KartikMehta-1/AMR-development/CAD/4 Boughtouts/screw-shield-v2-for-arduino-uno/Arduino UNO R3 screw shield v2/Arduino UNO R3 screw shield v2  Left.jpg

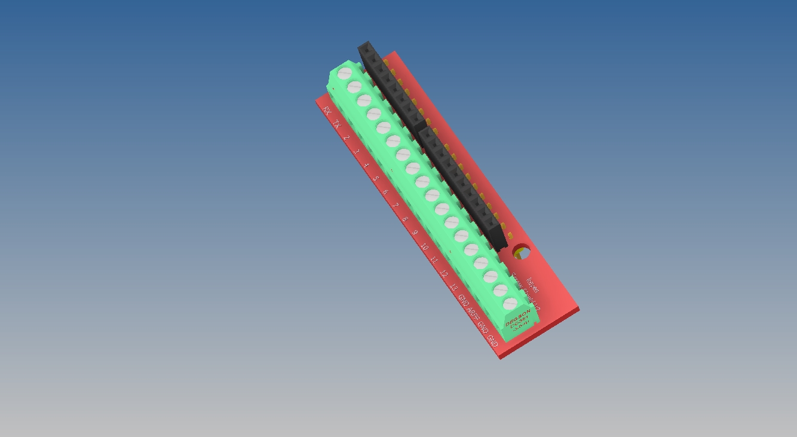
CAD/4 Boughtouts/screw-shield-v2-for-arduino-uno/Arduino UNO R3 screw shield v2/Arduino UNO R3 screw shield v2 Left.jpg
