KartikMehta-1/AMR-development/Folder_Structure.md

AMR-development/
- .vscode/                    # Local editor settings
- CAD/                        # Mechanical CAD assemblies, parts, exports
  - 1 Assembly/
  - 2 Sub-assembly/
  - 3 Parts/
  - 4 Boughtouts/
  - 5 3D_print/
  - 6 Exports/
  - OldVersions/
- PCB/                        # PCB design files
  - AMR_pcb/
- STM/                        # STM32CubeIDE firmware and bench projects
  - STM_Firmware_/            # Older STM firmware project
  - STM_Firmware_AMR_v2/      # Main AMR STM32 firmware project
  - STM_MotorCheck/           # Motor bench-test project
  - STM_SRM_CurrentBench/     # Current-sensor bench project
- Workspace/                  # Logged tuning, analysis artifacts, and ad-hoc experiments
  - motor_PID_tuning/
  - python_scripts/           # Local analysis and plotting scripts
  - sensor_test/              # Sensor experiments and wiring notes
- docker/                     # Docker setup for ROS/dev environments
  - foxy/
- docs/                       # Project documentation and trackers
  - README.md
  - architecture/             # Agent-owned architecture entry points and detailed diagrams
  - agentic/                  # Agent contracts, ownership, runbooks, permissions, roadmap
  - hardware/                 # Physical hardware block diagrams, wiring, component specs
  - perception/               # RGB-D, VLA, dataset, and proposal/execution boundaries
  - safety/                   # Safety baseline, supervisor steps, recovery procedures
  - project/                  # Project tracker and planning docs
- mcp_servers/                # MCP servers for agent/tool integration
  - amr_state_inspection/     # Read-only robot state/health inspection
  - amr_mission_control/      # Guarded named-place mission control
  - amr_robot_launch/         # Guarded standard runtime launch
  - amr_voice_interface/      # Transcript intent routing
  - amr_conversation/         # Conversation turn planner
  - amr_speaker/              # Spoken feedback publisher
  - amr_perception_inspection/ # Read-only RGB-D scene/object/grasp proposal MCP
- agent_harness/              # Source-only agent behavior and acceptance harness
- ros_ws/                     # ROS 2 workspace
  - src/
    - amr_clients/
    - amr_description/
    - amr_hardware/
    - amr_missions/
    - amr_missions_msgs/
    - amr_perception/
    - amr_safety/
    - amr_semantic_nav/
    - amr_voice/
    - my_pkg/
  - build/                    # Colcon build output
  - install/                  # Colcon install output
  - log/                      # Colcon logs
  - maps/                     # Saved SLAM maps
- .gitignore
- AMR_project.md.backup
- Folder_Structure.md
- docker-compose.slam.yml
- temp.txt
- useful commands.md
