KartikMehta-1/AMR-development/AMR_project.md

# Kartik's AMR Project Tracker (18 Weeks)
**File:** `AMR_project.md`  
**Owner:** Kartik Mehta  
**Last Updated:** 2025-11-04  
**Scope:** STM32 low-level control, Jetson Nano high-level compute, motor drivers, current sensing (ACS758 x2), FreeRTOS, ROS2 + Gazebo, SLAM & Navigation.

---

## Status Summary
- Overall: On track with tuning in progress
- Progress: 7/18 weeks complete (~39%)
- Recent: Single-motor bring-up on Cytron at ~10% duty verified (PA8 PWM, PB4 DIR)
- Current Focus (Week 9): Encoder integration; both encoders online, add external pull-ups
- Next Focus (Weeks 10-12): Current telemetry + calibration, single-loop PID, cascaded control + comparison
- Timeline: Flexible (plan extended beyond 18 weeks). Prioritize firmware + ROS; custom PCB is low priority/optional.
  - Firmware Branching: v1 (bench, L298N + small encoder) is now frozen; all new work proceeds in v2 (Cytron MDD20A + post-gearbox encoder).

Legend: Done, In Progress, Partial, Planned, Blocked

---

## Week-by-Week Plan (canonical view)
| Week | Focus | Status | Key Tasks / Notes |
|---:|---|:---:|---|
| 1 | Safety & Tools Setup | Done | E-stop path reviewed; fused power path; STM32 toolchain + Blink verified. |
| 2 | UART + Debug (ADC skipped) | Done | Serial comms working; pin mapping documented; ADC intentionally skipped at this stage. |
| 3 | PWM + Motor Driver (L298N) | Partial | PWM verified, motor spins; ramp duty + E-stop integration deferred to PID stage. |
| 4 | Encoder Hookup & Counting | Done | Encoder integrated; direction & count validated; stable RPM reading. |
| 5 | RPM Calculation & Telemetry | Done | RPM derived from ticks; serial telemetry logging functional. |
| 6 | PID-Based Motor Control (Implementation) | Done | PID loop on STM32; ramp limiter; anti-windup; clean control loop. |
| 7 | Firmware v2: Scaffold + Pin Map + Current | In Progress | New project `STM_Firmware_AMR_v2`; TIM1 @ 20 kHz (CH1=PA8 left, CH2=PA9 right); Encoders: TIM3 (PA6/PA7 left), TIM2 (PA0/PA1 right); ADC1 with DMA: PB0=IN8 (left current), PC1=IN11 (right current); UART banner. |
| 8 | Firmware v2: Dual-Motor Duty Bring-Up | Done | M2 PWM/DIR (PA9/PB5) wired; duty sweep validated both channels; E-stop cut and GND common confirmed. |
| 9 | Firmware v2: Encoder Integration | Done | Encoders online both wheels (TIM3 PA6/PA7 left, TIM2 PA0/PA1 right); UART RPM confirmed; direction corrected; pull-ups to be added. |
| 10 | Firmware v2: Current Telemetry + Calibration | Planned | ADC1 scan IN8 (PB0 left) and IN11 (PC1 right); zero-offset + scaling; UART current stream at 50-100 Hz. |
| 11 | Firmware v2: Control (Single-Loop PID) | Planned | Closed-loop speed PI/PID on one/both wheels; anti-windup + ramp; baseline plots and metrics. |
| 12 | Firmware v2: Cascaded Control + Comparison | Planned | Inner current PI + outer speed PID; add i_* and w_* telemetry; compare vs single-loop with plots/metrics. |
| 13 | Firmware v2: Differential Drive | Planned | Map (v, I%) + (left, right); saturation and ramp coordination; basic tests. |
| 14 | Firmware v2: Proximity Sensors (HW) | Planned | Select 8x proximity sensors (TBD interface: GPIO/ADC/I2C); wiring, pull-ups, protection; update pin map; bench power budget. |
| 15 | Firmware v2: Proximity Drivers | Planned | Implement drivers and sampling scheduler for 8 sensors; debouncing/filtering; fault detection; add to telemetry. |
| 16 | Firmware v2: micro-ROS Bring-up | Planned | Integrate micro-ROS on STM32; define msgs; publish wheel_state/obstacles; subscribe wheel_cmd/estop; stable transport to agent. |
| 17 | Jetson ROS2 + Agent + Docker | Planned | Set up micro-ROS agent and ROS2 workspace on Jetson; dockerize dev/runtime; compose services; basic end-to-end echo tests. |
| 18 | ROS2 Architecture & Topics | Planned | Define node graph, topics, QoS, message types; draft test plans (unit/integration/sim); document interfaces for motion, safety, sensors. |
| 19 | URDF Modeling | Planned | Base chassis + wheels URDF; inertia estimates; visual/collision meshes; joint limits; TF tree. |
| 20 | Gazebo Simulation | Planned | Diff-drive plugin tuning; sensor plugins for LiDAR/depth/proximity; sim-worlds; baseline nav in sim. |
| 21 | ROS2 Node Implementation | Planned | Implement nodes per architecture (odometry, safety_monitor, sensor_fusion, teleop); CI for lint/build/test. |
| 22 | System Tests & CI | Planned | Sim integration tests; logging/bagging; performance dashboards; dockerized CI pipeline. |
| 23 | Field Bring-up | Planned | On-robot tests: drive, stop, obstacle detection; telemetry review; safety validation. |
| 24 | Polish & Docs | Planned | User/developer docs; scripts; troubleshooting; backlog triage. |

> Canonical view rule: If the table and task board ever conflict, the table wins for schedule; task board wins for day-to-day details.

---

## Detailed Tasks
The granular task board has been moved to docs/AMR_firmware_tasks.md to keep this file focused on high-level goals and the weekly schedule.

Status: See the Status Summary above and task-by-task statuses in docs/AMR_firmware_tasks.md.

---

## Definitions of Done (per milestone)
- Dual-motor duty: Both channels drive 0-20% with correct direction and safe stop via E-stop
- Encoders: Stable RPM both wheels; correct direction; noise filtered
- Current telemetry: Calibrated A/LSB; filtered stream at 50-100 Hz
- Control (single-loop): <=10% overshoot, low SSE on step/ramp; plots archived
- Cascaded control: Inner current loop stable; outer speed loop SSE <= 5%, overshoot <= 10%; comparison plots and gains documented
- FreeRTOS (W13): Tasks meet deadlines under load; CPU < 70%; no missed watchdog
- Validation (W16): E-stop latency <= 50 ms; current-limit interaction stable under step loads
- SLAM demo (W18): Successful nav in mapped area for ~15 min without collision or watchdog resets

---

## Metrics
- Control quality: SSE, overshoot, rise/settling time (from logs)
- Reliability: E-stop latency, fault counts/day, watchdog resets
- Throughput: Control loop jitter, CPU utilization (RTOS)
- Power: Peak & average current draw, brownouts
- Delivery: Lead time per milestone, tasks closed/week

---

## Repo Structure (suggested)
```
/docs
  AMR_project.md               # this file
  pid.md                       # tuning notes & plots
  safety.md                    # E-stop, current limits, fault codes
  wiring/acs758_wiring.pdf     # diagrams & photos
/src
  motor.c, encoder.c, pid.c, telemetry.c, safety.c, ...
/scripts
  log_decode.py, plot_step.py

---

## ROS2 Architecture (Draft)
- Nodes
  - `mc_interface` (micro-ROS on STM32): subscribes `/amr/wheel_cmd`, `/amr/estop`; publishes `/amr/wheel_state`, `/amr/obstacles`
  - `odometry`: subscribes `/amr/wheel_state`; publishes `/odom`, `/tf`
  - `safety_monitor`: subscribes `/amr/obstacles`, `/amr/estop`; publishes `/amr/safety_state`
  - `sensor_fusion`: fuses proximity/LiDAR/depth; publishes `/amr/obstacles`
  - `teleop` or higher-level commander: publishes `/cmd_vel` or `/amr/wheel_cmd`
  - `sim_bridge`: interfaces Gazebo topics with AMR topics
- Topics (proposed)
  - `/amr/wheel_cmd` (geometry_msgs/Twist or custom wheel velocities)
  - `/amr/wheel_state` (sensor_msgs/JointState)
  - `/amr/obstacles` (sensor_msgs/Range[] or custom)
  - `/amr/estop` (std_msgs/Bool), `/amr/safety_state` (std_msgs/UInt32)
  - `/odom` (nav_msgs/Odometry), `/tf`, `/tf_static`

---

## Docker Development Environment (Draft)
- Images/containers
  - Firmware build: arm-none-eabi toolchain, micro-ROS build tools
  - Jetson runtime: ROS2 base, micro-ROS agent, AMR nodes
  - Desktop dev: ROS2, Gazebo, build/test tools
- Compose
  - `agent`, `ros-core`, `sim`, `tools` services; volumes for logs and bags
- CI integration
  - Build, lint, test stages; multi-arch where needed
```

---

## Issues & Backlog (triage labels)
- P0 block progress today
- P1 needed for this milestone
- P2 nice to have / future

```text
[P1] Plot script: generate step response graphs from CSV (rise time, overshoot, SSE)
[P1] Telemetry v2: add fault flags + setpoint
[P1] Mechanical CAD: full AMR layout (chassis, mounts, sensor brackets, harness routing); deliver STEP/DXF + assembly guide
[P2] CLI: live Bode-like sweep tool using chirp
```

---

## Risks & Mitigations
- Current spikes trip supply + Add soft-start/ramp; validate with current logs.
- Encoder noise at high RPM + Add digital filter/debounce; verify with scope.
- Thermal on motor driver + Heatsink & airflow in enclosure; current derating logic.
- RTOS timing regressions + Watchdog + scheduler tests; CI to replay step tests on logs.

---

## Decision Log (append entries)
```
YYYY-MM-DD - Switched to Cytron MD30C
Context: L298N thermal + dropout issues
Options: L298N, MD10C, MD30C
Decision: MD30C for current headroom
Consequences: Redesign mount; add airflow
```

---

## Change Log
- 2025-10-28: Marked Week 2 ADC as skipped; set Week 8 next focus to E-stop feature; added Final Drivetrain Migration step; noted flexible timeline and PCB as optional.
