KartikMehta-1/AMR-development/docs/ros_stack_diagrams.md

# ROS Stack Diagrams

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

## Source of truth

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

## Important note about the motion-command path

Older repo notes mention the STM32 subscribing directly to `/cmd_vel`.

The current real-hardware path in code is different:

- `teleop_twist_keyboard` and Nav2 publish to `/diff_drive_controller/cmd_vel_unstamped`
- `diff_drive_controller` converts base motion into left/right wheel velocity commands
- the `amr_hardware` `ros2_control` plugin publishes:
  - `/amr/wheel_cmd_left`
  - `/amr/wheel_cmd_right`
- the STM32 firmware subscribes to those two wheel-command topics

That is the path shown below.

## 1. Full Real-Hardware ROS Graph

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

```mermaid
flowchart LR
  subgraph Laptop_or_DevPC[Dev PC / Laptop]
    RVIZ[rviz2]
    TELEOP[teleop_twist_keyboard]
    SLAM[slam_toolbox]
    MAP_SERVER[map_server]
    AMCL[amcl]
    MISSIONS[mission_server]
    BT[bt_navigator]
    PLANNER[planner_server]
    CONTROLLER[controller_server]
    RECOVERIES[recoveries_server]
    GCM[global_costmap]
    LCM[local_costmap]
  end

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

  TELEOP -->|cmd_vel topic| DDC
  CONTROLLER -->|cmd_vel topic| DDC

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

  MCU -->|wheel state| AGENT
  MCU -->|safety and diagnostics| AGENT
  AGENT --> HW

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

  SLAM -->|map and map updates| RVIZ
  MAP_SERVER -->|map topic| RVIZ
  MAP_SERVER -->|map topic| AMCL
  MAP_SERVER -->|map topic| GCM
  AMCL -->|map tf| RVIZ
  RVIZ -->|initial pose| AMCL
  RVIZ -->|goal action| BT
  MISSIONS -->|navigate_to_pose action goals| BT
  BT --> PLANNER
  BT --> CONTROLLER
  BT --> RECOVERIES
  GCM -->|global map and obstacles| PLANNER
  LCM -->|local obstacles around robot| CONTROLLER
  RECOVERIES -->|recovery cmd_vel| DDC
```

## 2. Base Motion And Odometry Path

This is the control path you use first when teleoperating the AMR from the laptop.

```mermaid
flowchart TB
  subgraph Inputs[Command sources]
    TELEOP[teleop_twist_keyboard]
    NAV2[Nav2 controller and recoveries]
  end

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

  TELEOP -->|cmd_vel topic| DDC
  NAV2 -->|cmd_vel topic| DDC

  DDC -->|left and right wheel commands| HW
  HW -->|wheel command topics| AGENT
  AGENT --> MCU
  MCU --> MOTOR

  MOTOR -->|encoder-based wheel state| WSTATE
  WSTATE --> AGENT
  AGENT --> HW

  HW -->|wheel position and velocity| DDC
  HW -->|wheel position and velocity| JSB
  JSB -->|joint_states| RSP

  DDC -->|publishes| ODOM
  DDC -->|publishes| ODOMTF
  RSP -->|publishes| BODYTF
```

### What each piece does

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

## 3. TF Ownership

The most important thing to understand is who owns each transform.

```mermaid
flowchart TD
  MAP[map]
  ODOM[odom]
  BASE_FOOTPRINT[base_footprint]
  BASE_LINK[base_link]
  LIDAR_LINK[lidar_link]

  MAP -->|published by slam or amcl| ODOM
  ODOM -->|published by diff_drive_controller| BASE_FOOTPRINT
  BASE_FOOTPRINT -->|published by robot_state_publisher from URDF| BASE_LINK
  BASE_LINK -->|published by robot_state_publisher from URDF| LIDAR_LINK
```

### Consequence

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

This is why `slam_toolbox` and `AMCL` must not run together.

## 4. Mapping Mode With SLAM Toolbox

Use this mode when creating a map.

```mermaid
flowchart LR
  LIDAR[ydlidar_ros2_driver_node]
  DDC[diff_drive_controller]
  RSP[robot_state_publisher]
  SLAM[slam_toolbox]
  RVIZ[rviz2]
  SAVE[map_saver_cli]
  FILES[saved map files]

  LIDAR -->|scan topic| SLAM
  DDC -->|odom and tf| SLAM
  RSP -->|robot tf| SLAM

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

  SLAM -->|map topic| SAVE
  SAVE --> FILES
```

### SLAM Toolbox consumes

- `/scan`
- TF chain from `map` work backwards through:
  - `odom -> base_footprint`
  - `base_footprint -> ... -> lidar_link`

### SLAM Toolbox produces

- `/map`
- `/map_updates`
- `map -> odom` TF

### Mapping data flow

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

## 5. Localization And Navigation Mode

Use this mode after a map already exists on disk.

```mermaid
flowchart LR
  MAP_FILE[saved map on disk]
  MAP_SERVER[map_server]
  RVIZ[rviz2]
  AMCL[amcl]
    MISSIONS[mission_server]
  LIDAR[ydlidar_ros2_driver_node]
  DDC[diff_drive_controller]
  RSP[robot_state_publisher]
  BT[bt_navigator]
  PLANNER[planner_server]
  CONTROLLER[controller_server]
  GCM[global_costmap]
  LCM[local_costmap]
  DDCMD[cmd_vel topic to diff drive]

  MAP_FILE --> MAP_SERVER
  MAP_SERVER -->|map topic| RVIZ
  MAP_SERVER -->|map topic| AMCL
  MAP_SERVER -->|map topic| GCM

  RVIZ -->|initial pose| AMCL
  RVIZ -->|goal action| BT
  MISSIONS -->|navigate_to_pose action goals| BT

  LIDAR -->|scan topic| AMCL
  LIDAR -->|scan topic| GCM
  LIDAR -->|scan topic| LCM

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

  AMCL -->|map tf| RVIZ
  AMCL -->|map tf| BT
  AMCL -->|map tf| PLANNER
  AMCL -->|map tf| CONTROLLER

  BT -->|request path| PLANNER
  GCM -->|global map and obstacles| PLANNER
  BT -->|follow path request| CONTROLLER
  LCM -->|local obstacles| CONTROLLER
  CONTROLLER --> DDCMD
```

### What each Nav2 piece does

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

## 6. Mission Layer Over Nav2

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

```mermaid
flowchart LR
  YAML[places.yaml]
  CLI[mission_cli]
  SERVER[mission_server]
  STATUS[MissionStatus topic]
  STATE[GetMissionState service]
  CMD[command topic]
  NAV2[bt_navigator navigate_to_pose action]
  ROBOT[base navigation stack]

  YAML --> CLI
  YAML --> SERVER
  CLI -->|go_to or patrol services| SERVER
  CLI -->|state query| STATE
  STATE --> SERVER
  CMD --> SERVER
  SERVER -->|MissionStatus| STATUS
  SERVER -->|named goals and routes| NAV2
  NAV2 --> ROBOT
```

### Current mission-layer responsibilities

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

### Current named places

- `home`
- `door`
- `kitchen`
- `hall`

### Near-term direction

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

## 7. Nav2 Topic Remapping In This Repo

Nav2 normally expects:

- `/cmd_vel`
- `/odom`

This repo remaps them in launch so Nav2 works with the real base:

- `/cmd_vel` -> `/diff_drive_controller/cmd_vel_unstamped`
- `/odom` -> `/diff_drive_controller/odom`

That remap is done in:

- `ros_ws/src/amr_description/launch/bringup_nav2.launch.py`
- `ros_ws/src/amr_description/launch/nav2_navigation.launch.py`

## 8. Exhaustive Topic Ownership

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

### 8.1 Core base-control topics

| Topic | Produced by | Consumed by | Contents |
| --- | --- | --- | --- |
| `/diff_drive_controller/cmd_vel_unstamped` | `teleop_twist_keyboard`, Nav2 controller, Nav2 recoveries | `diff_drive_controller` | `geometry_msgs/Twist` with commanded base linear and angular velocity, mainly `linear.x` and `angular.z` for this differential-drive base |
| `/amr/wheel_cmd_left` | `amr_hardware` | STM32 firmware via `micro_ros_agent` | `std_msgs/Float32` containing commanded left wheel angular velocity in rad/s |
| `/amr/wheel_cmd_right` | `amr_hardware` | STM32 firmware via `micro_ros_agent` | `std_msgs/Float32` containing commanded right wheel angular velocity in rad/s |
| `/amr/wheel_state` | STM32 firmware via `micro_ros_agent` | `amr_hardware` | `sensor_msgs/JointState` with wheel joint names plus wheel position and velocity arrays for left and right wheels |
| `/joint_states` | `joint_state_broadcaster` | `robot_state_publisher`, RViz | `sensor_msgs/JointState` representing the joint-state view exposed by `ros2_control` for the robot model |
| `/diff_drive_controller/odom` | `diff_drive_controller` | `slam_toolbox`, `amcl`, Nav2, RViz | `nav_msgs/Odometry` with robot pose and twist in the odometry frame, derived from wheel feedback |

### 8.2 Safety, enable, and bench-diagnostics topics

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

| Topic | Produced by | Consumed by | Contents |
| --- | --- | --- | --- |
| `/amr/enable` | operator or helper topic publisher | STM32 firmware | `std_msgs/Bool` command indicating whether motion should be enabled |
| `/amr/estop` | operator or helper topic publisher | STM32 firmware | `std_msgs/Bool` command indicating software e-stop state |
| `/amr/clear_fault` | operator or helper topic publisher | STM32 firmware | `std_msgs/Empty` pulse used to request fault reset |
| `/amr/fault_mask` | STM32 firmware via `micro_ros_agent` | operator tools, diagnostics | `std_msgs/Int32` bitmask encoding active or latched faults such as overcurrent, stall, or encoder timeout |
| `/amr/safety_state` | STM32 firmware via `micro_ros_agent` | operator tools, diagnostics | `std_msgs/UInt32` state code summarizing enable, idle, fault, or e-stop related controller state |
| `/amr/duty_cmd_left` | STM32 firmware via `micro_ros_agent` | operator tools, diagnostics | `std_msgs/Float32` reporting applied left motor duty percentage |
| `/amr/duty_cmd_right` | STM32 firmware via `micro_ros_agent` | operator tools, diagnostics | `std_msgs/Float32` reporting applied right motor duty percentage |
| `/amr/current_left_ma` | STM32 firmware via `micro_ros_agent` | operator tools, diagnostics | `std_msgs/Int32` left motor current estimate in milliamps |
| `/amr/current_right_ma` | STM32 firmware via `micro_ros_agent` | operator tools, diagnostics | `std_msgs/Int32` right motor current estimate in milliamps |
| `/amr/current_left_adc` | STM32 firmware via `micro_ros_agent` | operator tools, diagnostics | `std_msgs/UInt32` raw ADC sample for the left current sensor |
| `/amr/current_right_adc` | STM32 firmware via `micro_ros_agent` | operator tools, diagnostics | `std_msgs/UInt32` raw ADC sample for the right current sensor |
| `/amr/current_left_zero` | STM32 firmware via `micro_ros_agent` | operator tools, diagnostics | `std_msgs/UInt32` stored or estimated zero-offset value for the left current sensor |
| `/amr/current_right_zero` | STM32 firmware via `micro_ros_agent` | operator tools, diagnostics | `std_msgs/UInt32` stored or estimated zero-offset value for the right current sensor |

### 8.3 Perception and mapping topics

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

### 8.4 RViz interaction topics

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

### 8.5 Navigation-support topics explicitly configured in this repo

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

### 8.6 Transform topics

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

### 8.7 Named transforms carried on `/tf` or `/tf_static`

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

### 8.8 Optional topics not expanded in detail here

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

## 9. What `/tf`, `/tf_static`, `map -> odom`, and `odom -> base_footprint` Mean

### `/tf`

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

In this repo, the most important transforms on `/tf` are:

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

### `/tf_static`

`/tf_static` carries transforms that do not change during operation.

In this repo, `robot_state_publisher` uses the URDF to publish fixed geometry such as:

- `base_footprint -> base_link`
- `base_link -> lidar_link`
- `base_link -> camera_link`
- other rigid chassis and sensor-link relationships

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

### `map -> odom`

`map -> odom` is the global correction transform.

Why it exists:

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

Ownership in this repo:

- during mapping, `slam_toolbox` publishes `map -> odom`
- during localization/navigation, `amcl` publishes `map -> odom`

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

### `odom -> base_footprint`

`odom -> base_footprint` is the local motion estimate of the robot from wheel odometry.

In this repo:

- `diff_drive_controller` computes it from wheel feedback coming from `/amr/wheel_state`
- it publishes both the transform and the odometry message on `/diff_drive_controller/odom`

Properties of this transform:

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

### Why there are two levels instead of one

The frame chain is:

- `map -> odom -> base_footprint -> base_link -> lidar_link`

Each part has a different job:

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

This split is very important because Nav2 and SLAM want both:

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

### Practical mental model

If the robot moves 1 meter forward:

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

## 9. Where Topics Are Generated In Practice

### Jetson-side bring-up

Started by `hardware.launch.py`:

- `micro_ros_agent`
- YDLidar driver
- `robot_state_publisher`
- `ros2_control_node`
- `joint_state_broadcaster`
- `diff_drive_controller`

### STM32-side micro-ROS topics

Current firmware publishes:

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

Current firmware subscribes to:

- `/amr/wheel_cmd_left`
- `/amr/wheel_cmd_right`
- `/amr/enable`
- `/amr/estop`
- `/amr/clear_fault`

## 10. Mental Model

The stack is easiest to understand in layers:

1. Sensors and MCU produce raw robot state:
   - `/scan`
   - `/amr/wheel_state`
   - safety and current topics
2. `ros2_control` turns wheel state into robot motion interfaces:
   - accepts base velocity commands
   - computes odometry
   - publishes `/diff_drive_controller/odom`
3. TF makes the robot spatially coherent:
   - `odom -> base_footprint` from diff-drive
   - body and sensor frames from `robot_state_publisher`
4. Mapping or localization adds global pose:
   - `slam_toolbox` during mapping
   - `amcl` during localization
5. Nav2 closes the loop:
   - plan on `/map`
   - avoid obstacles from `/scan`
   - output base motion back into `diff_drive_controller`

## 11. One-line summary

For this repo, the practical closed loop is:

`teleop or Nav2 -> /diff_drive_controller/cmd_vel_unstamped -> diff_drive_controller -> amr_hardware -> /amr/wheel_cmd_left/right -> STM32 -> /amr/wheel_state -> amr_hardware -> diff_drive_controller -> /diff_drive_controller/odom -> SLAM or AMCL -> map-aware RViz/Nav2`
