KartikMehta-1/AMR-development/docs/project/AMR_project.md

# Kartik's AMR Project Tracker (49 Weeks)
**File:** `AMR_project.md`  
**Owner:** Kartik Mehta  
**Last Updated:** 2026-07-07
**Scope:** STM32 low-level control, Jetson Nano/Orin NX high-level compute, motor drivers, current sensing (ACS758 x2), FreeRTOS, ROS2 + Gazebo, SLAM & Navigation; eventual goal is a fully autonomous AMR with one mounted SO-101 manipulator that can pick/place small objects using state-of-the-art VLA/VLM/LLM-based policies.

## Week-by-Week Plan (canonical view)
| Week | Focus | Status | Key Tasks / Notes | Target Date | Achieved Date |
|---:|---|:---:|---|---|---|
| 1 | Safety & Tools Setup | <span style="color: green">Done</span> | E-stop path reviewed; fused power path; STM32 toolchain + Blink verified. | 2025-10-23 | 2025-10-17 |
| 2 | UART + Debug (ADC skipped) | <span style="color: green">Done</span> | Serial comms working; pin mapping documented; ADC intentionally skipped at this stage. | 2025-10-30 | 2025-10-18 |
| 3 | PWM + Motor Driver (L298N) | <span style="color: green">Done</span> | PWM verified, motor spins; ramp duty + e-stop integration completed in v2. | 2025-11-13 | 2025-10-18 |
| 4 | Encoder Hookup & Counting | <span style="color: green">Done</span> | Encoder integrated; direction & count validated; stable RPM reading. | 2025-11-27 | 2025-10-22 |
| 5 | RPM Calculation & Telemetry | <span style="color: green">Done</span> | RPM derived from ticks; serial telemetry logging functional. | 2025-12-04 | 2025-10-22 |
| 6 | PID-Based Motor Control (Implementation) | <span style="color: green">Done</span> | PID loop on STM32; ramp limiter; anti-windup; clean control loop. | 2025-12-11 | 2025-10-23 |
| 7 | Firmware v2: Scaffold + Pin Map + Current | <span style="color: green">Done</span> | New project `STM_Firmware_AMR_v2`; TIM1 @ 20 kHz (CH1=PA8 left, CH2=PA9 right); Encoders: TIM3 (PA6/PA7 left), TIM2 (PA0/PA1 right); ADC1 with DMA: PB0=IN8 (left current), PC1=IN11 (right current); UART banner. | 2025-12-18 | 2025-10-30 |
| 8 | Firmware v2: Dual-Motor Duty Bring-Up | <span style="color: green">Done</span> | M2 PWM/DIR (PA9/PB5) wired; duty sweep validated both channels; E-stop cut and GND common confirmed. | 2025-12-25 | 2025-11-03 |
| 9 | Firmware v2: Encoder Integration | <span style="color: green">Done</span> | Encoders online both wheels (TIM3 PA6/PA7 left, TIM2 PA0/PA1 right); UART RPM confirmed; direction corrected; TODO: add external 3.3 V pull-ups or software invert flag. | 2026-01-01 | 2025-11-16 |
| 10 | Firmware v2: Current Telemetry + Calibration | <span style="color: green">Done</span> | ADC1 scan IN8/IN11; zero-offset + scaling; filtered current stream; current reserved for logging/faults (not in loop). | 2026-01-08 | 2025-11-25 |
| 11 | Firmware v2: Control (Single-Loop PID) | <span style="color: green">Done</span> | TIM4 @100 Hz control loop; cmd_vel staleness timeout; speed PI + duty ramp; fault monitor (overcurrent/stall/encoder timeout/ADC stuck); hardware e-stop GPIO input + debounce wired into ControlState (latched fault); step/ramp plots captured during bring-up; gains/feedforward tuned. | 2026-01-15 | 2025-12-07 |
| 12 | Firmware v2: Differential Drive | <span style="color: green">Done</span> | Map (v, I%) -> wheel RPM; ramp/coordination added; saturation with curvature-preserving scaling; basic 5 s test sequence running. | 2026-01-29 | 2025-12-09 |
| 13 | Firmware v2: micro-ROS Bring-up | <span style="color: green">Done</span> | USART2 custom transport; `/amr_stm/wheel_cmd_left` and `/amr_stm/wheel_cmd_right` subs; `/amr_stm/wheel_state`, duty, current, ADC/zero, fault, safety, and `/amr_stm/ros_diag` pubs; `/amr_stm/enable`, `/amr_stm/estop`, `/amr_stm/clear_fault` wired; fault clear verified; fault mask documented; legacy UART telemetry disabled. | 2026-02-19 | 2026-01-04 |
| 14 | Dev PC Env & Tooling | <span style="color: green">Done</span> | Dockerized Foxy drivers + devpc image built (micro-ROS agent + YDLidar + RViz2/Gazebo); RViz2 config for `/scan` (best_effort QoS) working; ROS2 workspace build verified; Docker buildx workflow and Jetson builds validated; passwordless SSH to Jetson set up. | 2026-03-05 | 2026-01-18 |
| 15 | Jetson Nano ROS2/JetPack | <span style="color: green">Done</span> | Jetson container build complete; micro-ROS agent + teleop + YDLidar running; `/amr_stm/*` and `/scan` verified; depth camera running with `/camera/*` and `/points` validated; RViz2 visualization from dev PC confirmed; DDS interface bound to Wi-Fi; depth stream stabilized with lower profiles. | 2026-03-12 | 2026-01-24 |
| 16 | Wireless PC<->Nano | <span style="color: green">Done</span> | Wi-Fi adapter online and Jetson reachable over home network; passwordless SSH working; DHCP reservation set; ping avg ~10 ms and iperf ~15 Mbps verified; NTP sync active. Optional VPN (WireGuard/Tailscale) remains a nice-to-have. | 2026-03-19 | 2026-01-20 |
| 17 | URDF Modeling (Base AMR) | <span style="color: green">Done</span> | Base URDF/Xacro created with chassis, wheels, and sensor frames (LiDAR + depth cam); LiDAR/camera split into `lidar.xacro` + `camera.xacro`; D455 camera plugin added; base_footprint restored; wheel offsets corrected; caster clearance tuned; Gazebo launch defaults to `obstacles.world`; ros2_control config added; URDF validated in sim. | 2026-03-26 | 2026-02-11 |
| 18 | Navigation & Mapping Bring-up | <span style="color: green">Done</span> | Mapping: slam_toolbox (2D LiDAR) running on real LiDAR; map save/load + posegraph serialization verified. Localization: AMCL on saved map working. Navigation: Nav2 bring-up working with RViz goals; costmaps wired to ros2_control topics. EKF fusion + odom improvements are tracked separately. | 2026-04-02 | 2026-02-11 |
| 19 | Mechanical Integration: SO-101 Arms | <span style="color: green">Done</span> | Assembled SO-101 hardware and verified reach/clearance. Current AMR direction is one mounted SO-101 arm with power budget/fusing, harness routing, and strain relief tracked for that single-arm configuration. | 2026-05-07 | 2026-02-08 |
| 20 | Mechanical Assembly + Enclosure | <span style="color: green">Done</span> | Main AMR mechanical assembly completed, including SO-101 integration provisions. Follow-on hardware refinements now move into manipulation/perception work: wrist camera mount on SO-101, AMR depth sensor repositioning for better gripping, and any final cable routing/strain relief cleanup. | 2026-02-26 | 2026-04-17 |
| 21 | Mission Runtime & Sequencing (v1) | <span style="color: green">Done</span> | Promoted `amr_missions` from CLI-only use into a persistent `mission_server` with typed `MissionStatus`, a `/amr_missions/state` service, topic-command support, request validation, retries/timeouts/return-home handling, and direct integration into the one-shot navigation tmux workflow. | 2026-04-16 | 2026-04-28 |
| 22 | Firmware v2: Cascaded Control + Comparison | <span style="color: green">Done</span> | Cascaded-current-control investigation is complete for this AMR phase. Higher-accuracy current-sensor integration was brought up for protection/diagnostics, ROS current + ADC/zero topics were added, current polarity/sign were corrected, and the OC threshold was returned to `1500 mA`. Decision: keep production motion on the validated single-loop speed controller for now; use current sensing for protection/logging and revisit true cascaded current control only if traction or torque-control requirements justify it. | 2026-01-22 | 2026-05-03 |
| 23 | Safety Supervision & Health Monitoring | <span style="color: green">Done</span> | Implemented and validated the first production safety-supervision layer: STM comm/fault monitoring, safety intervention state, mission/Nav2 cancel path, guarded zero-velocity + STM disable flow, supervisor reset service, and repeatable operator recovery helper. Real motor-driver power-cut tests confirmed safe stop, blocked reset while STM faults were active, fault clear after power restore, manual STM re-enable, and successful mission continuation. Follow-up safety expansions can be tracked separately. | 2026-04-23 | 2026-05-03 |
| 24 | AMR Rewire + Known-Good Bring-Up | <span style="color: green">Done</span> | Rewired and brought the AMR back up on the Nano/Foxy baseline. Validated STM micro-ROS, `/amr_stm/*`, LiDAR `/scan`, wheel state/odom path, map/AMCL readiness, Nav2 lifecycle, mission server, safety supervisor, MCP launch path, and supervised named-place navigation. Defer STM-carrier proximity sensors, STM I2C IMU, and INA226 wiring until a custom carrier/control board; continue reliability cleanup through acceptance testing. | 2026-05-14 | 2026-05-23 |
| 25 | Agentic AMR Control Revalidation On Nano | <span style="color: green">Done</span> | Revalidated the guarded agentic control path on the existing Nano/Foxy baseline: robot-launch MCP restarted Jetson/dev-PC runtime, mission-control MCP readiness passed, and supervised `go_to hall` completed successfully through `/amr_missions/go_to` with STM fault mask clear. Live motion remains supervised and must use mission/safety/Nav2 paths, never raw `/cmd_vel` or direct wheel commands. | 2026-05-21 | 2026-05-23 |
| 26 | NUC Dev-PC Migration Baseline | <span style="color: green">Done</span> | NUC is validated as the live dev-PC replacement while Jetson Nano remains the hardware runtime: Docker/image/build checks passed, split NUC+Jetson bring-up works, the one-command navigation launcher works on tmux 3.4, and supervised mission-control runs succeeded for `hall`, `kitchen`, and `home` with STM fault mask clear. Extended repeatability/acceptance loops are intentionally deferred to the later hardware acceptance/reliability track. | 2026-05-30 | 2026-06-01 |
| 27 | Voice + Operator Command MVP | <span style="color: goldenrod">In Progress</span> | MCP-oriented voice/operator path is active: `hey jarvis` wake gating, Vosk command ASR and Faster Whisper push-to-talk support, Piper TTS through speaker MCP, conversation MCP planning, Qwen-backed local intent routing, pending confirmation handling, and read-only state-inspection tool execution for status/diagnostics. Regular Week-27 voice/operator work resumes after the immediate Orin runtime bring-up tasks. Motion remains gated through mission-control MCP readiness and explicit supervised confirmation. | 2026-04-30 | TBD |
| 28 | Manipulation Perception + Calibration | <span style="color: goldenrod">In Progress</span> | Use AMR-mounted depth camera for broad scene/object discovery and wrist camera for close-range grasp refinement. Low-bandwidth Orin-to-NUC preview topics are active for D455 color/depth and SO-101 wrist camera; raw/high-resolution streams should stay local to Orin for autonomy/training unless explicitly needed. Complete hand-eye calibration, base-to-arm extrinsics, camera-to-tool frames, AprilTag checks, RGB-D logging, and stale-frame rejection before grasp execution. | 2026-07-09 | TBD |
| 29 | Orin NX AMR Runtime Migration | <span style="color: goldenrod">In Progress</span> | Pulled forward as the pre-Week-27 focus while keeping NUC+Nano/Foxy as the validated fallback. Orin Docker profile created under `docker/orin`; image `amr/ros2-humble-orin:arm64` builds on Orin with ROS 2 Humble, Nav2, ros2_control, micro-ROS Agent, YDLidar driver, RealSense ROS driver, librealsense `2.57.7` using RSUSB, MoveIt2, `usb_cam`, and the Feetech Python dependency. AMR `ros_ws` builds inside the Orin Humble image after porting `amr_hardware` to Humble `ros2_control` lifecycle callbacks and updating controller-manager spawners; added `ydlidar_orin.yaml` and `orin_hardware.launch.py` for stable by-id paths. Supervised Orin bring-up has run LiDAR `/scan`, STM micro-ROS with `stm_link_ok`, active base controllers, `/amr/joint_states`, NUC RViz/dashboard/teleop over CycloneDDS, D455 low-bandwidth preview topics, and SO-101 wrist webcam preview. A tiny suspended Nav2 CLI goal reached the STM wheel-command path and completed; do not use suspended testing for localization quality because wheel odom moves while the room scan does not. RealSense raw streams should stay local to Orin unless explicitly needed; Wi-Fi viewing should use preview topics. Current checkpoint: keep mounted Orin power/USB/cooling stable, resume supervised floor hardware acceptance, and keep NUC+Nano/Foxy as fallback until Orin passes acceptance. | 2026-06-06 | TBD |
| 30 | Agentic AMR Operation Baseline On Orin | Planned | Port the revalidated agentic baseline to the Orin path after core devices and ROS contracts work there: skills, harnesses, shared ROS clients, state-inspection MCP, guarded mission-control MCP, guarded robot-launch MCP, and voice/conversation/speaker MCPs. Add software-only fixture tests for MCP/clients and harden confirmation-required command tools for `go_to_named_place`, `cancel_mission`, and supervised launch without bypassing mission/safety/Nav2. | 2026-06-13 | TBD |
| 31 | Supervised AMR Hardware Acceptance On Orin | Planned | Use the hardware acceptance harness on the real AMR with Orin as the target runtime once device bring-up is ready: idle, post-motion, localization readiness, mission success, safety recovery, fault decode, and repeated named-place routes. Compare against the known NUC+Nano/Foxy baseline and produce reports before enabling command MCPs for regular operation. | 2026-06-20 | TBD |
| 32 | Local LLM + Monitoring On Orin | Planned | Run a small local orchestration LLM and monitoring stack on Orin for operator dialogue, tool selection, status explanation, system health, and MCP calls. Keep deterministic parser paths for known commands. Enforce skills, permissions, confirmation, and AMR MCP safety gates before any motion-causing tool call. | 2026-06-27 | TBD |
| 33 | IMU + EKF State Estimation & Nav Validation | Planned | STM-carrier IMU wiring is deferred until a custom carrier/control board makes the sensor bus cleaner. If odometry improvement is needed before then, evaluate a Jetson-connected IMU or RealSense IMU as the candidate `/imu` source. Validate topic rate, timestamps, frame ID, orientation/gyro stability, covariance, mounting, and Docker/device access before enabling `robot_localization`. Then fuse wheel odom + IMU, define filtered-odom TF ownership, retest SLAM, AMCL, and Nav2, and include follow-up for motion-only AMCL/localization jumps seen during 2026-05-03 mission validation. | 2026-04-09 | TBD |
| 34 | URDF/MoveIt For Base + SO-101 | <span style="color: goldenrod">In Progress</span> | Single mounted SO-101 scaffold is active: optional AMR Xacro integration, upstream SO101 URDF/STL import, AMR mount wrapper, wrist-camera TF frames, MoveIt2 config, and encoder-captured named poses (`home`, `carry`, `look_from_height`, `ready_to_pick_up`). Next: measure mount offsets, calibrate wrist-camera extrinsics, and calibrate physical joint limits because some recorded safe poses exceed the starter URDF/MoveIt limits. | 2026-06-25 | TBD |
| 35 | Arm Control Bring-Up With MoveIt | <span style="color: goldenrod">In Progress</span> | `amr_so101_driver` now runs on Orin: `/so101_trajectory_bridge` serves `/so101_arm_controller/follow_joint_trajectory`, publishes `/so101/joint_states`, exposes `/so101/free_servos`, and `/amr_joint_state_merger` combines `/amr/joint_states` plus `/so101/joint_states` into `/joint_states`. Supervised MoveIt/teleop has moved wrist roll and then all six available SO-101 joints. Default real execution remains conservative; all-six execution requires explicit supervised bring-up until joint limits, torque margins, and calibration are finished. | 2026-07-02 | TBD |
| 36 | Classical Grasp Pipeline With MoveIt | Planned | Build the first measurable manipulation pipeline: perception -> object/grasp proposal -> MoveIt reachability/collision planning -> guarded execution -> retreat/recovery -> wrist-camera verification. Use this as the baseline before VLA/VLM action policies. | 2026-07-16 | TBD |
| 37 | Base + Arm Integration Demo | Planned | Navigate to a named pickup pose, align to workspace, run classical grasp, place at drop zone, report status, and recover from failed grasp or navigation errors. Maintain consistent base/arm/camera transforms and safety watchdogs. | 2026-07-23 | TBD |
| 38 | External MCP Integrations For Home Autonomy | Planned | Integrate useful non-motion MCPs with the Orin LLM agent: Home Assistant for home state/devices, system monitoring for Orin health, calendar/tasks/reminders, and recipe/meal-planning or shopping-list MCPs. Keep robot motion behind AMR-owned MCP safety tools only. | 2026-07-30 | TBD |
| 39 | AMR Perception MCPs + Household Inspection | Planned | Add custom AMR perception MCP tools for camera inspection workflows such as workspace/fridge/counter scan, object list proposals, stale-frame checks, and operator confirmation. Connect outputs to recipe/task/home MCPs where useful, but do not let perception directly command actuators. | 2026-08-06 | TBD |
| 40 | VLM/VLA Trials For Manipulation | Planned | Profile VLM/VLA models on Orin and/or external GPU fallback. Use them for object discovery, grasp/action proposals, and scene inspection while MoveIt and guarded controllers remain responsible for planning/execution. Compare against the classical grasp baseline. | 2026-08-13 | TBD |
| 41 | Agentic Home Autonomy Demo | Planned | Demonstrate an agentic workflow that combines AMR operation, LLM orchestration, MCP integrations, and guarded manipulation: inspect a scene, suggest an action or meal/task, schedule/remind through calendar/task MCPs, optionally navigate or manipulate through AMR-owned safety-gated MCP tools, and log all decisions/confirmations. | 2026-08-20 | TBD |
| 42 | Productization Scope Freeze | Planned | Freeze one product-like showcase workflow: fixed-place indoor delivery/navigation with human load/unload. Define what is in scope, what is explicitly out of scope, known limitations, demo route, operator workflow, and acceptance criteria. Do not add broad autonomy features unless they improve this workflow. | 2026-08-27 | TBD |
| 43 | Repo Productization Baseline | Planned | Add top-level `README.md`, `Makefile`, `.env.example`, structured docs index, and cleanup plan for generated artifacts/placeholders. Convert `useful commands.md` into documented one-command workflows. Separate dev, ops, diagnostics, calibration, and hardware-acceptance scripts. Add the agentic robotics documentation baseline: agent roles, tool permissions, MCP wrapper plan, repo-local skills plan, and interaction examples. | 2026-09-03 | TBD |
| 44 | Automated Test Foundation | Planned | Add unit tests for `amr_voice` parser, mission config loading, mission request validation, and safety-supervisor health evaluation. Add `colcon test` workflow locally. Start with software-only tests that do not need hardware. Add the first agent harness scenarios for unsafe motion refusal, localization-not-ready denial, safety-fault denial, and manipulator plan-before-execute behavior. | 2026-09-10 | TBD |
| 45 | CI/CD Foundation | Planned | Add GitHub Actions or equivalent CI that runs formatting/lint checks, Python unit tests, ROS package build, and selected launch/config smoke checks on every PR/branch. CI should block regressions before hardware testing; CD remains limited to tagged Docker/image/release artifacts until deployment is safer. | 2026-09-17 | TBD |
| 46 | Hardware Acceptance & Reliability Report | Planned | Turn baseline probes into a repeatable hardware acceptance suite: idle, motion, post-motion, localization readiness, fault decode, safety recovery, and mission success criteria. Run 20+ repeated delivery/navigation missions and summarize success rate, faults, localization jumps, recovery time, and known limitations. | 2026-09-24 | TBD |
| 47 | Custom Carrier PCB Development | Planned | Design and validate the custom carrier/control-board path before adding extra STM-side sensors: connectorized STM/driver/sensor wiring, clean 5 V/3.3 V distribution, I2C routing, level shifting/protection, grounds, test points, fusing, and harness labels. Start with a carrier/backplane around the current Nucleo/Cytron/buck architecture before considering deeper motor-driver or MCU integration. | TBD | TBD |
| 48 | Post-PCB Proximity + Battery Level Integration | Planned | After the custom carrier/control board exists, integrate proximity sensors and INA226-style pack telemetry cleanly: proximity trigger/echo routing and filtering, shared I2C battery monitor wiring, external shunt placement after the main fuse and before branch distribution, STM firmware drivers, `/amr_stm/*` telemetry topics, docs, harness contracts, and acceptance checks. | TBD | TBD |
| 49 | Product-Grade Demo Package | Planned | Produce a polished productization case study: operator demo, deployment guide, safety case, acceptance-test report, architecture diagram, BOM/cost estimate, release tag, and demo video. Present the AMR as a product-grade indoor delivery platform showcase, not a general-purpose robot claim. | 2026-10-01 | TBD |

> Canonical view rule: If the table and task board ever conflict, the table wins for schedule; task board wins for day-to-day details.

---

## Status Summary
- Overall: SLAM + localization + navigation pipeline is working on real hardware (slam_toolbox map -> saved map -> AMCL -> Nav2 goals). The current validated live fallback remains NUC-as-dev-PC plus Jetson Nano-as-hardware-runtime on ROS 2 Foxy: the NUC runs `amr_devpc`, RViz/Nav2/mission/safety/agent tooling; the Jetson runs `amr_foxy`, micro-ROS, LiDAR, ros2_control, and STM link watchdog. The Orin NX/Humble migration path now has Docker, hardware launch, NUC RViz/dashboard/teleop helpers, LiDAR, STM, controllers, RViz goal delivery, camera previews, SO-101 MoveIt bridge execution, and a suspended Nav2 command-path smoke test. SO-101 integration and an initial ACT manipulation demo are validated; low-level control/odometry calibration is still in active tuning.
- Progress: 26/49 weeks complete (~53%). NUC migration is closed as a baseline milestone; extended repeatability tests are deferred to the later hardware acceptance/reliability track. The active near-term focus has moved from Orin software bring-up to supervised integration cleanup: keep the mounted Orin running with stable power/USB/cooling, validate floor operation, and calibrate SO-101 joint limits and camera extrinsics before grasp execution.
- Recent:
  - Validated the NUC as the live dev-PC replacement for the existing split runtime. Docker, amd64 AMR images, software-only `colcon build/test`, map artifacts, Jetson SSH aliases, UDP/DDS firewall rules, and NUC-to-Jetson reduced source sync are in place.
  - Completed supervised NUC+Jetson mission validation on `my_new_map`: `go_to hall`, then `go_to kitchen`, then `go_to home` all succeeded through guarded mission-control and `mission_server`. Safety stayed monitor-only/healthy, STM `fault_mask` stayed `0`, comm stayed `stm_link_ok`, and odom returned to zero after arrival.
  - Fixed and validated the NUC one-command launcher path: `open_amr_devpc_navigation.sh` now uses tmux 3.4-compatible pane sizing, creates `amr_devpc_nav`, starts Jetson `amr_foxy`, resets STM, brings up Nav2/RViz/mission/safety panes, and passes guarded dry-run mission readiness after initial pose.
  - Validated the AMR MCP surface for future OpenClaw integration: source compile, agent harness checks, host-safe MCP smoke tests, ROS-attached state/mission MCP smoke tests inside `amr_devpc`, launch preflight, live read-only inspection, and mission-control dry-run readiness all passed without sending motion.
  - Reflashed `STM_Firmware_AMR_v2`, restored STM32 micro-ROS connectivity, and revalidated live `/amr_stm/*` topics on the Jetson bring-up path.
  - Completed the AMR rewire/known-good bring-up loop on the Nano/Foxy runtime: MCP robot launch restarted the Jetson hardware stack and dev-PC Nav2 session with `my_new_map`, STM reset over ST-LINK completed, `/scan` and `/amr_stm/wheel_state` were live, AMCL/Nav2 lifecycle readiness passed after initial pose, and mission services were responsive.
  - Revalidated the supervised agentic mission path end-to-end: MCP mission-control readiness passed for `hall`, `go_to_named_place("hall")` started through `/amr_missions/go_to`, the robot reached `hall`, both wheel encoder paths responded during motion, and STM `fault_mask` stayed `0`.
  - Added a launcher hardening option to run the MCP/dev-PC navigation stack with RViz disabled (`AMR_START_RVIZ=false`, MCP `start_rviz=false`) after RViz load was observed to make lifecycle service readiness flaky.
  - Debugged the recent hardware bring-up faults: left-stall evidence pointed to wiring/encoder-response issues during earlier tests, a wiring issue was corrected, and a transient right current-sensor rail/OC fault was identified as a sensor wiring/calibration follow-up rather than a Nav2/MCP command-path issue.
  - Re-checked wheel encoders on live `/amr_stm/wheel_state`, corrected left/right motor-channel wiring, and fixed wheel direction polarity so individual left/right wheel commands now actuate the intended side.
  - Added ROS current topics (`/amr_stm/current_left_ma`, `/amr_stm/current_right_ma`) plus raw ADC/zero topics for bench bring-up and calibration of the replacement current sensors.
  - Completed current-sensor integration bring-up: current sign/polarity was corrected, idle offset reduced to a small near-zero bias, load current now rises in the expected direction on both sides, and current settles back near zero when the wheels stop.
  - Restored the overcurrent threshold to `1500 mA` after calibration and confirmed the firmware-side current path is now usable for protection testing.
  - Added a one-command Jetson bench monitor workflow for wheel state, duty, current, safety state, and fault tracking during bring-up.
  - slam_toolbox bring-up working with real LiDAR (`/scan` -> `/map`) and RViz config saved.
  - Saved a real map and validated map_server + AMCL localization; Nav2 navigation (planner/controller) working with RViz goal tool.
  - Added a Nav2 wrapper launch + params to remap `/cmd_vel` + `/odom` to ros2_control diff-drive topics and to launch RViz reliably inside Docker.
  - Added one-shot dev-PC workflows for SLAM and navigation that first bring up the Jetson hardware stack and then reset the STM over ST-LINK using `openocd` on the Jetson.
  - Validated noninteractive STM reset from the Jetson with `sudo -n openocd -s /usr/share/openocd/scripts -f interface/stlink-v2-1.cfg -f target/stm32f4x.cfg -c "init; reset run; shutdown"`.
  - Fixed RViz map display QoS (Transient Local + Reliable) and added Nav2 UI tools/panel to `amr.rviz`.
  - Marked Week 21 (URDF base) and Week 22 (mapping/localization/navigation bring-up) complete; EKF fusion is tracked as a separate improvement.
  - Resolved TF bring-up issues by ensuring ros2_control/controller_manager + `/joint_states` are alive before SLAM.
  - LiDAR alignment parameterized in URDF (yaw adjust) and rebuilt into runtime container workflow.
  - Encoder pipeline validated on bench (manual rotations), moved to higher-resolution timer mode (TI12), and began closing the loop on wheel kinematics (track width / wheel separation) using 360-degree tests.
  - Added firmware tuning profiles for controlled A/B testing (launch guard, feedforward/static FF, etc.) to avoid “many knobs at once”.
  - Promoted `amr_missions` into a persistent mission runtime with `mission_server`, typed `MissionStatus`, `/amr_missions/state`, and a command topic; the one-shot navigation launcher now includes mission-server, mission-status, and mission-command panes.
  - Revalidated named-place navigation and patrol flows on real hardware with the persistent mission runtime; current saved places are `home`, `door`, `kitchen`, and `hall`.
  - Hardened the mission/Nav2 command path so mission CLI calls use unique ROS node names, wait only for the required service, and time out cleanly instead of hanging; `go_to kitchen` was revalidated through the mission server on real hardware.
  - Completed the real motor-driver power-cut safety recovery validation without restarting the safety supervisor; reset is rejected while STM fault bits are active, succeeds after fault clear, and STM re-enable remains manual.
  - Added a guarded operator recovery helper (`scripts/amr_safety_recover.py`) so the validated safety recovery sequence can be run repeatably without manually typing every ROS command.
  - Integrated SO-101 into the active project stack and completed the main AMR mechanical assembly.
  - Ran an ACT policy that successfully picked up an object and placed it into a bag.
- micro-ROS: STM32 bring-up on USART2 with full AMR topic set live (wheel_state + duty topics visible); UART telemetry disabled to avoid contention.
- Safety: Hardware e-stop GPIO integrated with debounce and fault latch.
- Current Focus (next sprint):
  - Keep the Jetson Orin NX mounted/powered on the AMR with stable cable routing, cooling, USB devices, and repeatable restart behavior.
  - Continue Orin floor bring-up only under supervision, with the validated NUC+Nano/Foxy path kept intact as fallback.
  - Keep the validated NUC+Nano/Foxy path intact as the fallback; do not silently replace `docker/foxy`, Nano launch assumptions, or the known-good mission workflow.
  - Use the Orin-specific Docker/runtime profile (`docker/orin`, image `amr/ros2-humble-orin:arm64`) as the Humble/JetPack 6 base; keep the Orin workspace synchronized from the NUC before rebuilds.
  - Bring up Orin hardware incrementally after power loss: USB/device IDs, STM32 micro-ROS, `/amr_stm/*` topics, LiDAR `/scan`, RealSense preview streams, wrist webcam preview, SO-101 serial path, GPU/container runtime, thermals, network, and device permissions. Initial bench/suspended checks passed; the next meaningful validation is floor hardware acceptance and manipulation calibration.
  - Port or shim Foxy-to-Humble differences, especially `ros2_control`, `controller_manager`, launch files, Nav2 parameters, and micro-ROS agent compatibility.
  - Prefer the validated one-command NUC launch over manual container bringup for fallback operations; keep the manual flow only as a debugging fallback.
  - Keep the current hardware work limited to reliability cleanup: cable strain relief, current-sensor wiring/calibration checks, USB/power stability, and sensor mounting that supports the existing base. Defer STM-carrier proximity sensors, STM I2C IMU, and INA226 battery monitor wiring until a custom carrier/control board.
  - Harden the MCP launch/mission workflow around the validated NUC path: use mission-control readiness as the motion gate, preserve explicit supervised confirmation, and add fixture/software tests for the MCP clients.
  - Keep live agentic motion supervised and routed through mission/safety/Nav2 only. Do not use raw `/cmd_vel`, direct wheel commands, fault clear, STM re-enable, or launch changes without explicit supervised confirmation.
  - Defer broad repeatability loops until the hardware acceptance/reliability track; use only targeted checks needed to prove each Orin interface during bring-up.
  - Treat IMU/EKF as optional after bring-up. If needed before the custom board, evaluate a Jetson-connected IMU or RealSense IMU source, validate `/imu` quality first, and only then configure `robot_localization`.
- Productization Direction:
  - Use this AMR as a productization case study: show how a prototype robotics workbench becomes a repeatable, testable, operator-friendly indoor delivery/navigation platform.
  - Product-grade does not mean certified or mass-manufactured yet. For this project phase it means: one-command build/run paths, clean documentation, automated tests, CI, explicit safety behavior, repeatable hardware acceptance, operator-facing workflow, release tags, and known limitations.
  - Keep the productized showcase narrow: fixed-place indoor delivery/navigation with human load/unload. Manipulation, VLA/VLM autonomy, custom PCB, and general-purpose robot behavior stay as longer-term R&D unless a validated workflow demands them.
- Agentic Tooling Direction:
  - Treat MCP servers, skills, subagents, and harnesses as an operator/developer interface above the existing ROS and firmware stack, not as a replacement control system.
  - Current baseline now includes agent contracts, permission rules, codebase ownership, repo-local skills, source-only harness checks, harness CI, shared ROS clients, a read-only AMR state MCP server, and an agentic behavior diagram.
  - Use nine working agents for current routing: test runner, code review, STM firmware, ROS core/hardware interface, navigation/mission/safety, manipulator/MoveIt, perception/calibration, voice/operator interface, and runtime environment.
  - Continue with read-only and diagnostic capabilities first: robot health, safety state, mission state, named places, localization status, logs, and fault summaries.
  - Add motion-causing tools only after software-only fixtures, command preconditions, safety prechecks, explicit confirmation, audit logging, and supervised hardware acceptance procedures are in place.
  - On Orin, run a small local LLM for orchestration/tool selection and keep VLM/VLA workloads on demand for perception/manipulation proposals. External MCPs such as Home Assistant, system monitoring, calendar/tasks, reminders, and recipe/meal planning may provide context or non-motion actions, but robot motion must remain behind AMR-owned MCP safety tools.
  - Keep agent tools intent-level (`go_to_named_place`, `cancel_mission`, `plan_arm_named_pose`) and block raw motor/PWM/unguarded joint-control pathways.
- Control Architecture Direction:
  - Yes, moving toward cascaded control makes sense: inner current/torque limiting (or current loop if feasible) + outer speed loop is the standard industrial structure and will reduce slip/launch transients once current sensing is reliable.
- Next Focus:
  - Continue Orin NX AMR runtime migration on the mounted/powered robot while keeping NUC+Nano/Foxy as the known-good fallback until Orin passes hardware acceptance.
  - Agentic AMR operation hardening on the Orin-capable base through voice/text/LLM -> skill -> MCP -> shared ROS client -> mission/safety/Nav2.
  - MoveIt-first manipulator bring-up after the AMR base is stable. Current first slice now includes the upstream-backed single SO-101 URDF/TF scaffold, wrist-webcam frame, MoveIt2 config, conservative `amr_so101_driver` trajectory bridge, all-six supervised teleop, free-servo service, and encoder-captured named poses. Next manipulator action is physical joint-limit calibration before trusting home/carry/look/pick poses in MoveIt.
  - Orin LLM/MCP integrations after the Orin AMR runtime and safety boundaries are proven.
  - Supervised repeatability and hardware acceptance on Orin, with comparison against the known-good NUC+Nano/Foxy split.
- Timeline: Flexible (now a 49-week plan with extensions). Prioritize Orin runtime migration first while preserving the NUC+Nano/Foxy fallback, supervised hardware acceptance second, MoveIt manipulation third, and broader Orin-based autonomous integrations after the core robot is reliable. Custom PCB is now the preferred place to integrate proximity sensors, STM-side IMU, and INA226 battery monitoring cleanly.

## Calendar Baseline (Week Alignment)
- Week 1 start: 2025-10-17.
- Paused weeks (approx): 2025-11-03 to 2025-11-09 and 2025-11-17 to 2025-11-23.
- Plan weeks are working weeks; paused weeks extend the calendar timeline by ~2 weeks. Update these dates if the break windows were different.
  - Firmware Branching: v1 (bench, L298N + small encoder) is now frozen; all new work proceeds in v2 (Cytron MDD20A + post-gearbox encoder).

Legend: <span style="color: green">Done</span>, <span style="color: goldenrod">In Progress</span>, Partial, Planned, Blocked

---

## Productization Track

The AMR will be used as a productization showcase, not only an R&D platform. The objective is to demonstrate the engineering discipline needed to turn a working robot into something another engineer/operator can build, test, run, debug, and evaluate.

### Productization Goal

Productize one narrow scenario first:

```text
Indoor fixed-place delivery/navigation robot:
- map a known indoor environment
- define named places
- send the robot to a selected place
- human loads/unloads payload
- robot reports status and returns home
- logs mission result
- exposes clear safety/recovery behavior
```

This avoids claiming a general-purpose robot too early while still producing a strong product-grade demo.

### What Product-Grade Means For This Repo

- Clear top-level `README.md`: current capability, hardware assumptions, build/run/test instructions, known limitations.
- One-command workflows: `make build`, `make test`, `make nav`, `make safety-baseline`, `make hardware-check` or equivalent scripts.
- Automated software tests for deterministic logic: voice parser, mission config loading, mission validation, safety health-state logic.
- CI checks on every branch/PR: build, tests, lint/static checks, package metadata, and smoke checks that do not require hardware.
- Hardware acceptance suite: repeatable idle/motion/post-motion probes, mission success criteria, safety recovery checks, and saved reports.
- Agent-facing interface discipline: documented agent roles, project skills, MCP tool permission levels, structured outputs, and harness scenarios for unsafe requests.
- Deployment docs: Jetson/dev-PC setup, map creation, place calibration, startup, shutdown, log collection, recovery.
- Safety case: hazards, mitigations, current limitations, operator responsibilities, and what is not certified.
- Release discipline: tag stable demo states, record test results, keep generated logs/build artifacts out of source.

### Agentic Tooling Track

Detailed task breakdown: `docs/agentic/agentic_robotics_roadmap.md`.

This track introduces MCP servers, subagent roles, repo-local skills, shared ROS clients, and agent harnesses as structured tooling around the AMR. The first milestone is now a working documentation and read-only diagnostics baseline. Motion-causing tools must remain behind explicit confirmation, safety-state checks, localization checks, audit logging, fixture-backed tests, and supervised hardware acceptance.

Implemented baseline:

- Defined nine agent roles, including the runtime environment agent for Docker, Jetson Nano, and Orin NX work.
- Added repo-local skills for test running, code review, STM firmware, ROS core/hardware, navigation/mission/safety, runtime environment, voice, perception, manipulator bring-up, navigation debug, mission runtime, safety recovery, and hardware acceptance.
- Added `agent_harness` source-only checks and GitHub CI for harness validation.
- Added shared `amr_clients` ROS client helpers so CLI, voice, and MCP paths do not duplicate mission or safety logic.
- Added the read-only `mcp_servers/amr_state_inspection` server for robot health, safety state, mission state, named places, localization, STM diagnostics, and navigation state.
- Added `docs/agentic/agentic_behavior_diagram.md` to show how users, agents, skills, harnesses, MCPs, shared ROS clients, and the robot runtime fit together.

Next work:

- Add software-only functional validation for skills, shared ROS clients, and MCP behavior without requiring a physical AMR.
- Add fake-ROS or fixture-backed MCP integration tests so read-only MCP behavior can be checked in CI.
- Add confirmation-required command MCP tools only after guardrails are documented and tested: go to named place, cancel mission, recovery checks, and later approved arm plans.
- Add supervised hardware acceptance for the AMR base before treating command MCPs as a regular operating path.
- Bring up Orin as the near-term AMR runtime and later on-robot LLM/MCP runtime: separate Docker profile, system monitoring, local small LLM orchestrator, explicit Foxy/Nano vs Humble/Orin separation, and hardware acceptance before Orin becomes the primary driving computer.
- Integrate external MCPs only after the AMR-owned safety boundary is clear. First candidates: Home Assistant for home state, system monitoring for Orin health, calendar/task/reminder MCPs, and recipe/meal-planning MCPs. These should provide context or non-motion actions; AMR motion stays behind AMR-owned MCP tools.
- Keep subagent workflow PR-based: domain agent performs bounded change, Test Runner Agent validates, Code Review Agent reviews, then merge through PR.
- Expand supervised hardware acceptance reports only when the physical AMR is available and the operator explicitly requests a hardware run.

### Productization Guardrails

- Do not add new autonomy features unless they strengthen the fixed-place delivery/navigation showcase.
- Keep any second-arm or dual-arm manipulation as a future capability until navigation, safety, logging, and the single-arm workflow are repeatable.
- Treat every recurring manual command as a candidate for a script, Make target, or documented operator procedure.
- Treat every hardware validation as a future acceptance test with pass/fail criteria.
- Document limitations honestly. Known limitations increase credibility when they are measured and bounded.

## CI/CD Notes

CI/CD means Continuous Integration and Continuous Delivery/Deployment.

### Continuous Integration

CI is the habit of checking every code change automatically before it reaches the main working branch. In this AMR project, CI should answer:

```text
Did this change break the ROS workspace build?
Did parser/mission/safety logic still pass tests?
Are launch/config files still valid enough for smoke checks?
Did package metadata or dependencies regress?
```

CI is needed because robotics systems have many layers: firmware, ROS packages, launch files, YAML configs, Docker images, scripts, maps, and hardware assumptions. A small change to a topic name, QoS profile, service timeout, or YAML key can silently break a real robot. CI catches the software-side mistakes before risking hardware time.

Initial CI for this repo should be software-only:

1. Checkout the repo.
2. Install/build the ROS dependencies or use the existing Docker image.
3. Run `colcon build`.
4. Run `colcon test`.
5. Run Python unit tests for deterministic packages.
6. Run lightweight lint/static checks.
7. Optionally run launch/config smoke checks that do not require Jetson, STM32, LiDAR, or motors.

Hardware-in-the-loop tests come later because they require the physical robot and operator supervision.

### Continuous Delivery

CD means producing a repeatable release artifact after CI passes. For this AMR, early CD should mean:

- tagged Docker images for dev-PC/Jetson runtimes
- versioned release notes
- packaged config profiles
- saved acceptance-test reports
- release tags such as `v0.1.0-navigation-demo` or `v0.2.0-productized-delivery-demo`

This is safer than automatic deployment. The robot should not auto-update and run on hardware just because code was pushed.

### Continuous Deployment

Continuous Deployment is when passing changes are automatically deployed to production. For this AMR, that should be avoided until the platform has strong rollback, remote supervision, safety gates, and field maturity. Physical robots can damage hardware or create safety risks, so deployment should stay manual and deliberate for now.

### CI/CD Roadmap For AMR

- Phase 1: Add local tests and `make test`.
- Phase 2: Add CI for unit tests and `colcon build`.
- Phase 3: Add launch/config smoke checks.
- Phase 4: Add Docker image build checks.
- Phase 5: Add tagged release artifacts and release notes.
- Phase 6: Add hardware acceptance reports, still manually triggered.
- Phase 7: Consider supervised deployment/update flow only after rollback and safety procedures are mature.

---

## PCB Migration Milestones (dev boards -> integrated AMR control PCB)

PCB migration remains a later optional productization track. It should not block the immediate AMR base reliability, agentic operation, MoveIt manipulation, or Orin MCP/LLM integration work unless wiring reliability or repeatability becomes the limiting factor.

- Conceptual architecture (target end-state): Define final board contents (STM32/bare MCU or SOM, dual motor stage, buck rails 12->5->3.3 V, encoder conditioning, current sense, battery protection, all IO connectors, CAN/UART/RS485/I2C). This is the "Cytron + Nucleo + buck + encoder + UART + IO" rolled into one.
- Phase A - Measure on dev boards: With Nucleo + Cytron + XL4016, capture real currents (continuous/peak), encoder voltage tolerance/noise, UART/CAN bandwidth, EMI/ground noise patterns, ADC resolution needs, harness lengths and connector types. This produces the electrical requirements doc.
- Phase B - Consolidation carrier PCB: Keep Nucleo + Cytron + external buck, but design a carrier/backplane that handles connectors, power distribution, current sensing, ferrite/filter caps, and ground planes to organize wiring and validate signal/power integrity.
- Phase C - Integrate motor driver: Drop Cytron; design your own dual H-bridge with gate driver (e.g., DRV87xx) + MOSFETs + shunts/Hall sensors. Validate thermals, switching, protection (TVS/fuse/reverse), and EMC.
- Phase D - Integrate MCU: Replace Nucleo with bare STM32F401 (LQFP-64): crystal, boot config, SWD header, decoupling, ESD/TVS, brownout protection. Port firmware; bring-up clocks, debug, boot, and motor control.
- Phase E - Production/EMC-ready: Move to 4-layer, split/stitched grounds, Kelvin sensing, star grounds, TVS + common-mode chokes, reverse/fuse protection, panelization notes, silks/labels, test points. Run pre-scan EMC/ESD and pilot build (5-10 boards) with harnesses and acceptance tests.
---

## Architecture Docs
- ROS stack diagrams: `docs/architecture/ros_stack_diagrams.md`
- STM32 firmware architecture: `docs/architecture/STM_architecture.md`
- Jetson Nano runtime architecture: `docs/architecture/jetson_architecture.md`
- Agentic behavior diagram: `docs/agentic/agentic_behavior_diagram.md`
- Agentic robotics roadmap: `docs/agentic/agentic_robotics_roadmap.md`
- Agent tool permissions: `docs/agentic/agent_tool_permissions.md`
- Agent interaction examples: `docs/agentic/agent_interaction_examples.md`
- Initial agent role contracts: `docs/agentic/roles/`

---

## Project Log
- 2026-07-07: Updated the Orin/SO-101 checkpoint after live AMR operation. The Orin AMR hardware container is the current Humble bring-up path with LiDAR, STM micro-ROS, controllers, `/amr/joint_states`, D455 low-bandwidth preview topics, and the SO-101 wrist webcam preview available to the NUC over CycloneDDS. Raw/high-resolution camera topics stay local to Orin unless explicitly needed.
- 2026-07-07: Validated the SO-101 MoveIt bridge far beyond the original wrist-roll-only slice under explicit supervision. The bridge now supports `/so101_arm_controller/follow_joint_trajectory`, `/so101/joint_states`, `/so101/free_servos`, merged global `/joint_states`, all-six joint teleop helpers, named-pose helpers, and encoder-captured `home`/`carry`, `look_from_height`, and `ready_to_pick_up` poses. Remaining blocker is physical joint-limit calibration: recorded safe poses expose starter URDF/MoveIt limit mismatches, so limits must be measured and updated with margins before autonomous grasp execution.
- 2026-06-08: Updated the persistent `the-amr-guy` context, manipulator architecture, ROS topic ownership, and project tracker for the SO-101 MoveIt bridge. Current arm topic contract is `/amr/joint_states` for base wheels, `/so101/joint_states` for the arm, merged `/joint_states` for RViz/MoveIt, and `/so101_arm_controller/follow_joint_trajectory` for MoveIt execution. The driver defaults to fake hardware and real execution remains wrist-roll-only until Orin validation and shoulder/elbow characterization are complete.
- 2026-06-08: Added the first source-level SO-101 MoveIt execution bridge in `amr_so101_driver` with a conservative `FollowJointTrajectory` action server, Feetech STS3215 serial backend, fake hardware mode, wrist-roll-only execution gate, and joint-state merger for AMR base + arm compatibility. Local Python syntax checks passed; full `colcon build` and supervised hardware validation are pending until the Orin is powered again.
- 2026-06-04: Added the revised Jetson Orin NX enclosure print as an explicit mechanical-integration backlog item. The current enclosure design was insufficient, so the next Orin action is to print one more revised enclosure, install it, power the Orin from the AMR, and only then resume supervised floor bring-up/hardware acceptance.
- 2026-06-02: Started the single mounted SO-101 manipulator stack. Vendored the upstream TheRobotStudio/SO-ARM100 SO101 URDFs, Apache-2.0 attribution, and 13 STL assets; added a prefixed Xacro wrapper with AMR top-plate mount guess, `so101_tool0`, and wrist-webcam frames. Added a view launch file and planning-only starter named poses. The scaffold is for RViz/MoveIt bring-up only; no arm driver, gripper actuation, trajectory controller, or hardware execution path is enabled.
- 2026-06-01: Closed Week 26 as the NUC dev-PC migration baseline. The validated NUC+Nano/Foxy split remains the fallback, while extended route repeatability loops are deferred to the later hardware acceptance/reliability track. Pulled Jetson Orin NX runtime migration forward as the immediate pre-Week-27 focus: create a separate Orin/JetPack 6 runtime profile, likely ROS 2 Humble, build the ROS stack there, validate STM32 micro-ROS/LiDAR/RealSense/GPU/USB/network/device access incrementally, and only promote Orin after supervised hardware acceptance.
- 2026-06-01: Advanced the Orin NX/Humble migration to a paused bench-ready checkpoint. Added the Orin Docker runtime, NUC RViz image, CycloneDDS peer setup, UDP check, Orin hardware launch, YDLidar Orin config, NUC dashboard, NUC RViz launcher, and Orin teleop helper. Verified the Orin hardware container with LiDAR, STM micro-ROS, ros2_control, joint states, wheel state, RViz map/scan/model visualization, Nav2 lifecycle, and RViz goal action clients. A tiny supervised suspended Nav2 goal reached the STM wheel-command path and completed; suspended localization behavior is not meaningful because odom changes without room-relative scan motion. RealSense color is usable in RViz, while depth remains diagnostic-only due USB/control-transfer and Right MIPI warnings. Next action is mechanical/electrical, not software: print/install the Orin enclosure, power it from the AMR, then resume supervised floor acceptance.
- 2026-05-30: Validated the AMR MCP surface ahead of OpenClaw integration. Host-safe MCP smoke tests passed for conversation, perception inspection, robot launch, speaker, and voice interface. ROS-attached smoke tests passed inside `amr_devpc` for state inspection and mission control. Live read-only checks passed for robot health, safety, localization, navigation, mission state, named places, and STM diagnostics; guarded mission-control dry-run readiness for `hall` passed; robot-launch preflight/dry-run passed for `my_new_map`. Captured the checkpoint in `docs/agentic/mcp_validation_2026-05-30.md`.
- 2026-05-30: Extended the NUC live validation with a supervised two-leg route. Guarded readiness passed for `kitchen` and `home`; with operator supervision confirmed, `go_to kitchen` succeeded with `reached 'kitchen'`, then a fresh readiness check passed and `go_to home` succeeded with `reached 'home'`. Safety remained monitor-only/healthy, STM `fault_mask` stayed `0`, comm stayed `stm_link_ok`, and odom returned to zero after arrival.
- 2026-05-30: Fixed and validated the NUC one-command navigation launcher. The NUC host uses tmux 3.4, where `split-window -p <percent>` fails with `size missing`; updated `scripts/open_amr_devpc_navigation.sh` to use `split-window -l <percent>%`. Non-attaching one-command launch now creates `amr_devpc_nav`, starts Jetson `amr_foxy`, resets STM, starts NUC `amr_devpc`, brings up Nav2/RViz/mission/safety panes, accepts the known `home` initial pose, and passes guarded dry-run readiness for `hall` with STM `fault_mask=0`.
- 2026-05-30: Validated the NUC as a live dev-PC replacement against the Jetson Nano hardware runtime. After a clean split relaunch, `my_new_map` loaded, RViz initial pose was accepted, AMCL/Nav2 readiness passed, mission/safety services were healthy, and the guarded mission-control readiness check for `hall` had no blockers. With explicit supervised operator confirmation, `go_to hall` was sent through `mission_server` and succeeded with final detail `reached 'hall'`; STM `fault_mask` stayed `0`, comm stayed `stm_link_ok`, safety stayed monitor-only/healthy, and odom returned to zero. Manual container bringup was the initial validated fallback before the tmux launcher compatibility fix.
- 2026-05-30: Cloned `KartikMehta-1/AMR-development` onto a NUC-class Ubuntu 24.04 x86_64 host at `/home/ubuntu/agent/repos/AMR-development` and captured the migration context in `docs/agentic/nuc_migration_context.md`. Docker Engine 29.1.3, Compose 2.40.3, and Buildx 0.30.1 were installed and `docker run --rm hello-world` passed from the operator's interactive shell. The current validated robot workflow remains the Nano/Foxy split until the NUC path is validated. Treat the NUC first as a dev-PC replacement, then separately evaluate whether it should become the on-robot computer with a dedicated hardware-facing runtime profile.
- 2026-05-23: Completed the Nano/Foxy AMR rewire and agentic control revalidation milestone. The robot was relaunched through the MCP robot-launch server on `my_new_map`, mission-control MCP readiness passed, and supervised `go_to hall` succeeded through the mission server with both wheel encoder paths responding and STM `fault_mask=0`. Added the RViz-disabled launch option (`AMR_START_RVIZ=false`, MCP `start_rviz=false`) after RViz load was observed to make Nav2 lifecycle service readiness flaky. Next focus is repeatability/hardware acceptance, current-sensor wiring/calibration follow-up, and then Orin migration.
- 2026-05-23: Sorted the canonical week table by status so completed work appears first, active work follows, and planned work appears in intended execution order. Moved proximity sensing and INA226 battery-level integration behind custom carrier/control PCB development, combining the old immediate proximity hardware/driver slots into a post-PCB integration task.
- 2026-05-23: Reprioritized the near-term plan after deciding not to force proximity sensors, STM-side IMU, or INA226 onto the current STM carrier wiring. These sensors are deferred to a future custom carrier/control board unless a simple Jetson-connected IMU is needed for odometry experiments. Immediate focus is now to rewire the AMR back to the known-good base configuration, bring up the existing Nano/Foxy stack, revalidate the agentic control path on that baseline, and then proceed with Orin NX runtime migration.
- 2026-05-10: Reworked the weekly roadmap to include the new agentic-AI robot development sequence discussed over the last two days. The near-term order is now AMR base completion, proximity/IMU/sensor-fusion reliability, agentic AMR operation through skills/MCP/shared ROS clients, supervised hardware acceptance, Orin runtime and local LLM orchestration, MoveIt-first manipulator bring-up, and then external MCP integrations such as Home Assistant, system monitoring, calendar/tasks/reminders, and recipe/meal planning.
- 2026-05-10: Adjusted the roadmap to move Jetson Orin NX into the near-term AMR driving path. Orin runtime migration now happens before regular command MCP operation: build a separate Orin/Humble container profile, validate hardware devices and ROS contracts against the existing Nano/Foxy baseline, then run supervised AMR hardware acceptance on Orin before making it the primary robot computer.
- 2026-05-10: Added battery monitoring to the near-term AMR base hardware tasks. Planned hardware path is INA226 over STM I2C `PB8/PB9` with an external 50 A minimum, preferably 75/100 A, shunt placed after the main fuse and before branch power distribution. IMU and INA226 share the planned STM I2C bus; firmware/CubeMX changes are still required. Proximity pins are proposed-final but still require CubeMX/header verification. The voltage display remains display-only, and the battery 5-pin JST-XH connector remains unassigned until pinout is verified.
- 2026-05-10: Updated the agentic implementation sequence to reflect the current baseline: agent contracts, ownership, skills, harness, harness CI, shared ROS clients, read-only AMR state MCP, and agentic behavior diagram are now implemented baseline items. The next agentic focus is software-only functional validation, fixture-backed MCP tests, and only then confirmation-required command MCP tools.
- 2026-05-09: Marked `docs/project/AMR_firmware_tasks.tmp` obsolete and removed its stale legacy references to missing planning docs. The canonical firmware/project status now lives in `docs/project/AMR_project.md`, `docs/architecture/STM_architecture.md`, `docs/hardware/pin_map.yaml`, and the current firmware source.
- 2026-05-09: Created the first two repo-local agent skills: `.codex/skills/amr-code-review/SKILL.md` and `.codex/skills/amr-test-runner/SKILL.md`. These skills reference the detailed role contracts and provide practical workflows, safe command boundaries, subsystem selection guidance, and standardized output formats for review and validation work.
- 2026-05-09: Refined the agent role structure from a compressed starter set into eight target agents: test runner, code review, STM firmware, ROS core/hardware interface, navigation/mission/safety, manipulator/MoveIt, perception/calibration, and voice/operator interface. Added contracts for the new split while keeping manipulator, perception, and voice contracts intentionally lighter until those subsystems mature.
- 2026-05-09: Started Phase 1 of the agentic robotics plan by adding the first agent permission model, interaction examples, and role contracts for the test runner, code review, ROS/mission/safety, and STM firmware agents. These documents define allowed commands, blocked commands, required checks, done criteria, failure modes, and escalation rules before skills or MCP tools are implemented.
- 2026-05-09: Added an agentic robotics roadmap for using MCP servers, subagent roles, repo-local skills, and harness scenarios as a structured operator/developer interface above the existing ROS 2, Nav2, MoveIt2, micro-ROS, and STM32 control stack. Updated the productization roadmap to include agent tool permissions, read-only-first MCP diagnostics, confirmation-required motion tools, engineering agents for test/review/code generation across STM firmware, ROS 2, voice, and perception, and safety-focused harness scenarios.
- 2026-05-04: Added a productization track to the canonical AMR roadmap. The AMR will be treated as a productization case study for a narrow fixed-place indoor delivery/navigation workflow, with repo maturity milestones for README/Makefile cleanup, automated tests, CI/CD foundation, hardware acceptance, reliability reporting, safety case, deployment docs, and a product-grade demo package. Added CI/CD notes explaining why CI is needed for robotics, how it should start as software-only checks, and why automatic deployment to physical robots should remain manual/supervised until rollback and safety procedures are mature.
- 2026-05-03: Hardened the Voice Command MVP for no-speaker operation. Voice motion commands now refuse to proceed until `map -> odom` localization is available, `/amr_voice/feedback` publishes operator-facing text for future TTS, and `scripts/open_amr_voice_asr.sh` launches laptop-mic ASR with the correct workspace setup.
- 2026-05-03: Started Voice Command MVP Step 3. Added `voice_asr_node`, a laptop-microphone Vosk ASR node that publishes `/amr_voice/transcript` and `/amr_voice/partial_transcript`, supports device listing and dry-run mode, and feeds final transcripts through the existing wake-gated mission command handler.
- 2026-05-03: Started Voice Command MVP Step 4. Motion commands now require an explicit `yes` confirmation before calling mission services, while `stop` / `cancel` still bypass confirmation so safety stops are never blocked. Added rejection handling with `no` / `cancel that` and documented the ASR confirmation flow.
- 2026-05-03: Completed Voice Command MVP Step 2 in typed-text form. The voice command node now supports wake-gated operation: `lovely` opens a short listening window, commands with the wake word execute immediately, and stop/cancel remains accepted without the wake word. The one-shot navigation tmux workflow now starts the voice pane with wake gating enabled.
- 2026-05-03: Started Voice Command MVP Step 1. Added the `amr_voice` ROS package with a deterministic text-command parser and `voice_text_cli` / `voice_command_node` entry points. Supported typed intents now include go-to-place (`home`, `door`, `kitchen`, `hall`), stop/cancel, status, and list-places; the package builds in `amr_devpc` and dry-run parsing was validated.
- 2026-05-03: Marked Week 25 Safety Supervision & Health Monitoring complete after the merged safety-supervision branch and validated motor-driver power-cut recovery flow. Remaining safety improvements should be tracked as follow-up tasks rather than keeping the baseline safety layer open.
- 2026-05-03: Reprioritized the weekly plan after safety-supervision merge. Cascaded PID/current-loop work is marked complete for this phase with production motion staying on the validated single-loop speed controller; proximity sensors are returned to planned status; voice-command control is now the active branch and current sprint, split into text parsing, "lovely" wake-word flow, laptop ASR, confirmations, Jetson speaker feedback, full loop, and robustness guards.
- 2026-05-03: Completed Safety Step 10: repeated the real motor-driver power-cut fault while moving, confirmed STM latched `STALL_LEFT|STALL_RIGHT` (`fault_mask=24`) with comms healthy, verified `/amr/safety_supervisor/reset_intervention` rejects while unsafe, restored motor-driver power, cleared STM faults, reset the supervisor without restarting it, manually re-enabled STM, and finished with a passing 30 second baseline probe.
- 2026-05-03: Added guarded safety recovery tooling. `scripts/amr_safety_recover.py` cancels mission/Nav2 motion, publishes zero velocity, disables STM, decodes live STM/comm/supervisor state, prompts before clearing nonzero STM faults, calls `/amr/safety_supervisor/reset_intervention`, and keeps STM re-enable as an explicit operator step unless requested with `--reenable`. Dry-run validation passed on healthy hardware.
- 2026-05-03: Hardened the mission/Nav2 command path after CLI calls intermittently hung or failed service discovery. `mission_cli` now uses a unique ROS node name per invocation, waits only for the service required by the requested command, and bounds service-response waits. `mission_server` now clears stale action goal handles on idle cancel requests. Rebuilt/restarted the mission server and validated `status`, `cancel`, and `go_to kitchen` on real hardware. Follow-up: improve localization/AMCL behavior because mission validation still showed large AMCL pose steps during motion while low-level comms and safety remained healthy.
- 2026-04-27: Updated the canonical roadmap to split near-term work and post-Orin work more cleanly. Short-term milestones are now EKF state estimation, persistent mission runtime, safety supervision, and voice I/O scaffolding. Perception-heavy autonomy and manipulator runtime migration are explicitly deferred to the Jetson Orin NX phase.
- 2026-04-27: Added one-shot dev-PC workflows for SLAM and navigation that first bring up the Jetson hardware stack, then reset the STM over ST-LINK via `openocd`, then launch the desktop-side session. Validated noninteractive reset with `sudo -n openocd -s /usr/share/openocd/scripts -f interface/stlink-v2-1.cfg -f target/stm32f4x.cfg -c "init; reset run; shutdown"`.
- 2026-04-27: Added `amr_missions`, a first mission-layer ROS 2 package with YAML-defined named places and a `mission_cli` supporting `list`, `go_to <place>`, and `patrol ... --return-home ...`. Validated named-place navigation on real hardware for `kitchen` and `hall`; current saved places are `home`, `door`, `kitchen`, and `hall`.
- 2026-04-28: Promoted `amr_missions` into a persistent dev-PC-side mission runtime: added `mission_server`, typed `MissionStatus` publishing on `/amr_missions/status`, a `/amr_missions/state` service, topic-command control, stricter request validation, and mission-server/status/command panes in the one-shot navigation tmux workflow. Patrol was revalidated before merge.
- 2026-04-22: Closed the current-sensor integration bring-up loop for bench use: added raw ADC/zero ROS topics and a one-command Jetson monitor, corrected current polarity/sign, brought idle offsets down near zero on both sides, restored the overcurrent threshold to `1500 mA`, and shifted next-focus planning toward Jetson-side odometry fusion/slip detection.
- 2026-04-19: Reflashed `STM_Firmware_AMR_v2`; recovered micro-ROS bring-up; revalidated encoder feedback and individual left/right wheel control; added ROS current topics; corrected wheel direction polarity; flipped right current polarity and temporarily raised the OC threshold for current-sensor calibration bring-up; noted remaining idle-zero drift on the replacement current sensor.
- 2026-04-17: Marked Week 17 mechanical assembly complete; noted SO-101 integration, successful ACT pick-and-place-into-bag demo, and next focus on wrist camera mounting + AMR depth sensor repositioning.
- 2026-04-17: Shifted immediate manipulation focus to sensor placement for grasping. Decisions: mount a wrist/gripper camera on SO-101, refine the AMR-mounted camera/depth-sensor placement, and treat extrinsic recalibration as mandatory before further ACT policy iteration.
- 2026-04-17: Marked proximity sensor integration, higher-accuracy current sensor + safety algorithm work, and camera mounting on SO-101/AMR as active tracks in the canonical plan.
- 2026-02-11: Standardized Nav2 bring-up on saved maps. Decisions: use map_server + AMCL for localization, use Nav2 for navigation, add wrapper launch/params to wire `/cmd_vel` and `/odom` to ros2_control topics, and update RViz config to use transient-local `/map` QoS with Nav2 tools.
- 2026-02-08: slam_toolbox mapping bring-up verified on real LiDAR; RViz config saved; created controlled firmware tuning profiles; encoder resolution/CPR validated on bench; began track width/wheel separation calibration; focus shifted back to current sensing to enable cascaded control.
- 2026-02-08: Assembled dual SO-101 arms (Week 27 marked done); mechanical integration ahead of schedule.
- 2026-02-08: Shifted to controlled A/B tuning + current-sensor-first control work. Decisions: isolate firmware tuning changes via profiles and prioritize ACS758 validation to unlock current limiting and later cascaded control.
- 2026-01-30: URDF validated in sim; updated Week 21 to focus on sim-vs-real motion alignment; noted ros2_control Docker build reorder + realtime_tools header compatibility work.
- 2026-01-02: Added LiDAR/depth camera bring-up tasks; expanded navigation/mapping breakdown; marked Weeks 17-18 in progress and noted enclosure prep completion and structural changes underway.
- 2026-01-01: Added functional hardware e-stop input with debounce + fault latch; tracker updated to reflect the new clear-path safety baseline.
- 2025-12-22: Integrated mechanical CAD tasks into Week 17; renamed STM architecture doc to `docs/architecture/STM_architecture.md`; removed merged task/architecture files.
- 2025-12-22: Consolidated firmware tasks into the weekly tracker; merged STM32 architecture docs; added Jetson Nano architecture doc.
- 2025-12-22: Added Week 17 mechanical assembly + enclosure tasks; shifted schedule by one week.
- 2025-12-22: micro-ROS bring-up on STM32 (USART2 transport, `/cmd_vel` sub, RPM + fault mask pubs); updated ROS topic list.
- 2025-11-XX: Started AMR CAD assembly with dual SO-101 arm manipulators mounted; initial rough layout committed to repo.
- 2025-11-XX: Added main power switch at pack output ahead of fuse/E-stop; updated hardware block diagram accordingly.
- 2025-11-XX: Added DSN-DVM/DUM-368 battery voltage display (fed after main switch) to specs and wiring docs.
- 2025-11-XX: Selected 4x HC-SR04 ultrasonic proximity sensors (trig/echo to STM32); updated specs, wiring, and diagram.
- 2025-11-XX: Power split defined: XH-M401 (XL4016 class) for Jetson/hub 5 V rail; LM2596 for logic/proximity 5 V rail.
- 2025-11-XX: Cascaded current loop deferred; continue single-loop speed PI until higher-accuracy current sensing is ready.
- 2025-10-28: Marked Week 2 ADC as skipped; set Week 8 next focus to E-stop feature; added Final Drivetrain Migration step; noted flexible timeline and PCB as optional.
