KartikMehta-1/AMR-development/CAD/4 Boughtouts/amass-xt60e1-m-1/Amass XT60E1-M.png

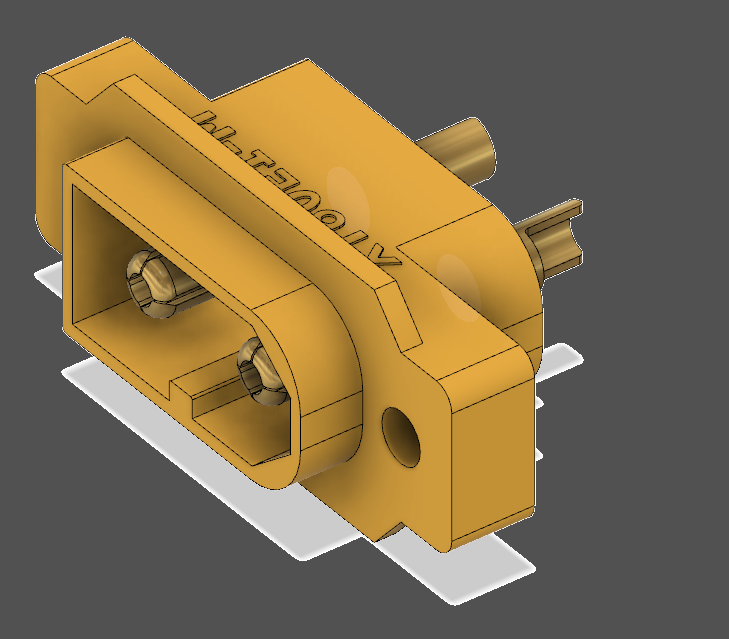
CAD/4 Boughtouts/amass-xt60e1-m-1/Amass XT60E1-M.png
