KartikMehta-1/AMR-development/CAD/4 Boughtouts/amass-xt60e1-m-1/AMASS-XT60E1-M-Male [New Versioin].jpg

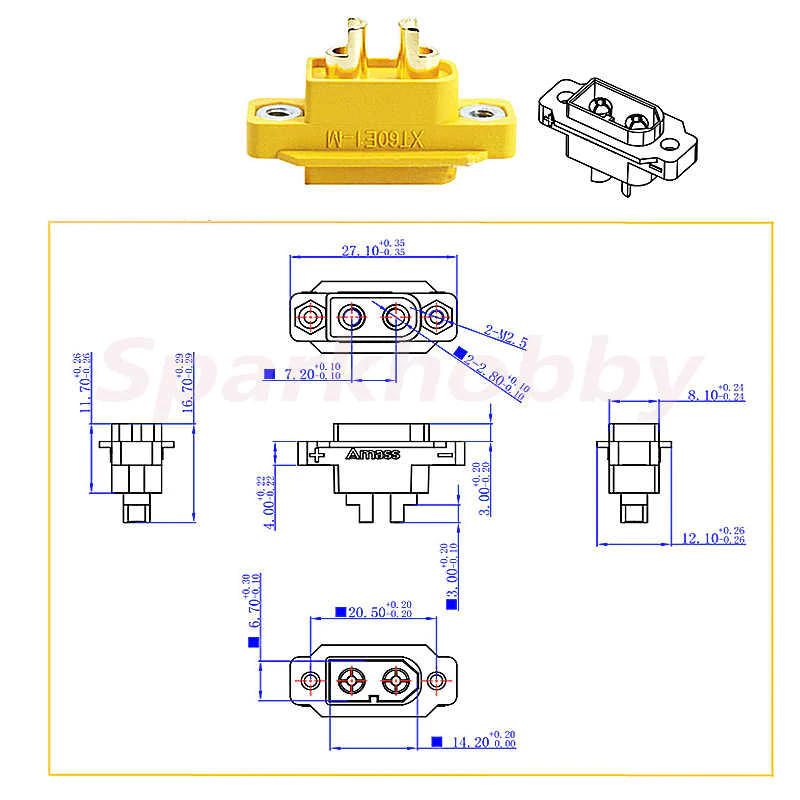
CAD/4 Boughtouts/amass-xt60e1-m-1/AMASS-XT60E1-M-Male [New Versioin].jpg
