KartikMehta-1/AMR-development/CAD/4 Boughtouts/electrical-part-fuse-holder/Fuse Holder - CONQUER CQ-201N_.jpg

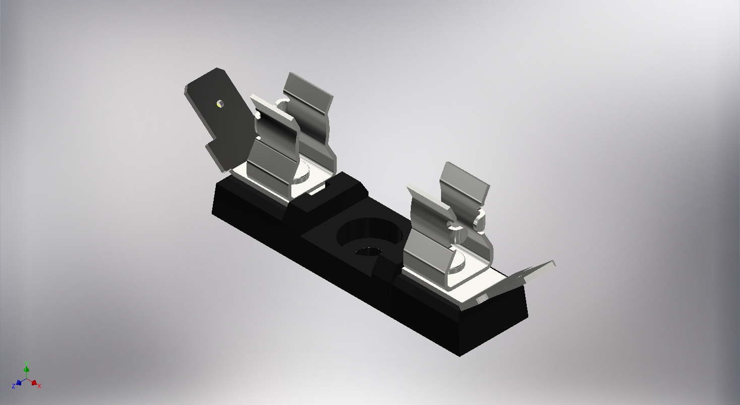
CAD/4 Boughtouts/electrical-part-fuse-holder/Fuse Holder - CONQUER CQ-201N_.jpg
