KartikMehta-1/AMR-development/CAD/4 Boughtouts/emergency-stop-push-button-switches-ab6-v-series-16mm-1/ab6v.jpg

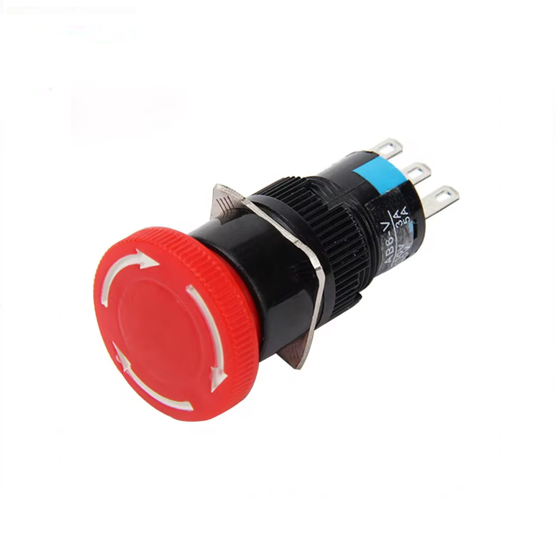
CAD/4 Boughtouts/emergency-stop-push-button-switches-ab6-v-series-16mm-1/ab6v.jpg
