KartikMehta-1/AMR-development/CAD/4 Boughtouts/hc-sr04-ultrasonic-sensor-12/Ultrasonic sensor.png

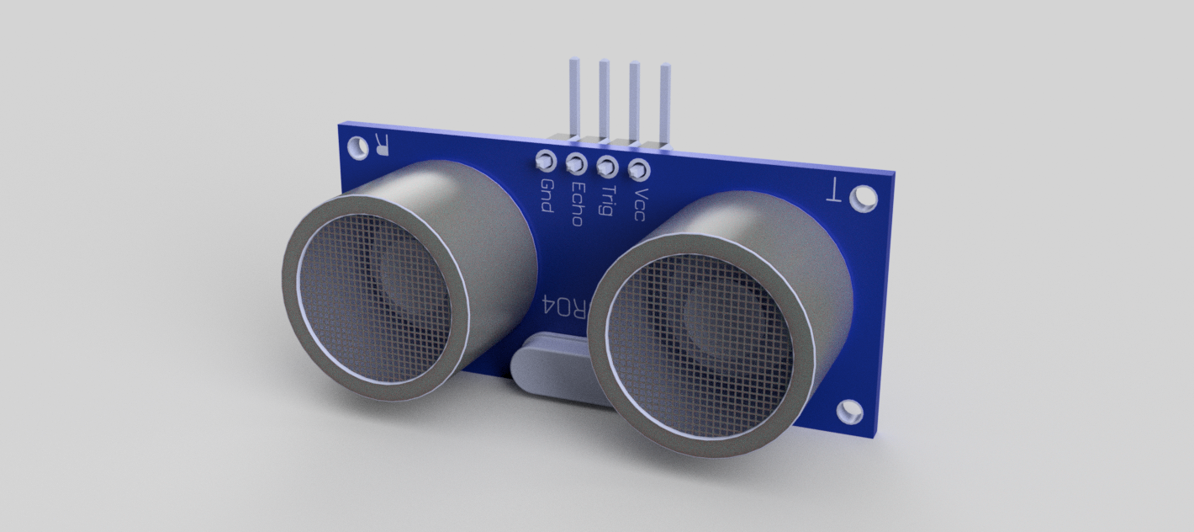
CAD/4 Boughtouts/hc-sr04-ultrasonic-sensor-12/Ultrasonic sensor.png
