KartikMehta-1/AMR-development/CAD/4 Boughtouts/intel-realsense-d455-mount-1/Untitled Project 4.jpg

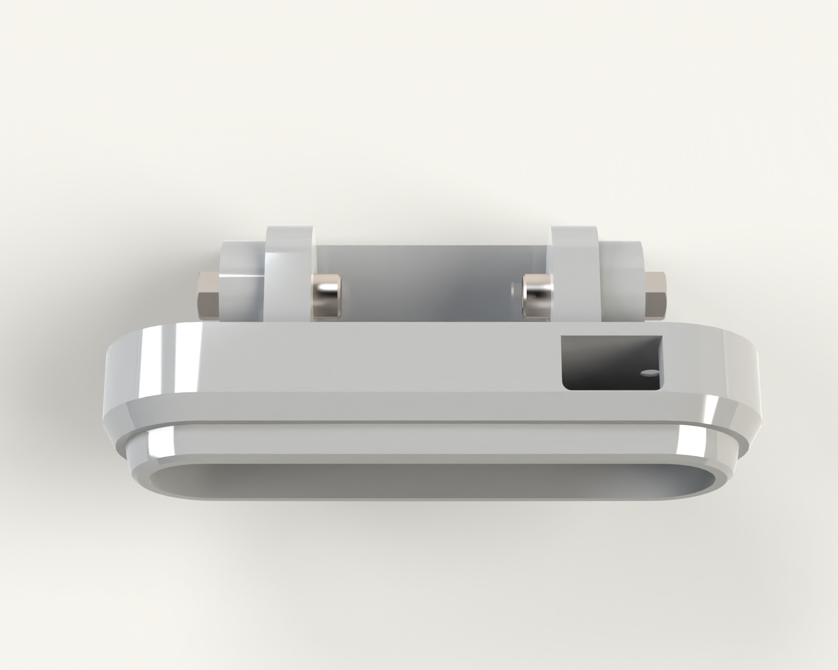
CAD/4 Boughtouts/intel-realsense-d455-mount-1/Untitled Project 4.jpg
