KartikMehta-1/AMR-development/CAD/4 Boughtouts/intel-realsense-d455-mount-1/Untitled Project.jpg

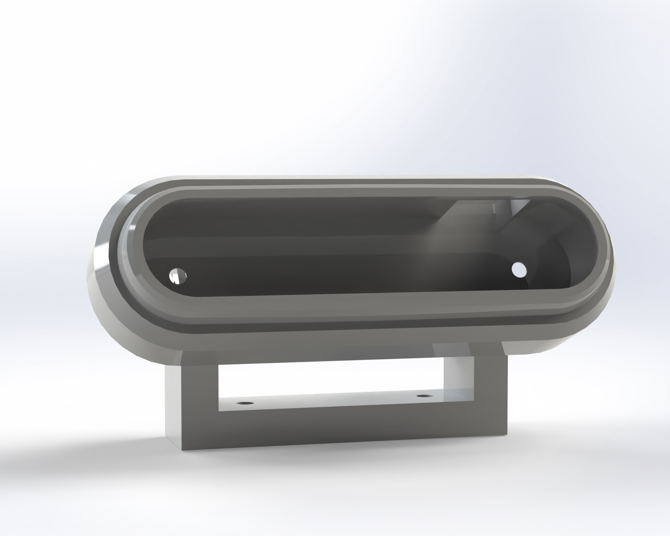
CAD/4 Boughtouts/intel-realsense-d455-mount-1/Untitled Project.jpg
