KartikMehta-1/AMR-development/CAD/4 Boughtouts/intel-realsense-depth-camera-d455/INTEL REALSENSE  DEPTH CAMERA D455/DEPTH_CAM_D455_-_INTEL_REALSENSE_2024-Apr-07_06-36-18AM-000_CustomizedView17896791250_png.png

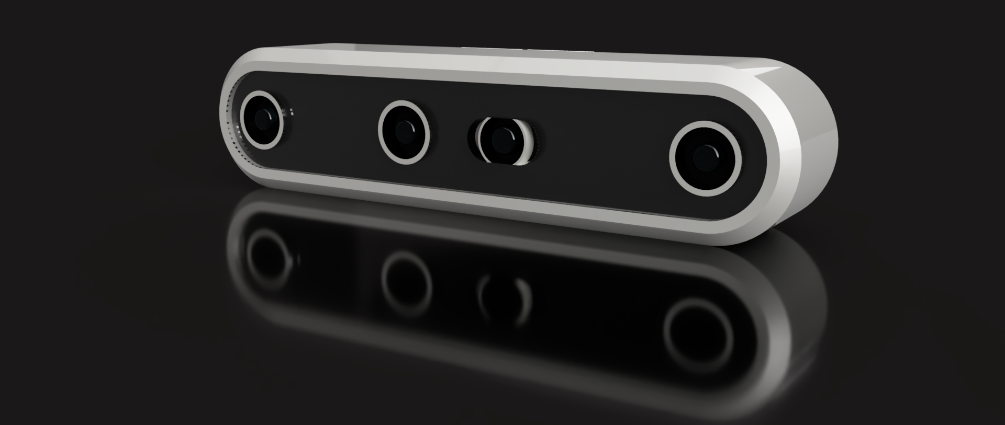
CAD/4 Boughtouts/intel-realsense-depth-camera-d455/INTEL REALSENSE DEPTH CAMERA D455/DEPTH_CAM_D455_-_INTEL_REALSENSE_2024-Apr-07_06-36-18AM-000_CustomizedView17896791250_png.png
