KartikMehta-1/AMR-development/CAD/4 Boughtouts/push-button-16-mm-led-1/LED_Button16mm/Button_16mm_2.png

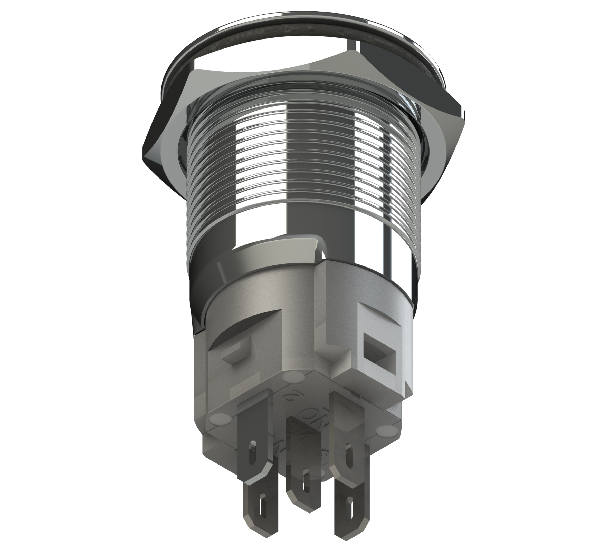
CAD/4 Boughtouts/push-button-16-mm-led-1/LED_Button16mm/Button_16mm_2.png
