KartikMehta-1/AMR-development/CAD/4 Boughtouts/screw-shield-v2-for-arduino-uno/Arduino UNO R3 screw shield v2/Arduino Screw Shield v2 Right.jpg

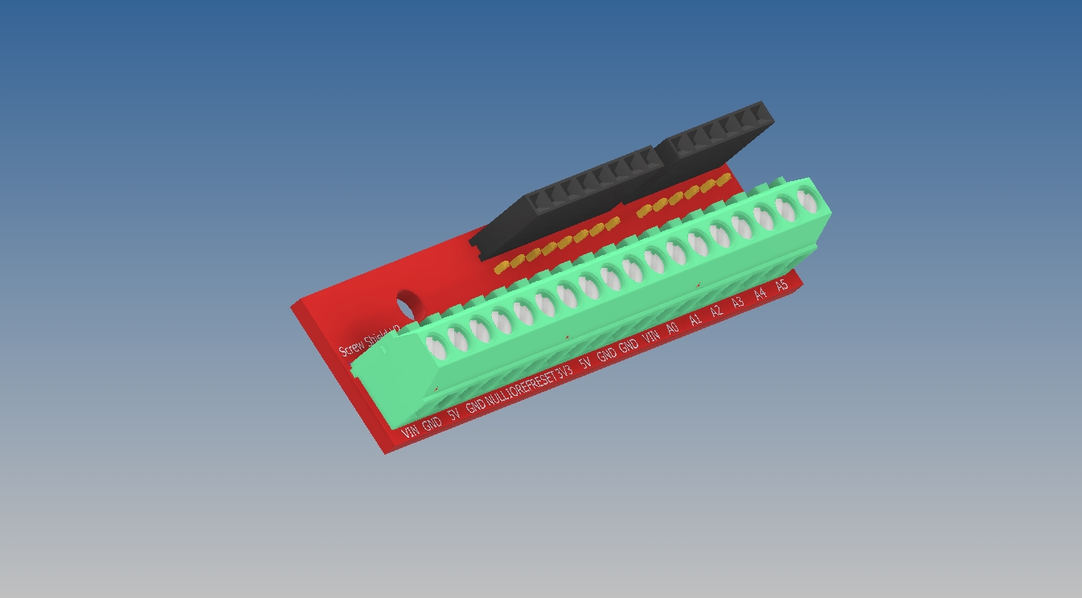
CAD/4 Boughtouts/screw-shield-v2-for-arduino-uno/Arduino UNO R3 screw shield v2/Arduino Screw Shield v2 Right.jpg
