KartikMehta-1/AMR-development/CAD/4 Boughtouts/volt-meter-led-display-1/Display 04.jpg

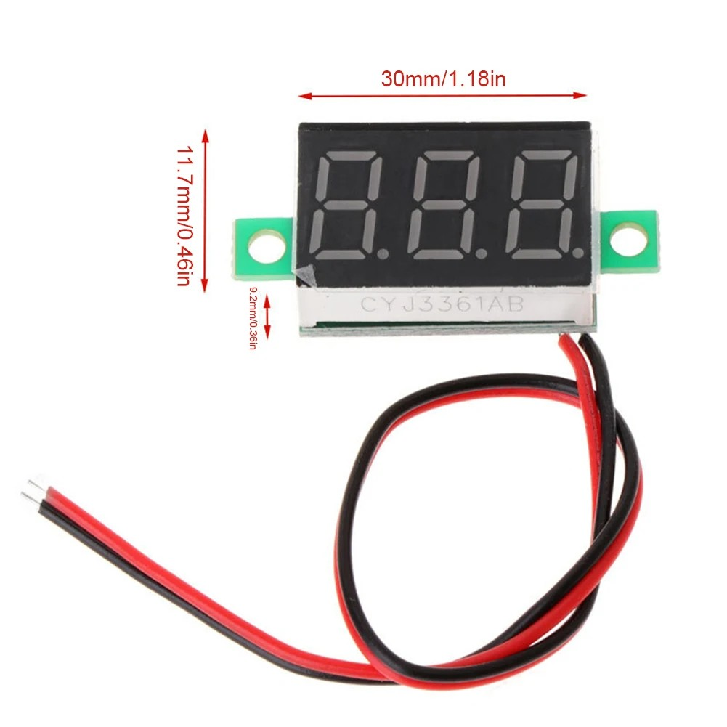
CAD/4 Boughtouts/volt-meter-led-display-1/Display 04.jpg
