KartikMehta-1/AMR-development/CAD/4 Boughtouts/xh-m401-buck-converter/Rendering.png

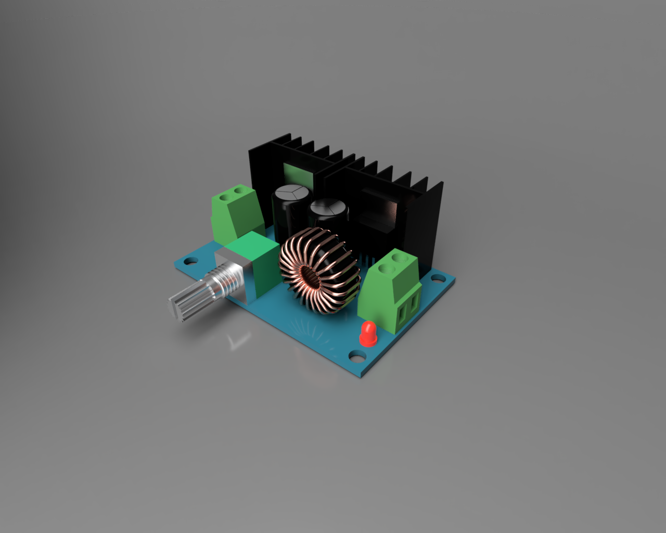
CAD/4 Boughtouts/xh-m401-buck-converter/Rendering.png
