KartikMehta-1/AMR-development/CAD/4 Boughtouts/xt60-female-connector-1/fiche-technique-xt60.jpg

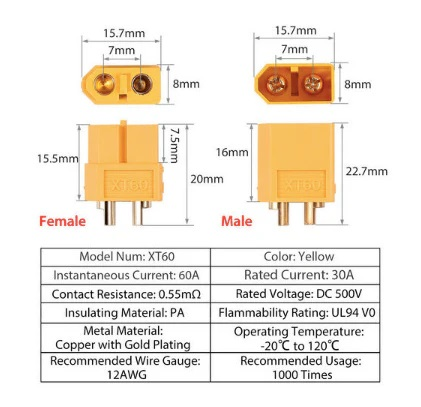
CAD/4 Boughtouts/xt60-female-connector-1/fiche-technique-xt60.jpg
