KartikMehta-1/AMR-development/docs/hardware/Component_specifications.md

# AMR Component Specifications

## 1. Drive Motor
**Model:** Z2D30-12GN  
**Gearbox:** 2GN 30K (30:1)

| Parameter | Value |
|---|---|
| Rated Power | 30 W |
| Rated Voltage | 12 V |
| Load Speed | 2800 rpm |
| No-load Speed | 3200 rpm |
| Motor Torque @ Load | ~0.102 N·m |
| Output Speed @ Load | ~93 rpm |
| Output Torque (Ideal) | ~3.07 N·m |
| Output Torque (70-80% Inom) | 2.15 - 2.46 N·m |
| Est. Current | ~2.5 A |

---

## 2. Motor Driver
**Model:** Cytron MDD20A (Dual Channel)

| Parameter | Value |
|---|---|
| Motor Supply | 6 - 30 V DC |
| Continuous Current / Channel | 20 A |
| Peak Current (Short-term) | 60 A |
| PWM Frequency | ~20 kHz |
| Logic Inputs | 0 - 5 V (DIR, PWM) |
| Channels | 2 |
| Notes | At high PWM frequencies, continuous current may reduce. |

---

## 3. Encoder
**Model:** HN3806-AB-600N (Incremental Optical)

| Parameter | Value |
|---|---|
| Pulses per Revolution | 600 PPR |
| Quadrature Output | A/B (up to 2400 counts/rev with x4 decode) |
| Supply Voltage | 5 - 24 V DC |
| Output Type | NPN Open-Collector |
| Shaft Diameter | 6 mm |
| Body Diameter | 38 mm |
| Max Speed | 5000 - 6300 rpm |
| Output Frequency | ~30 kHz |

Mounting and effective resolution
- Mount Location: Post-gearbox (wheel/output shaft) — confirmed
- Effective Counts/Rev with TIM encoder mode TI12 (target firmware setting): 2400 counts/rev
- Always verify effective counts/rev with a manual wheel-rotation bench test after timer/config changes.

---

## 4. Jetson Nano (Host Computer)
**Model:** NVIDIA Jetson Nano Developer Kit

| Parameter | Value |
|---|---|
| GPU | NVIDIA Maxwell, 128 CUDA cores |
| CPU | Quad-Core ARM Cortex-A57 |
| Memory | 4 GB LPDDR4 |
| Storage | microSD (OS and data) |
| Networking | 1G Gigabit Ethernet (RJ45) |
| USB | USB 3.0 + USB 2.0 (via dev kit carrier) |
| Camera | 2x MIPI CSI-2 (15-pin) connectors |
| Display | HDMI (per dev kit carrier) |
| GPIO Header | 40-pin (3.3 V logic: I2C, SPI, UART, GPIO) |
| Power Input | 5 V DC (barrel jack recommended) |
| Recommended Supply | ~5 V, 4-6 A (headroom for peripherals) |
| Typical Current Draw | 2-4 A depending on load/peripherals |
| Notes | Prefer powered USB hub for high-draw USB sensors (LiDAR/depth cam). |

---

## 5. LiDAR
**Model:** YDLidar G4 (2D 360°)

| Parameter | Value |
|---|---|
| Measurement Type | 2D planar, 360° scanning |
| Range | up to ~16 m (confirm per datasheet) |
| Scan Rate | ~5-12 Hz (adjustable) |
| Angular Resolution | ~0.5-1.0° (mode-dependent) |
| Interface | USB (USB-to-UART) or TTL UART |
| Power | 5 V DC, nominal ~0.5 A (peaks higher; confirm) |
| Mounting | Level, unobstructed 360° field of view |
| Notes | Use powered USB hub; route 5 V from sensor rail. Validate exact range and current from vendor docs. |

---

## 6. Depth Camera
**Model:** Intel RealSense D455 (Stereo Depth + RGB)

| Parameter | Value |
|---|---|
| Interface | USB 3.x (Type-C cable), UVC/UAC compliant |
| Power | 5 V via USB (use powered hub if unstable) |
| Baseline | ~95 mm (depth sensors; confirm) |
| FOV | Wide FOV; verify per D455 datasheet for exact degrees |
| Depth Resolution / FPS | e.g., 848x480 up to high fps; 1280x720 typical (confirm) |
| RGB | Integrated color sensor |
| Mounting | Rigid, vibration-damped; clear view ahead |
| Notes | Requires USB 3 bandwidth for full-rate depth. Confirm exact specs from Intel datasheet. |

---

## 7. Proximity Sensors
**Model:** HC-SR04 Ultrasonic (x4 units)

| Parameter | Value |
|---|---|
| Quantity | 4 |
| Power | 5 V DC |
| Interface | Digital trigger/echo (HC-SR04 compatible) |
| Range | ~2 cm to ~400 cm (typical); validate per batch |
| Update Rate | On-demand via trigger; duty-cycle to avoid crosstalk |
| Mounting | Corners/edges of chassis for obstruction detection |
| Notes | Use per-sensor staggered firing to prevent echo overlap; add small RC on echo if needed to tame ringing; level-shift echo to 3.3 V (HC-SR04 echo is 5 V). Decouple 0.1 uF + 10 uF at each module. |

---

## 8. IMU
**Model:** Adafruit BNO080 (9-DoF orientation fusion, STEMMA QT)

| Parameter | Value |
|---|---|
| Interface | I2C (STEMMA QT/Qwiic compatible) |
| Supply Voltage | 3.3 V (check board regulator if powering from 5 V) |
| Outputs | Orientation (quaternion), angular velocity, linear acceleration |
| Mounting | Rigidly mounted near base center; minimize vibration |
| Notes | Planned near-term wiring is STM I2C on `PB8/PB9` at 3.3 V logic, shared with the INA226 battery monitor. Keep leads short, share logic ground, and verify I2C address compatibility before firmware bring-up. |

---

## 9. Current Sensors
**Model:** a (+/-50 A bidirectional)

| Parameter | Value |
|---|---|
| Supply Voltage | 5.0 V recommended (ratiometric) |
| Output Type | Analog, ratiometric to Vcc (~Vcc/2 at 0 A) |
| Measurement Range | +/-50 A bidirectional |
| Sensitivity | ~40 mV/A at 5 V (module variant ACS758LCB-050B) |
| Bandwidth | Typ. up to hundreds of kHz (datasheet dependent) |
| Isolation | Hall-effect, galvanically isolated conductor |
| Interface to MCU | STM32 ADC via resistor divider (see pin map) |
| Quantity | 2 (Left and Right motor lines) |

Notes
- Choose the variant so nominal operating current is within 20-70% of full scale for good resolution; +/-50 A covers motor peaks with margin.
- Sensor output is centered at Vcc/2; firmware must subtract offset and apply sensitivity.
- With a 10k/20k divider, the ADC sees ~0-3.33 V for a 0-5 V sensor range; ensures 3.3 V ADC compliance. Sensitivity at ADC is ~26.7 mV/A after the divider.
- Add RC filtering post-divider to reduce PWM ripple; see wiring doc for recommended values.

---

## 10. Microcontroller
**Model:** STM32F401RE (Nucleo-F401RE board)

| Parameter | Value |
|---|---|
| Core | ARM Cortex-M4 @ 84 MHz with single-precision FPU |
| Flash / RAM | 512 KB Flash, 96 KB SRAM |
| Timers in use | TIM1 PWM (CH1/CH2), TIM2 encoder (right, 32-bit), TIM3 encoder (left, 16-bit) |
| ADC | ADC1 12-bit with DMA; channels PB0 (IN8) left current, PC1 (IN11) right current |
| UART | USART2 at 460800 bps for the STM-side micro-ROS custom transport |
| GPIO map | PA8/PA9 PWM, PB4/PB5 DIR, PA6/PA7 TIM3 enc, PA0/PA1 TIM2 enc, PA2/PA3 UART2, PA5 LED, PC13 button |
| Debug | ST-LINK/V2-1 onboard |
| Notes | Hosts the live AMR motor-control firmware and micro-ROS client; currently subscribes to per-wheel command topics and publishes wheel-state plus fault, safety, duty, and current-diagnostic topics |

---

## 11. Battery Pack
**Model/Chemistry:** 12.8 V LiFePO4, 4S, 18 Ah (18,000 mAh)

| Parameter | Value |
|---|---|
| Nominal Voltage | 12.8 V (LiFePO4 4S) |
| Charge Voltage (full) | ~14.6 V |
| Discharge Cutoff | ~10.0-10.5 V (depends on BMS) |
| Capacity | 18 Ah |
| Max Continuous Discharge | Depends on cell pack; size for ~30-40 A to match drivetrain and headroom |
| Peak Discharge (short) | Depends on cells/BMS; referenced to pack's internal BMS capability |
| Connector | Nylon T plug (male on charger; ensure matching female or adapter on pack) |
| Notes | LiFePO4 provides flatter discharge curve and better cycle life; pack includes internal BMS with limited telemetry |

---

## 12. Battery Management System (BMS)
**Model:** Built-in pack BMS (basic protection, limited telemetry)

| Parameter | Value |
|---|---|
| Series Cells Supported | 4S LiFePO4 (internal) |
| Continuous/Peak Current | Per pack design; not externally specified |
| Protections | OVP, UVP, OCP, SCP (basic) |
| Balance Method | Passive (typical for pack-integrated BMS) |
| Notes | Main pack output is P+/P-. An unused 5/6-pin connector is present but unverified; identify it before use because it may be balance leads, thermistor wiring, or BMS telemetry. Add protected pack-voltage sensing if host needs charge status. |

## 13. Charger
**Model:** Pro Range 4S LiFePO4 14.6 V 7 A with nylon T male

| Parameter | Value |
|---|---|
| Chemistry | LiFePO4, 4S |
| Charge Voltage | 14.6 V CC/CV |
| Charge Current | 7 A |
| Connector | Nylon T male output (match to pack/BMS pigtail) |
| Notes | 7 A provides ~3 h charge time for 18 Ah pack; ensure BMS and wiring support ~7 A charge current |

---

## 14. Pack Voltage Display
**Model:** DSN-DVM/DUM-368 (2-wire or 3-wire LED voltmeter)

| Parameter | Value |
|---|---|
| Supply/Input Range | ~4.5 - 30 V DC (self-powered from measured line) |
| Display | 0.36 in LED, typically red |
| Accuracy | ~±1% FS (verify per batch; calibrate if needed) |
| Wiring | 2-wire: Red = V+, Black = GND (senses its own supply). 3-wire variant: Red = V+, Black = GND, Yellow = sense (tie to Red if single-line). |
| Mounting | Panel mount with bezel; cutout sized for module |
| Notes | Connect after main power switch so the display is off when the robot is off; fuse the feed if run separately. Treat this as display-only unless the exact module datasheet proves it has a separate telemetry output. The 3-wire sense lead, if present, is normally an input to the display, not an output to STM/Jetson. |

---

## 15. Planned Battery Telemetry Monitor
**Model:** INA226 I2C current/voltage/power monitor module with external shunt

| Parameter | Value |
|---|---|
| Status | Planned |
| Bus Voltage Range | Suitable for 12.8 V LiFePO4 pack; INA226 class supports up to 36 V bus voltage |
| Current Measurement | External shunt, 50 A minimum; 75 A or 100 A preferred for transient headroom |
| Typical Shunt | 50 A / 75 mV = 1.5 mOhm, or equivalent external shunt with known resistance |
| Interface | Planned I2C to STM32 on `PB8/PB9`; CubeMX/firmware changes required |
| Placement | After main switch and main fuse, before branch power distribution |
| Intended Telemetry | Pack voltage, total battery current, battery power, later Ah/Wh estimate in software |
| Planned ROS Topics | `/amr_stm/battery_voltage_mv`, `/amr_stm/battery_current_ma`, `/amr_stm/battery_power_mw` |
| Shield Components | 3.3 V I2C pull-ups around 4.7 kOhm unless breakout pull-ups already exist; 22-100 Ohm optional SCL/SDA series damping; 100 nF local decoupling; fused/current-limited VBUS sense tap; optional 10-100 Ohm shunt-sense series resistors plus 10-100 nF differential filter near INA226 |
| STM-side Wiring | `VCC` to 3.3 V, `GND` to logic ground, `SCL` to `PB8/D15`, `SDA` to `PB9/D14`, `IN+`/`IN-` to external shunt Kelvin sense screws, `VBUS` to protected load-side bus voltage tap |
| Notes | Do not pass main battery current through a small INA226 breakout PCB, STM carrier, or Arduino headers. Use bolted/crimped high-current wiring through the external shunt and Kelvin sense wires to INA226 `IN+`/`IN-`. If the INA226 module includes an onboard shunt, bypass/remove it or use a module designed for external shunt input. |

---

## 13. DC-DC Converters
Three supplies recommended; exact models TBD.

### 13.1 Jetson / Powered USB 5 V Supply
**Model (planned):** XH-M401 / XL4016-class buck module (adjustable, higher current)
| Parameter | Value |
|---|---|
| Input | Battery pack (pre- or post-E-Stop per design) |
| Output | 5.0 V |
| Max Current | ~5-8 A with heatsink/airflow (spec 8 A/200 W is optimistic) |
| Ripple/Noise | Higher than branded supplies; consider extra output caps if needed |
| Notes | Powers Jetson Nano and powered USB extension/hub; set to 5.00 V with a meter before use; fuse input and allow airflow/derating |

### 13.1a Powered USB Extension / Hub
**Model:** TBD powered USB extension/hub
| Parameter | Value |
|---|---|
| Data Interface | USB data link to Jetson Nano / future Orin carrier |
| Power Input | Regulated 5.0 V from Jetson/USB buck/boost branch |
| Purpose | Power LiDAR, RealSense, and other USB peripherals without drawing their 5 V load from Jetson USB ports |
| Notes | Use separate branch fuse where practical; verify polarity, backfeed behavior, cable quality, and USB 3 bandwidth before connecting RealSense |

### 13.2 Logic 5 V Supply
**Model:** LM2596 buck module (adjustable)
| Parameter | Value |
|---|---|
| Input | Battery pack |
| Output | 5.0 V |
| Max Current | ~2-3 A practical (derate from headline) |
| Notes | Powers STM32 board and proximity sensors; separate from Jetson rail for noise isolation |

### 13.3 Sensors 12 V Supply (Optional)
| Parameter | Value |
|---|---|
| Input | Battery pack |
| Output | 12.0 V |
| Max Current | TBD |
| Notes | Only needed if any sensor requires 12 V |

---

## 15. Jetson Soft Power Button
**Model (suggested):** Bulgin MP0045/1E2-C (12 mm anti-vandal, momentary N.O., IP67, no LED)

| Parameter | Value |
|---|---|
| Type | Momentary, normally-open pushbutton |
| Mounting | 12 mm panel cutout (threaded body with nut) |
| Contacts | SPST N.O., rated for low-voltage signal use (PWR_BTN to GND) |
| Interface | Wire across Jetson Nano PWR_BTN and GND pins (header); no power switching |
| Ingress | IP67 (front face) |
| Notes | Use for graceful Jetson start/stop; does not cut 5 V rail. Any similar 12 mm N.O. momentary switch works; omit LED to keep wiring simple. |
