KartikMehta-1/AMR-development/CAD/6 Exports/STEP/SO100/Leader_Specific/SO_5DOF_ARM100_Assembly.step

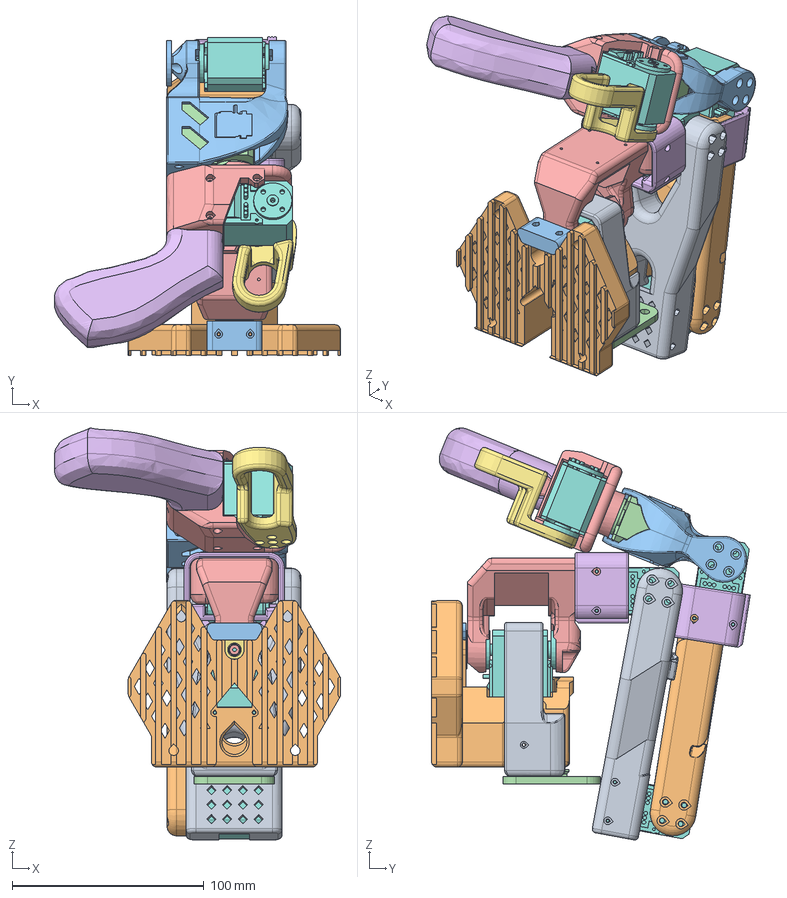
[picture p29: CAD file, 2025-11-23]
CAD/6 Exports/STEP/SO100/Leader_Specific/SO_5DOF_ARM100_Assembly.step
149.5 x 166.4 x 215.1 mm
Base_08q
WaveShare_Mounting_Plate_01d
Rotation_Pitch_08i
SO_ARM100_08k
Passive_Horn_01
STS3215_03a x 5
SO_ARM100_08k (1)
SO_ARM100_08k (2)
Wrist_Roll_Pitch_08i
STS3215_03a (1)
Wrist_Roll_05m_Leader_02ba
Trigger_04e
