KartikMehta-1/AMR-development/CAD/6 Exports/STEP/SO100/Follower_Specific/SO_5DOF_ARM100_Assembly.step

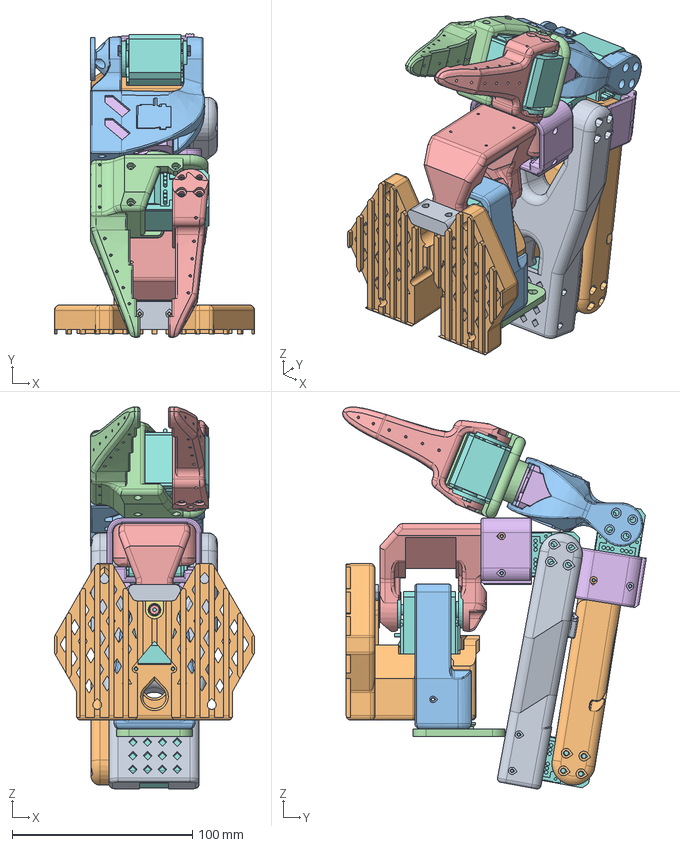
[picture p30: CAD file, 2025-11-23]
CAD/6 Exports/STEP/SO100/Follower_Specific/SO_5DOF_ARM100_Assembly.step
110.9 x 168.3 x 211.8 mm
Base_08q
WaveShare_Mounting_Plate_01d
Rotation_Pitch_08i
SO_ARM100_08k_Asym_Mirror_Clip
Passive_Horn_01
STS3215_03a x 5
SO_ARM100_08k_116_Square
SO_ARM100_08k_Mirror
Wrist_Roll_Pitch_08i
Wrist_Roll_08c
Moving_Jaw_08d
STS3215_03a_Wrist_Roll
