KartikMehta-1/AMR-development/CAD/4 Boughtouts/intel-realsense-d455-mount-1/Assem1.SLDASM

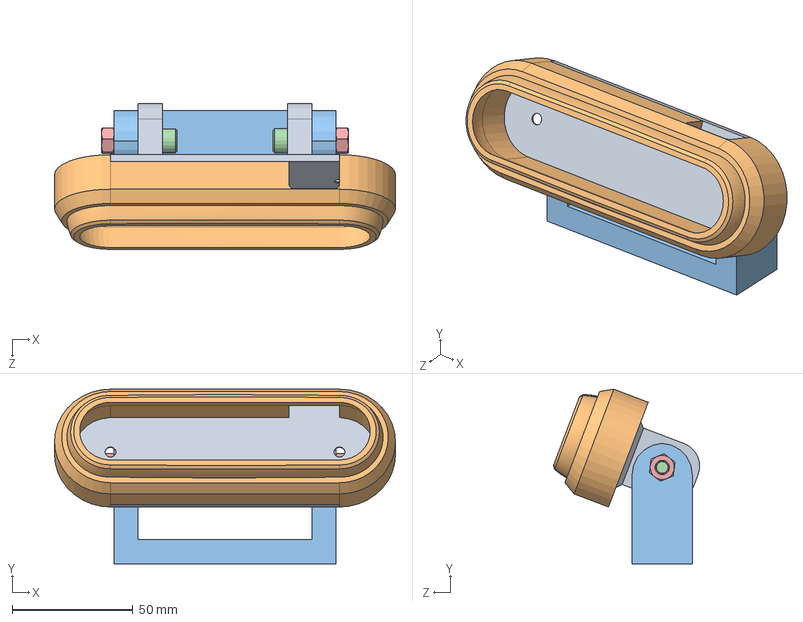
[picture p31: CAD file, 2025-11-30]
CAD/4 Boughtouts/intel-realsense-d455-mount-1/Assem1.SLDASM
141.5 x 72.5 x 60.7 mm
Blocco D455
Cover Telecamera
stand
socket head cap screw_am x 2
hex nut style 1_am x 2
