KartikMehta-1/AMR-development/CAD/6 Exports/STEP/SO101/SO101 Assembly.step

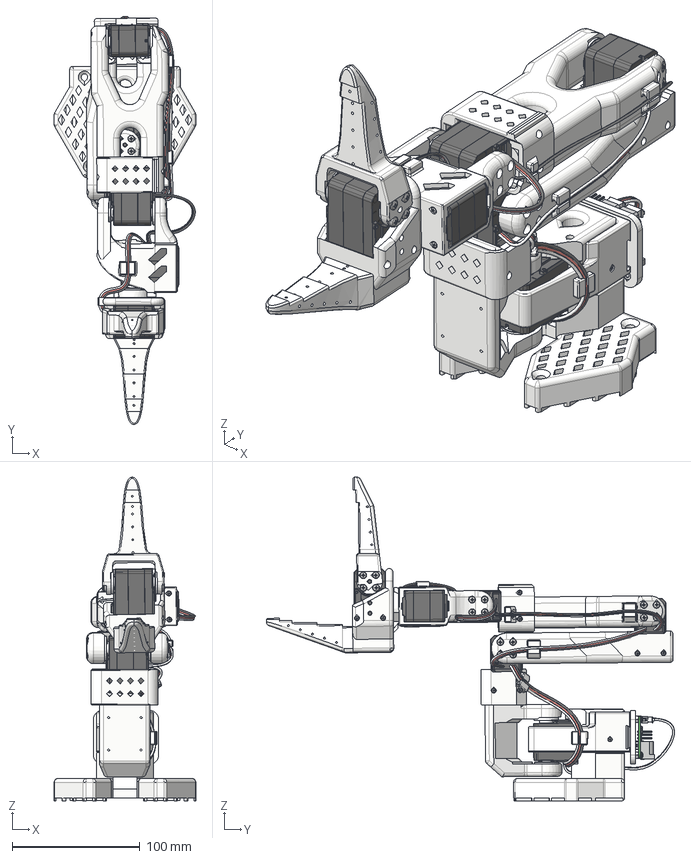
[picture p32: CAD file, 2025-11-23]
CAD/6 Exports/STEP/SO101/SO101 Assembly.step
110.9 x 319.3 x 253.4 mm
Base_SO101
Rotation_Pitch_SO101
Wiring_holder v1
Wiring_holder v1 (1)
Wiring_holder v1_1
Base_08p
Wiring_holder v1_2
Wiring_holder v1 (1)_1
Wiring_holder v1 (2)
Wiring_holder v1_3
Wiring_holder v1 (1)_2
Wiring_holder v1_4
Wiring_holder v1_5
Wiring_holder v1 (1)_3
Moving_Jaw_SO101
CRFHTSTATI ANSI B18.6.4 - 1-42 x 3/16 Steel Grade 2 Plain x 22
CRFHTSTATI ANSI B18.6.4 - 0-48 x 3/16 Steel Grade 2 Plain x 2
DIN EN ISO 7045 - M3 x 6 - H Steel 4.6 Plain x 45
Board
User_Library-0603_SMD_Capacitor x 7
3_1_2_A x 3
SOD323 x 4
dc-005-5a-20
User_Library-DG350-3,5-02P
X2564WV-03-N0SN x 2
_2_1_2_3_4_AF0 x 9
_7_1_2_AF0 x 9
User_Library-QFN-16
User_Library-TO-223_1_1
User_Library-TO-223_2_1
User_Library-TO-223_3_1
User_Library-TO-223_4_1
User_Library-TO-223_5_1
User_Library-sop-8
SOT-23
Extruded x 10
Extruded_1 x 2
Extruded_3 x 9
Extruded_4 x 5
Extruded_2
User_Library-LED_0603_R_Pocket002
User_Library-LED_0603_R_Pad004
User_Library-LED_0603_R_Fillet
User_Library-LED_0603_R_Pocket001
User_Library-LED_0603_R_Pad
M2.5_FF_TORRETTA_PASSANTE x 4
DIN EN ISO 7045 - M2.5 x 4 - H Steel 4.6 Plain x 4
DIN 555 - M3 Steel 6 Plain
DIN 934 - M3 x 0.5 Steel 6 Plain
50375033wbm000_01 x 2
ZK_122 x 6
SG-ZIJI_15 x 6
XG-ZIJI_16 x 6
MOTOR-1723_3 x 6
PCB-CHAZUO_92 x 6
GE_27 x 6
金属舵盘（驱动） x 6
金属舵盘（从动） x 5
WaveShare_Mounting_Plate_SO101
