KartikMehta-1/AMR-development/CAD/4 Boughtouts/amass-xt60e1-m-1/Amass XT60E1-M v4.stl

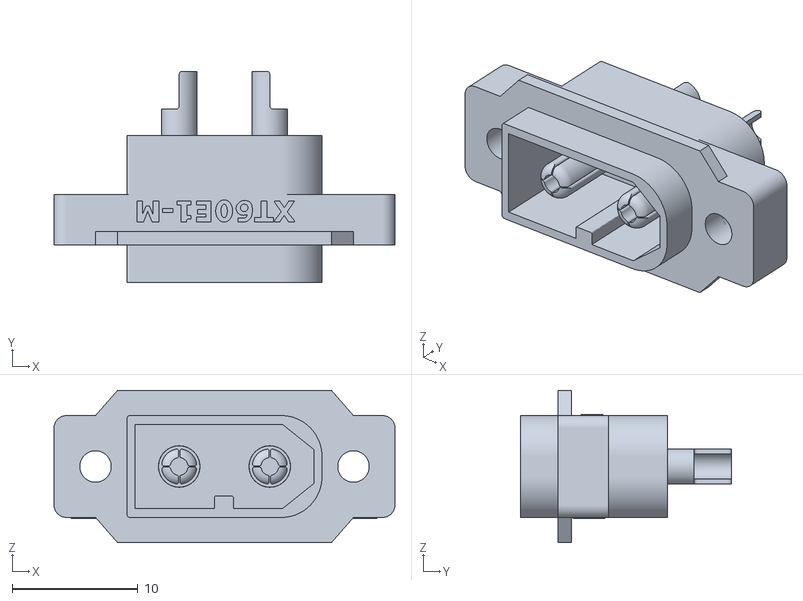
[picture p33: CAD file, 2025-12-11]
CAD/4 Boughtouts/amass-xt60e1-m-1/Amass XT60E1-M v4.stl
27.1 x 16.8 x 12.1
