KartikMehta-1/AMR-development/CAD/4 Boughtouts/electrical-part-fuse-holder/Fuse Holder - CONQUER CQ-201N_.stp

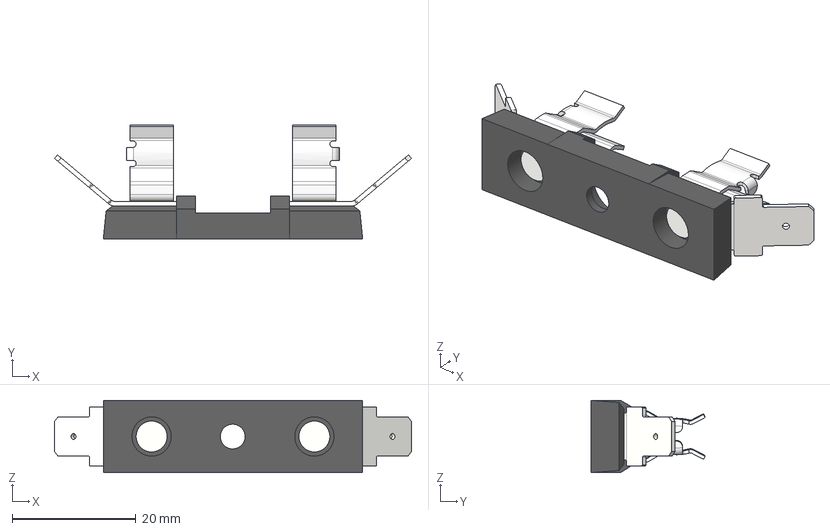
[picture p34: CAD file, 2025-12-11]
CAD/4 Boughtouts/electrical-part-fuse-holder/Fuse Holder - CONQUER CQ-201N_.stp
57.7 x 18.5 x 11.7 mm
Fuse Holder Base
Fuse Holder Terminal End Plate x 2
Fuse Holder Clamp x 2
Fuse Holder Pin x 2
