KartikMehta-1/AMR-development/CAD/4 Boughtouts/emergency-stop-push-button-switches-ab6-v-series-16mm-1/AB6-V.STEP

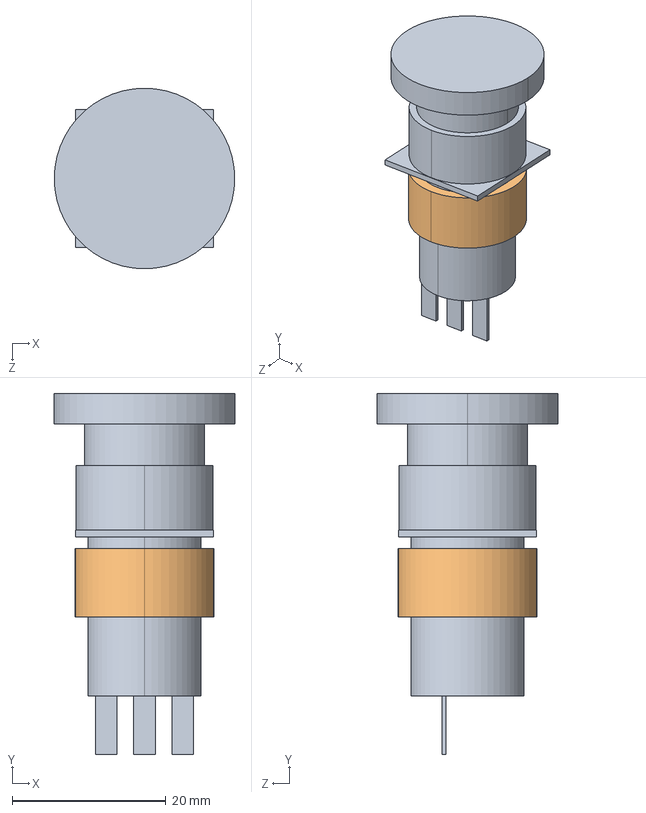
[picture p35: CAD file, 2025-12-11]
CAD/4 Boughtouts/emergency-stop-push-button-switches-ab6-v-series-16mm-1/AB6-V.STEP
23.5 x 47.0 x 23.5 mm
