KartikMehta-1/AMR-development/CAD/4 Boughtouts/hc-sr04-ultrasonic-sensor-12/Ultrasonic sensor.step

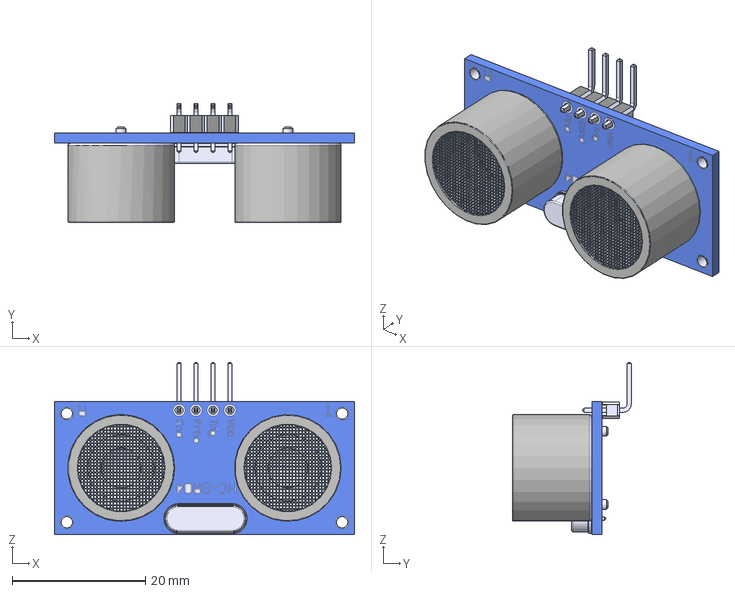
[picture p36: CAD file, 2025-12-11]
CAD/4 Boughtouts/hc-sr04-ultrasonic-sensor-12/Ultrasonic sensor.step
45.0 x 17.8 x 25.8 mm
