KartikMehta-1/AMR-development/CAD/4 Boughtouts/intel-realsense-d455-mount-1/Blocco D455.stp

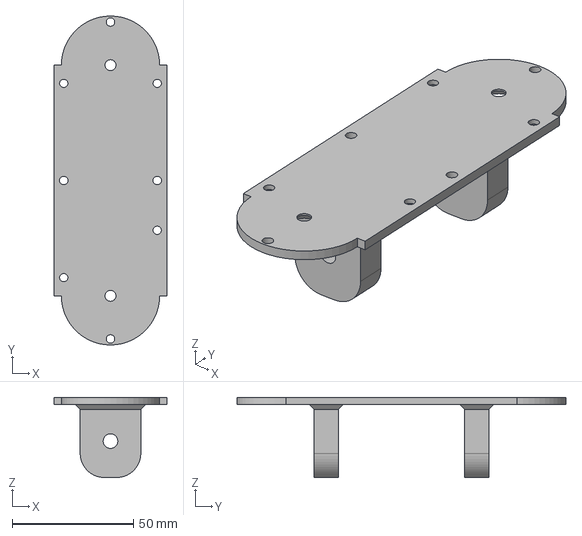
[picture p37: CAD file, 2025-12-02]
CAD/4 Boughtouts/intel-realsense-d455-mount-1/Blocco D455.stp
46.5 x 135.5 x 33.0 mm
