KartikMehta-1/AMR-development/CAD/4 Boughtouts/intel-realsense-depth-camera-d455/INTEL REALSENSE  DEPTH CAMERA D455/INTEL REALSENSE  DEPTH CAMERA D455.step

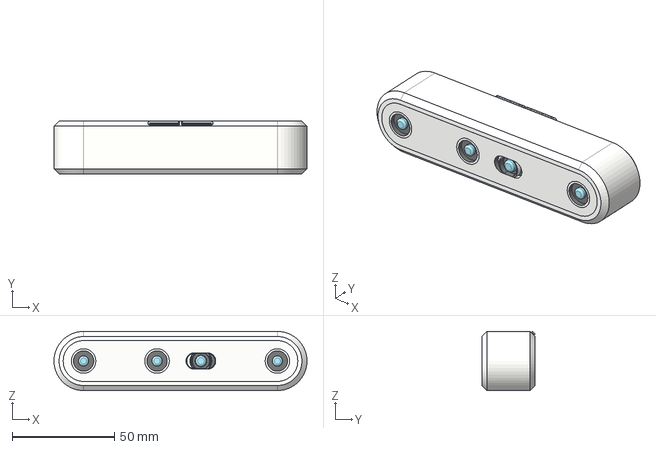
[picture p38: CAD file, 2025-11-30]
CAD/4 Boughtouts/intel-realsense-depth-camera-d455/INTEL REALSENSE DEPTH CAMERA D455/INTEL REALSENSE DEPTH CAMERA D455.step
124.0 x 26.0 x 29.0 mm
