KartikMehta-1/AMR-development/CAD/4 Boughtouts/MDD20A CAD/MDD20A.STEP

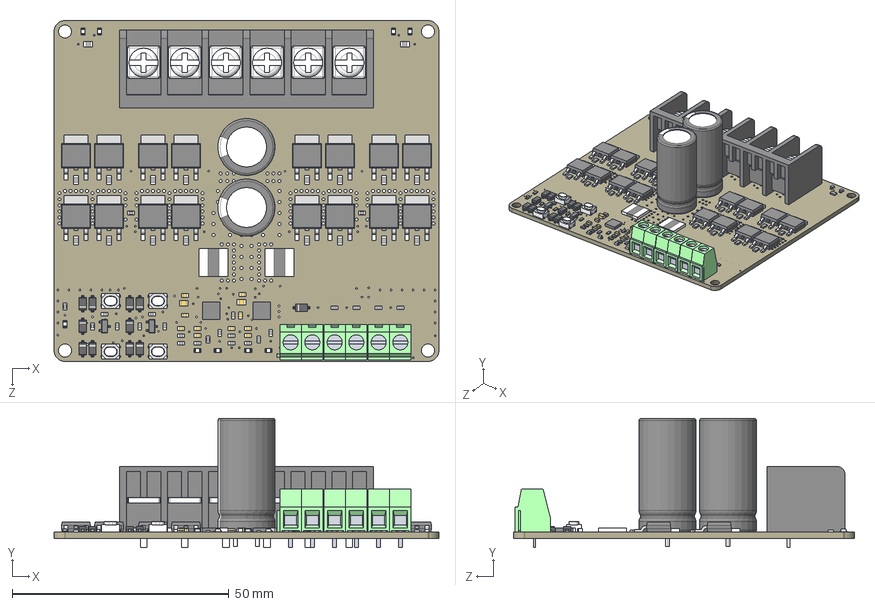
[picture p40: CAD file, 2025-11-23]
CAD/4 Boughtouts/MDD20A CAD/MDD20A.STEP
88.9 x 29.9 x 78.7 mm
Board
TERMINAL-HB9500-06
TERMINAL-KF127-3P-b_Green x 3
TERMINAL-KF127-3P-a_Green x 3
DPAK x 16
QFN-24 x 2
SOT-23 x 2
C1608 x 10
R1608 x 24
C2012 x 2
R2012 x 18
R6865 x 2
D-SOD-123 x 11
ECAP-13MM-TH x 2
LED-1608 x 9
SW-PB-KAN3246 x 4
