KartikMehta-1/AMR-development/CAD/4 Boughtouts/mini-toggle-switches-1/6mm SPDT Mini Toggle Switch.step

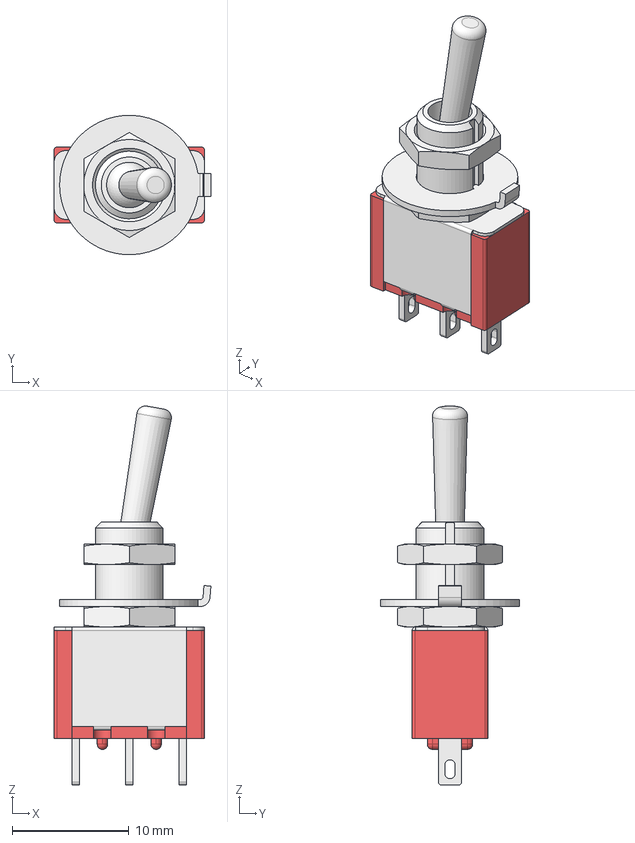
[picture p41: CAD file, 2025-12-11]
CAD/4 Boughtouts/mini-toggle-switches-1/6mm SPDT Mini Toggle Switch.step
13.4 x 11.9 x 32.5 mm
