KartikMehta-1/AMR-development/CAD/4 Boughtouts/mini-toggle-switches-1/FreeCAD Files/Set.FCStd

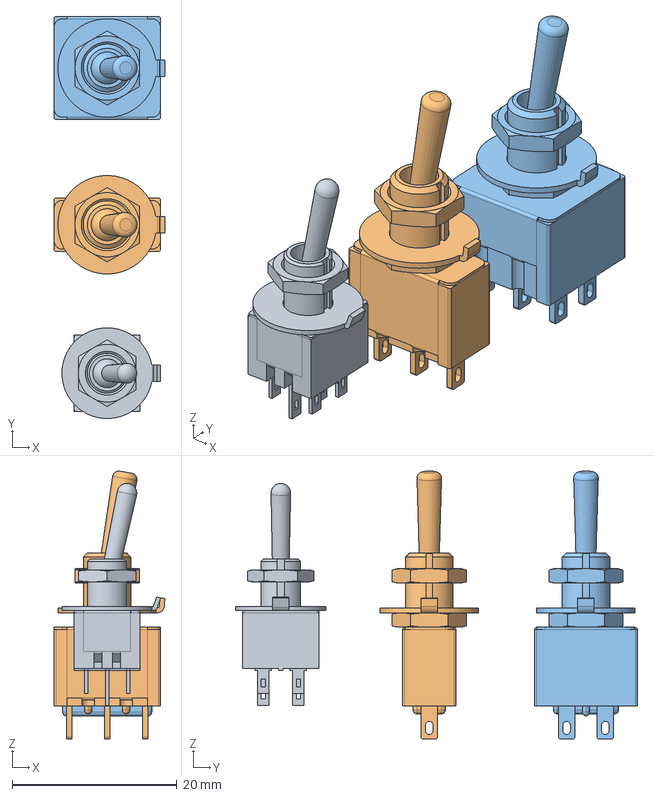
[picture p42: CAD file, 2025-12-11]
CAD/4 Boughtouts/mini-toggle-switches-1/FreeCAD Files/Set.FCStd
13.4 x 48.7 x 32.5 mm
5mm DPDT Mini Toggle Switch_001
6mm SPDT Mini Toggle Switch_001
6mm DPDT Mini Toggle Switch_001
