KartikMehta-1/AMR-development/CAD/4 Boughtouts/push-button-16-mm-led-1/LED_Button16mm/LED_Button_16mm.STEP

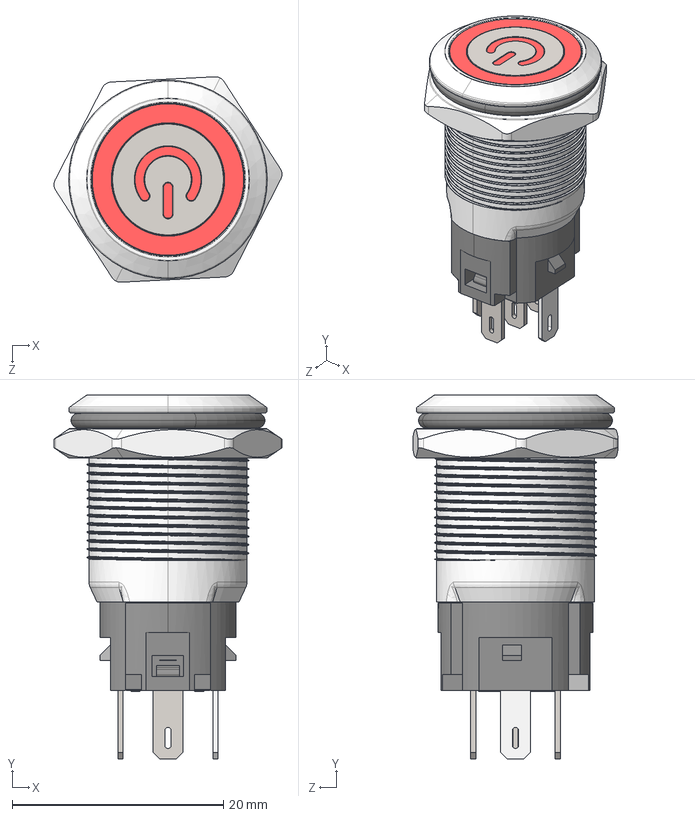
[picture p43: CAD file, 2025-12-11]
CAD/4 Boughtouts/push-button-16-mm-led-1/LED_Button16mm/LED_Button_16mm.STEP
21.6 x 34.5 x 19.5 mm
Thread
O-Ring
