KartikMehta-1/AMR-development/CAD/4 Boughtouts/terminal-block-for-button-d19-1/Button d19 terminal block.STEP

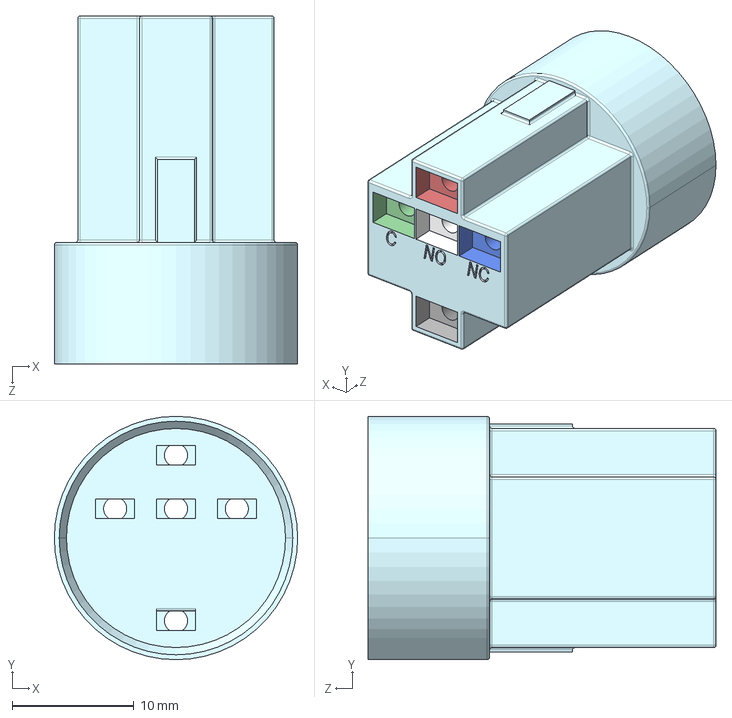
[picture p44: CAD file, 2025-12-11]
CAD/4 Boughtouts/terminal-block-for-button-d19-1/Button d19 terminal block.STEP
20.0 x 20.0 x 28.6 mm
