KartikMehta-1/AMR-development/CAD/4 Boughtouts/volt-meter-led-display-1/LED Display v3.step

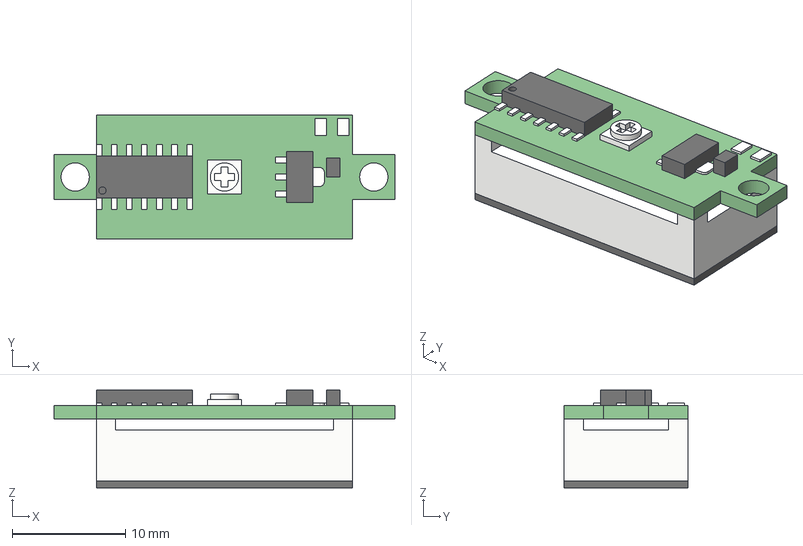
[picture p45: CAD file, 2025-12-11]
CAD/4 Boughtouts/volt-meter-led-display-1/LED Display v3.step
30.2 x 11.0 x 8.63 mm
