KartikMehta-1/AMR-development/CAD/4 Boughtouts/xh-m401-buck-converter/XH-M401 Buck converter (XL4016E1).step

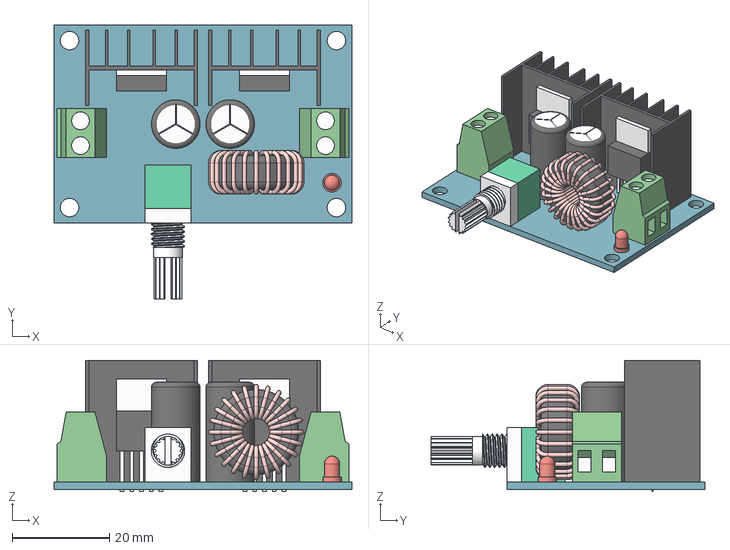
[picture p46: CAD file, 2025-11-30]
CAD/4 Boughtouts/xh-m401-buck-converter/XH-M401 Buck converter (XL4016E1).step
61.3 x 56.4 x 27.0 mm
