KartikMehta-1/AMR-development/CAD/4 Boughtouts/xt60-female-connector-1/XT60_Hembra.STEP

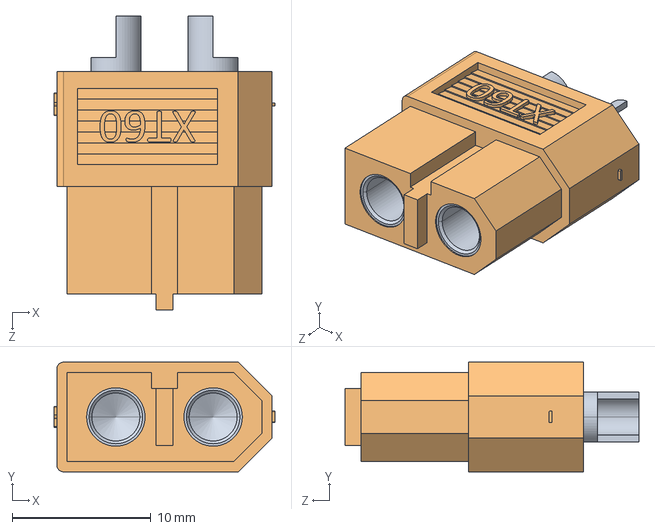
[picture p47: CAD file, 2025-12-11]
CAD/4 Boughtouts/xt60-female-connector-1/XT60_Hembra.STEP
15.9 x 7.90 x 21.1 mm
