KartikMehta-1/AMR-development/CAD/5 3D_print/Frame_member.stp

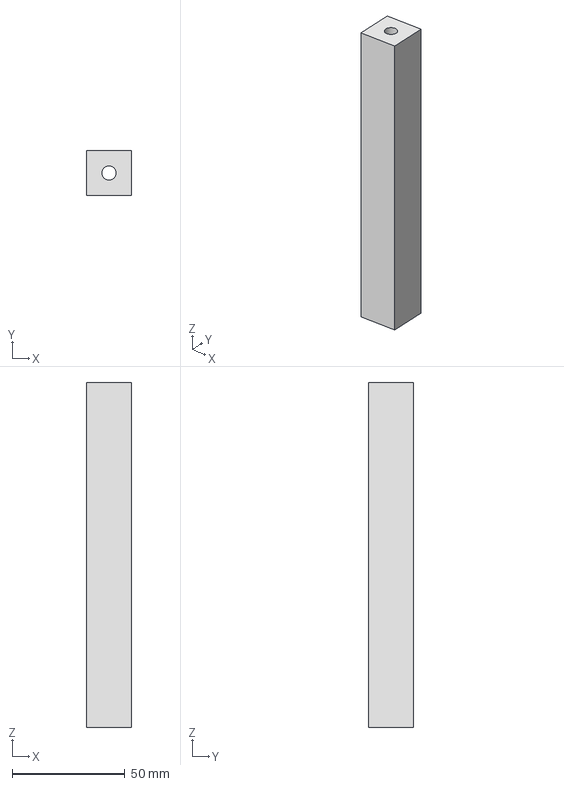
[picture p48: CAD file, 2026-04-11]
CAD/5 3D_print/Frame_member.stp
20.0 x 20.0 x 153.0 mm
