KartikMehta-1/AMR-development/CAD/6 Exports/STEP/SO100/Follower_Specific/Moving_Jaw_08d v1.step

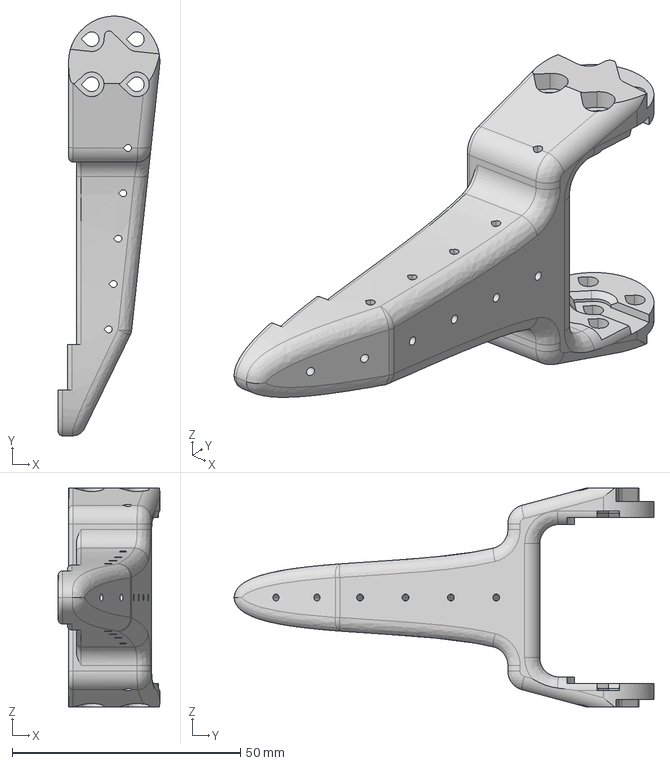
[picture p49: CAD file, 2025-11-23]
CAD/6 Exports/STEP/SO100/Follower_Specific/Moving_Jaw_08d v1.step
22.3 x 92.0 x 48.0 mm
