KartikMehta-1/AMR-development/CAD/6 Exports/STEP/SO100/Wrist_Roll_Pitch_08i.step

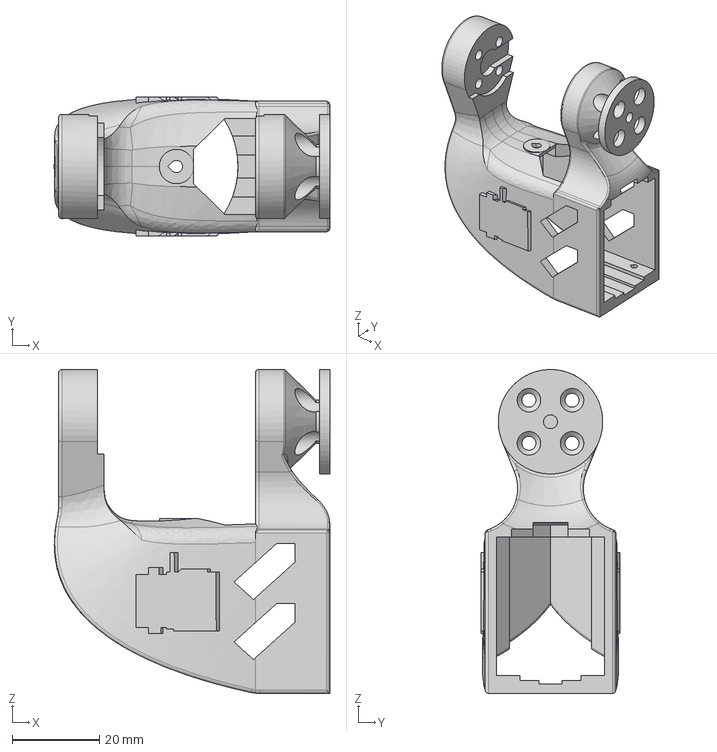
[picture p50: CAD file, 2025-11-23]
CAD/6 Exports/STEP/SO100/Wrist_Roll_Pitch_08i.step
63.3 x 32.0 x 74.4 mm
