KartikMehta-1/AMR-development/CAD/6 Exports/STEP/SO101/Follower_Specific/Moving_Jaw_SO101.step

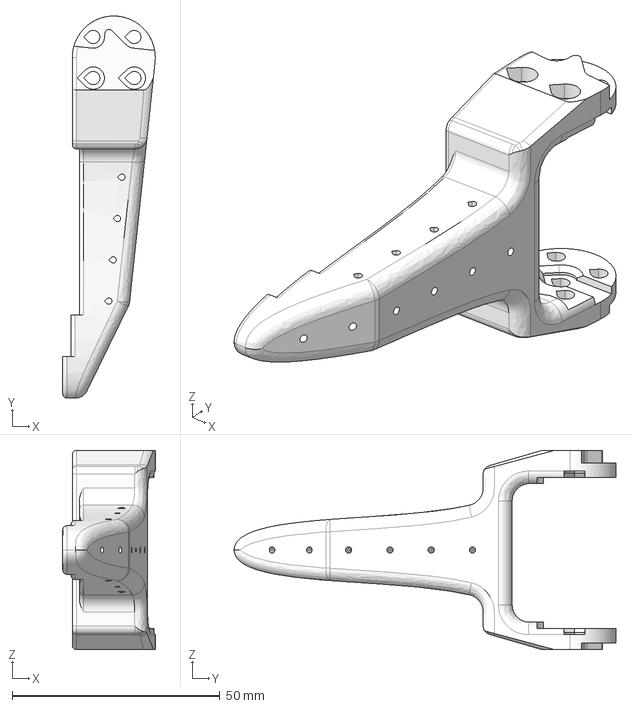
[picture p51: CAD file, 2025-11-23]
CAD/6 Exports/STEP/SO101/Follower_Specific/Moving_Jaw_SO101.step
22.3 x 92.0 x 48.0 mm
