KartikMehta-1/AMR-development/CAD/6 Exports/STEP/SO101/Leader_Specific/Handle_SO101.step

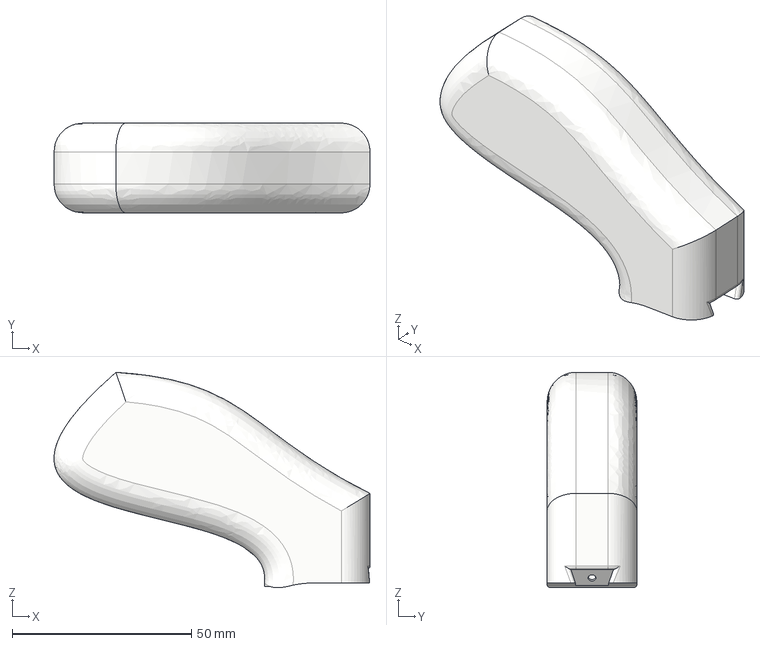
[picture p52: CAD file, 2025-11-23]
CAD/6 Exports/STEP/SO101/Leader_Specific/Handle_SO101.step
88.1 x 25.0 x 60.1 mm
