KartikMehta-1/AMR-development/CAD/6 Exports/STEP/SO101/Motor_holder_SO101_Wrist.step

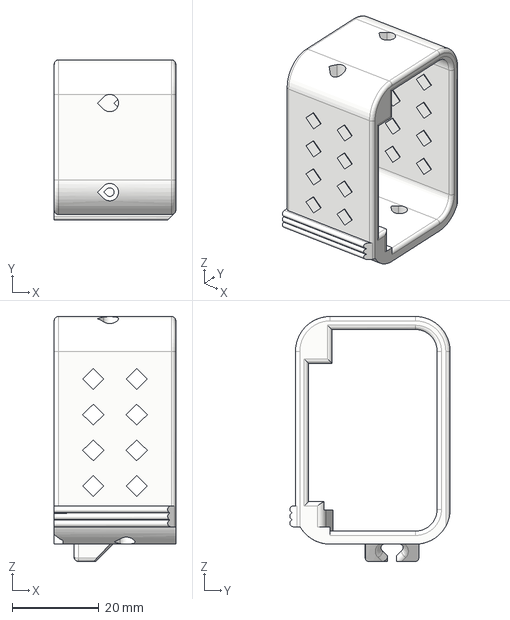
[picture p53: CAD file, 2025-11-23]
CAD/6 Exports/STEP/SO101/Motor_holder_SO101_Wrist.step
28.0 x 36.9 x 56.4 mm
Wiring_holder v1
Wiring_holder v1 (1)
