KartikMehta-1/AMR-development/CAD/6 Exports/STL/Gauges/Lego_Size_Test_02_zero.STL

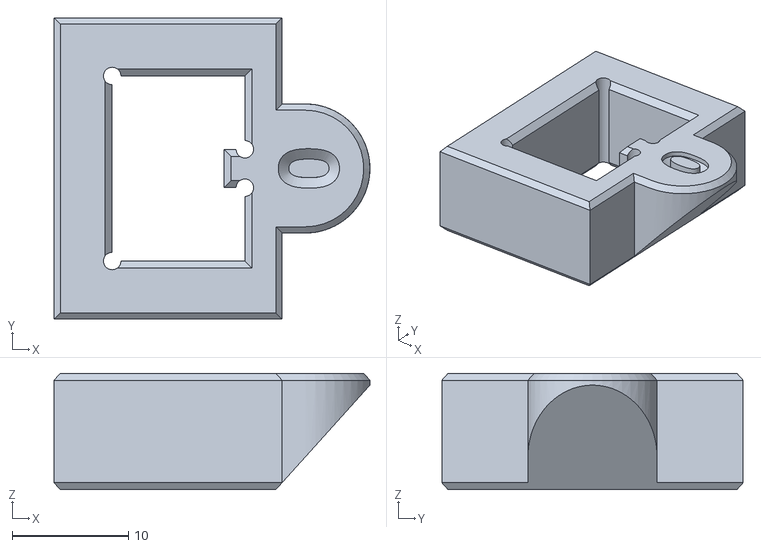
[picture p54: CAD file, 2025-11-23]
CAD/6 Exports/STL/Gauges/Lego_Size_Test_02_zero.STL
27.1 x 25.9 x 10.0
