KartikMehta-1/AMR-development/CAD/6 Exports/STL/SO100/Follower/Print_Follower_SO_ARM100_08k_UP_BambuLabA1Mini_part1.STL

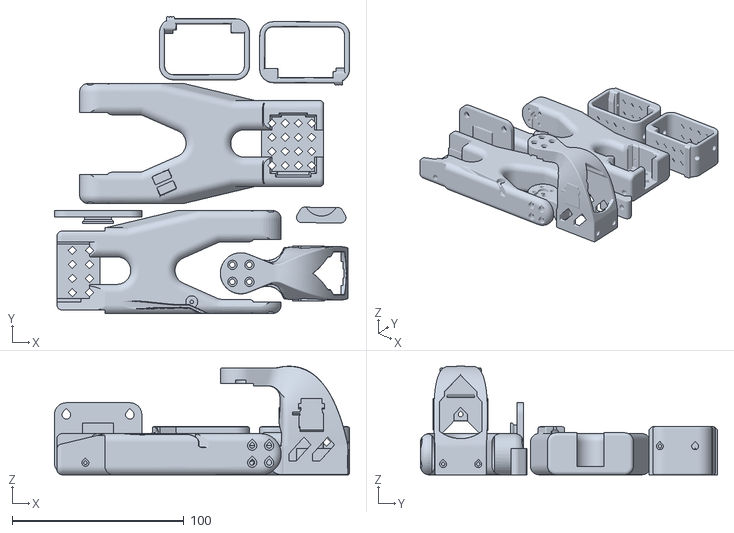
[picture p55: CAD file, 2025-11-23]
CAD/6 Exports/STL/SO100/Follower/Print_Follower_SO_ARM100_08k_UP_BambuLabA1Mini_part1.STL
172.1 x 173.0 x 63.3
