KartikMehta-1/AMR-development/CAD/6 Exports/STL/SO100/Individual/Follower/Print_Follower_SO_ARM100_08k_UP_Prusa - WaveShare_Mounting_Plate_01d-3.STL

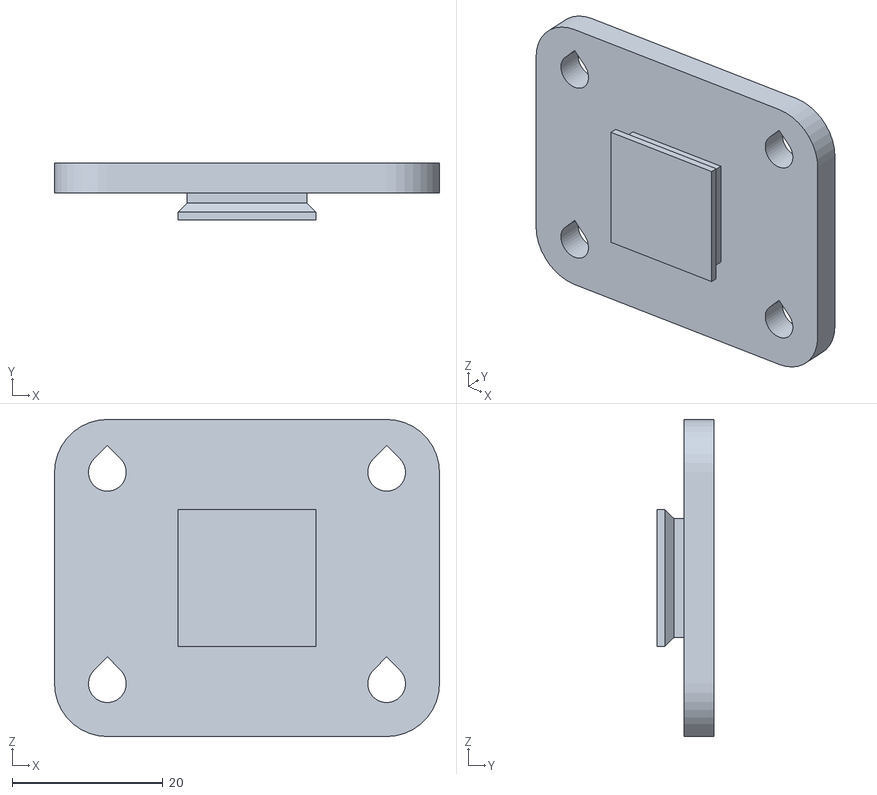
[picture p56: CAD file, 2025-11-23]
CAD/6 Exports/STL/SO100/Individual/Follower/Print_Follower_SO_ARM100_08k_UP_Prusa - WaveShare_Mounting_Plate_01d-3.STL
51.0 x 7.60 x 42.0
