KartikMehta-1/AMR-development/CAD/6 Exports/STL/SO100/Individual/Leader/Print_Leader_SO_ARM100_08k_UP_Prusa - Trigger_04e-1.STL

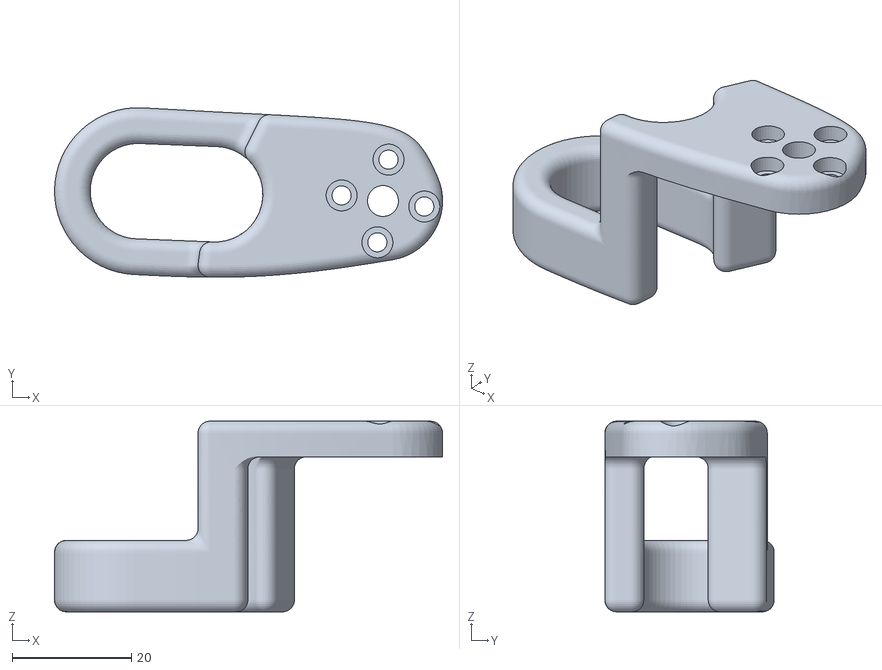
[picture p57: CAD file, 2025-11-23]
CAD/6 Exports/STL/SO100/Individual/Leader/Print_Leader_SO_ARM100_08k_UP_Prusa - Trigger_04e-1.STL
65.1 x 28.4 x 32.0
