KartikMehta-1/AMR-development/CAD/6 Exports/STL/SO100/Leader/Print_Leader_SO_ARM100_08k_Ender.STL

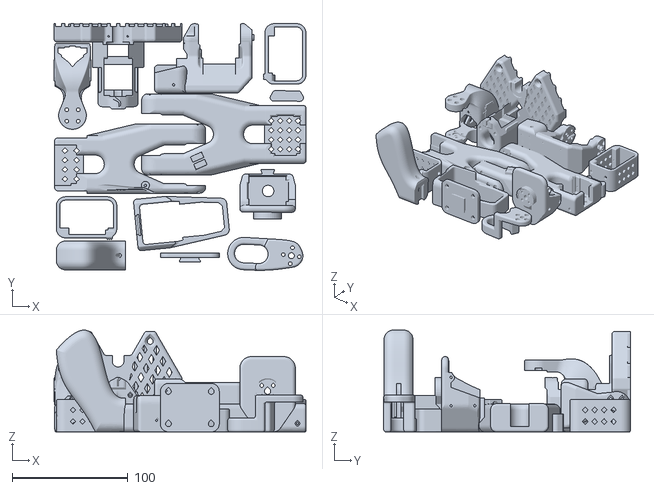
[picture p58: CAD file, 2025-11-23]
CAD/6 Exports/STL/SO100/Leader/Print_Leader_SO_ARM100_08k_Ender.STL
218.0 x 213.4 x 88.1
