KartikMehta-1/AMR-development/CAD/6 Exports/STL/SO101/Follower/Prusa_Follower_SO101.stl

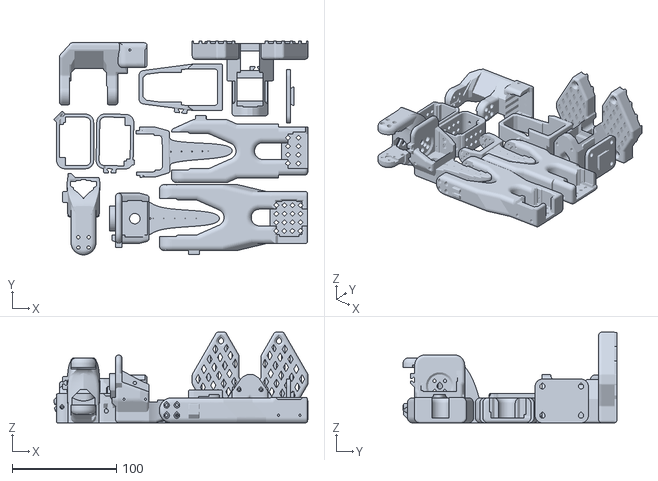
[picture p59: CAD file, 2025-11-23]
CAD/6 Exports/STL/SO101/Follower/Prusa_Follower_SO101.stl
243.4 x 204.9 x 87.0
