KartikMehta-1/AMR-development/CAD/6 Exports/STL/SO101/Individual/Trigger_SO101.stl

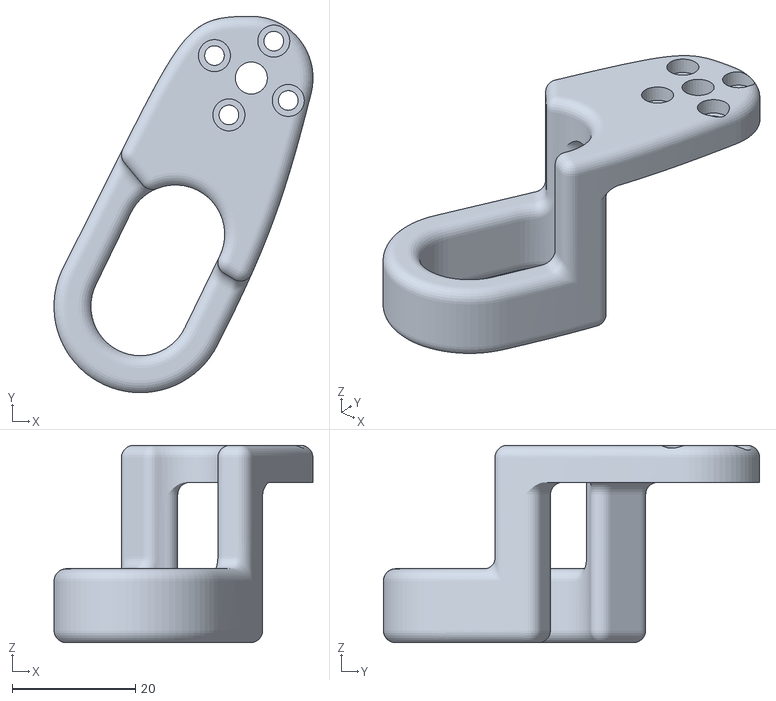
[picture p60: CAD file, 2025-11-23]
CAD/6 Exports/STL/SO101/Individual/Trigger_SO101.stl
42.0 x 61.0 x 32.0
