KartikMehta-1/AMR-development/CAD/6 Exports/STL/SO101/Leader/Prusa_Leader_SO101.stl

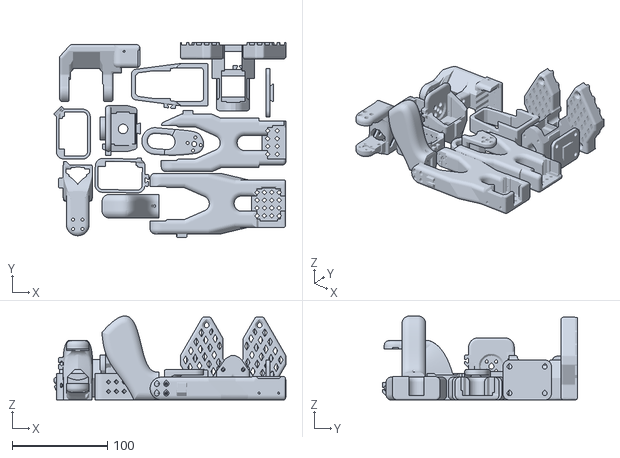
[picture p61: CAD file, 2025-11-23]
CAD/6 Exports/STL/SO101/Leader/Prusa_Leader_SO101.stl
243.4 x 204.7 x 88.1
