KartikMehta-1/AMR-development/ros_ws/src/amr_description/meshes/so101/assets/base_so101_v2.stl

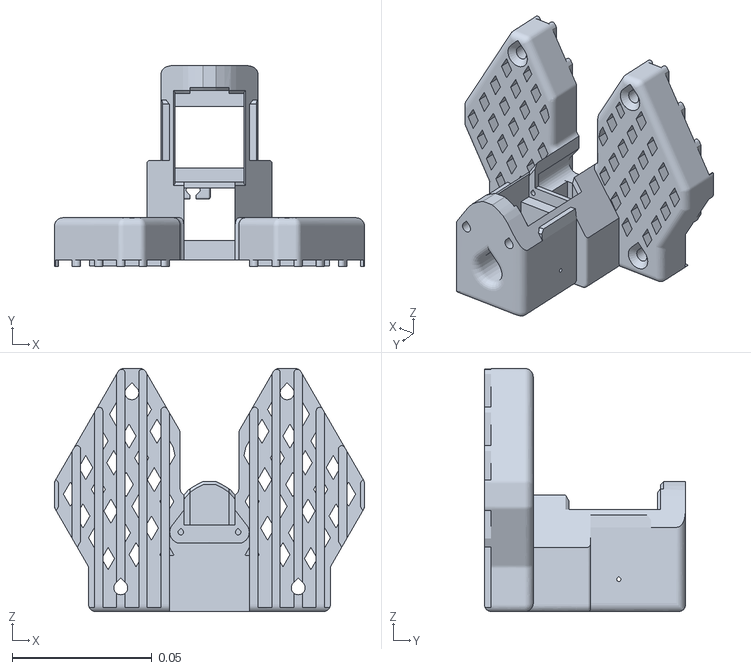
[picture p62: CAD file, 2026-06-02]
ros_ws/src/amr_description/meshes/so101/assets/base_so101_v2.stl
0.111 x 0.072 x 0.087
