KartikMehta-1/AMR-development/CAD/4 Boughtouts/intel-realsense-d455-mount-1/stand.stp

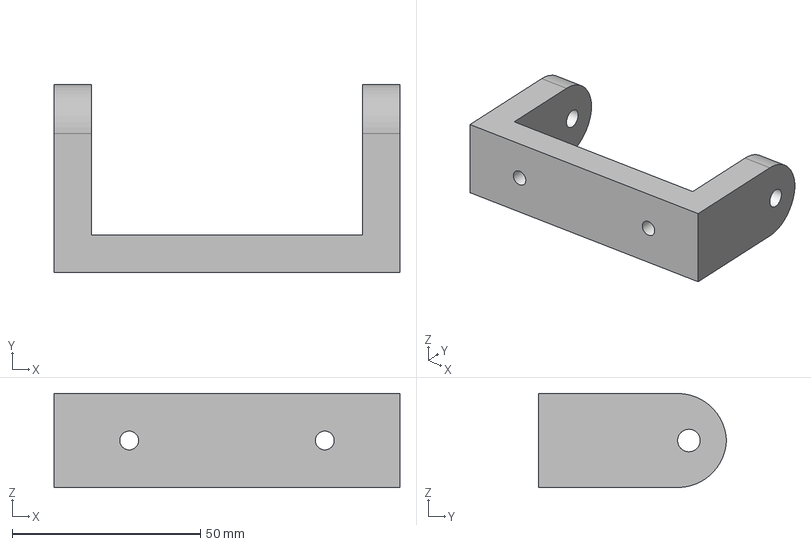
[picture p63: CAD file, 2025-12-02]
CAD/4 Boughtouts/intel-realsense-d455-mount-1/stand.stp
92.0 x 50.0 x 25.0 mm
