KartikMehta-1/AMR-development/CAD/4 Boughtouts/push-button-16-mm-led-1/LED_Button16mm/Thread.SLDPRT

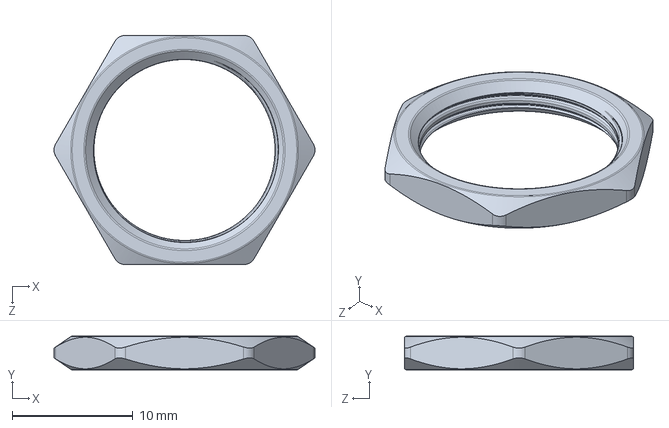
[picture p64: CAD file, 2025-12-11]
CAD/4 Boughtouts/push-button-16-mm-led-1/LED_Button16mm/Thread.SLDPRT
21.6 x 2.80 x 19.0 mm
