KartikMehta-1/AMR-development/CAD/5 3D_print/Enclosure cover.stp

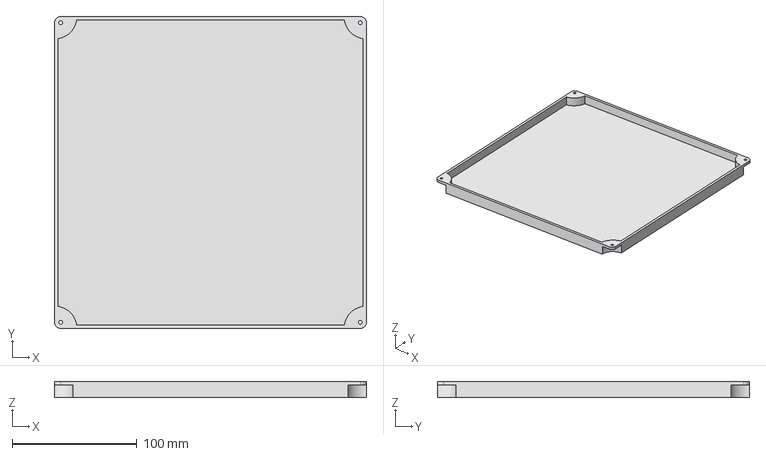
[picture p65: CAD file, 2026-04-11]
CAD/5 3D_print/Enclosure cover.stp
250.0 x 250.0 x 13.0 mm
