KartikMehta-1/AMR-development/CAD/6 Exports/STEP/SO100/Leader_Specific/Wrist_Roll_05m_Leader_02ba v1.step

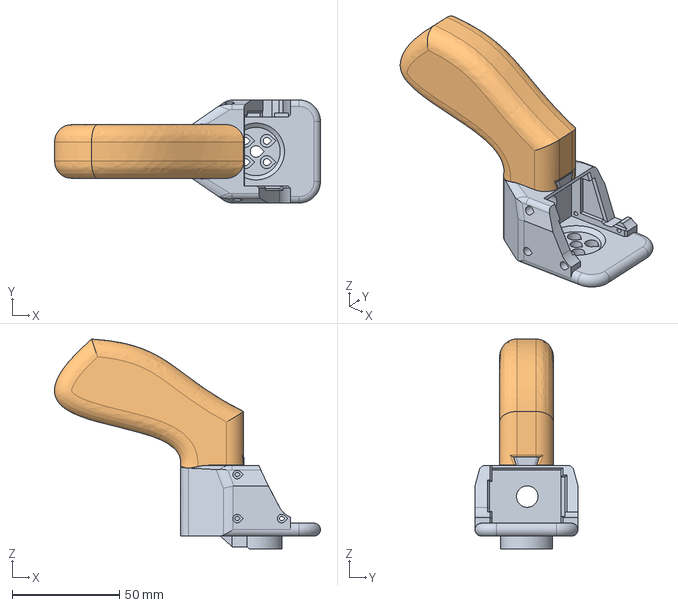
[picture p66: CAD file, 2025-11-23]
CAD/6 Exports/STEP/SO100/Leader_Specific/Wrist_Roll_05m_Leader_02ba v1.step
123.9 x 48.0 x 97.8 mm
