KartikMehta-1/AMR-development/CAD/6 Exports/STEP/SO101/Follower_Specific/Wrist_Roll_Follower_SO101.step

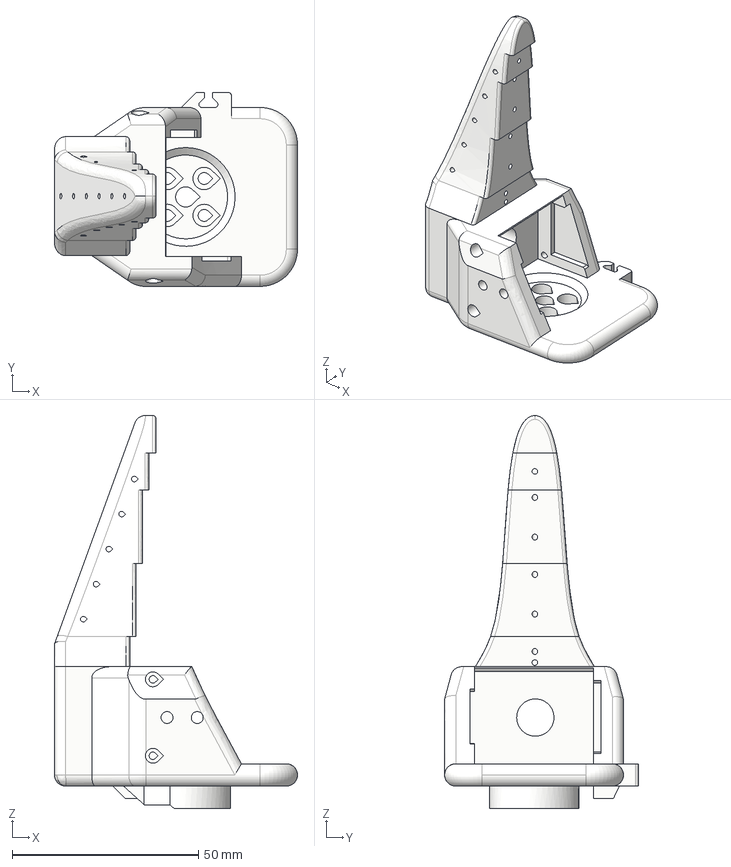
[picture p67: CAD file, 2025-11-23]
CAD/6 Exports/STEP/SO101/Follower_Specific/Wrist_Roll_Follower_SO101.step
65.2 x 52.0 x 105.4 mm
Wiring_holder v1
Wiring_holder v1 (1)
