KartikMehta-1/AMR-development/CAD/6 Exports/STEP/SO101/Leader_Specific/Wrist_Roll_SO101.step

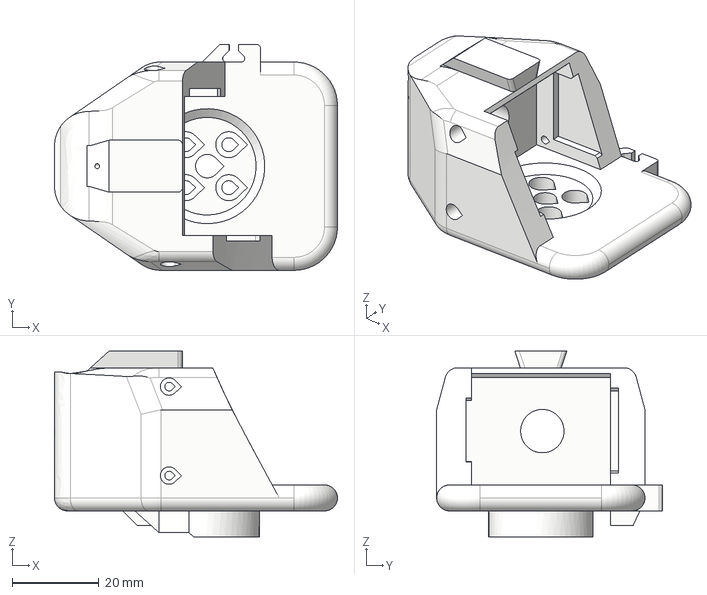
[picture p68: CAD file, 2025-11-23]
CAD/6 Exports/STEP/SO101/Leader_Specific/Wrist_Roll_SO101.step
65.2 x 52.0 x 42.9 mm
Wiring_holder v1
Wiring_holder v1 (1)
