KartikMehta-1/AMR-development/CAD/6 Exports/STEP/SO101/Motor_holder_SO101_Base.step

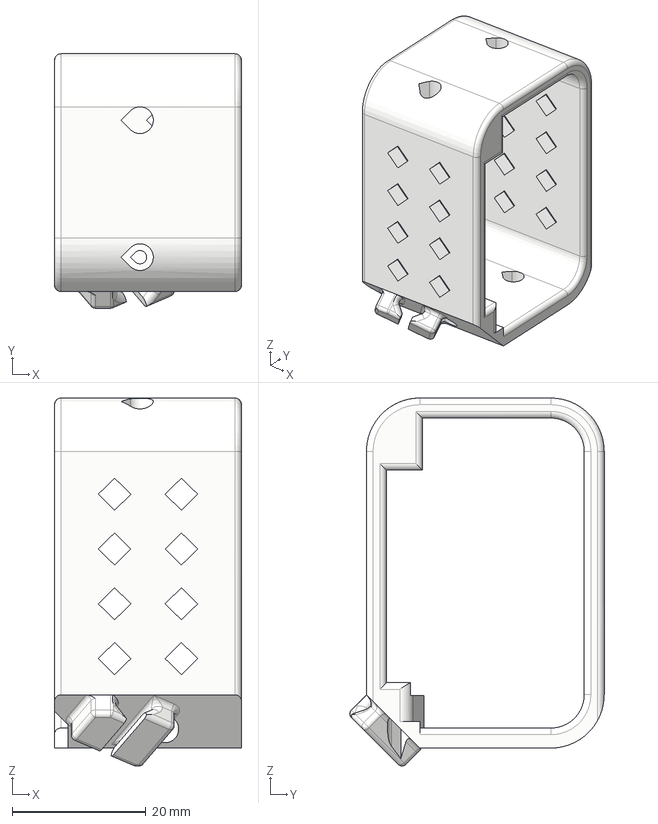
[picture p69: CAD file, 2025-11-23]
CAD/6 Exports/STEP/SO101/Motor_holder_SO101_Base.step
28.0 x 38.1 x 55.1 mm
Wiring_holder v1
Wiring_holder v1 (1)
Wiring_holder v1 (2)
