KartikMehta-1/AMR-development/CAD/6 Exports/STL/SO100/Follower/Print_Follower_SO_ARM100_08k_UP_BambuLabA1Mini_part2.STL

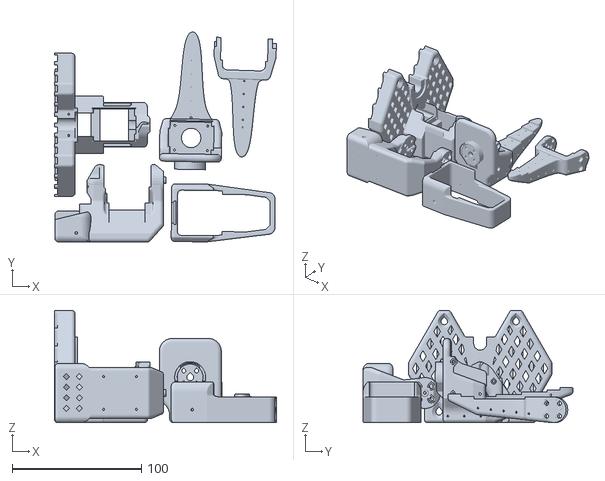
[picture p70: CAD file, 2025-11-23]
CAD/6 Exports/STL/SO100/Follower/Print_Follower_SO_ARM100_08k_UP_BambuLabA1Mini_part2.STL
171.8 x 162.4 x 87.0
