KartikMehta-1/AMR-development/CAD/6 Exports/STL/SO100/Individual/Follower/Print_Follower_SO_ARM100_08k_UP_Prusa - Base_08q-5.STL

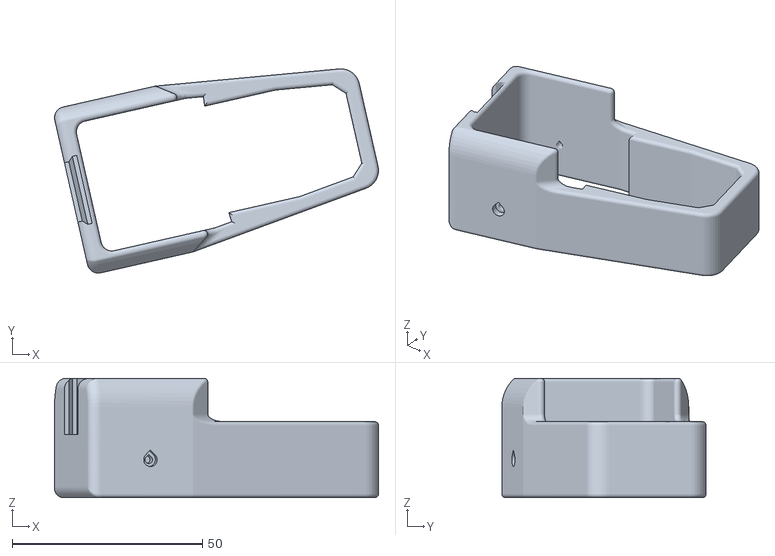
[picture p71: CAD file, 2025-11-23]
CAD/6 Exports/STL/SO100/Individual/Follower/Print_Follower_SO_ARM100_08k_UP_Prusa - Base_08q-5.STL
85.2 x 53.7 x 31.4
