KartikMehta-1/AMR-development/CAD/6 Exports/STL/SO100/Leader/Print_Leader_SO_ARM100_08k_UP_BambuLabA1Mini_part1.STL

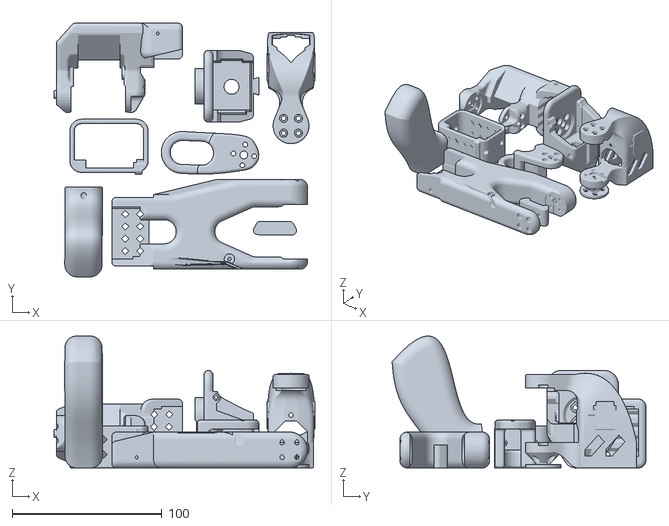
[picture p72: CAD file, 2025-11-23]
CAD/6 Exports/STL/SO100/Leader/Print_Leader_SO_ARM100_08k_UP_BambuLabA1Mini_part1.STL
174.4 x 169.5 x 88.1
