KartikMehta-1/AMR-development/CAD/6 Exports/STL/SO101/Individual/Upper_arm_SO101.stl

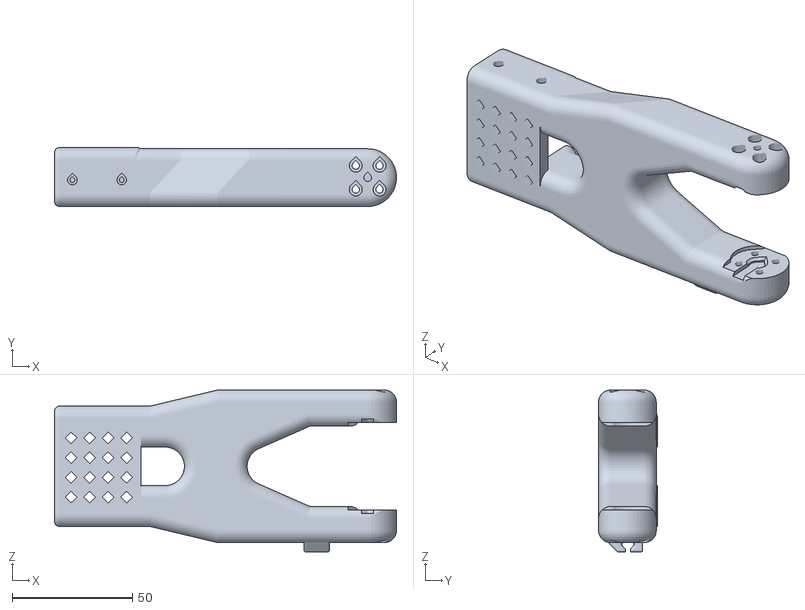
[picture p73: CAD file, 2025-11-23]
CAD/6 Exports/STL/SO101/Individual/Upper_arm_SO101.stl
142.1 x 24.5 x 67.3
