KartikMehta-1/AMR-development/CAD/4 Boughtouts/intel-realsense-d455-mount-1/Cover Telecamera.stp

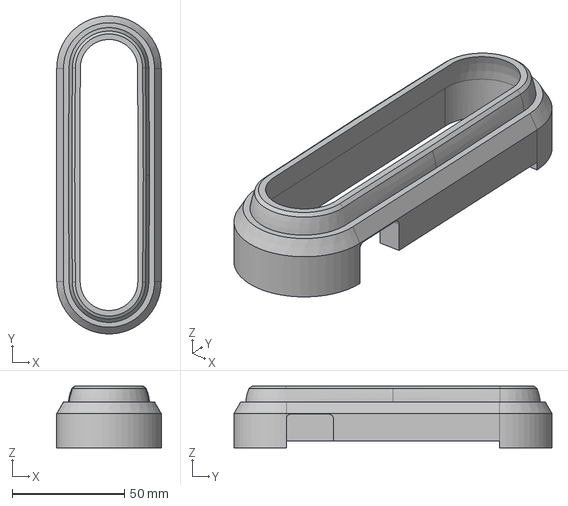
[picture p75: CAD file, 2025-12-02]
CAD/4 Boughtouts/intel-realsense-d455-mount-1/Cover Telecamera.stp
46.5 x 141.5 x 27.5 mm
