KartikMehta-1/AMR-development/CAD/4 Boughtouts/mini-toggle-switches-1/5mm DPDT Mini Toggle Switch.step

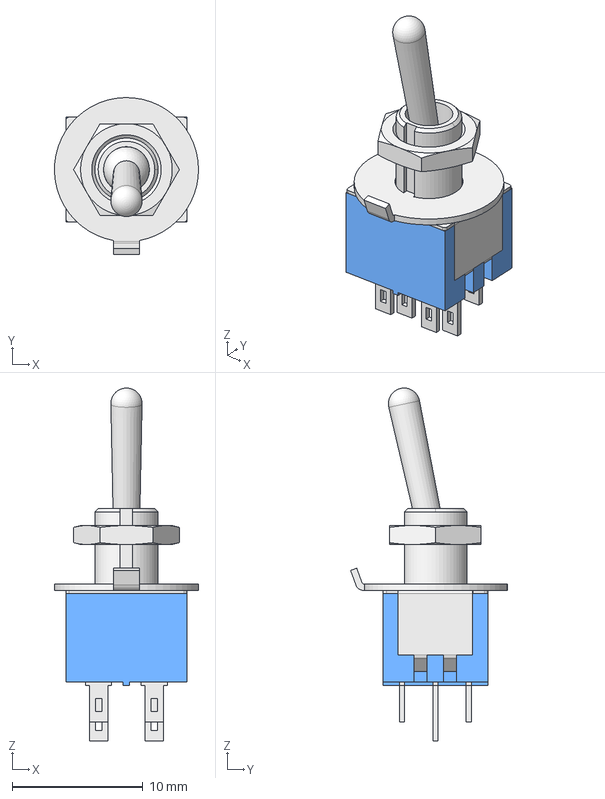
[picture p76: CAD file, 2025-12-11]
CAD/4 Boughtouts/mini-toggle-switches-1/5mm DPDT Mini Toggle Switch.step
11.0 x 12.0 x 26.9 mm
