KartikMehta-1/AMR-development/CAD/4 Boughtouts/push-button-16-mm-led-1/LED_Button16mm/Body.SLDPRT

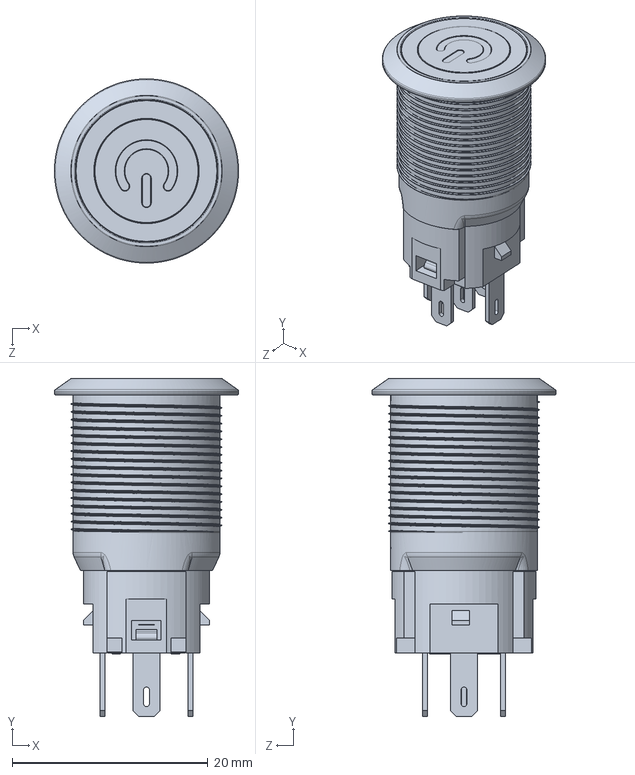
[picture p77: CAD file, 2025-12-11]
CAD/4 Boughtouts/push-button-16-mm-led-1/LED_Button16mm/Body.SLDPRT
18.8 x 34.5 x 18.8 mm
