KartikMehta-1/AMR-development/CAD/5 3D_print/sensor_cover_ultrasonic_2.stp

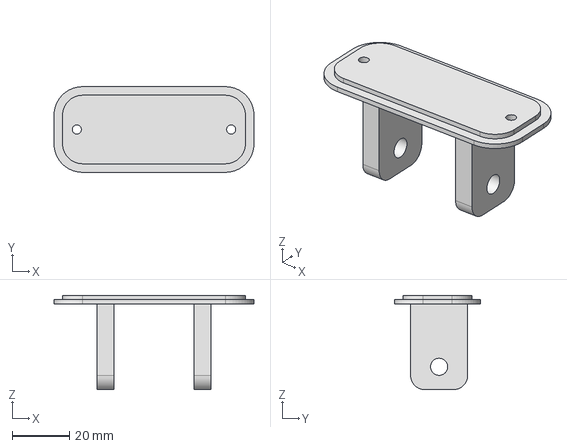
[picture p78: CAD file, 2026-04-11]
CAD/5 3D_print/sensor_cover_ultrasonic_2.stp
70.0 x 30.0 x 33.0 mm
