KartikMehta-1/AMR-development/CAD/6 Exports/STEP/SO100/Follower_Specific/Wrist_Roll_08c v1.step

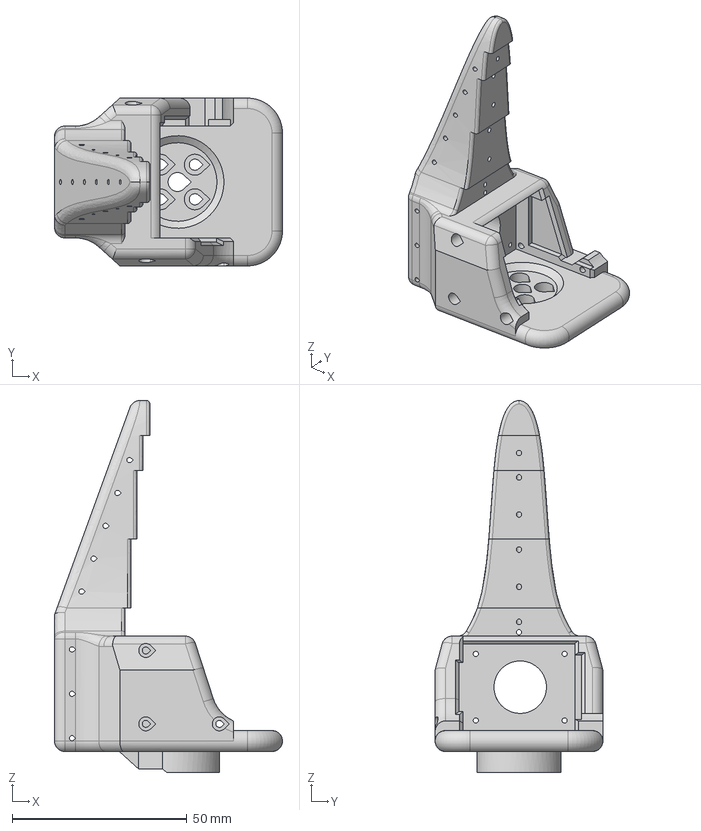
[picture p79: CAD file, 2025-11-23]
CAD/6 Exports/STEP/SO100/Follower_Specific/Wrist_Roll_08c v1.step
65.2 x 48.0 x 106.4 mm
