KartikMehta-1/AMR-development/CAD/6 Exports/STEP/SO100/SO_ARM100_08k.step

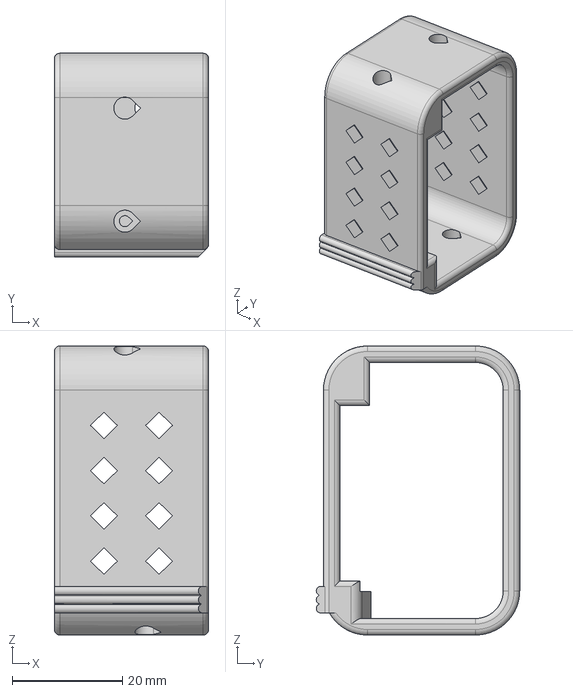
[picture p80: CAD file, 2025-11-23]
CAD/6 Exports/STEP/SO100/SO_ARM100_08k.step
28.0 x 36.9 x 52.4 mm
