KartikMehta-1/AMR-development/CAD/6 Exports/STL/Gauges/Gauge_tight_1.STL

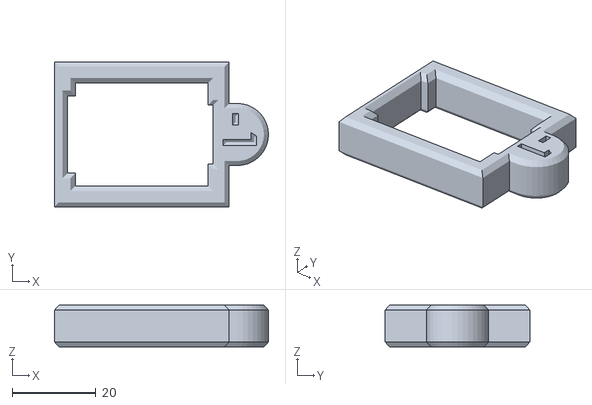
[picture p81: CAD file, 2025-11-23]
CAD/6 Exports/STL/Gauges/Gauge_tight_1.STL
51.1 x 34.6 x 10.0
