KartikMehta-1/AMR-development/CAD/6 Exports/STL/SO100/Follower/Print_Follower_SO_ARM100_08k_Ender.STL

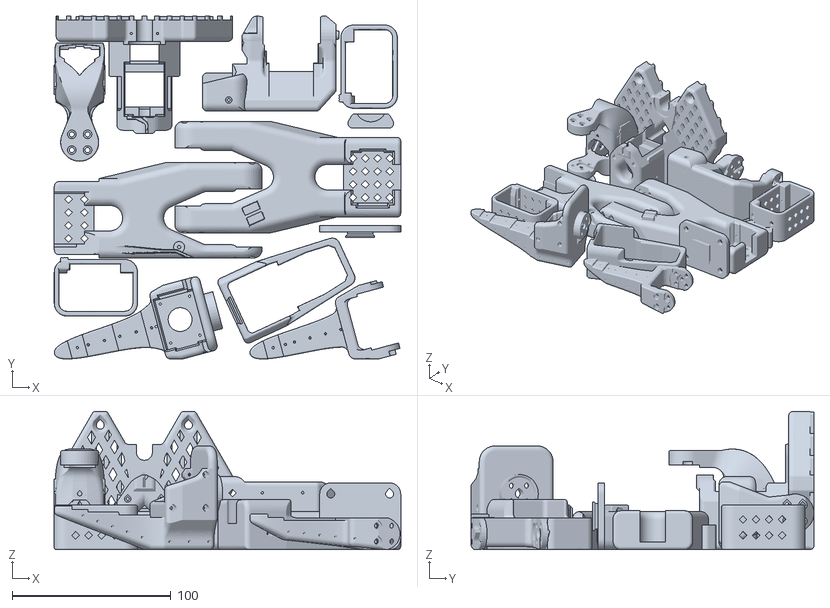
[picture p82: CAD file, 2025-11-23]
CAD/6 Exports/STL/SO100/Follower/Print_Follower_SO_ARM100_08k_Ender.STL
218.0 x 215.8 x 87.0
