KartikMehta-1/AMR-development/CAD/6 Exports/STL/SO100/Individual/Follower/Print_Follower_SO_ARM100_08k_UP_Prusa - Base_08q-3.STL

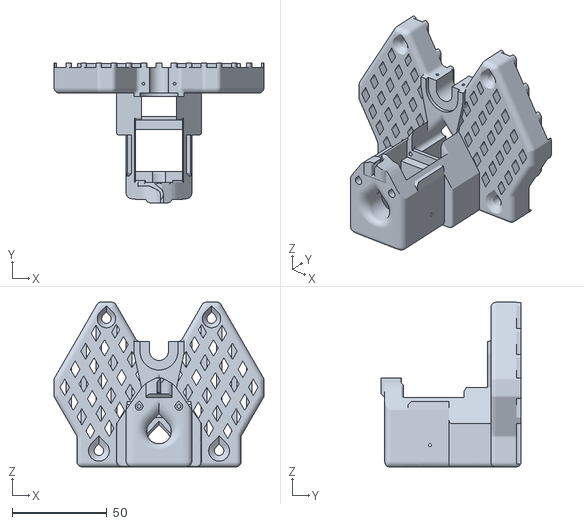
[picture p83: CAD file, 2025-11-23]
CAD/6 Exports/STL/SO100/Individual/Follower/Print_Follower_SO_ARM100_08k_UP_Prusa - Base_08q-3.STL
110.9 x 74.0 x 87.0
