KartikMehta-1/AMR-development/CAD/6 Exports/STL/SO100/Individual/Leader/Print_Leader_SO_ARM100_08k_UP_Prusa - Rotation_Pitch_08i-1.STL

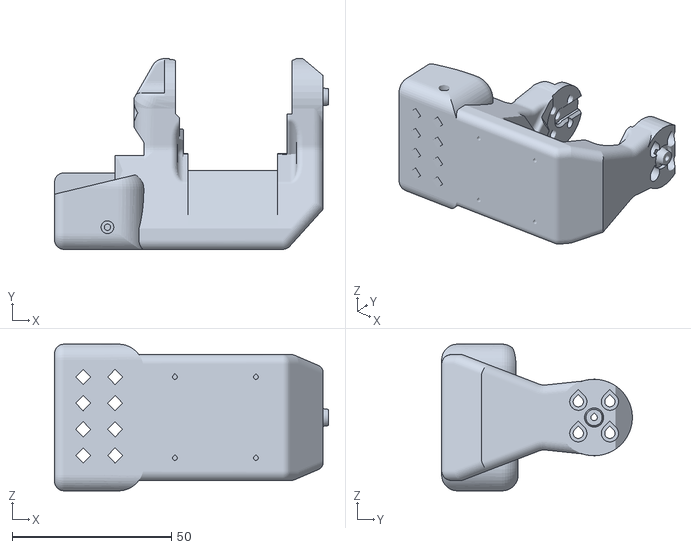
[picture p84: CAD file, 2025-11-23]
CAD/6 Exports/STL/SO100/Individual/Leader/Print_Leader_SO_ARM100_08k_UP_Prusa - Rotation_Pitch_08i-1.STL
85.9 x 59.8 x 46.0
