KartikMehta-1/AMR-development/CAD/6 Exports/STL/SO100/Leader/Print_Leader_SO_ARM100_08k_UP_BambuLabA1Mini_part2.STL

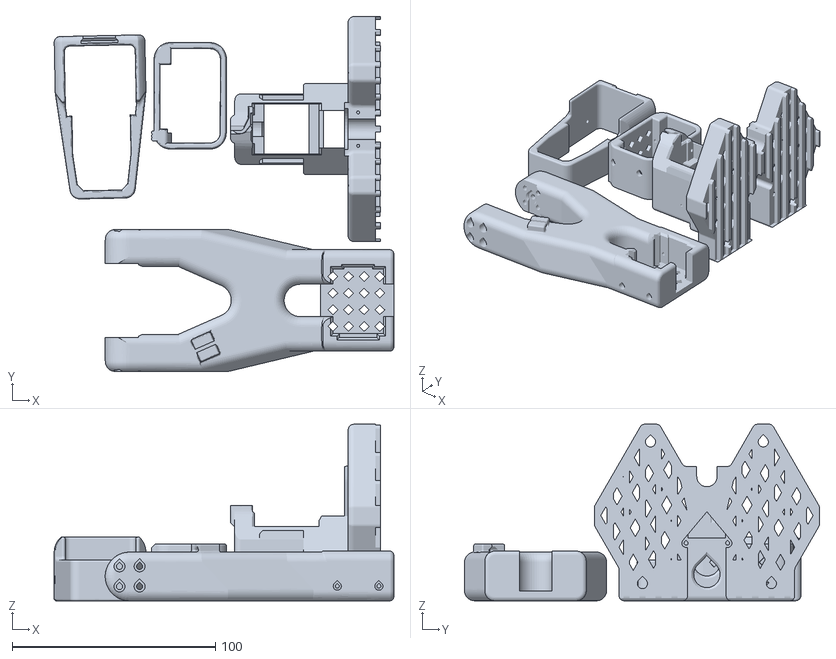
[picture p85: CAD file, 2025-11-23]
CAD/6 Exports/STL/SO100/Leader/Print_Leader_SO_ARM100_08k_UP_BambuLabA1Mini_part2.STL
167.3 x 174.9 x 87.0
