KartikMehta-1/AMR-development/CAD/6 Exports/STL/SO101/Individual/Wrist_Roll_Pitch_SO101.stl

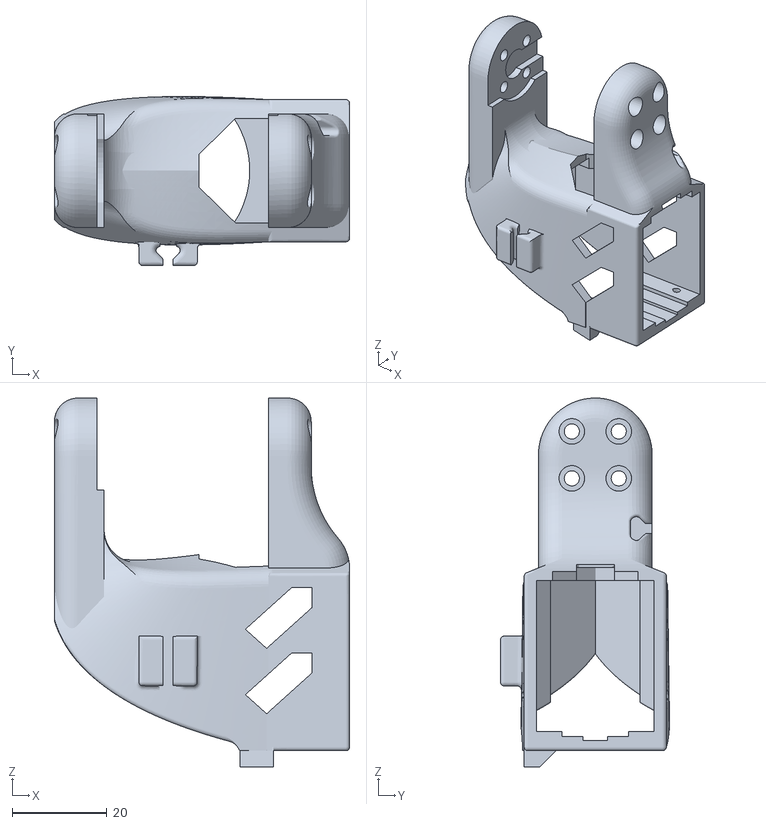
[picture p86: CAD file, 2025-11-23]
CAD/6 Exports/STL/SO101/Individual/Wrist_Roll_Pitch_SO101.stl
62.3 x 35.7 x 77.8
