KartikMehta-1/AMR-development/ros_ws/src/amr_description/meshes/so101/assets/waveshare_mounting_plate_so101_v2.stl

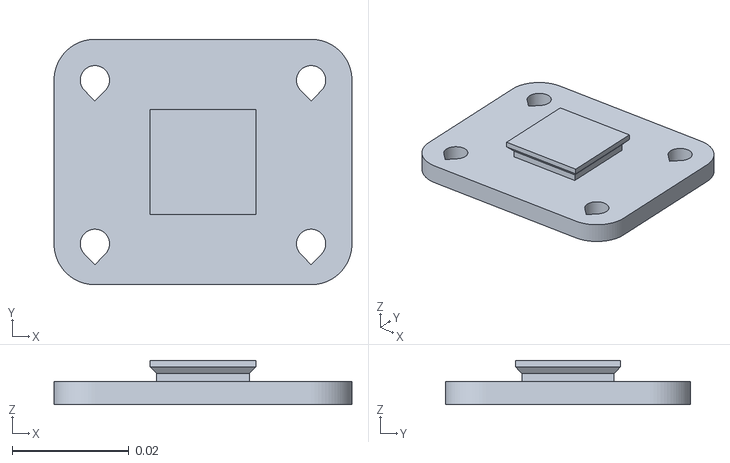
[picture p87: CAD file, 2026-06-02]
ros_ws/src/amr_description/meshes/so101/assets/waveshare_mounting_plate_so101_v2.stl
0.051 x 0.042 x 0.0076
