KartikMehta-1/AMR-development/CAD/4 Boughtouts/push-button-16-mm-led-1/LED_Button16mm/O-Ring.SLDPRT

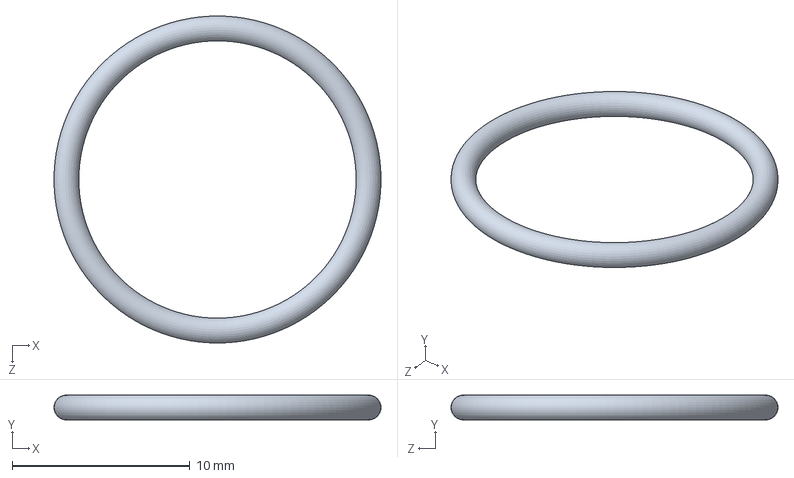
[picture p89: CAD file, 2025-12-11]
CAD/4 Boughtouts/push-button-16-mm-led-1/LED_Button16mm/O-Ring.SLDPRT
18.4 x 1.39 x 18.4 mm
