KartikMehta-1/AMR-development/CAD/5 3D_print/sensor_cover_ultrasonic_3.stp

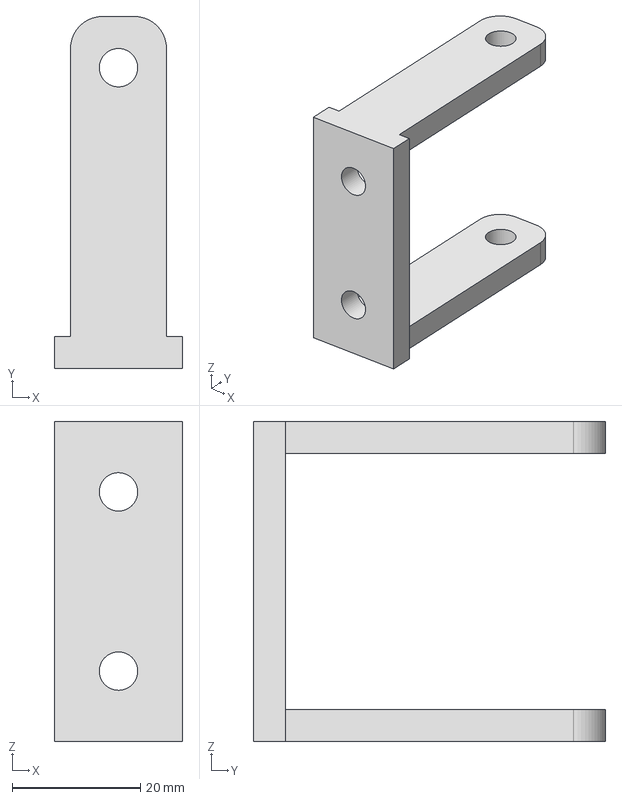
[picture p90: CAD file, 2026-04-11]
CAD/5 3D_print/sensor_cover_ultrasonic_3.stp
20.0 x 55.0 x 50.0 mm
