KartikMehta-1/AMR-development/CAD/6 Exports/STEP/SO100/Base_attachment.step

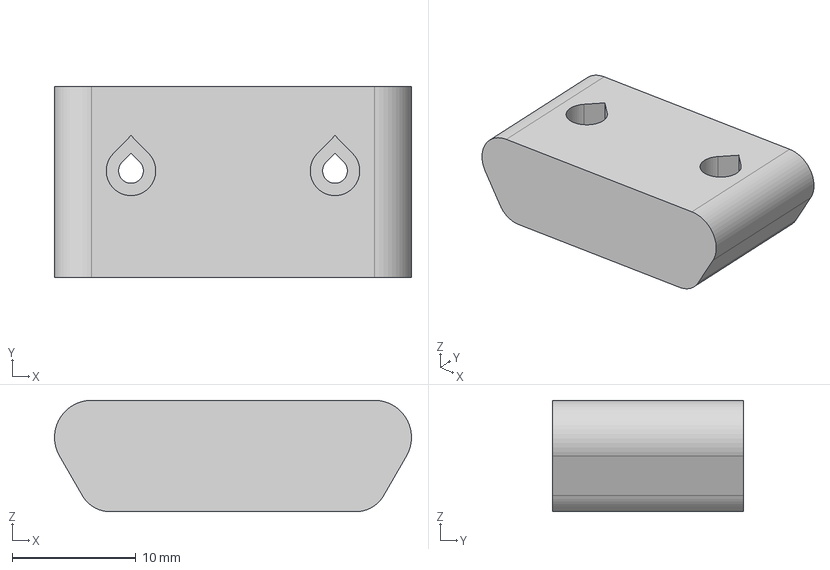
[picture p91: CAD file, 2025-11-23]
CAD/6 Exports/STEP/SO100/Base_attachment.step
28.8 x 15.4 x 9.00 mm
