KartikMehta-1/AMR-development/CAD/6 Exports/STEP/SO101/Seeedstudio_Mounting_Plate_SO101.step

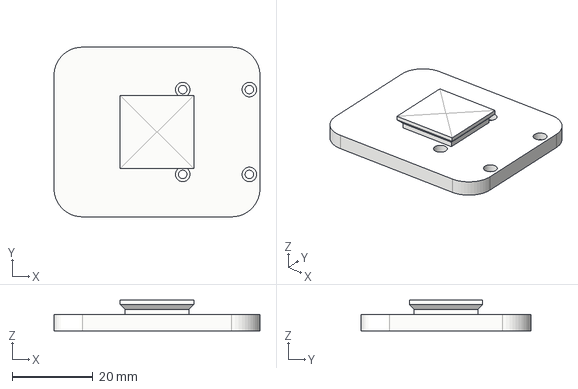
[picture p92: CAD file, 2025-11-23]
CAD/6 Exports/STEP/SO101/Seeedstudio_Mounting_Plate_SO101.step
51.0 x 42.0 x 7.60 mm
