KartikMehta-1/AMR-development/CAD/6 Exports/STL/SO100/Follower/Print_Follower_Bambu_P1P.3mf

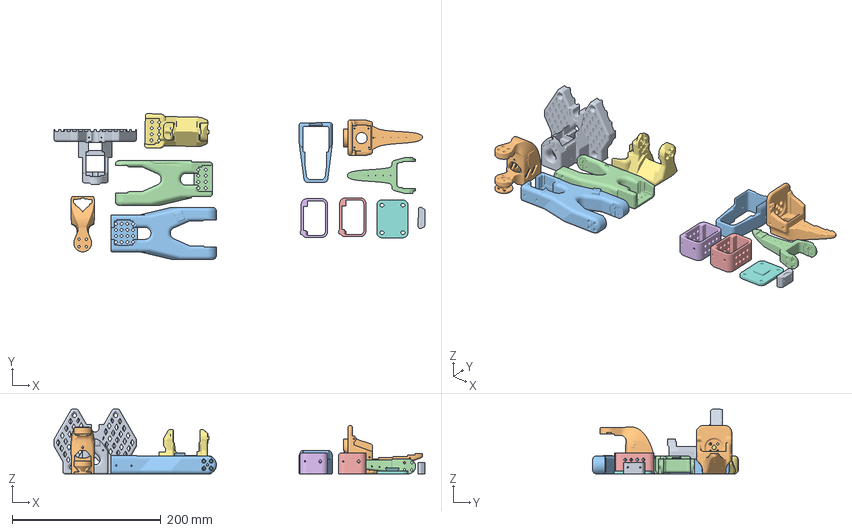
[picture p93: CAD file, 2025-11-23]
CAD/6 Exports/STL/SO100/Follower/Print_Follower_Bambu_P1P.3mf
499.2 x 196.1 x 87.0 mm
Print_Follower_SO_ARM100_08k_UP_Prusa - Base_08q-3.STL
Print_Follower_SO_ARM100_08k_UP_Prusa - Wrist_Roll_08c-1.STL
Print_Follower_SO_ARM100_08k_UP_Prusa - Base_08q-5.STL
Print_Follower_SO_ARM100_08k_UP_Prusa - Moving_Jaw_08d-1.STL
Print_Follower_SO_ARM100_08k_UP_Prusa - SO_ARM100_08k-4.STL
Print_Follower_SO_ARM100_08k_UP_Prusa - SO_ARM100_08k-3.STL
Print_Follower_SO_ARM100_08k_UP_Prusa - Rotation_Pitch_08i-1.STL
Print_Follower_SO_ARM100_08k_UP_Prusa - WaveShare_Mounting_Plate_01d-3.STL
Print_Follower_SO_ARM100_08k_UP_Prusa - Base_08q-4.STL
Print_Follower_SO_ARM100_08k_UP_Prusa - Wrist_Roll_Pitch_08i-1.STL
Print_Follower_SO_ARM100_08k_UP_Prusa - SO_ARM100_08k-1.STL
Print_Follower_SO_ARM100_08k_UP_Prusa - SO_ARM100_08k-2.STL
