KartikMehta-1/AMR-development/CAD/6 Exports/STL/SO100/Individual/Follower/Print_Follower_SO_ARM100_08k_UP_Prusa - Wrist_Roll_08c-1.STL

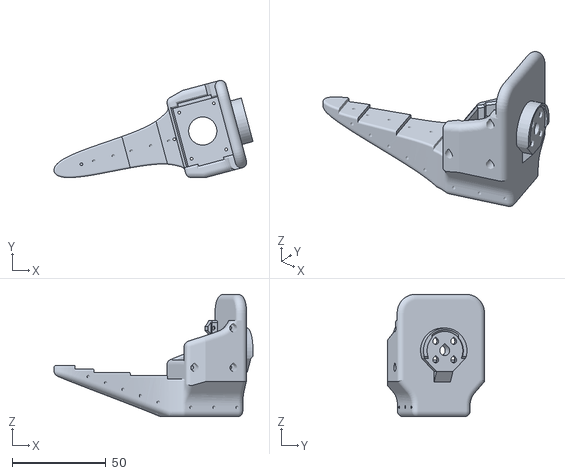
[picture p94: CAD file, 2025-11-23]
CAD/6 Exports/STL/SO100/Individual/Follower/Print_Follower_SO_ARM100_08k_UP_Prusa - Wrist_Roll_08c-1.STL
105.9 x 51.7 x 65.2
