KartikMehta-1/AMR-development/CAD/6 Exports/STL/SO100/Leader/Print_Leader_SO_ARM100_08k_UP_Prusa.STL

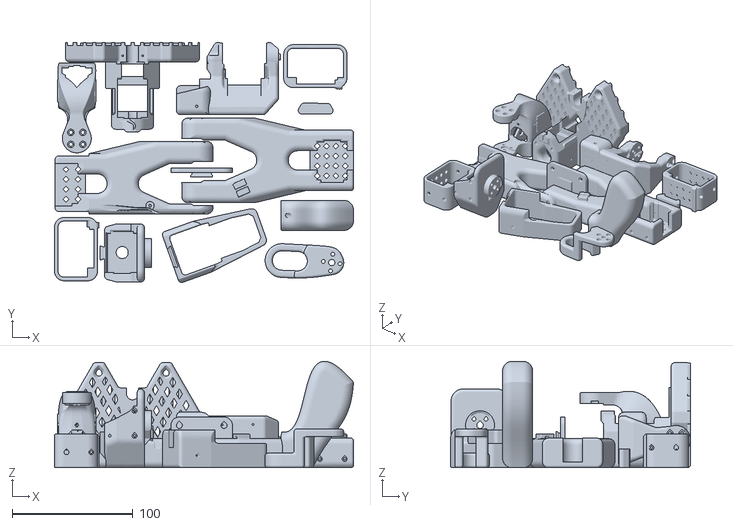
[picture p95: CAD file, 2025-11-23]
CAD/6 Exports/STL/SO100/Leader/Print_Leader_SO_ARM100_08k_UP_Prusa.STL
247.5 x 198.7 x 88.1
