KartikMehta-1/AMR-development/CAD/6 Exports/STL/SO101/Individual/Rotation_Pitch_SO101.stl

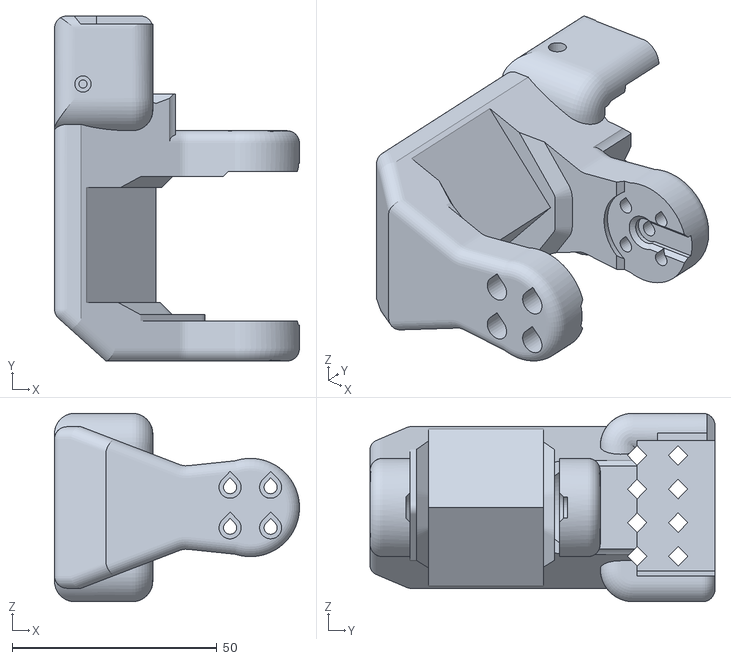
[picture p96: CAD file, 2025-11-23]
CAD/6 Exports/STL/SO101/Individual/Rotation_Pitch_SO101.stl
59.8 x 84.2 x 46.0
