KartikMehta-1/AMR-development/ros_ws/src/amr_description/meshes/so101/assets/sts3215_03a_no_horn_v1.stl

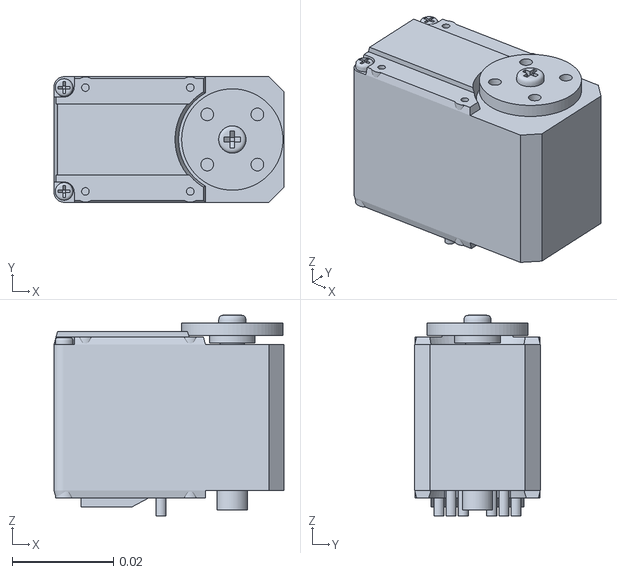
[picture p97: CAD file, 2026-06-02]
ros_ws/src/amr_description/meshes/so101/assets/sts3215_03a_no_horn_v1.stl
0.0454 x 0.0248 x 0.0396
