KartikMehta-1/AMR-development/CAD/5 3D_print/sensor_cover_ultrasonic.stp

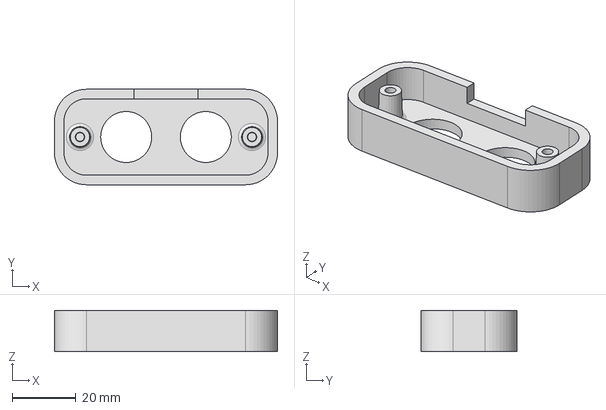
[picture p98: CAD file, 2026-04-11]
CAD/5 3D_print/sensor_cover_ultrasonic.stp
70.0 x 30.0 x 13.0 mm
