KartikMehta-1/AMR-development/CAD/6 Exports/STL/SO100/Follower/Print_Follower_SO_ARM100_08k_UP_Prusa.STL

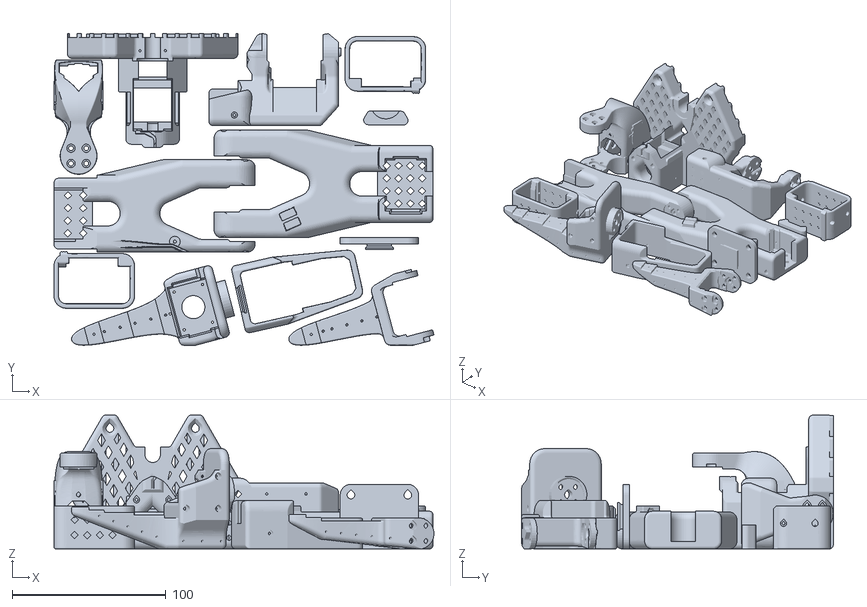
[picture p99: CAD file, 2025-11-23]
CAD/6 Exports/STL/SO100/Follower/Print_Follower_SO_ARM100_08k_UP_Prusa.STL
247.0 x 202.5 x 87.0
