KartikMehta-1/AMR-development/CAD/6 Exports/STL/SO100/Individual/Follower/Print_Follower_SO_ARM100_08k_UP_Prusa - SO_ARM100_08k-1.STL

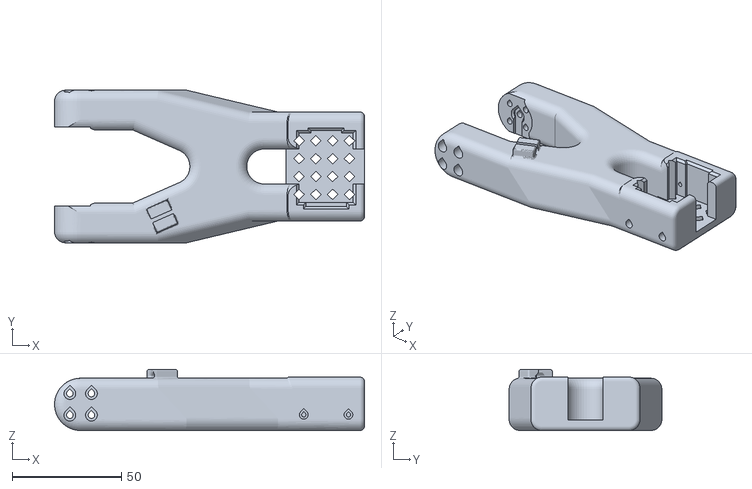
[picture p100: CAD file, 2025-11-23]
CAD/6 Exports/STL/SO100/Individual/Follower/Print_Follower_SO_ARM100_08k_UP_Prusa - SO_ARM100_08k-1.STL
142.2 x 70.0 x 28.0
