KartikMehta-1/AMR-development/CAD/6 Exports/STL/SO100/Individual/Leader/Print_Leader_SO_ARM100_08k_UP_Prusa - Base_08q-4.STL

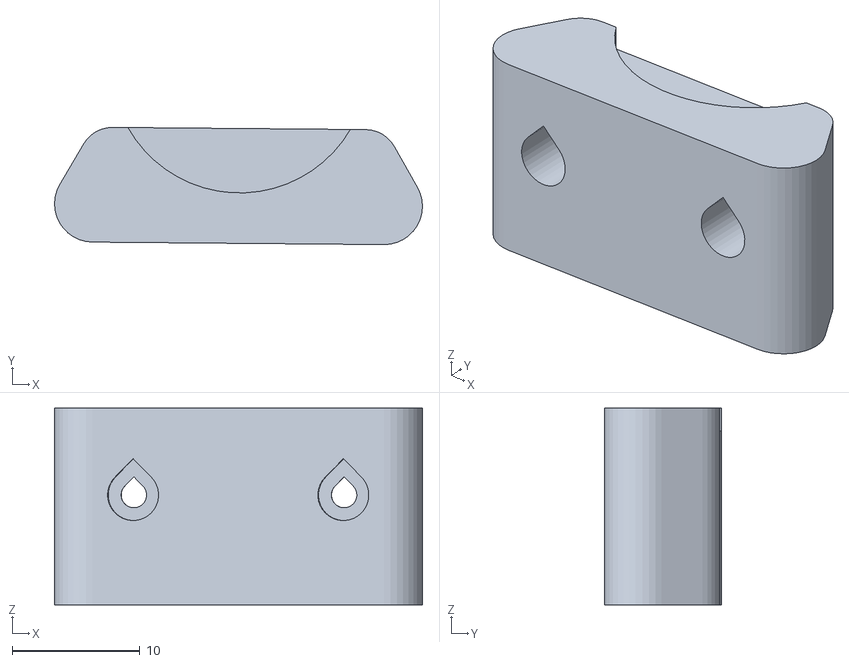
[picture p101: CAD file, 2025-11-23]
CAD/6 Exports/STL/SO100/Individual/Leader/Print_Leader_SO_ARM100_08k_UP_Prusa - Base_08q-4.STL
28.8 x 9.18 x 15.4
