KartikMehta-1/AMR-development/ros_ws/src/amr_description/meshes/so101/assets/rotation_pitch_so101_v1.stl

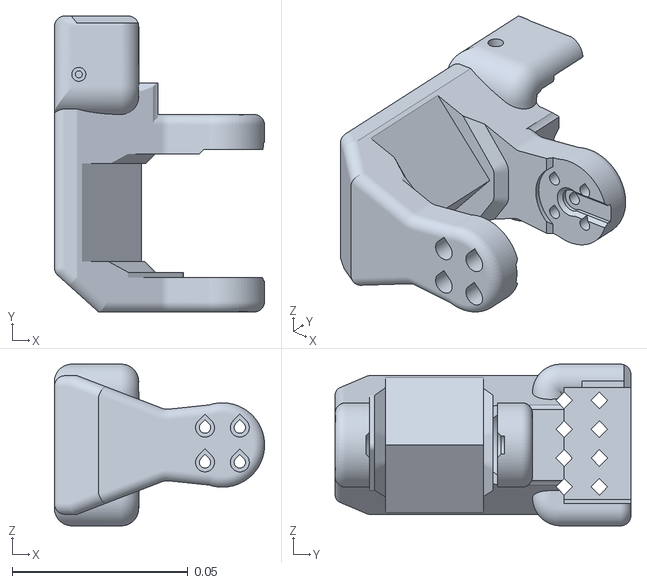
[picture p103: CAD file, 2026-06-02]
ros_ws/src/amr_description/meshes/so101/assets/rotation_pitch_so101_v1.stl
0.0598 x 0.0842 x 0.046
