KartikMehta-1/AMR-development/CAD/5 3D_print/Enclosure_Plate.stp

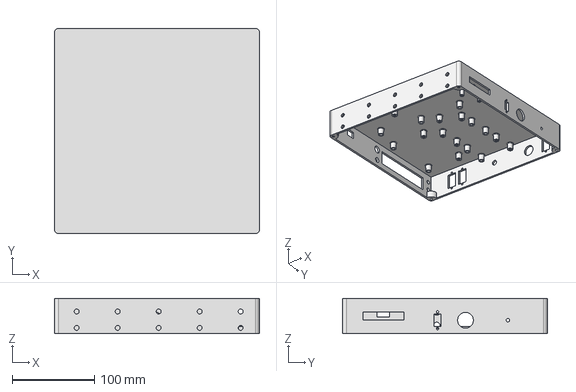
[picture p104: CAD file, 2026-04-11]
CAD/5 3D_print/Enclosure_Plate.stp
250.0 x 250.0 x 43.0 mm
