KartikMehta-1/AMR-development/CAD/6 Exports/STEP/SO101/Base_motor_holder_SO101.step

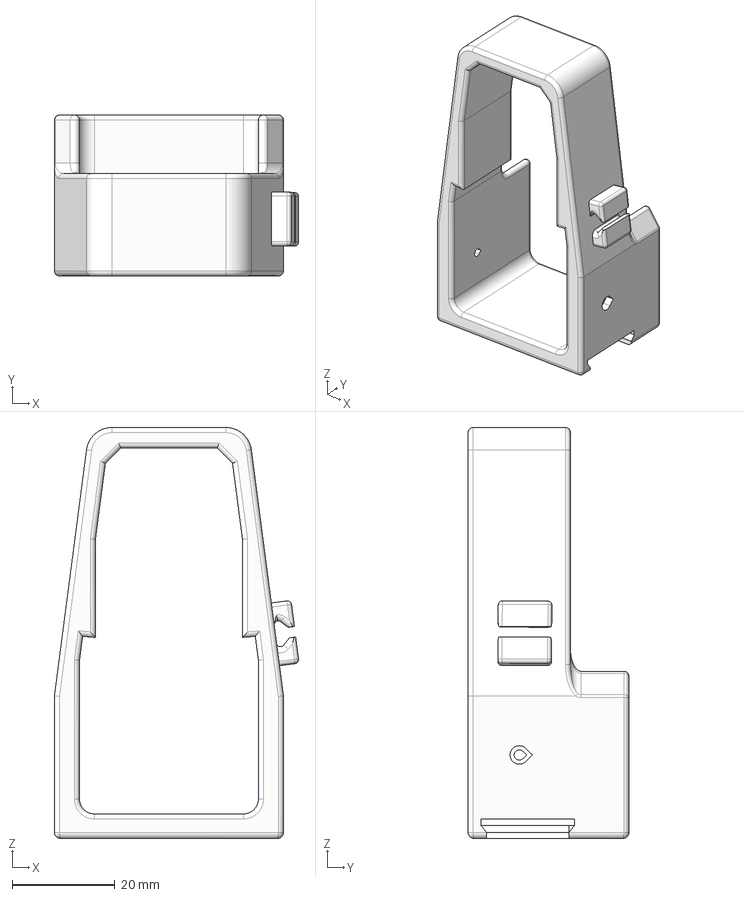
[picture p105: CAD file, 2025-11-23]
CAD/6 Exports/STEP/SO101/Base_motor_holder_SO101.step
47.6 x 31.4 x 80.2 mm
