KartikMehta-1/AMR-development/CAD/6 Exports/STL/SO101/Individual/Base_SO101.stl

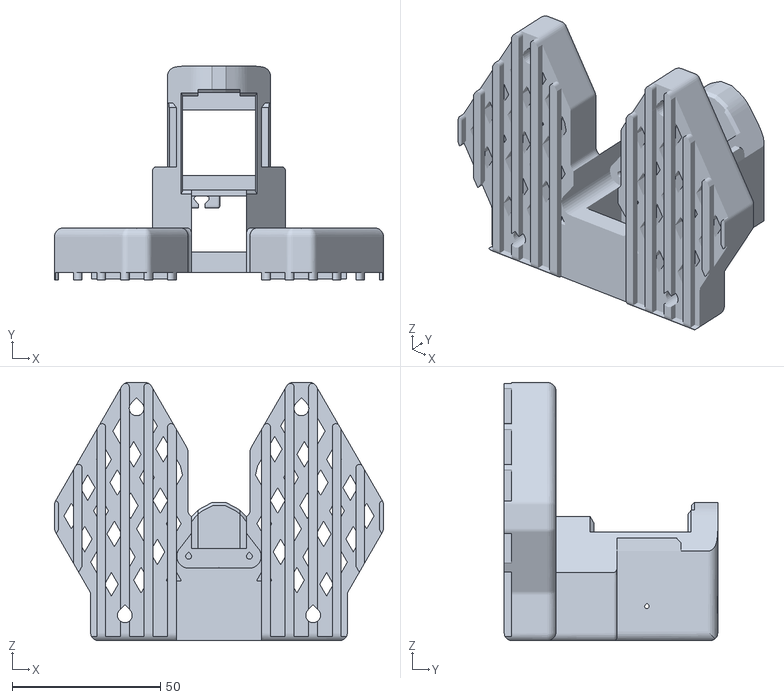
[picture p107: CAD file, 2025-11-23]
CAD/6 Exports/STL/SO101/Individual/Base_SO101.stl
110.9 x 72.0 x 87.0
