KartikMehta-1/AMR-development/ros_ws/src/amr_description/meshes/so101/assets/under_arm_so101_v1.stl

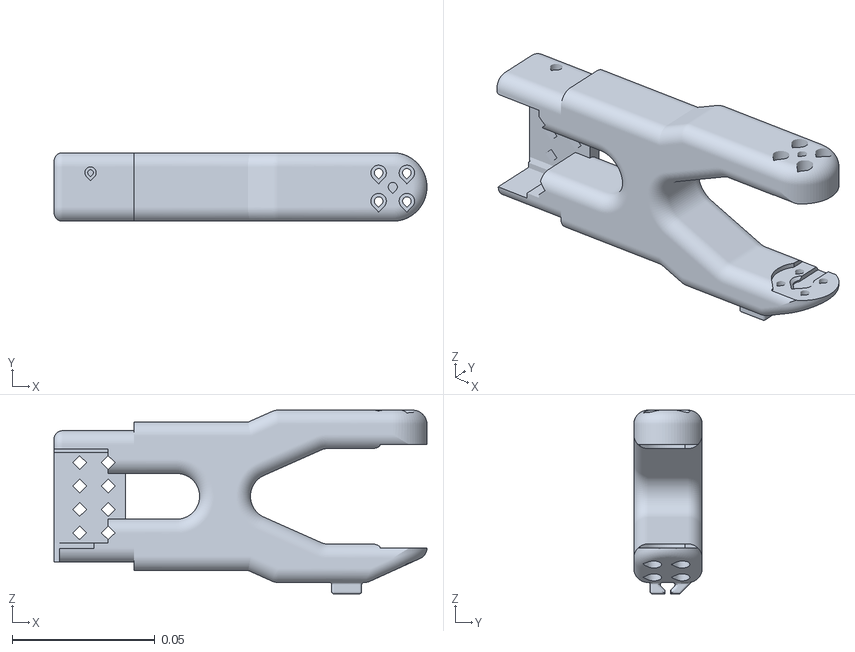
[picture p108: CAD file, 2026-06-02]
ros_ws/src/amr_description/meshes/so101/assets/under_arm_so101_v1.stl
0.131 x 0.024 x 0.0644
