KartikMehta-1/AMR-development/CAD/5 3D_print/frame_1.stp

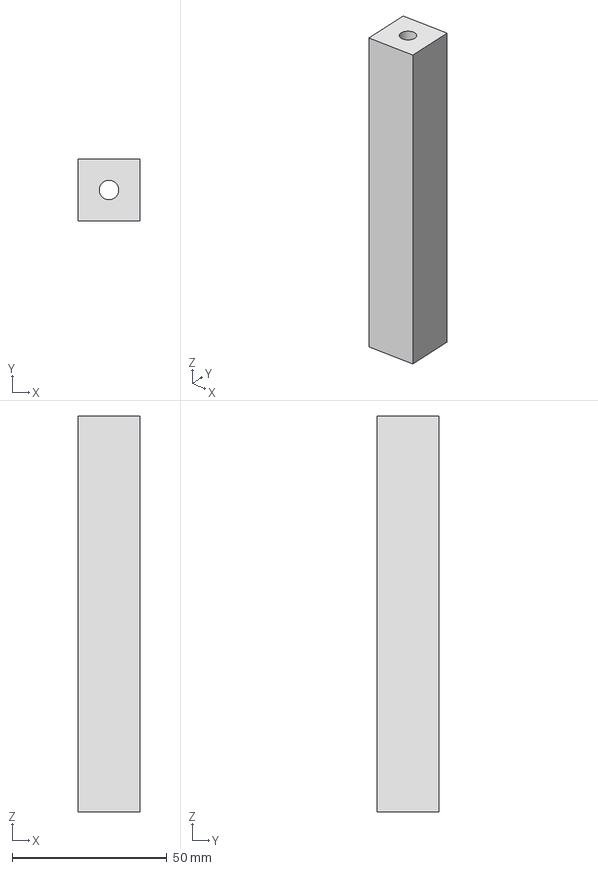
[picture p109: CAD file, 2026-01-13]
CAD/5 3D_print/frame_1.stp
20.0 x 20.0 x 128.0 mm
