KartikMehta-1/AMR-development/CAD/6 Exports/STEP/SO100/STS3215_03a.step

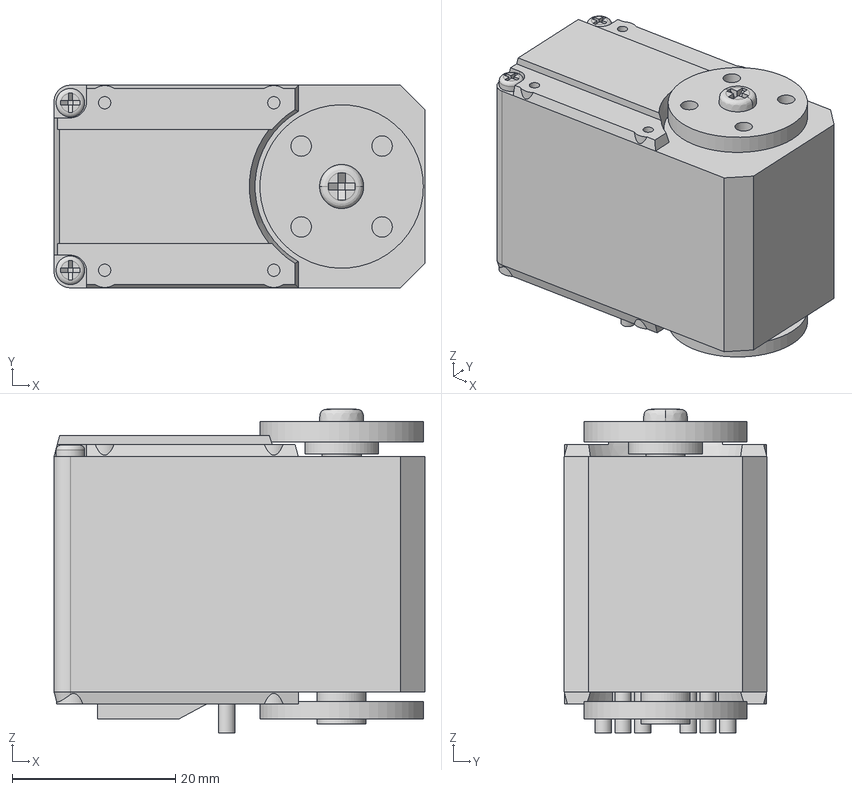
[picture p110: CAD file, 2025-11-23]
CAD/6 Exports/STEP/SO100/STS3215_03a.step
45.4 x 24.8 x 39.6 mm
