KartikMehta-1/AMR-development/CAD/6 Exports/STL/SO101/Individual/Under_arm_SO101.stl

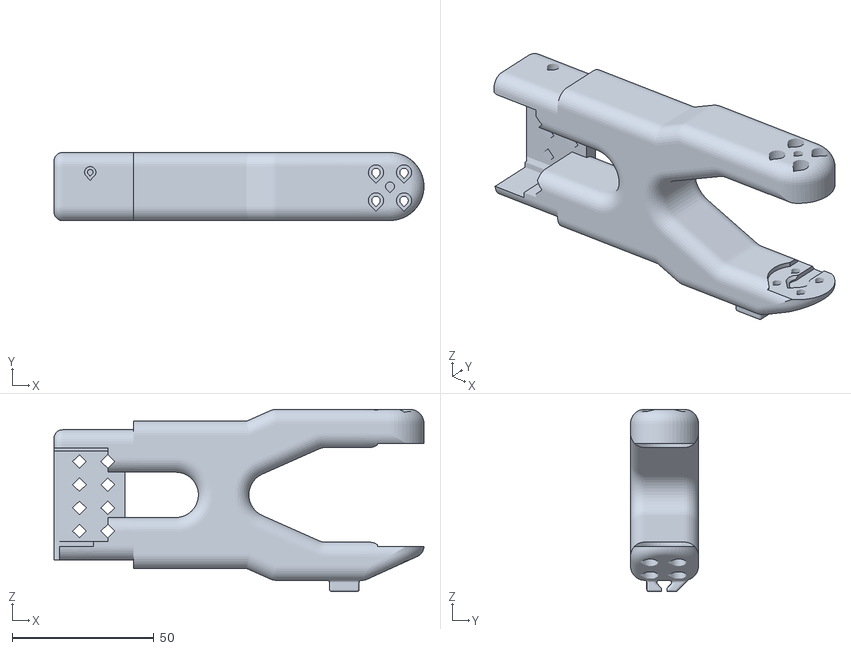
[picture p111: CAD file, 2025-11-23]
CAD/6 Exports/STL/SO101/Individual/Under_arm_SO101.stl
130.7 x 24.0 x 64.4
