KartikMehta-1/AMR-development/ros_ws/src/amr_description/meshes/so101/assets/moving_jaw_so101_v1.stl

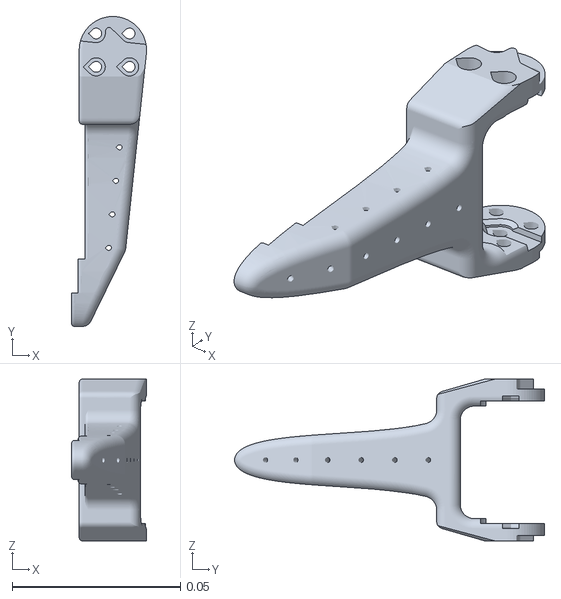
[picture p112: CAD file, 2026-06-02]
ros_ws/src/amr_description/meshes/so101/assets/moving_jaw_so101_v1.stl
0.0223 x 0.092 x 0.048
