KartikMehta-1/AMR-development/CAD/5 3D_print/Bottom_Enclosure_1_v2.stp

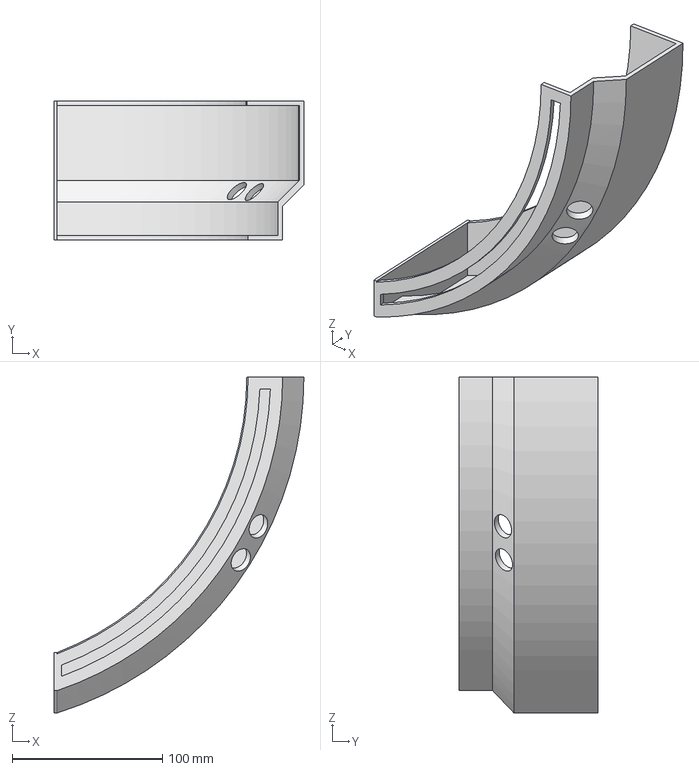
[picture p113: CAD file, 2026-01-13]
CAD/5 3D_print/Bottom_Enclosure_1_v2.stp
166.1 x 92.6 x 223.4 mm
