KartikMehta-1/AMR-development/CAD/6 Exports/STEP/SO100/Motor1_holder.step

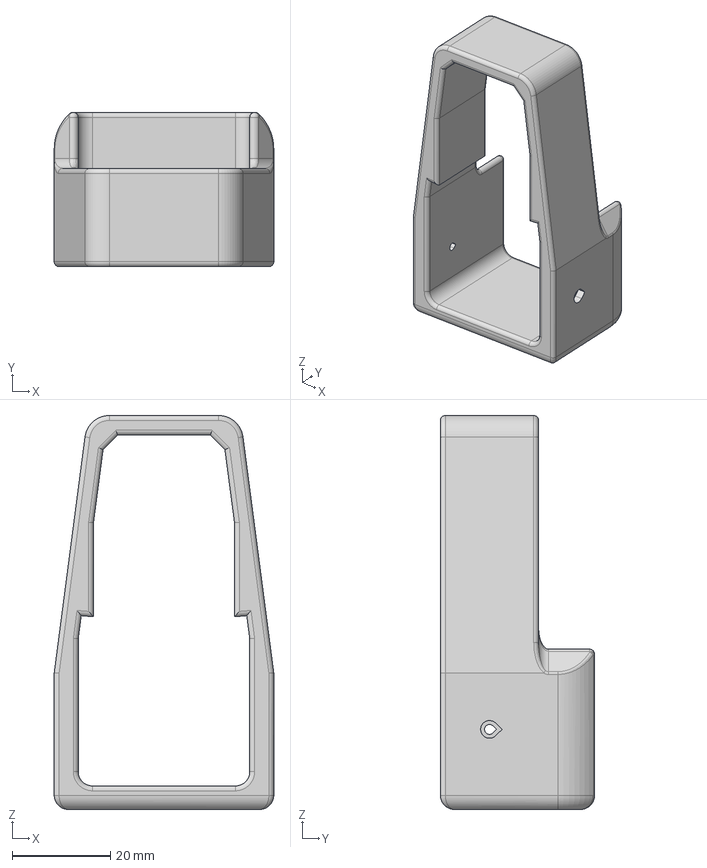
[picture p114: CAD file, 2025-11-23]
CAD/6 Exports/STEP/SO100/Motor1_holder.step
44.7 x 31.4 x 80.2 mm
