KartikMehta-1/AMR-development/CAD/6 Exports/STL/SO100/Individual/Leader/Print_Leader_SO_ARM100_08k_UP_Prusa - Base_08q-5.STL

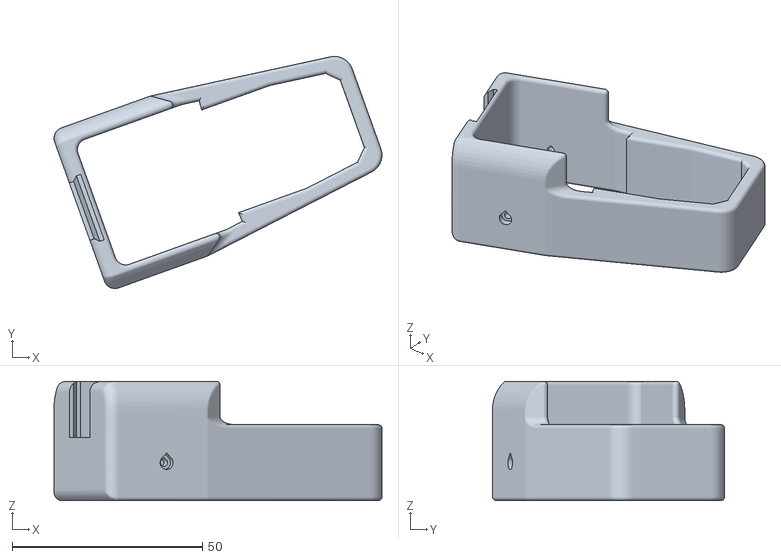
[picture p115: CAD file, 2025-11-23]
CAD/6 Exports/STL/SO100/Individual/Leader/Print_Leader_SO_ARM100_08k_UP_Prusa - Base_08q-5.STL
86.3 x 61.1 x 31.4
