KartikMehta-1/AMR-development/ros_ws/src/amr_description/meshes/so101/assets/base_motor_holder_so101_v1.stl

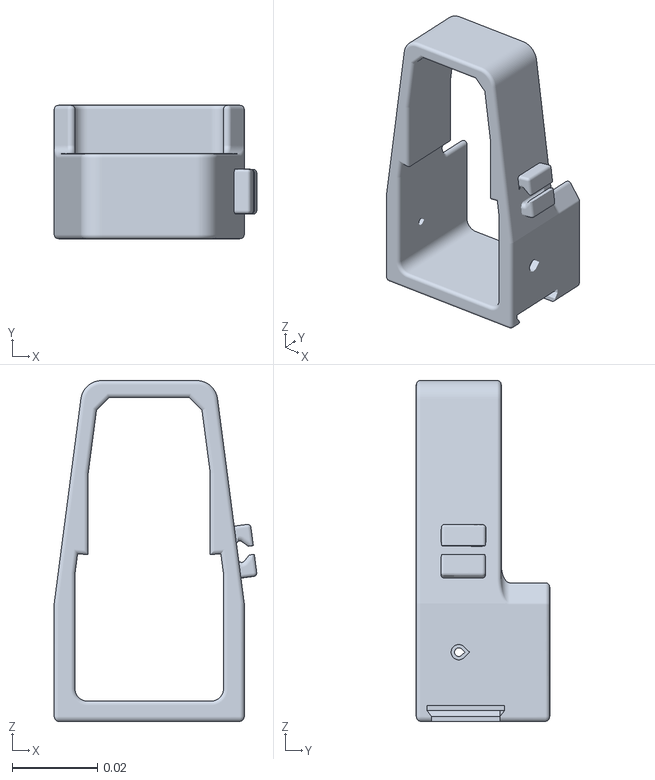
[picture p116: CAD file, 2026-06-02]
ros_ws/src/amr_description/meshes/so101/assets/base_motor_holder_so101_v1.stl
0.0476 x 0.0314 x 0.0802
