KartikMehta-1/AMR-development/CAD/6 Exports/STL/SO100/Individual/Leader/Print_Leader_SO_ARM100_08k_UP_Prusa - Wrist_Roll_05m_Leader_02ba-1.STL

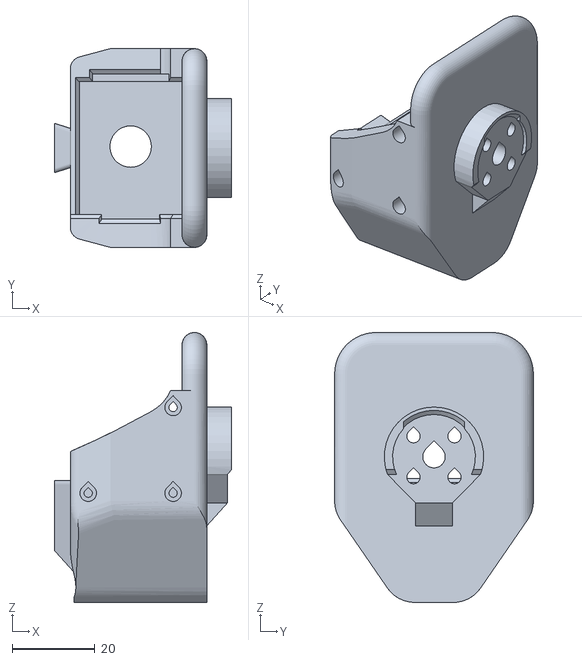
[picture p117: CAD file, 2025-11-23]
CAD/6 Exports/STL/SO100/Individual/Leader/Print_Leader_SO_ARM100_08k_UP_Prusa - Wrist_Roll_05m_Leader_02ba-1.STL
42.9 x 48.0 x 65.2
