KartikMehta-1/AMR-development/ros_ws/src/amr_description/meshes/so101/assets/wrist_roll_pitch_so101_v2.stl

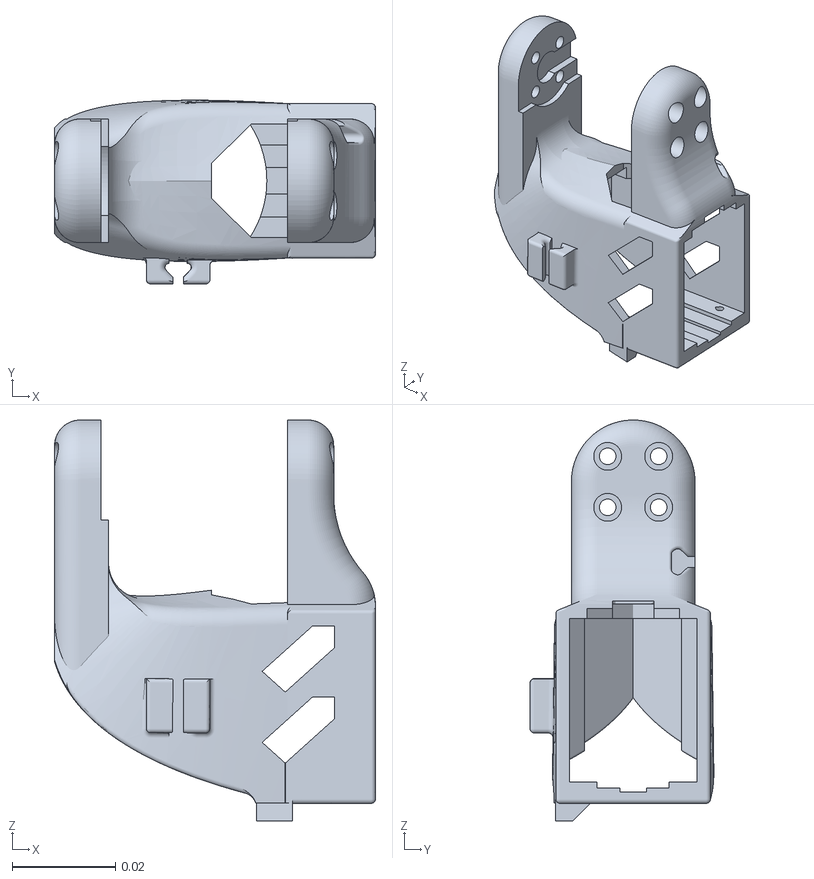
[picture p118: CAD file, 2026-06-02]
ros_ws/src/amr_description/meshes/so101/assets/wrist_roll_pitch_so101_v2.stl
0.0623 x 0.0357 x 0.0778
