KartikMehta-1/AMR-development/CAD/5 3D_print/Enclosure_6.stp

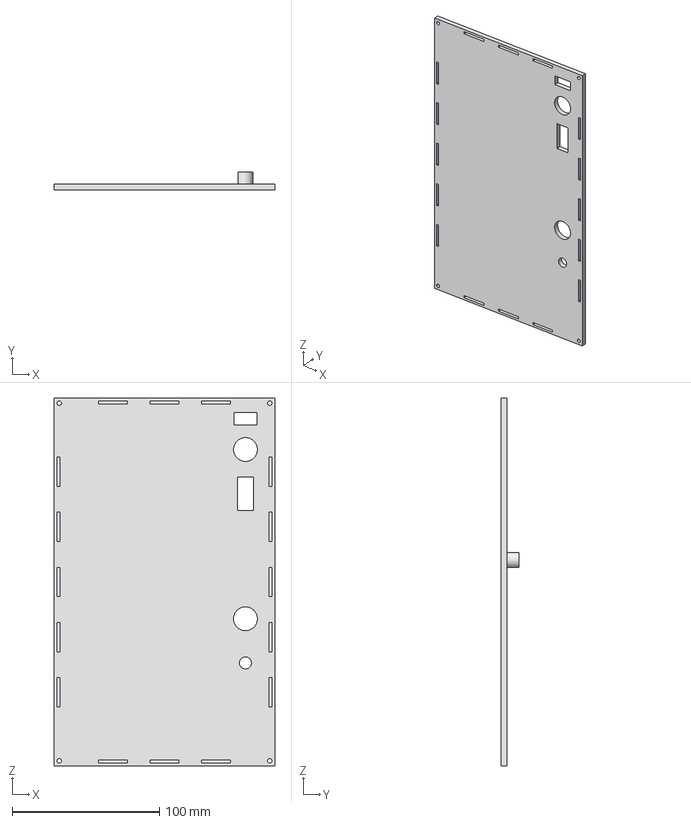
[picture p119: CAD file, 2025-12-19]
CAD/5 3D_print/Enclosure_6.stp
150.0 x 12.0 x 250.0 mm
