KartikMehta-1/AMR-development/CAD/6 Exports/STEP/SO100/Passive_Horn_01.step

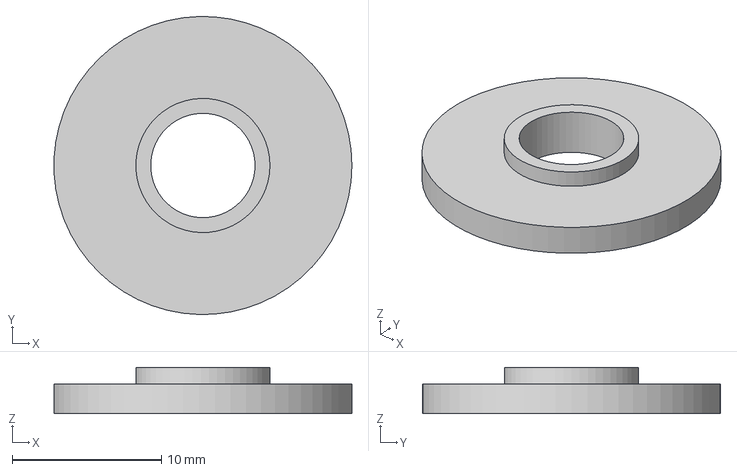
[picture p120: CAD file, 2025-11-23]
CAD/6 Exports/STEP/SO100/Passive_Horn_01.step
20.0 x 20.0 x 3.10 mm
