KartikMehta-1/AMR-development/ros_ws/src/amr_description/meshes/so101/assets/wrist_roll_follower_so101_v1.stl

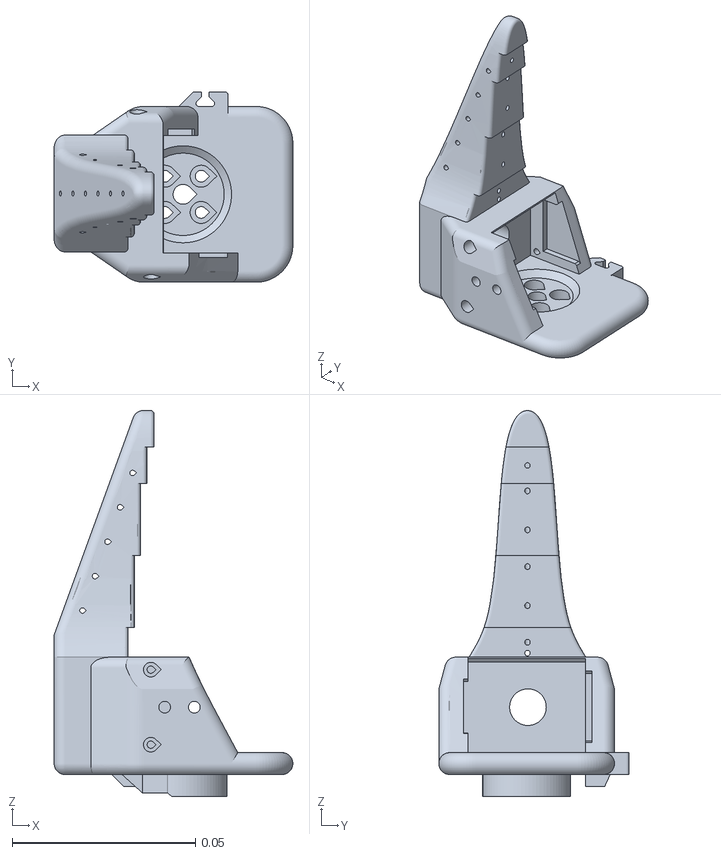
[picture p121: CAD file, 2026-06-02]
ros_ws/src/amr_description/meshes/so101/assets/wrist_roll_follower_so101_v1.stl
0.0652 x 0.052 x 0.105
