KartikMehta-1/AMR-development/CAD/5 3D_print/Enclosure_4.stp

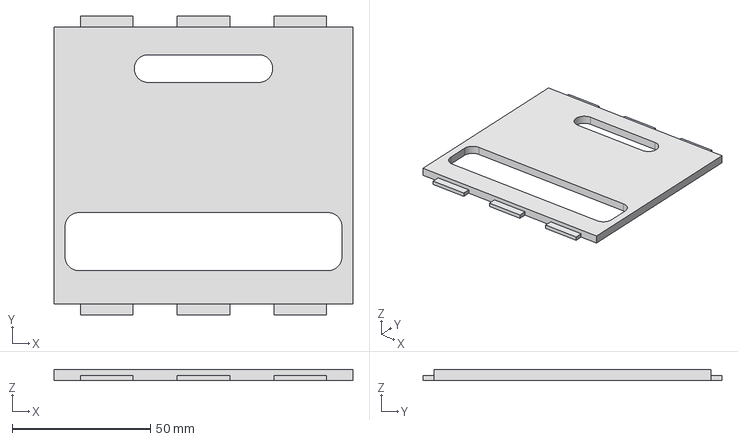
[picture p122: CAD file, 2025-12-19]
CAD/5 3D_print/Enclosure_4.stp
108.0 x 108.0 x 4.00 mm
