KartikMehta-1/AMR-development/CAD/5 3D_print/Enclosure_2.stp

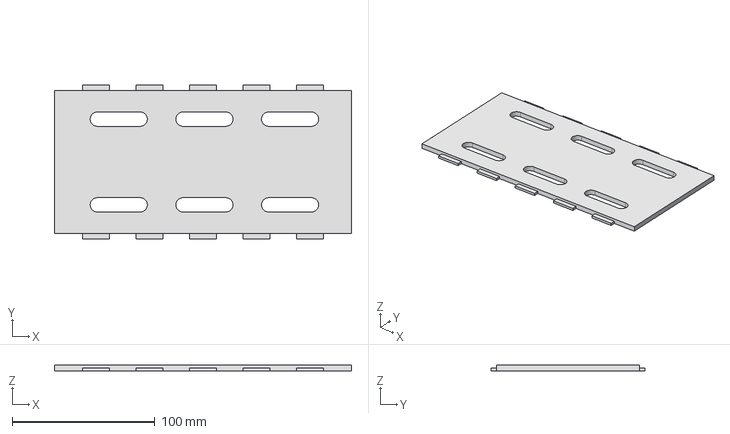
[picture p125: CAD file, 2025-12-19]
CAD/5 3D_print/Enclosure_2.stp
208.0 x 108.0 x 4.00 mm
