KartikMehta-1/AMR-development/ros_ws/src/amr_description/meshes/so101/assets/motor_holder_so101_wrist_v1.stl

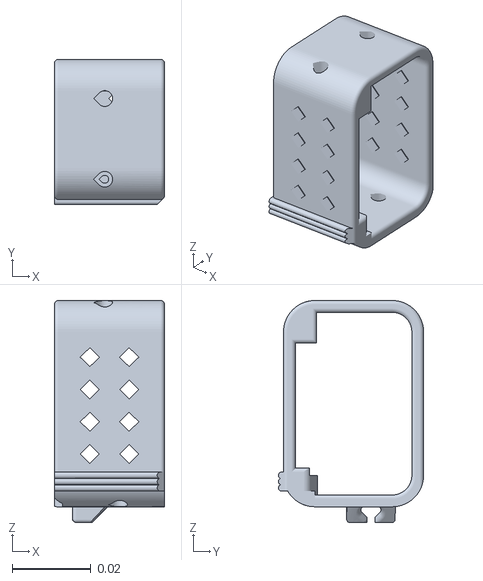
[picture p126: CAD file, 2026-06-02]
ros_ws/src/amr_description/meshes/so101/assets/motor_holder_so101_wrist_v1.stl
0.028 x 0.0369 x 0.0564
