KartikMehta-1/AMR-development/CAD/5 3D_print/Enclosure_7.stp

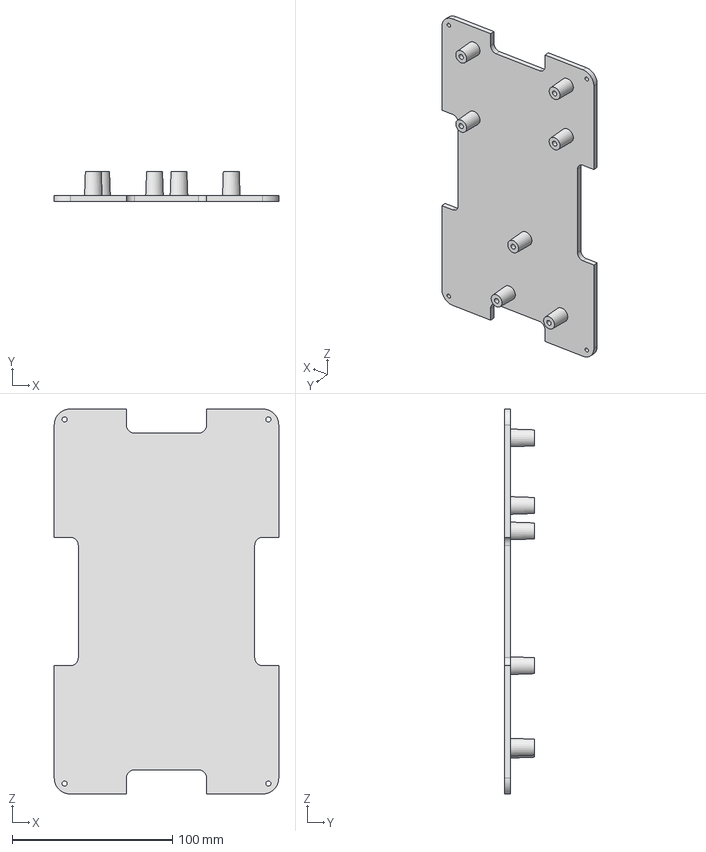
[picture p127: CAD file, 2025-12-19]
CAD/5 3D_print/Enclosure_7.stp
140.0 x 19.0 x 240.0 mm
