KartikMehta-1/AMR-development/ros_ws/src/amr_description/meshes/so101/assets/upper_arm_so101_v1.stl

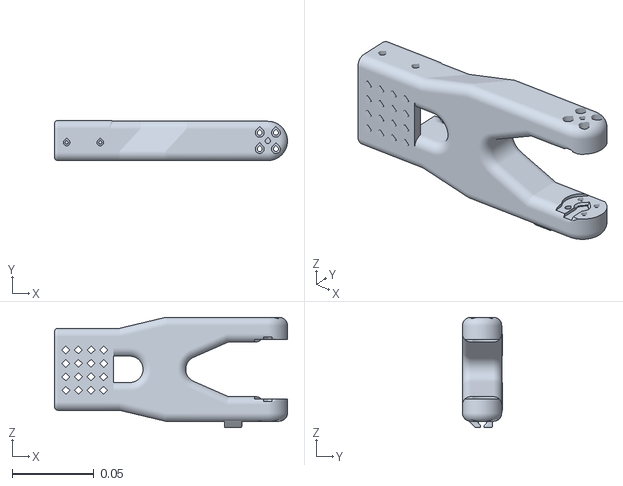
[picture p128: CAD file, 2026-06-02]
ros_ws/src/amr_description/meshes/so101/assets/upper_arm_so101_v1.stl
0.142 x 0.0245 x 0.0673
