KartikMehta-1/AMR-development/CAD/5 3D_print/Enclosure_1.stp

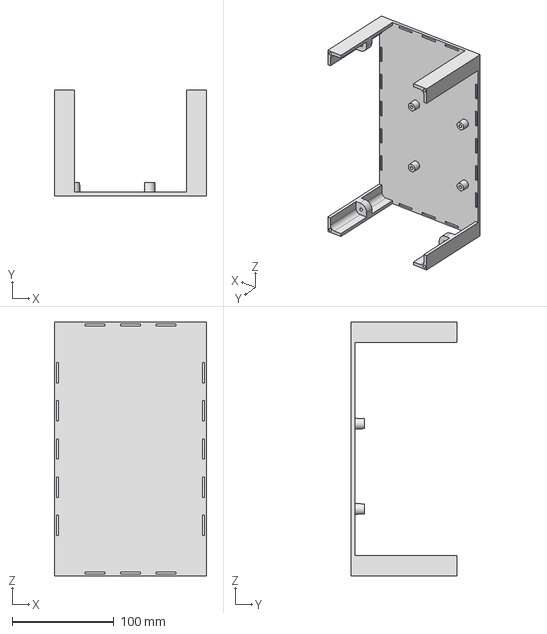
[picture p129: CAD file, 2025-12-19]
CAD/5 3D_print/Enclosure_1.stp
150.0 x 104.0 x 250.0 mm
