KartikMehta-1/AMR-development/CAD/5 3D_print/Base_MDD20A.stl

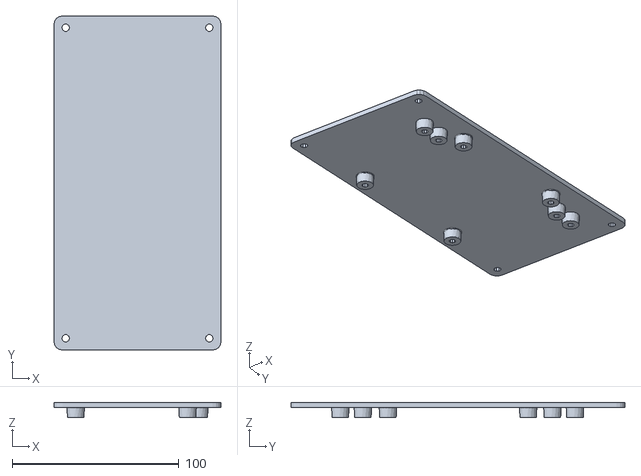
[picture p130: CAD file, 2025-11-23]
CAD/5 3D_print/Base_MDD20A.stl
100.0 x 200.0 x 9.00
