KartikMehta-1/AMR-development/CAD/5 3D_print/Base_ST_nano.stl

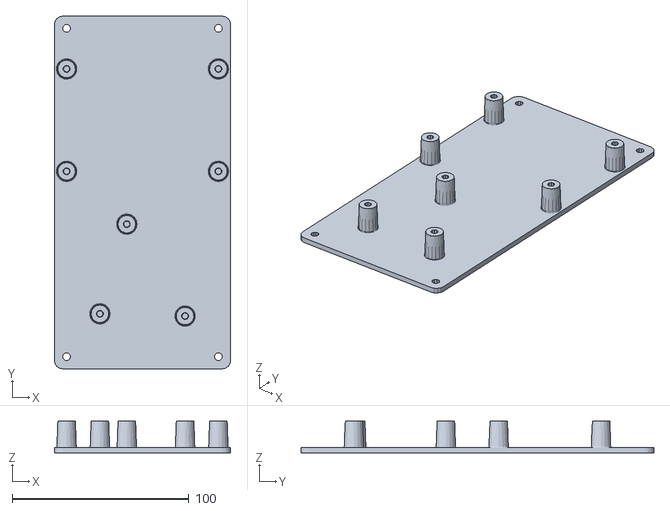
[picture p131: CAD file, 2025-11-23]
CAD/5 3D_print/Base_ST_nano.stl
100.0 x 200.0 x 18.0
