KartikMehta-1/AMR-development/CAD/5 3D_print/Spacer.stl

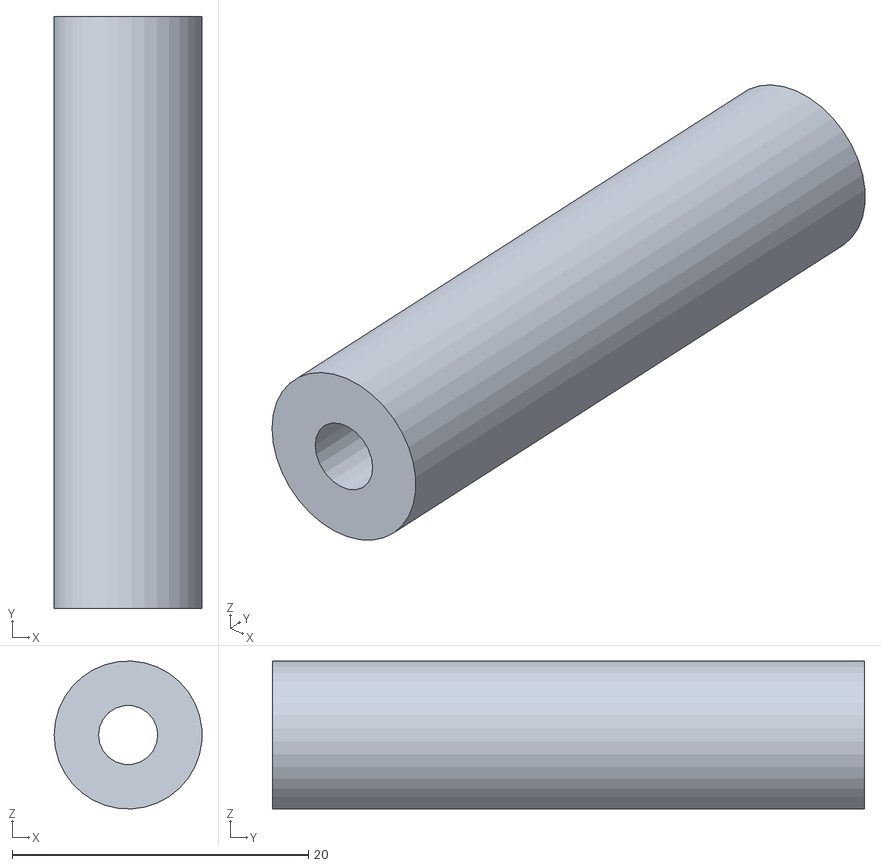
[picture p132: CAD file, 2025-11-23]
CAD/5 3D_print/Spacer.stl
9.98 x 40.0 x 9.99
