KartikMehta-1/AMR-development/(list of files, cad)

Other CAD files:
CAD/4 Boughtouts/amass-xt60e1-m-1/Amass XT60E1-M/Amass XT60E1-M .step
CAD/4 Boughtouts/mini-toggle-switches-1/Mini Toggle Switches.step
CAD/6 Exports/STL/Gauges/Lego_Size_Test_02_minuspoint1.STL
CAD/6 Exports/STL/SO100/Individual/Leader/Print_Leader_SO_ARM100_08k_UP_Prusa - Wrist_Roll_05m_Leader_02ba-2.STL
CAD/6 Exports/STEP/SO100/Leader_Specific/Trigger_04e v1.step
CAD/6 Exports/STEP/SO101/Leader_Specific/Trigger_SO101.step
CAD/6 Exports/STEP/SO101/Upper_arm_SO101.step
CAD/6 Exports/STL/Gauges/Gauge_0.STL
CAD/6 Exports/STL/SO100/Individual/Leader/Print_Leader_SO_ARM100_08k_UP_Prusa - SO_ARM100_08k-4.STL
CAD/6 Exports/STEP/SO101/Rotation_Pitch_SO101.step
CAD/6 Exports/STL/SO101/Individual/Wrist_Roll_Follower_SO101.stl
CAD/6 Exports/STEP/SO100/Base_08q.step
CAD/6 Exports/STL/SO100/Individual/Leader/Print_Leader_SO_ARM100_08k_UP_Prusa - WaveShare_Mounting_Plate_01d-2.STL
CAD/6 Exports/STEP/SO101/Base_SO101.step
CAD/6 Exports/STL/SO100/Individual/Follower/Print_Follower_SO_ARM100_08k_UP_Prusa - Base_08q-4.STL
CAD/6 Exports/STL/SO100/Individual/Leader/Print_Leader_SO_ARM100_08k_UP_Prusa - Wrist_Roll_Pitch_08i-1.STL
CAD/6 Exports/STL/SO100/Individual/Follower/Print_Follower_SO_ARM100_08k_UP_Prusa - Rotation_Pitch_08i-1.STL
CAD/6 Exports/STL/SO101/Individual/Wrist_Roll_SO101.stl
CAD/5 3D_print/Bottom_Enclosure_1_v2_MIRROR.stp
CAD/6 Exports/STEP/SO100/Rotation_Pitch_08i.step
CAD/6 Exports/STEP/SO101/WaveShare_Mounting_Plate_SO101.step
CAD/6 Exports/STL/SO100/Individual/Follower/Print_Follower_SO_ARM100_08k_UP_Prusa - SO_ARM100_08k-3.STL
CAD/6 Exports/STL/SO101/Individual/Seeedstudio_Mounting_Plate_SO101.stl
CAD/6 Exports/STEP/SO101/Under_arm_SO101.step
CAD/6 Exports/STL/SO100/Individual/Follower/Print_Follower_SO_ARM100_08k_UP_Prusa - Wrist_Roll_Pitch_08i-1.STL
CAD/6 Exports/STL/SO100/Individual/Leader/Print_Leader_SO_ARM100_08k_UP_Prusa - Base_08q-3.STL
CAD/6 Exports/STL/SO101/Individual/Motor_holder_SO101_Base.stl
CAD/6 Exports/STEP/SO101/Wrist_Roll_Pitch_SO101.step
CAD/6 Exports/STL/SO100/Individual/Leader/Print_Leader_SO_ARM100_08k_UP_Prusa - SO_ARM100_08k-1.STL
CAD/6 Exports/STL/SO101/Individual/Base_motor_holder_SO101.stl
CAD/6 Exports/STL/SO100/Individual/Follower/Print_Follower_SO_ARM100_08k_UP_Prusa - SO_ARM100_08k-4.STL
CAD/6 Exports/STL/SO100/Individual/Leader/Print_Leader_SO_ARM100_08k_UP_Prusa - SO_ARM100_08k-3.STL
CAD/6 Exports/STL/SO101/Individual/Moving_Jaw_SO101.stl
CAD/6 Exports/STL/SO100/Individual/Leader/Print_Leader_SO_ARM100_08k_UP_Prusa - SO_ARM100_08k-2.STL
CAD/6 Exports/STL/SO101/Individual/Motor_holder_SO101_Wrist.stl
CAD/6 Exports/STL/SO101/Individual/Handle_SO101.stl
CAD/6 Exports/STL/SO101/Individual/WaveShare_Mounting_Plate_SO101.stl
CAD/1 Assembly/AMR_assembly.iam
CAD/1 Assembly/OldVersions/AMR_assembly.0031.iam
CAD/2 Sub-assembly/OldVersions/PCB enclosure.0008.iam
CAD/2 Sub-assembly/OldVersions/PCB enclosure_v2.0021.iam
CAD/2 Sub-assembly/OldVersions/PCB enclosure_v3.0010.iam
CAD/2 Sub-assembly/PCB enclosure.iam
CAD/2 Sub-assembly/PCB enclosure_v2.iam
CAD/2 Sub-assembly/PCB enclosure_v3.iam
CAD/2 Sub-assembly/sensor_subassy.iam
CAD/3 Parts/AMR_base.ipt
CAD/3 Parts/Base_MDD20A.ipt
CAD/3 Parts/Base_ST_nano.ipt
CAD/3 Parts/Battery.ipt
CAD/3 Parts/Bottom_Enclosure_1.ipt
CAD/3 Parts/Bottom_Enclosure_1_v2.ipt
CAD/3 Parts/Bottom_Enclosure_1_v2_MIRROR.ipt
CAD/3 Parts/Bottom_Enclosure_2.ipt
CAD/3 Parts/Enclosure cover.ipt
CAD/3 Parts/Enclosure.ipt
CAD/3 Parts/Enclosure_1.ipt
CAD/3 Parts/Enclosure_2.ipt
CAD/3 Parts/Enclosure_3.ipt
CAD/3 Parts/Enclosure_4.ipt
CAD/3 Parts/Enclosure_5.ipt
CAD/3 Parts/Enclosure_6.ipt
CAD/3 Parts/Enclosure_7.ipt
CAD/3 Parts/Enclosure_Plate.ipt
CAD/3 Parts/Encoder.ipt
CAD/3 Parts/Frame_member.ipt
CAD/3 Parts/LIdar_p1.ipt
CAD/3 Parts/LIdar_p2.ipt
CAD/3 Parts/Motor.ipt
CAD/3 Parts/Motor_mount.ipt
CAD/3 Parts/OldVersions/AMR_base.0004.ipt
CAD/3 Parts/OldVersions/Base_MDD20A.0007.ipt
CAD/3 Parts/OldVersions/Base_ST_nano.0008.ipt
CAD/3 Parts/OldVersions/Battery.0001.ipt
CAD/3 Parts/OldVersions/Bottom_Enclosure_1.0007.ipt
CAD/3 Parts/OldVersions/Bottom_Enclosure_1_v2.0005.ipt
CAD/3 Parts/OldVersions/Bottom_Enclosure_1_v2_MIRROR.0001.ipt
CAD/3 Parts/OldVersions/Bottom_Enclosure_2.0003.ipt
CAD/3 Parts/OldVersions/Enclosure cover.0004.ipt
CAD/3 Parts/OldVersions/Enclosure.0001.ipt
CAD/3 Parts/OldVersions/Enclosure_1.0008.ipt
CAD/3 Parts/OldVersions/Enclosure_2.0010.ipt
CAD/3 Parts/OldVersions/Enclosure_3.0003.ipt
CAD/3 Parts/OldVersions/Enclosure_3.0004.ipt
CAD/3 Parts/OldVersions/Enclosure_4.0007.ipt
CAD/3 Parts/OldVersions/Enclosure_5.0001.ipt
CAD/3 Parts/OldVersions/Enclosure_6.0012.ipt
CAD/3 Parts/OldVersions/Enclosure_7.0007.ipt
CAD/3 Parts/OldVersions/Enclosure_Plate.0024.ipt
CAD/3 Parts/OldVersions/Frame_member.0004.ipt
CAD/3 Parts/OldVersions/Motor.0002.ipt
CAD/3 Parts/OldVersions/Motor_mount.0003.ipt
CAD/3 Parts/OldVersions/Wheel_rubber.0001.ipt
CAD/3 Parts/OldVersions/current sensor.0001.ipt
CAD/3 Parts/OldVersions/sensor_cover_ultrasonic.0002.ipt
CAD/3 Parts/OldVersions/sensor_cover_ultrasonic_2.0002.ipt
CAD/3 Parts/OldVersions/sensor_cover_ultrasonic_3.0003.ipt
CAD/3 Parts/Pulley.ipt
CAD/3 Parts/Spacer.ipt
CAD/3 Parts/Wheel_Cover.ipt
CAD/3 Parts/Wheel_rubber.ipt
CAD/3 Parts/current sensor.ipt
CAD/3 Parts/layer1.ipt
CAD/3 Parts/layer2.ipt
CAD/3 Parts/sensor_cover_ultrasonic.ipt
CAD/3 Parts/sensor_cover_ultrasonic_2.ipt
CAD/3 Parts/sensor_cover_ultrasonic_3.ipt
CAD/4 Boughtouts/LM2596 DC-DC StepDown Converter v1/LM2596 DC-DC StepDown Converter v1/LM2596 DC-DC StepDown Converter v1.ipt
CAD/4 Boughtouts/MDD20A CAD/MDD20A.IGS
CAD/4 Boughtouts/MDD20A CAD/MDD20A/MDD20A/MDD20A.ipt
CAD/4 Boughtouts/NUCLEO-F401RE--3DModel-STEP-56544/Arduino UNO R3 screw Shield v2 Left/Arduino UNO R3 screw Shield v2 Left.ipt
CAD/4 Boughtouts/NUCLEO-F401RE--3DModel-STEP-56544/Arduino UNO R3 screw Shield v2 Right/Arduino UNO R3 screw Shield v2 Right.ipt
CAD/4 Boughtouts/NUCLEO-F401RE--3DModel-STEP-56544/NUCLEO-F401RE--3DModel-STEP-56544/NUCLEO-F401RE--3DModel-STEP-56544.ipt
CAD/4 Boughtouts/amass-xt60e1-m-1/Amass XT60E1-M/Amass XT60E1-M .f3d
CAD/4 Boughtouts/arduino-uno-screw-shield-1/Arduino Uno Screw Shield.f3d
CAD/4 Boughtouts/arduino-uno-screw-shield-1/Arduino Uno Screw Shield.step
CAD/4 Boughtouts/arduino-uno-screw-shield-1/Arduino Uno Screw Shield/Arduino Uno Screw Shield/Arduino Uno Screw Shield.ipt
CAD/4 Boughtouts/electrical-part-fuse-holder/Fuse Holder - CONQUER CQ-201N_.iam
CAD/4 Boughtouts/electrical-part-fuse-holder/Fuse Holder Base.ipt
CAD/4 Boughtouts/electrical-part-fuse-holder/Fuse Holder Clamp.ipt
CAD/4 Boughtouts/electrical-part-fuse-holder/Fuse Holder Pin.ipt
CAD/4 Boughtouts/electrical-part-fuse-holder/Fuse Holder Terminal End Plate.ipt
CAD/4 Boughtouts/emergency-stop-push-button-switches-ab6-v-series-16mm-1/AB6-V.SLDPRT
CAD/4 Boughtouts/emergency-stop-push-button-switches-ab6-v-series-16mm-1/AB6-V/AB6-V/AB6-V.ipt
CAD/4 Boughtouts/hc-sr04-ultrasonic-sensor-12/Ultrasonic sensor/Ultrasonic sensor/Ultrasonic sensor.ipt
CAD/4 Boughtouts/intel-realsense-d455-mount-1/Assem1/Assem1/Assem1.ipt
CAD/4 Boughtouts/intel-realsense-d455-mount-1/Blocco D455.3mf
CAD/4 Boughtouts/intel-realsense-d455-mount-1/Blocco D455.SLDPRT
CAD/4 Boughtouts/intel-realsense-d455-mount-1/Blocco D455/Blocco D455/Blocco D455.ipt
CAD/4 Boughtouts/intel-realsense-d455-mount-1/Cover Telecamera.SLDPRT
CAD/4 Boughtouts/intel-realsense-d455-mount-1/Cover Telecamera/Cover Telecamera/Cover Telecamera.ipt
CAD/4 Boughtouts/intel-realsense-d455-mount-1/stand.SLDPRT
CAD/4 Boughtouts/intel-realsense-d455-mount-1/stand/stand/stand.ipt
CAD/4 Boughtouts/intel-realsense-depth-camera-d455/INTEL REALSENSE DEPTH CAMERA D455/INTEL REALSENSE DEPTH CAMERA D455.f3d
CAD/4 Boughtouts/intel-realsense-depth-camera-d455/INTEL REALSENSE DEPTH CAMERA D455/INTEL REALSENSE DEPTH CAMERA D455/INTEL REALSENSE DEPTH CAMERA D455/INTEL REALSENSE DEPTH CAMERA D.ipt
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
