KartikMehta-1/AMR-development/docs/architecture/70_perception_calibration.md

# Perception And Calibration Architecture

Owner: Perception / Calibration Agent  
Secondary: Manipulator / MoveIt Agent  
Status: Active scaffold

This block owns the first scaffold for camera/depth perception, calibration, and
structured perception outputs. The current implementation is proposal-only: it
defines contracts and an MCP surface, but it does not run live camera capture or
command robot motion.

## Planned Responsibility

- AMR RealSense and SO-101 wrist-webcam pipelines.
- Camera and depth calibration.
- Frame, timestamp, and confidence handling.
- Object or grasp proposals that do not directly command actuators.
- VLA-style manipulation proposals and task plans, kept separate from execution.
- Wrist-camera-to-tool and arm-base-to-AMR calibration for close-range grasp
  verification.
- Dataset/log capture for offline perception and VLA evaluation.

## Planned Diagram

```mermaid
flowchart LR
  CAMERA[RGB-D camera]
  CALIB[Calibration + frame validation]
  PROCESS[Image/depth processing]
  VLA[VLA / policy proposal layer]
  PROPOSALS[Object / grasp proposals]
  MCP[amr_perception_inspection MCP\nread-only]
  AGENT[LLM / agent reasoning]
  CONSUMERS[Mission / manipulator consumers]

  CAMERA --> CALIB
  CALIB --> PROCESS
  PROCESS --> PROPOSALS
  PROCESS --> VLA
  VLA --> PROPOSALS
  PROPOSALS --> MCP
  MCP --> AGENT
  AGENT --> CONSUMERS
  PROPOSALS --> CONSUMERS
```

## Detailed Sources

- `ros_ws/src/amr_perception`
- `mcp_servers/amr_perception_inspection`
- `docs/agentic/roles/perception_calibration_agent.md`
- `docs/perception/vla_manipulation_layers.md`
- Datasets, logs, and calibration artifacts once promoted into governed paths.

## Validation

- Offline image/depth tests.
- Calibration file parsing and frame checks.
- MCP smoke test for read-only perception tools.
- No live camera capture loops or manipulation execution without explicit request.
