KartikMehta-1/AMR-development/Workspace/motor_PID_tuning/Figure_1.png

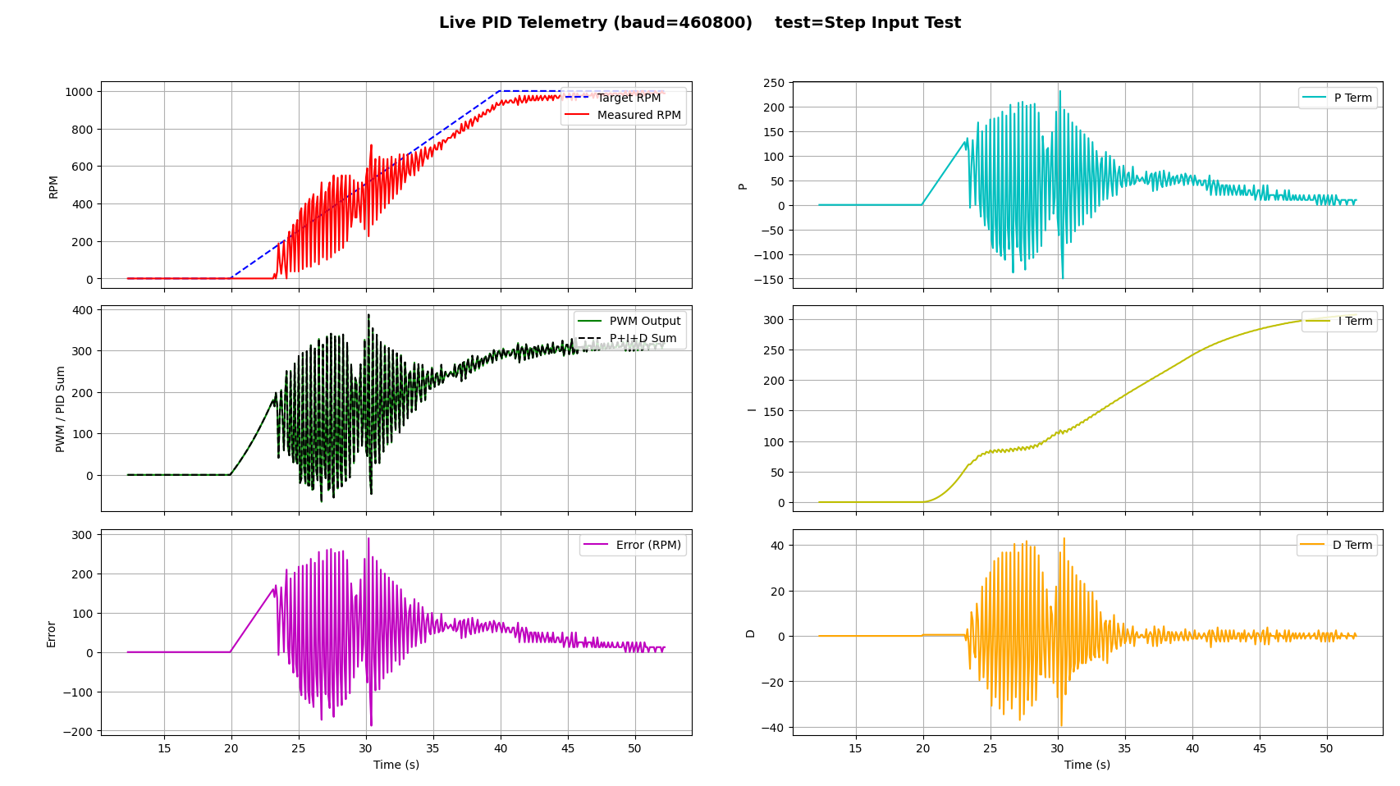
Workspace/motor_PID_tuning/Figure_1.png
