KartikMehta-1/AMR-development/Workspace/motor_PID_tuning/Figure_2.png

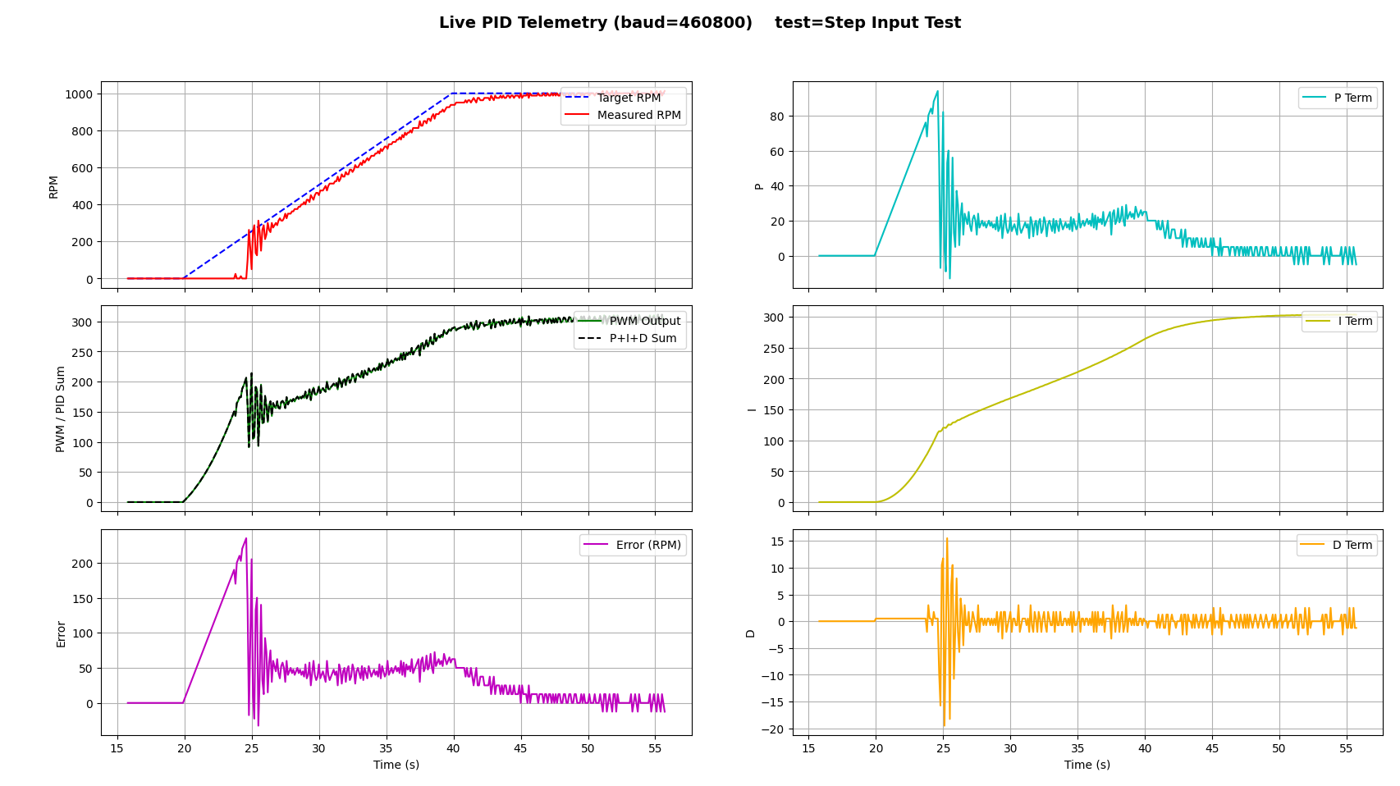
Workspace/motor_PID_tuning/Figure_2.png
