KartikMehta-1/AMR-development/Workspace/motor_PID_tuning/Figure_3.png

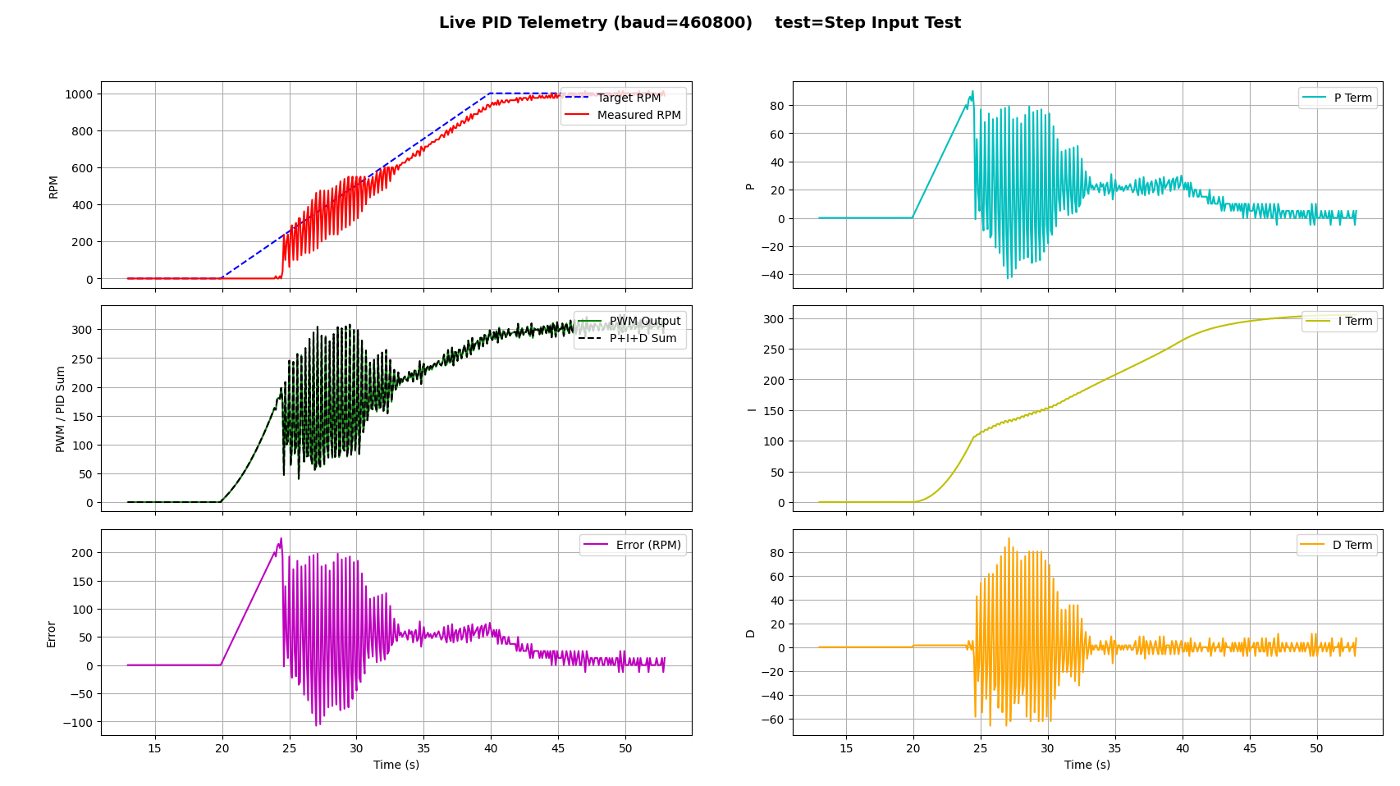
Workspace/motor_PID_tuning/Figure_3.png
