KartikMehta-1/AMR-development/ros_ws/src/amr_description/urdf/so101_upstream.xacro

<?xml version="1.0"?>
<robot xmlns:xacro="http://www.ros.org/wiki/xacro">
  <!--
    SO-101 model vendored from TheRobotStudio/SO-ARM100 Simulation/SO101.
    Source: https://github.com/TheRobotStudio/SO-ARM100/tree/main/Simulation/SO101
    License: Apache-2.0, copied in urdf/so101/LICENSE.Apache-2.0.

    This wrapper prefixes upstream names with so101_ and adds AMR mount,
    tool0, and wrist webcam frames. The mount and wrist-camera poses are
    placeholders until measured on the physical AMR.
  -->

  <xacro:macro name="so101_arm" params="parent xyz:='0 0 0' rpy:='0 0 0'">
    <link name="so101_arm_mount_link">
      <visual>
        <origin xyz="0 0 0.005" rpy="0 0 0"/>
        <geometry>
          <box size="0.080 0.080 0.010"/>
        </geometry>
        <material name="so101_mount_gray">
          <color rgba="0.18 0.20 0.22 1.0"/>
        </material>
      </visual>
      <collision>
        <origin xyz="0 0 0.005" rpy="0 0 0"/>
        <geometry>
          <box size="0.080 0.080 0.010"/>
        </geometry>
      </collision>
    </link>

    <joint name="so101_arm_mount_joint" type="fixed">
      <parent link="${parent}"/>
      <child link="so101_arm_mount_link"/>
      <origin xyz="${xyz}" rpy="${rpy}"/>
    </joint>

    <joint name="so101_base_mount_joint" type="fixed">
      <parent link="so101_arm_mount_link"/>
      <child link="so101_base_link"/>
      <origin xyz="0 0 0.010" rpy="0 0 0"/>
    </joint>
    <material name="3d_printed">
        <color rgba="1.0 0.82 0.12 1.0"/>
    </material>
    <material name="sts3215">
        <color rgba="0.1 0.1 0.1 1.0"/>
    </material>
    <link name="so101_base_link">
        <inertial>
            <origin xyz="0.0137179 -5.19711e-05 0.0334843" rpy="0 0 0"/>
            <mass value="0.147"/>
            <inertia ixx="0.000114686" ixy="-4.59787e-07" ixz="4.97151e-06" iyy="0.000136117" iyz="9.75275e-08" izz="0.000130364"/>
        </inertial>
        <visual>
            <origin xyz="-0.00636471 -9.94414e-05 -0.0024" rpy="1.5708 -1.67685e-15 1.5708"/>
            <geometry>
                <mesh filename="package://amr_description/meshes/so101/assets/base_motor_holder_so101_v1.stl"/>
            </geometry>
            <material name="3d_printed"/>
        </visual>
        <collision>
            <origin xyz="-0.00636471 -9.94414e-05 -0.0024" rpy="1.5708 -1.67685e-15 1.5708"/>
            <geometry>
                <mesh filename="package://amr_description/meshes/so101/assets/base_motor_holder_so101_v1.stl"/>
            </geometry>
        </collision>
        <visual>
            <origin xyz="-0.00636471 -8.97657e-09 -0.0024" rpy="1.5708 -2.78073e-29 1.5708"/>
            <geometry>
                <mesh filename="package://amr_description/meshes/so101/assets/base_so101_v2.stl"/>
            </geometry>
            <material name="3d_printed"/>
        </visual>
        <collision>
            <origin xyz="-0.00636471 -8.97657e-09 -0.0024" rpy="1.5708 -2.78073e-29 1.5708"/>
            <geometry>
                <mesh filename="package://amr_description/meshes/so101/assets/base_so101_v2.stl"/>
            </geometry>
        </collision>
        <visual>
            <origin xyz="0.0263353 -8.97657e-09 0.0437" rpy="-8.21148e-16 7.84513e-18 1.249e-15"/>
            <geometry>
                <mesh filename="package://amr_description/meshes/so101/assets/sts3215_03a_v1.stl"/>
            </geometry>
            <material name="sts3215"/>
        </visual>
        <collision>
            <origin xyz="0.0263353 -8.97657e-09 0.0437" rpy="-8.21148e-16 7.84513e-18 1.249e-15"/>
            <geometry>
                <mesh filename="package://amr_description/meshes/so101/assets/sts3215_03a_v1.stl"/>
            </geometry>
        </collision>
        <visual>
            <origin xyz="-0.0309827 -0.000199441 0.0474" rpy="1.5708 -1.35493e-14 1.5708"/>
            <geometry>
                <mesh filename="package://amr_description/meshes/so101/assets/waveshare_mounting_plate_so101_v2.stl"/>
            </geometry>
            <material name="3d_printed"/>
        </visual>
        <collision>
            <origin xyz="-0.0309827 -0.000199441 0.0474" rpy="1.5708 -1.35493e-14 1.5708"/>
            <geometry>
                <mesh filename="package://amr_description/meshes/so101/assets/waveshare_mounting_plate_so101_v2.stl"/>
            </geometry>
        </collision>
    </link>
    <link name="so101_shoulder_link">
        <inertial>
            <origin xyz="-0.0307604 -1.66727e-05 -0.0252713" rpy="0 0 0"/>
            <mass value="0.100006"/>
            <inertia ixx="8.3759e-05" ixy="7.55525e-08" ixz="-1.16342e-06" iyy="8.10403e-05" iyz="1.54663e-07" izz="2.39783e-05"/>
        </inertial>
        <visual>
            <origin xyz="-0.0303992 0.000422241 -0.0417" rpy="1.5708 1.5708 0"/>
            <geometry>
                <mesh filename="package://amr_description/meshes/so101/assets/sts3215_03a_v1.stl"/>
            </geometry>
            <material name="sts3215"/>
        </visual>
        <collision>
            <origin xyz="-0.0303992 0.000422241 -0.0417" rpy="1.5708 1.5708 0"/>
            <geometry>
                <mesh filename="package://amr_description/meshes/so101/assets/sts3215_03a_v1.stl"/>
            </geometry>
        </collision>
        <visual>
            <origin xyz="-0.0675992 -0.000177759 0.0158499" rpy="1.5708 -1.5708 0"/>
            <geometry>
                <mesh filename="package://amr_description/meshes/so101/assets/motor_holder_so101_base_v1.stl"/>
            </geometry>
            <material name="3d_printed"/>
        </visual>
        <collision>
            <origin xyz="-0.0675992 -0.000177759 0.0158499" rpy="1.5708 -1.5708 0"/>
            <geometry>
                <mesh filename="package://amr_description/meshes/so101/assets/motor_holder_so101_base_v1.stl"/>
            </geometry>
        </collision>
        <visual>
            <origin xyz="0.0122008 2.22413e-05 0.0464" rpy="-1.5708 2.35221e-33 0"/>
            <geometry>
                <mesh filename="package://amr_description/meshes/so101/assets/rotation_pitch_so101_v1.stl"/>
            </geometry>
            <material name="3d_printed"/>
        </visual>
        <collision>
            <origin xyz="0.0122008 2.22413e-05 0.0464" rpy="-1.5708 2.35221e-33 0"/>
            <geometry>
                <mesh filename="package://amr_description/meshes/so101/assets/rotation_pitch_so101_v1.stl"/>
            </geometry>
        </collision>
    </link>
    <link name="so101_upper_arm_link">
        <inertial>
            <origin xyz="-0.0898471 -0.00838224 0.0184089" rpy="0 0 0"/>
            <mass value="0.103"/>
            <inertia ixx="4.08002e-05" ixy="-1.97819e-05" ixz="-4.03016e-08" iyy="0.000147318" iyz="8.97326e-09" izz="0.000142487"/>
        </inertial>
        <visual>
            <origin xyz="-0.11257 -0.0155 0.0187" rpy="-3.14159 -5.27356e-16 -1.5708"/>
            <geometry>
                <mesh filename="package://amr_description/meshes/so101/assets/sts3215_03a_v1.stl"/>
            </geometry>
            <material name="sts3215"/>
        </visual>
        <collision>
            <origin xyz="-0.11257 -0.0155 0.0187" rpy="-3.14159 -5.27356e-16 -1.5708"/>
            <geometry>
                <mesh filename="package://amr_description/meshes/so101/assets/sts3215_03a_v1.stl"/>
            </geometry>
        </collision>
        <visual>
            <origin xyz="-0.065085 0.012 0.0182" rpy="3.14159 -0 -1.30911e-30"/>
            <geometry>
                <mesh filename="package://amr_description/meshes/so101/assets/upper_arm_so101_v1.stl"/>
            </geometry>
            <material name="3d_printed"/>
        </visual>
        <collision>
            <origin xyz="-0.065085 0.012 0.0182" rpy="3.14159 -0 -1.30911e-30"/>
            <geometry>
                <mesh filename="package://amr_description/meshes/so101/assets/upper_arm_so101_v1.stl"/>
            </geometry>
        </collision>
    </link>
    <link name="so101_lower_arm_link">
        <inertial>
            <origin xyz="-0.0980701 0.00324376 0.0182831" rpy="0 0 0"/>
            <mass value="0.104"/>
            <inertia ixx="2.87438e-05" ixy="7.41152e-06" ixz="1.26409e-06" iyy="0.000159844" iyz="-4.90188e-08" izz="0.00014529"/>
        </inertial>
        <visual>
            <origin xyz="-0.0648499 -0.032 0.0182" rpy="3.14159 -0 6.67202e-31"/>
            <geometry>
                <mesh filename="package://amr_description/meshes/so101/assets/under_arm_so101_v1.stl"/>
            </geometry>
            <material name="3d_printed"/>
        </visual>
        <collision>
            <origin xyz="-0.0648499 -0.032 0.0182" rpy="3.14159 -0 6.67202e-31"/>
            <geometry>
                <mesh filename="package://amr_description/meshes/so101/assets/under_arm_so101_v1.stl"/>
            </geometry>
        </collision>
        <visual>
            <origin xyz="-0.0648499 -0.032 0.018" rpy="-3.14159 -2.55351e-15 -1.83387e-30"/>
            <geometry>
                <mesh filename="package://amr_description/meshes/so101/assets/motor_holder_so101_wrist_v1.stl"/>
            </geometry>
            <material name="3d_printed"/>
        </visual>
        <collision>
            <origin xyz="-0.0648499 -0.032 0.018" rpy="-3.14159 -2.55351e-15 -1.83387e-30"/>
            <geometry>
                <mesh filename="package://amr_description/meshes/so101/assets/motor_holder_so101_wrist_v1.stl"/>
            </geometry>
        </collision>
        <visual>
            <origin xyz="-0.1224 0.0052 0.0187" rpy="-3.14159 -7.88861e-31 -3.14159"/>
            <geometry>
                <mesh filename="package://amr_description/meshes/so101/assets/sts3215_03a_v1.stl"/>
            </geometry>
            <material name="sts3215"/>
        </visual>
        <collision>
            <origin xyz="-0.1224 0.0052 0.0187" rpy="-3.14159 -7.88861e-31 -3.14159"/>
            <geometry>
                <mesh filename="package://amr_description/meshes/so101/assets/sts3215_03a_v1.stl"/>
            </geometry>
        </collision>
    </link>
    <link name="so101_wrist_link">
        <inertial>
            <origin xyz="-0.000103312 -0.0386143 0.0281156" rpy="0 0 0"/>
            <mass value="0.079"/>
            <inertia ixx="3.68263e-05" ixy="1.7893e-08" ixz="-5.28128e-08" iyy="2.5391e-05" iyz="3.6412e-06" izz="2.1e-05"/>
        </inertial>
        <visual>
            <origin xyz="8.32667e-17 -0.0424 0.0306" rpy="1.5708 1.5708 0"/>
            <geometry>
                <mesh filename="package://amr_description/meshes/so101/assets/sts3215_03a_no_horn_v1.stl"/>
            </geometry>
            <material name="sts3215"/>
        </visual>
        <collision>
            <origin xyz="8.32667e-17 -0.0424 0.0306" rpy="1.5708 1.5708 0"/>
            <geometry>
                <mesh filename="package://amr_description/meshes/so101/assets/sts3215_03a_no_horn_v1.stl"/>
            </geometry>
        </collision>
        <visual>
            <origin xyz="0 -0.028 0.0181" rpy="-1.5708 -1.5708 0"/>
            <geometry>
                <mesh filename="package://amr_description/meshes/so101/assets/wrist_roll_pitch_so101_v2.stl"/>
            </geometry>
            <material name="3d_printed"/>
        </visual>
        <collision>
            <origin xyz="0 -0.028 0.0181" rpy="-1.5708 -1.5708 0"/>
            <geometry>
                <mesh filename="package://amr_description/meshes/so101/assets/wrist_roll_pitch_so101_v2.stl"/>
            </geometry>
        </collision>
    </link>
    <link name="so101_gripper_link">
        <inertial>
            <origin xyz="0.000213627 0.000245138 -0.025187" rpy="0 0 0"/>
            <mass value="0.087"/>
            <inertia ixx="2.75087e-05" ixy="-3.35241e-07" ixz="-5.7352e-06" iyy="4.33657e-05" iyz="-5.17847e-08" izz="3.45059e-05"/>
        </inertial>
        <visual>
            <origin xyz="0.0077 0.0001 -0.0234" rpy="-1.5708 -5.19179e-17 -1.66533e-16"/>
            <geometry>
                <mesh filename="package://amr_description/meshes/so101/assets/sts3215_03a_v1.stl"/>
            </geometry>
            <material name="sts3215"/>
        </visual>
        <collision>
            <origin xyz="0.0077 0.0001 -0.0234" rpy="-1.5708 -5.19179e-17 -1.66533e-16"/>
            <geometry>
                <mesh filename="package://amr_description/meshes/so101/assets/sts3215_03a_v1.stl"/>
            </geometry>
        </collision>
        <visual>
            <origin xyz="8.32667e-17 -0.000218214 0.000949706" rpy="-3.14159 -5.55112e-17 0"/>
            <geometry>
                <mesh filename="package://amr_description/meshes/so101/assets/wrist_roll_follower_so101_v1.stl"/>
            </geometry>
            <material name="3d_printed"/>
        </visual>
        <collision>
            <origin xyz="8.32667e-17 -0.000218214 0.000949706" rpy="-3.14159 -5.55112e-17 0"/>
            <geometry>
                <mesh filename="package://amr_description/meshes/so101/assets/wrist_roll_follower_so101_v1.stl"/>
            </geometry>
        </collision>
    </link>
    <link name="so101_gripper_frame_link">
        <origin xyz="0 0 0" rpy="0 -0 0"/>
        <inertial>
            <origin xyz="0 0 0" rpy="0 0 0"/>
            <mass value="1e-9"/>
            <inertia ixx="0" ixy="0" ixz="0" iyy="0" iyz="0" izz="0"/>
        </inertial>
    </link>
    <joint name="so101_gripper_frame_joint" type="fixed">
        <origin xyz="-0.0079 -0.000218121 -0.0981274" rpy="0 3.14159 0"/>
        <parent link="so101_gripper_link"/>
        <child link="so101_gripper_frame_link"/>
        <axis xyz="0 0 0"/>
    </joint>
    <link name="so101_moving_jaw_so101_v1_link">
        <inertial>
            <origin xyz="-0.00157495 -0.0300244 0.0192755" rpy="0 0 0"/>
            <mass value="0.012"/>
            <inertia ixx="6.61427e-06" ixy="-3.19807e-07" ixz="-5.90717e-09" iyy="1.89032e-06" iyz="-1.09945e-07" izz="5.28738e-06"/>
        </inertial>
        <visual>
            <origin xyz="-5.55112e-17 -5.55112e-17 0.0189" rpy="9.53145e-17 6.93889e-18 1.24077e-24"/>
            <geometry>
                <mesh filename="package://amr_description/meshes/so101/assets/moving_jaw_so101_v1.stl"/>
            </geometry>
            <material name="3d_printed"/>
        </visual>
        <collision>
            <origin xyz="-5.55112e-17 -5.55112e-17 0.0189" rpy="9.53145e-17 6.93889e-18 1.24077e-24"/>
            <geometry>
                <mesh filename="package://amr_description/meshes/so101/assets/moving_jaw_so101_v1.stl"/>
            </geometry>
        </collision>
    </link>
    <joint name="so101_gripper" type="revolute">
        <origin xyz="0.0202 0.0188 -0.0234" rpy="1.5708 -5.24284e-08 -1.41553e-15"/>
        <parent link="so101_gripper_link"/>
        <child link="so101_moving_jaw_so101_v1_link"/>
        <axis xyz="0 0 1"/>
        <limit effort="10" velocity="10" lower="-0.174533" upper="1.74533"/>
    </joint>
    <transmission name="so101_gripper_trans">
        <type>transmission_interface/SimpleTransmission</type>
        <joint name="so101_gripper">
            <hardwareInterface>hardware_interface/PositionJointInterface</hardwareInterface>
        </joint>
        <actuator name="so101_motor6">
            <hardwareInterface>hardware_interface/PositionJointInterface</hardwareInterface>
            <mechanicalReduction>1</mechanicalReduction>
        </actuator>
    </transmission>
    <joint name="so101_wrist_roll" type="revolute">
        <origin xyz="5.55112e-17 -0.0611 0.0181" rpy="1.5708 0.0486795 3.14159"/>
        <parent link="so101_wrist_link"/>
        <child link="so101_gripper_link"/>
        <axis xyz="0 0 1"/>
        <limit effort="10" velocity="10" lower="-2.74385" upper="2.84121"/>
    </joint>
    <transmission name="so101_wrist_roll_trans">
        <type>transmission_interface/SimpleTransmission</type>
        <joint name="so101_wrist_roll">
            <hardwareInterface>hardware_interface/PositionJointInterface</hardwareInterface>
        </joint>
        <actuator name="so101_motor5">
            <hardwareInterface>hardware_interface/PositionJointInterface</hardwareInterface>
            <mechanicalReduction>1</mechanicalReduction>
        </actuator>
    </transmission>
    <joint name="so101_wrist_flex" type="revolute">
        <origin xyz="-0.1349 0.0052 3.62355e-17" rpy="4.02456e-15 8.67362e-16 -1.5708"/>
        <parent link="so101_lower_arm_link"/>
        <child link="so101_wrist_link"/>
        <axis xyz="0 0 1"/>
        <limit effort="10" velocity="10" lower="-1.65806" upper="1.65806"/>
    </joint>
    <transmission name="so101_wrist_flex_trans">
        <type>transmission_interface/SimpleTransmission</type>
        <joint name="so101_wrist_flex">
            <hardwareInterface>hardware_interface/PositionJointInterface</hardwareInterface>
        </joint>
        <actuator name="so101_motor4">
            <hardwareInterface>hardware_interface/PositionJointInterface</hardwareInterface>
            <mechanicalReduction>1</mechanicalReduction>
        </actuator>
    </transmission>
    <joint name="so101_elbow_flex" type="revolute">
        <origin xyz="-0.11257 -0.028 1.73763e-16" rpy="-3.63608e-16 8.74301e-16 1.5708"/>
        <parent link="so101_upper_arm_link"/>
        <child link="so101_lower_arm_link"/>
        <axis xyz="0 0 1"/>
        <limit effort="10" velocity="10" lower="-1.69" upper="1.69"/>
    </joint>
    <transmission name="so101_elbow_flex_trans">
        <type>transmission_interface/SimpleTransmission</type>
        <joint name="so101_elbow_flex">
            <hardwareInterface>hardware_interface/PositionJointInterface</hardwareInterface>
        </joint>
        <actuator name="so101_motor3">
            <hardwareInterface>hardware_interface/PositionJointInterface</hardwareInterface>
            <mechanicalReduction>1</mechanicalReduction>
        </actuator>
    </transmission>
    <joint name="so101_shoulder_lift" type="revolute">
        <origin xyz="-0.0303992 -0.0182778 -0.0542" rpy="-1.5708 -1.5708 0"/>
        <parent link="so101_shoulder_link"/>
        <child link="so101_upper_arm_link"/>
        <axis xyz="0 0 1"/>
        <limit effort="10" velocity="10" lower="-1.74533" upper="1.74533"/>
    </joint>
    <transmission name="so101_shoulder_lift_trans">
        <type>transmission_interface/SimpleTransmission</type>
        <joint name="so101_shoulder_lift">
            <hardwareInterface>hardware_interface/PositionJointInterface</hardwareInterface>
        </joint>
        <actuator name="so101_motor2">
            <hardwareInterface>hardware_interface/PositionJointInterface</hardwareInterface>
            <mechanicalReduction>1</mechanicalReduction>
        </actuator>
    </transmission>
    <joint name="so101_shoulder_pan" type="revolute">
        <origin xyz="0.0388353 -8.97657e-09 0.0624" rpy="3.14159 4.18253e-17 -3.14159"/>
        <parent link="so101_base_link"/>
        <child link="so101_shoulder_link"/>
        <axis xyz="0 0 1"/>
        <limit effort="10" velocity="10" lower="-1.91986" upper="1.91986"/>
    </joint>
    <transmission name="so101_shoulder_pan_trans">
        <type>transmission_interface/SimpleTransmission</type>
        <joint name="so101_shoulder_pan">
            <hardwareInterface>hardware_interface/PositionJointInterface</hardwareInterface>
        </joint>
        <actuator name="so101_motor1">
            <hardwareInterface>hardware_interface/PositionJointInterface</hardwareInterface>
            <mechanicalReduction>1</mechanicalReduction>
        </actuator>
    </transmission>

    <link name="so101_tool0"/>

    <joint name="so101_tool0_joint" type="fixed">
      <parent link="so101_gripper_frame_link"/>
      <child link="so101_tool0"/>
      <origin xyz="0 0 0" rpy="0 0 0"/>
    </joint>

    <link name="so101_wrist_camera_link">
      <visual>
        <origin xyz="0 0 0" rpy="0 0 0"/>
        <geometry>
          <box size="0.030 0.030 0.020"/>
        </geometry>
        <material name="so101_camera_black">
          <color rgba="0.02 0.02 0.025 1.0"/>
        </material>
      </visual>
      <collision>
        <origin xyz="0 0 0" rpy="0 0 0"/>
        <geometry>
          <box size="0.030 0.030 0.020"/>
        </geometry>
      </collision>
    </link>

    <joint name="so101_wrist_camera_joint" type="fixed">
      <parent link="so101_gripper_link"/>
      <child link="so101_wrist_camera_link"/>
      <origin xyz="-0.050 0.0 -0.025" rpy="0 0 0"/>
    </joint>

    <link name="so101_wrist_camera_optical_frame"/>

    <joint name="so101_wrist_camera_optical_joint" type="fixed">
      <parent link="so101_wrist_camera_link"/>
      <child link="so101_wrist_camera_optical_frame"/>
      <origin xyz="0 0 0" rpy="-1.5708 0 -1.5708"/>
    </joint>
  </xacro:macro>
</robot>
