KartikMehta-1/AMR-development/ros_ws/src/amr_description/urdf/wheels.xacro

<?xml version="1.0"?>
<robot xmlns:xacro="http://www.ros.org/wiki/xacro">
  <xacro:macro name="wheels">
    <link name="left_wheel_link">
      <visual>
        <origin xyz="0 0 0" rpy="1.5708 0 0"/>
        <geometry>
          <cylinder length="${wheel_width}" radius="${wheel_radius}"/>
        </geometry>
        <material name="black">
          <color rgba="0.1 0.1 0.1 1.0"/>
        </material>
      </visual>
      <collision>
        <origin xyz="0 0 0" rpy="1.5708 0 0"/>
        <geometry>
          <cylinder length="${wheel_width}" radius="${wheel_radius}"/>
        </geometry>
      </collision>
      <inertial>
        <origin xyz="0 0 0" rpy="0 0 0"/>
        <mass value="${wheel_mass}"/>
        <inertia ixx="${(1.0/12.0) * wheel_mass * (3 * wheel_radius * wheel_radius + wheel_width * wheel_width)}" iyy="${0.5 * wheel_mass * wheel_radius * wheel_radius}" izz="${(1.0/12.0) * wheel_mass * (3 * wheel_radius * wheel_radius + wheel_width * wheel_width)}" ixy="0.0" ixz="0.0" iyz="0.0"/>
      </inertial>
    </link>

    <link name="right_wheel_link">
      <visual>
        <origin xyz="0 0 0" rpy="1.5708 0 0"/>
        <geometry>
          <cylinder length="${wheel_width}" radius="${wheel_radius}"/>
        </geometry>
        <material name="black"/>
      </visual>
      <collision>
        <origin xyz="0 0 0" rpy="1.5708 0 0"/>
        <geometry>
          <cylinder length="${wheel_width}" radius="${wheel_radius}"/>
        </geometry>
      </collision>
      <inertial>
        <origin xyz="0 0 0" rpy="0 0 0"/>
        <mass value="${wheel_mass}"/>
        <inertia ixx="${(1.0/12.0) * wheel_mass * (3 * wheel_radius * wheel_radius + wheel_width * wheel_width)}" iyy="${0.5 * wheel_mass * wheel_radius * wheel_radius}" izz="${(1.0/12.0) * wheel_mass * (3 * wheel_radius * wheel_radius + wheel_width * wheel_width)}" ixy="0.0" ixz="0.0" iyz="0.0"/>
      </inertial>
    </link>

    <joint name="left_wheel_joint" type="continuous">
      <parent link="base_link"/>
      <child link="left_wheel_link"/>
      <origin xyz="0 ${wheel_y_offset} ${wheel_z}" rpy="0 0 0"/>
      <axis xyz="0 1 0"/>
    </joint>

    <joint name="right_wheel_joint" type="continuous">
      <parent link="base_link"/>
      <child link="right_wheel_link"/>
      <origin xyz="0 ${-wheel_y_offset} ${wheel_z}" rpy="0 0 0"/>
      <axis xyz="0 1 0"/>
    </joint>

    <!-- Gazebo surface parameters for wheel traction -->
    <gazebo reference="left_wheel_link">
      <mu1>${wheel_mu1}</mu1>
      <mu2>${wheel_mu2}</mu2>
    </gazebo>

    <gazebo reference="right_wheel_link">
      <mu1>${wheel_mu1}</mu1>
      <mu2>${wheel_mu2}</mu2>
    </gazebo>
  </xacro:macro>
</robot>
