KartikMehta-1/AMR-development/PCB/AMR_pcb/AMR_pcb.kicad_pcb

## KiCad design Kicad/Data Logger/Data Logger.kicad_sch

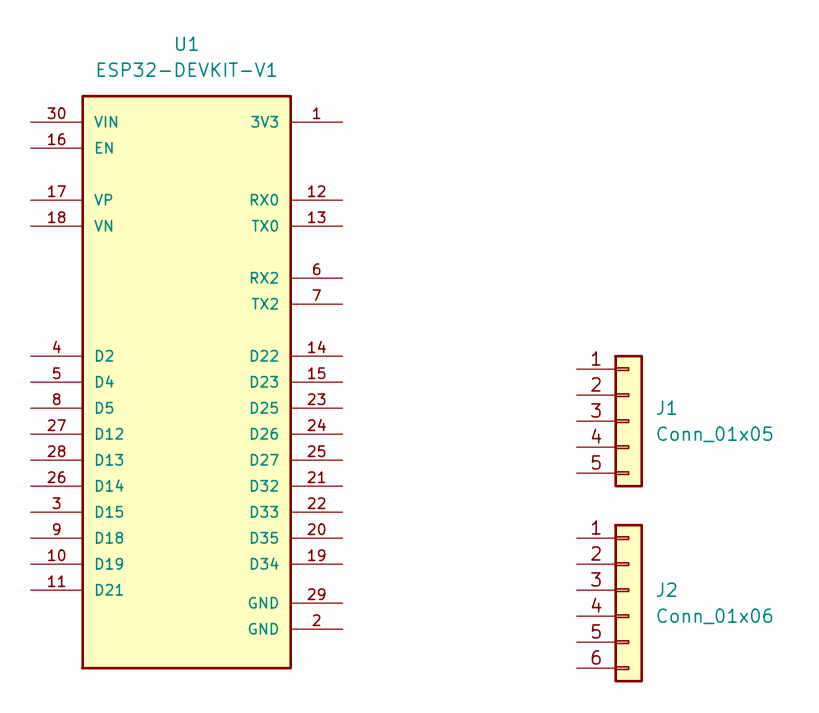
[picture p136: schematic Data Logger.kicad_sch]

Parts:
J1: Conn_01x05
J2: Conn_01x06
U1: ESP32-DEVKIT-V1; MODULE_ESP32_DEVKIT_V1; PARTREV N/A
