KartikMehta-1/AMR-development/ros_ws/src/amr_description/config/ros2_control.yaml

controller_manager:
  ros__parameters:
    update_rate: 50
    use_sim_time: false

    joint_state_broadcaster:
      type: joint_state_broadcaster/JointStateBroadcaster

    diff_drive_controller:
      type: diff_drive_controller/DiffDriveController

diff_drive_controller:
  ros__parameters:
    left_wheel_names: ["left_wheel_joint"]
    right_wheel_names: ["right_wheel_joint"]
    wheel_separation: 0.381
    wheel_radius: 0.0615
    publish_rate: 50.0
    base_frame_id: base_footprint
    odom_frame_id: odom
    enable_odom_tf: true
    cmd_vel_timeout: 0.5
    use_stamped_vel: false
    # Avoid uninitialized covariance values in /odom.
    pose_covariance_diagonal: [0.01, 0.01, 1000000.0, 1000000.0, 1000000.0, 0.02]
    twist_covariance_diagonal: [0.02, 0.02, 1000000.0, 1000000.0, 1000000.0, 0.04]
    # Match STM command ramping (V_CMD_RAMP_RATE_MPS / W_CMD_RAMP_RATE_RAD)
    linear.x.has_acceleration_limits: true
    linear.x.max_acceleration: 2.0
    linear.x.min_acceleration: -2.0
    angular.z.has_acceleration_limits: true
    angular.z.max_acceleration: 2.0
    angular.z.min_acceleration: -2.0
