KartikMehta-1/AMR-development/STM/STM_Firmware_AMR_v2/Core/Src/main.c

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
/* Includes ------------------------------------------------------------------*/
#include "main.h"
#include "cmsis_os.h"

/* USER CODE BEGIN Includes */
#include <stdbool.h>
#include <stdint.h>
#include <string.h>
#include <math.h>
#include <rcl/rcl.h>
#include <rclc/rclc.h>
#include <rclc/executor.h>
#include <std_msgs/msg/int32.h>
#include <std_msgs/msg/float32.h>
#include <std_msgs/msg/bool.h>
#include <std_msgs/msg/empty.h>
#include <std_msgs/msg/u_int32.h>
#include <std_msgs/msg/u_int32_multi_array.h>
#include <geometry_msgs/msg/twist.h>
#include <sensor_msgs/msg/joint_state.h>
#include <uxr/client/transport.h>
#include <rcutils/allocator.h>
#include <rcutils/error_handling.h>
#include <rosidl_runtime_c/string_functions.h>
#include <rosidl_runtime_c/primitives_sequence_functions.h>
#include <rmw_microros/rmw_microros.h>
#include "motor.h"
#include "encoder.h"
#include "app_config.h"
#include "current_sense.h"
#include "telemetry.h"
#include "ramp.h"
#include "pid.h"
#include "control_state.h"
#include "sensing.h"
#include "fault_monitor.h"
#include "control_loop.h"
/* USER CODE END Includes */

typedef StaticTask_t osStaticThreadDef_t;
/* USER CODE BEGIN PD */
#define ROS_INIT_RETRY_DELAY_MS 2000U
#define ROS_DIAG_BOOT_BLINK_COUNT 3U
#define ROS_DIAG_BOOT_BLINK_ON_MS 120U
#define ROS_DIAG_BOOT_BLINK_OFF_MS 120U
#define ROS_DIAG_BOOT_SETTLE_MS 500U
#define ROS_INIT_FAIL_BLINK_ON_MS 300U
#define ROS_INIT_FAIL_BLINK_OFF_MS 300U
#define ROS_INIT_FAIL_GAP_MS 1500U
#define ROS_INIT_AUTO_RESET 0
#define ROS_AGENT_PING_TIMEOUT_MS 100U
#define ROS_AGENT_PING_ATTEMPTS 1U
#define ROS_AGENT_PING_RETRY_MS 250U
#define ROS_AGENT_RUNTIME_PING_PERIOD_MS 1000U
#define ROS_AGENT_RUNTIME_PING_FAIL_LIMIT 3U
#define ROS_AGENT_RUNTIME_PING_ENABLE 0
#define ROS_TRANSPORT_COUNTER_RECONNECT_ENABLE 0
#define ROS_RECONNECT_DELAY_MS 500U
#define ROS_PUBLISH_FAIL_RESET_COUNT 5U
#define ROS_PUBLISH_FAIL_RESET_DELAY_MS 100U
#define RESET_CAUSE_BOR   (1U << 0)
#define RESET_CAUSE_PIN   (1U << 1)
#define RESET_CAUSE_POR   (1U << 2)
#define RESET_CAUSE_SOFT  (1U << 3)
#define RESET_CAUSE_IWDG  (1U << 4)
#define RESET_CAUSE_WWDG  (1U << 5)
#define RESET_CAUSE_LPWR  (1U << 6)
/* USER CODE END PD */

ADC_HandleTypeDef hadc1;
DMA_HandleTypeDef hdma_adc1;

TIM_HandleTypeDef htim1;
TIM_HandleTypeDef htim2;
TIM_HandleTypeDef htim3;
TIM_HandleTypeDef htim4;

UART_HandleTypeDef huart2;
DMA_HandleTypeDef hdma_usart2_rx;
DMA_HandleTypeDef hdma_usart2_tx;

/* Definitions for control_task */
osThreadId_t control_taskHandle;
uint32_t control_taskBuffer[ 1500 ];
osStaticThreadDef_t control_taskControlBlock;
const osThreadAttr_t control_task_attributes = {
  .name = "control_task",
  .cb_mem = &control_taskControlBlock,
  .cb_size = sizeof(control_taskControlBlock),
  .stack_mem = &control_taskBuffer[0],
  .stack_size = sizeof(control_taskBuffer),
  .priority = (osPriority_t) osPriorityHigh,
};
/* Definitions for ros_exec_task */
/* Definitions for ros_pub_task */
osThreadId_t ros_pub_taskHandle;
uint32_t ros_pub_taskBuffer[ 2816 ];
osStaticThreadDef_t ros_pub_taskControlBlock;
const osThreadAttr_t ros_pub_task_attributes = {
  .name = "ros_pub_task",
  .cb_mem = &ros_pub_taskControlBlock,
  .cb_size = sizeof(ros_pub_taskControlBlock),
  .stack_mem = &ros_pub_taskBuffer[0],
  .stack_size = sizeof(ros_pub_taskBuffer),
  .priority = (osPriority_t) osPriorityHigh,
};
#if SERIAL_TELEMETRY_ENABLE
/* Definitions for telemetry_task */
osThreadId_t telemetry_taskHandle;
uint32_t telemetry_taskBuffer[ 1200 ];
osStaticThreadDef_t telemetry_taskControlBlock;
const osThreadAttr_t telemetry_task_attributes = {
  .name = "telemetry_task",
  .cb_mem = &telemetry_taskControlBlock,
  .cb_size = sizeof(telemetry_taskControlBlock),
  .stack_mem = &telemetry_taskBuffer[0],
  .stack_size = sizeof(telemetry_taskBuffer),
  .priority = (osPriority_t) osPriorityLow,
};
#endif
/* USER CODE BEGIN PV */
static uint32_t last_header_tick = 0;
static volatile uint8_t control_tick_flag = 0;
static volatile uint32_t control_tick_count = 0;
static volatile float control_tick_hz = 0.0f;
static volatile uint32_t control_tick_missed = 0;
static volatile uint32_t control_loop_count = 0;
static volatile uint32_t control_tick_lag = 0;
static volatile uint32_t control_tick_lag_max = 0;
static volatile uint32_t control_loop_last_ms = 0;
static volatile uint32_t control_loop_max_ms = 0;
static volatile float dbg_v_cmd_mps = 0.0f;
static volatile float dbg_w_cmd_rps = 0.0f;
static volatile float dbg_v_l_mps = 0.0f;
static volatile float dbg_v_r_mps = 0.0f;
static volatile float dbg_rpm_target_l = 0.0f;
static volatile float dbg_rpm_target_r = 0.0f;
static volatile float dbg_rpm_meas_l = 0.0f;
static volatile float dbg_rpm_meas_r = 0.0f;
static volatile float dbg_pid_p_l = 0.0f;
static volatile float dbg_pid_i_l = 0.0f;
static volatile float dbg_pid_d_l = 0.0f;
static volatile float dbg_pid_err_l = 0.0f;
static volatile float dbg_pid_out_l = 0.0f;
static volatile float dbg_pid_p_r = 0.0f;
static volatile float dbg_pid_i_r = 0.0f;
static volatile float dbg_pid_d_r = 0.0f;
static volatile float dbg_pid_err_r = 0.0f;
static volatile float dbg_pid_out_r = 0.0f;
static volatile float dbg_duty_cmd_l = 0.0f;
static volatile float dbg_duty_cmd_r = 0.0f;
static volatile uint8_t dbg_dir_l = 0U;
static volatile uint8_t dbg_dir_r = 0U;
//static uint32_t telemetry_decim_counter = 0;
static EncoderChannel enc_left;
static EncoderChannel enc_right;
static CurrentSense current_sense;
static ControlStateMgr ctrl_state;
static Sensing sensing;
static SensingData sense;
static FaultMonitor fault_mon;
static ControlLoop control_loop;
static MotorChannel m_left;
static MotorChannel m_right;
static rcl_allocator_t ros_allocator;
static rclc_support_t ros_support;
static rcl_node_t ros_node;
static rclc_executor_t ros_executor;
static rcl_publisher_t pub_fault_mask;
static rcl_publisher_t pub_current_left;
static rcl_publisher_t pub_current_right;
static rcl_publisher_t pub_current_left_adc;
static rcl_publisher_t pub_current_right_adc;
static rcl_publisher_t pub_current_left_zero;
static rcl_publisher_t pub_current_right_zero;
static rcl_publisher_t pub_duty_left;
static rcl_publisher_t pub_duty_right;
static rcl_publisher_t pub_wheel_state;
static rcl_publisher_t pub_safety_state;
static rcl_publisher_t pub_ros_diag;
static rcl_subscription_t sub_wheel_cmd_left;
static rcl_subscription_t sub_wheel_cmd_right;
static rcl_subscription_t sub_enable;
static rcl_subscription_t sub_estop;
static rcl_subscription_t sub_clear_fault;
static std_msgs__msg__Int32 msg_fault_mask;
static std_msgs__msg__Int32 msg_current_left;
static std_msgs__msg__Int32 msg_current_right;
static std_msgs__msg__UInt32 msg_current_left_adc;
static std_msgs__msg__UInt32 msg_current_right_adc;
static std_msgs__msg__UInt32 msg_current_left_zero;
static std_msgs__msg__UInt32 msg_current_right_zero;
static std_msgs__msg__Float32 msg_duty_left;
static std_msgs__msg__Float32 msg_duty_right;
static std_msgs__msg__Float32 msg_wheel_cmd_left;
static std_msgs__msg__Float32 msg_wheel_cmd_right;
static sensor_msgs__msg__JointState msg_wheel_state;
static std_msgs__msg__UInt32 msg_safety_state;
static std_msgs__msg__UInt32MultiArray msg_ros_diag;
static std_msgs__msg__Bool msg_enable;
static std_msgs__msg__Bool msg_estop;
static std_msgs__msg__Empty msg_clear_fault;
static volatile bool ros_ready = false;
static volatile bool ros_entities_created = false;
static bool ros_wheel_state_msg_initialized = false;
static bool ros_diag_msg_initialized = false;
static uint32_t ros_diag_data[20];
static volatile uint32_t boot_reset_csr = 0U;
static volatile uint32_t boot_reset_cause = 0U;
static volatile int ros_init_fail_stage = 0;
static volatile uint32_t ros_agent_ping_failures = 0U;
static volatile float wheel_cmd_l_rad_s = 0.0f;
static volatile float wheel_cmd_r_rad_s = 0.0f;
static volatile uint32_t last_wheel_cmd_ms = 0U;
static volatile float duty_cmd_l_pub = 0.0f;
static volatile float duty_cmd_r_pub = 0.0f;
static volatile bool enable_cmd = true;
static volatile bool soft_estop_cmd = false;
static volatile bool clear_fault_cmd = false;
/* USER CODE END PV */

void SystemClock_Config(void);
static void MX_GPIO_Init(void);
static void MX_DMA_Init(void);
static void MX_USART2_UART_Init(void);
static void MX_ADC1_Init(void);
static void MX_TIM1_Init(void);
static void MX_TIM2_Init(void);
static void MX_TIM3_Init(void);
static void MX_TIM4_Init(void);
void StartControlTask(void *argument);
void StartRosPubTask(void *argument);
#if SERIAL_TELEMETRY_ENABLE
void StartTelemetryTask(void *argument);
#endif
void WheelCmdLeftCallback(const void * msgin);
void WheelCmdRightCallback(const void * msgin);
void EnableCallback(const void * msgin);
void EstopCallback(const void * msgin);
void ClearFaultCallback(const void * msgin);

/* USER CODE BEGIN PFP */

bool cubemx_transport_open(struct uxrCustomTransport * transport);
bool cubemx_transport_close(struct uxrCustomTransport * transport);
size_t cubemx_transport_write(struct uxrCustomTransport* transport, const uint8_t * buf, size_t len, uint8_t * err);
size_t cubemx_transport_read(struct uxrCustomTransport* transport, uint8_t* buf, size_t len, int timeout, uint8_t* err);
void microros_transport_reset(UART_HandleTypeDef * uart);
void * microros_allocate(size_t size, void * state);
void microros_deallocate(void * pointer, void * state);
void * microros_reallocate(void * pointer, size_t size, void * state);
void * microros_zero_allocate(size_t number_of_elements, size_t size_of_element, void * state);
extern volatile uint32_t microros_transport_open_calls;
extern volatile uint32_t microros_transport_open_failures;
extern volatile uint32_t microros_transport_last_open_status;
extern volatile uint32_t microros_transport_write_calls;
extern volatile uint32_t microros_transport_write_failures;
extern volatile uint32_t microros_transport_write_success_bytes;
extern volatile uint32_t microros_transport_write_timeouts;
extern volatile uint32_t microros_transport_last_write_status;
extern volatile uint32_t microros_transport_read_calls;
extern volatile uint32_t microros_transport_read_nonzero_calls;
extern volatile uint32_t microros_transport_read_success_bytes;

static void CaptureAndClearResetCause(void);

static void CaptureAndClearResetCause(void)
{
  uint32_t csr = RCC->CSR;
  uint32_t cause = 0U;

  if ((csr & RCC_CSR_BORRSTF) != 0U) {
    cause |= RESET_CAUSE_BOR;
  }
  if ((csr & RCC_CSR_PINRSTF) != 0U) {
    cause |= RESET_CAUSE_PIN;
  }
  if ((csr & RCC_CSR_PORRSTF) != 0U) {
    cause |= RESET_CAUSE_POR;
  }
  if ((csr & RCC_CSR_SFTRSTF) != 0U) {
    cause |= RESET_CAUSE_SOFT;
  }
  if ((csr & RCC_CSR_IWDGRSTF) != 0U) {
    cause |= RESET_CAUSE_IWDG;
  }
  if ((csr & RCC_CSR_WWDGRSTF) != 0U) {
    cause |= RESET_CAUSE_WWDG;
  }
  if ((csr & RCC_CSR_LPWRRSTF) != 0U) {
    cause |= RESET_CAUSE_LPWR;
  }

  boot_reset_csr = csr;
  boot_reset_cause = cause;
  __HAL_RCC_CLEAR_RESET_FLAGS();
}

static void Ros_ResetEntityHandles(void)
{
  memset(&ros_support, 0, sizeof(ros_support));
  ros_node = rcl_get_zero_initialized_node();
  ros_executor = rclc_executor_get_zero_initialized_executor();

  pub_fault_mask = rcl_get_zero_initialized_publisher();
  pub_current_left = rcl_get_zero_initialized_publisher();
  pub_current_right = rcl_get_zero_initialized_publisher();
  pub_current_left_adc = rcl_get_zero_initialized_publisher();
  pub_current_right_adc = rcl_get_zero_initialized_publisher();
  pub_current_left_zero = rcl_get_zero_initialized_publisher();
  pub_current_right_zero = rcl_get_zero_initialized_publisher();
  pub_duty_left = rcl_get_zero_initialized_publisher();
  pub_duty_right = rcl_get_zero_initialized_publisher();
  pub_wheel_state = rcl_get_zero_initialized_publisher();
  pub_safety_state = rcl_get_zero_initialized_publisher();
  pub_ros_diag = rcl_get_zero_initialized_publisher();

  sub_wheel_cmd_left = rcl_get_zero_initialized_subscription();
  sub_wheel_cmd_right = rcl_get_zero_initialized_subscription();
  sub_enable = rcl_get_zero_initialized_subscription();
  sub_estop = rcl_get_zero_initialized_subscription();
  sub_clear_fault = rcl_get_zero_initialized_subscription();
}

static void Ros_StopForReconnect(void)
{
  wheel_cmd_l_rad_s = 0.0f;
  wheel_cmd_r_rad_s = 0.0f;
  last_wheel_cmd_ms = 0U;
}

static void Ros_DestroyEntities(void)
{
  ros_ready = false;

  if (ros_entities_created) {
    (void)rclc_executor_fini(&ros_executor);

    (void)rcl_subscription_fini(&sub_clear_fault, &ros_node);
    (void)rcl_subscription_fini(&sub_estop, &ros_node);
    (void)rcl_subscription_fini(&sub_enable, &ros_node);
    (void)rcl_subscription_fini(&sub_wheel_cmd_right, &ros_node);
    (void)rcl_subscription_fini(&sub_wheel_cmd_left, &ros_node);

    (void)rcl_publisher_fini(&pub_ros_diag, &ros_node);
    (void)rcl_publisher_fini(&pub_safety_state, &ros_node);
    (void)rcl_publisher_fini(&pub_wheel_state, &ros_node);
    (void)rcl_publisher_fini(&pub_duty_right, &ros_node);
    (void)rcl_publisher_fini(&pub_duty_left, &ros_node);
    (void)rcl_publisher_fini(&pub_current_right_zero, &ros_node);
    (void)rcl_publisher_fini(&pub_current_left_zero, &ros_node);
    (void)rcl_publisher_fini(&pub_current_right_adc, &ros_node);
    (void)rcl_publisher_fini(&pub_current_left_adc, &ros_node);
    (void)rcl_publisher_fini(&pub_current_right, &ros_node);
    (void)rcl_publisher_fini(&pub_current_left, &ros_node);
    (void)rcl_publisher_fini(&pub_fault_mask, &ros_node);

    (void)rcl_node_fini(&ros_node);
    (void)rclc_support_fini(&ros_support);
  }

  ros_entities_created = false;
  Ros_ResetEntityHandles();
  microros_transport_reset(&huart2);
}
/* USER CODE END PFP */

/* USER CODE BEGIN 0 */
/* Current sensing moved to current_sense.c */

static void StatusLed_Set(GPIO_PinState state)
{
  HAL_GPIO_WritePin(LED_STATUS_GPIO_Port, LED_STATUS_Pin, state);
}

static void StatusLed_Blink(uint32_t on_ms, uint32_t off_ms)
{
  StatusLed_Set(GPIO_PIN_SET);
  osDelay(on_ms);
  StatusLed_Set(GPIO_PIN_RESET);
  osDelay(off_ms);
}

static void StatusLed_BlinkCount(uint32_t count, uint32_t on_ms, uint32_t off_ms, uint32_t gap_ms)
{
  for (uint32_t i = 0; i < count; ++i) {
    StatusLed_Blink(on_ms, off_ms);
  }
  osDelay(gap_ms);
}

static void StatusLed_BootSignature(void)
{
  for (uint32_t i = 0; i < ROS_DIAG_BOOT_BLINK_COUNT; ++i) {
    StatusLed_Blink(ROS_DIAG_BOOT_BLINK_ON_MS, ROS_DIAG_BOOT_BLINK_OFF_MS);
  }
  osDelay(ROS_DIAG_BOOT_SETTLE_MS);
}

void WheelCmdLeftCallback(const void * msgin)
{
  const std_msgs__msg__Float32 * msg = (const std_msgs__msg__Float32 *)msgin;
  wheel_cmd_l_rad_s = WHEEL_CMD_L_POLARITY * msg->data;
  last_wheel_cmd_ms = HAL_GetTick();
}

void WheelCmdRightCallback(const void * msgin)
{
  const std_msgs__msg__Float32 * msg = (const std_msgs__msg__Float32 *)msgin;
  wheel_cmd_r_rad_s = WHEEL_CMD_R_POLARITY * msg->data;
  last_wheel_cmd_ms = HAL_GetTick();
}

void EnableCallback(const void * msgin)
{
  const std_msgs__msg__Bool * msg = (const std_msgs__msg__Bool *)msgin;
  enable_cmd = msg->data;
}

void EstopCallback(const void * msgin)
{
  const std_msgs__msg__Bool * msg = (const std_msgs__msg__Bool *)msgin;
  soft_estop_cmd = msg->data;
}

void ClearFaultCallback(const void * msgin)
{
  (void)msgin;
  clear_fault_cmd = true;
}
/* USER CODE END 0 */

/**
  * @brief  The application entry point.
  * @retval int
  */
int main(void)
{

  /* USER CODE BEGIN 1 */
  CaptureAndClearResetCause();

  /* USER CODE END 1 */

  /* MCU Configuration--------------------------------------------------------*/

  /* Reset of all peripherals, Initializes the Flash interface and the Systick. */
  HAL_Init();

  /* Configure the system clock */
  SystemClock_Config();

  /* Initialize all configured peripherals */
  MX_GPIO_Init();
  MX_DMA_Init();
  MX_USART2_UART_Init();
  MX_ADC1_Init();
  MX_TIM1_Init();
  MX_TIM2_Init();
  MX_TIM3_Init();
  MX_TIM4_Init();
  /* USER CODE BEGIN 2 */
  // Initialize and run both motors at 10% duty (Cytron MDD20A)
  // Left motor (M1): PA8 PWM (TIM1_CH1), PB4 DIR
  Motor_Init(&m_left, &htim1, TIM_CHANNEL_1, DIR_LEFT_GPIO_Port, DIR_LEFT_Pin, __HAL_TIM_GET_AUTORELOAD(&htim1));
  Motor_SetDirection(&m_left, LEFT_DIR_POLARITY);   // forward (adjust if wiring requires inversion)
  Motor_SetDuty(&m_left, 0.0f);     // keep off initially

  // Right motor (M2): PA9 PWM (TIM1_CH2), PB5 DIR
  Motor_Init(&m_right, &htim1, TIM_CHANNEL_2, DIR_RIGHT_GPIO_Port, DIR_RIGHT_Pin, __HAL_TIM_GET_AUTORELOAD(&htim1));
  Motor_SetDirection(&m_right, RIGHT_DIR_POLARITY);  // forward (adjust if wiring requires inversion)
  Motor_SetDuty(&m_right, 0.0f);    // keep off initially

  // Start PWM at 0% to bias driver, then calibrate zero
  Motor_Start(&m_left);
  Motor_Start(&m_right);
  HAL_Delay(50);  // allow rails/driver to settle at 0% duty
  CurrentSense_Init(&current_sense, &hadc1);
  CurrentSense_Calibrate(&current_sense);
  ControlState_Init(&ctrl_state);
  Sensing_Init(&sensing, &enc_left, &enc_right, &current_sense, RPM_LPF_ALPHA);
  FaultMonitor_Init(&fault_mon);
  ControlLoop_Init(&control_loop);

  // Initialize and start encoders (Left: TIM3 16-bit, Right: TIM2 32-bit)
  Encoder_Init(&enc_left,  &htim3, ENCODER_COUNTS_PER_REV,
               __HAL_TIM_GET_AUTORELOAD(&htim3), LEFT_ENCODER_POLARITY);
  Encoder_Init(&enc_right, &htim2, ENCODER_COUNTS_PER_REV,
               __HAL_TIM_GET_AUTORELOAD(&htim2), RIGHT_ENCODER_POLARITY);
  Encoder_Start(&enc_left);
  Encoder_Start(&enc_right);
  HAL_TIM_Base_Start_IT(&htim4);
  last_header_tick = HAL_GetTick();
  /* USER CODE END 2 */

  /* Init scheduler */
  osKernelInitialize();

  /* USER CODE BEGIN RTOS_MUTEX */
  /* add mutexes, ... */
  /* USER CODE END RTOS_MUTEX */

  /* USER CODE BEGIN RTOS_SEMAPHORES */
  /* add semaphores, ... */
  /* USER CODE END RTOS_SEMAPHORES */

  /* USER CODE BEGIN RTOS_TIMERS */
  /* start timers, add new ones, ... */
  /* USER CODE END RTOS_TIMERS */

  /* USER CODE BEGIN RTOS_QUEUES */
  /* add queues, ... */
  /* USER CODE END RTOS_QUEUES */

  /* Create the thread(s) */
  /* creation of control_task */
  control_taskHandle = osThreadNew(StartControlTask, NULL, &control_task_attributes);

#if SERIAL_TELEMETRY_ENABLE
  /* creation of telemetry_task */
  telemetry_taskHandle = osThreadNew(StartTelemetryTask, NULL, &telemetry_task_attributes);
#else
  /* creation of ros_pub_task */
  ros_pub_taskHandle = osThreadNew(StartRosPubTask, NULL, &ros_pub_task_attributes);
#endif

  /* USER CODE BEGIN RTOS_THREADS */
  /* add threads, ... */
  /* USER CODE END RTOS_THREADS */

  /* USER CODE BEGIN RTOS_EVENTS */
  /* add events, ... */
  /* USER CODE END RTOS_EVENTS */

  /* Start scheduler */
  osKernelStart();

  /* We should never get here as control is now taken by the scheduler */

  /* Infinite loop */
  /* USER CODE BEGIN WHILE */
  while (1)
  {
    /* USER CODE END WHILE */

    /* USER CODE BEGIN 3 */
    osDelay(1);
  }
  /* USER CODE END 3 */
}

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
/* USER CODE BEGIN 4 */

void HAL_TIM_PeriodElapsedCallback(TIM_HandleTypeDef *htim)
{
  if (htim->Instance == TIM4) {
    if (control_tick_flag) {
      control_tick_missed++;
    }
    control_tick_flag = 1;
    control_tick_count++;
  } else if (htim->Instance == TIM5) {
    HAL_IncTick();
  }
}

/* USER CODE END 4 */

/* USER CODE BEGIN Header_StartControlTask */
/**
  * @brief  Function implementing the control_task thread.
  * @param  argument: Not used
  * @retval None
  */
/* USER CODE END Header_StartControlTask */
void StartControlTask(void *argument)
{
  /* USER CODE BEGIN StartControlTask */
  /* Infinite loop */
  for(;;)
  {
    // Wait for 100 Hz control tick (TIM4 interrupt sets flag)
    if (!control_tick_flag) {
      osDelay(1);
      continue;
    }
    control_tick_flag = 0;
    uint32_t loop_start_ms = HAL_GetTick();
    control_loop_count++;
    uint32_t lag = control_tick_count - control_loop_count;
    control_tick_lag = lag;
    if (lag > control_tick_lag_max) {
      control_tick_lag_max = lag;
    }
    uint32_t now = HAL_GetTick();
    static uint32_t last_tick_ms = 0U;
    static uint32_t last_tick_cnt = 0U;
    if ((now - last_tick_ms) >= 1000U) {
      uint32_t dc = control_tick_count - last_tick_cnt;
      uint32_t dt = now - last_tick_ms;
      if (dt > 0U) {
        control_tick_hz = (1000.0f * (float)dc) / (float)dt;
      }
      last_tick_ms = now;
      last_tick_cnt = control_tick_count;
    }
    float dt_s = CONTROL_LOOP_DT_S;

    // Debounce hardware e-stop input.
    bool estop_active = false;
    {
      static bool estop_init = false;
      static bool estop_raw_prev = false;
      static uint32_t estop_change_ms = 0U;
      static bool estop_debounced = false;

      GPIO_PinState estop_pin = HAL_GPIO_ReadPin(ESTOP_GPIO_Port, ESTOP_Pin);
      bool estop_raw = ESTOP_ACTIVE_LOW ? (estop_pin == GPIO_PIN_RESET) : (estop_pin == GPIO_PIN_SET);

      if (!estop_init) {
        estop_init = true;
        estop_raw_prev = estop_raw;
        estop_change_ms = now;
        estop_debounced = estop_raw;
      } else if (estop_raw != estop_raw_prev) {
        estop_raw_prev = estop_raw;
        estop_change_ms = now;
      } else if ((uint32_t)(now - estop_change_ms) >= ESTOP_DEBOUNCE_MS) {
        estop_debounced = estop_raw;
      }

      estop_active = estop_debounced;
    }
    estop_active = estop_active || soft_estop_cmd;

    // Sense encoders/currents
    sense.rpm_l = sense.rpm_r = 0.0f;
    Sensing_Step(&sensing, dt_s, &sense);


    // Control loop (PI + ramp) gated by state
    bool enabled = ControlState_IsEnabled(&ctrl_state) && !estop_active && enable_cmd;
    float rpm_target_l = 0.0f;
    float rpm_target_r = 0.0f;
    float duty_cmd_l = 0.0f, duty_cmd_r = 0.0f;
#if MOTOR_OPEN_LOOP_TEST
    if (enabled) {
      duty_cmd_l = MOTOR_OPEN_LOOP_DUTY_LEFT;
      duty_cmd_r = MOTOR_OPEN_LOOP_DUTY_RIGHT;
    }
    dbg_v_cmd_mps = 0.0f;
    dbg_w_cmd_rps = 0.0f;
    dbg_v_l_mps = 0.0f;
    dbg_v_r_mps = 0.0f;
    dbg_rpm_target_l = 0.0f;
    dbg_rpm_target_r = 0.0f;
#else
    float v_cmd = 0.0f;
    float w_cmd = 0.0f;
    bool cmd_stopped = false;
#if PID_TUNING_ENABLE
    static uint32_t last_toggle_ms = 0U;
    static uint8_t test_high = 0U;
    const float rpm_low = PID_TUNING_RPM_MAX * PID_TUNING_LOW_FRAC;
    const float rpm_high = PID_TUNING_RPM_MAX * PID_TUNING_HIGH_FRAC;
    if (!enabled) {
      test_high = 0U;
      last_toggle_ms = now;
    } else if (last_toggle_ms == 0U) {
      last_toggle_ms = now;
    } else if ((now - last_toggle_ms) >= PID_TUNING_TOGGLE_MS) {
      test_high = !test_high;
      last_toggle_ms = now;
    }
    float rpm_cmd = test_high ? rpm_high : rpm_low;
    const float two_pi = 6.28318530718f;
    v_cmd = (rpm_cmd * two_pi * WHEEL_RADIUS_M) / 60.0f;
    w_cmd = 0.0f;
    cmd_stopped = !enabled;
#else
    uint32_t wheel_cmd_age = (last_wheel_cmd_ms > 0U) ? (now - last_wheel_cmd_ms) : (WHEEL_CMD_TIMEOUT_MS + 1U);
    bool wheel_cmd_active = (wheel_cmd_age <= WHEEL_CMD_TIMEOUT_MS);
    if (wheel_cmd_active) {
      float v_l = wheel_cmd_l_rad_s * WHEEL_RADIUS_M;
      float v_r = wheel_cmd_r_rad_s * WHEEL_RADIUS_M;
      v_cmd = 0.5f * (v_l + v_r);
      w_cmd = (v_r - v_l) / TRACK_WIDTH_M;
      cmd_stopped = (fabsf(v_cmd) < CMD_STOP_EPS_MPS && fabsf(w_cmd) < CMD_STOP_EPS_RPS) ||
                    !enabled;
    } else {
      v_cmd = 0.0f;
      w_cmd = 0.0f;
      cmd_stopped = true;
    }
#endif
    static bool cmd_stopped_prev = false;
    static uint32_t launch_start_ms = 0U;

#if LAUNCH_GUARD_ENABLE
    if (!cmd_stopped && cmd_stopped_prev) {
      launch_start_ms = now;
    }
    if (!cmd_stopped) {
      uint32_t launch_age_ms = now - launch_start_ms;
      if (launch_age_ms < LAUNCH_GUARD_MS) {
        float launch_scale = (float)launch_age_ms / (float)LAUNCH_GUARD_MS;
        if (launch_scale < LAUNCH_MIN_SCALE) {
          launch_scale = LAUNCH_MIN_SCALE;
        }

        if (fabsf(v_cmd) > LAUNCH_MAX_V_MPS) {
          v_cmd = (v_cmd >= 0.0f) ? LAUNCH_MAX_V_MPS : -LAUNCH_MAX_V_MPS;
        }
        if (fabsf(w_cmd) > LAUNCH_MAX_W_RPS) {
          w_cmd = (w_cmd >= 0.0f) ? LAUNCH_MAX_W_RPS : -LAUNCH_MAX_W_RPS;
        }

        v_cmd *= launch_scale;
        w_cmd *= launch_scale;
      }
    }
#endif

    if (cmd_stopped && !cmd_stopped_prev) {
      PID_Reset(&control_loop.pid_l, sense.rpm_l);
      PID_Reset(&control_loop.pid_r, sense.rpm_r);
    }
    cmd_stopped_prev = cmd_stopped;
    bool control_enabled = enabled && !cmd_stopped;
    ControlLoop_Update(&control_loop, sense.rpm_l, sense.rpm_r, control_enabled, v_cmd, w_cmd, dt_s, now, &duty_cmd_l, &duty_cmd_r, &rpm_target_l, &rpm_target_r);
    dbg_v_cmd_mps = v_cmd;
    dbg_w_cmd_rps = w_cmd;
    dbg_v_l_mps = control_loop.v_l_mps;
    dbg_v_r_mps = control_loop.v_r_mps;
    dbg_rpm_target_l = rpm_target_l;
    dbg_rpm_target_r = rpm_target_r;
#endif
    dbg_rpm_meas_l = sense.rpm_l;
    dbg_rpm_meas_r = sense.rpm_r;
    dbg_pid_p_l = control_loop.pid_l.last_p;
    dbg_pid_i_l = control_loop.pid_l.integrator;
    dbg_pid_d_l = control_loop.pid_l.last_d;
    dbg_pid_err_l = control_loop.pid_l.last_error;
    dbg_pid_out_l = control_loop.pid_l.last_out;
    dbg_pid_p_r = control_loop.pid_r.last_p;
    dbg_pid_i_r = control_loop.pid_r.integrator;
    dbg_pid_d_r = control_loop.pid_r.last_d;
    dbg_pid_err_r = control_loop.pid_r.last_error;
    dbg_pid_out_r = control_loop.pid_r.last_out;
    duty_cmd_l_pub = duty_cmd_l;
    duty_cmd_r_pub = duty_cmd_r;
    // Set direction pins based on commanded sign, then apply magnitude as duty
    uint8_t dir_l = (duty_cmd_l >= 0.0f) ? LEFT_DIR_POLARITY : (LEFT_DIR_POLARITY ? 0U : 1U);
    uint8_t dir_r = (duty_cmd_r >= 0.0f) ? RIGHT_DIR_POLARITY : (RIGHT_DIR_POLARITY ? 0U : 1U);
    dbg_dir_l = dir_l;
    dbg_dir_r = dir_r;
    Motor_SetDirection(&m_left, dir_l);
    Motor_SetDirection(&m_right, dir_r);
    Motor_SetDuty(&m_left, duty_cmd_l);
    Motor_SetDuty(&m_right, duty_cmd_r);
    dbg_duty_cmd_l = duty_cmd_l;
    dbg_duty_cmd_r = duty_cmd_r;

    // Compute commanded duty (percent) from timer compare
    float duty_l = 0.0f;
    float duty_r = 0.0f;
    uint32_t arr = __HAL_TIM_GET_AUTORELOAD(&htim1);
    if (arr > 0U) {
      duty_l = (__HAL_TIM_GET_COMPARE(&htim1, TIM_CHANNEL_1) * 100.0f) / (float)(arr + 1U);
      duty_r = (__HAL_TIM_GET_COMPARE(&htim1, TIM_CHANNEL_2) * 100.0f) / (float)(arr + 1U);
    }

    // Fault detection (overcurrent, stall, encoder timeout, ADC stuck)
    uint32_t fault_bits = FaultMonitor_Update(&fault_mon, &sense, rpm_target_l, rpm_target_r, duty_l, duty_r, CONTROL_LOOP_DT_MS);

    // Update control state (faults from detection above, debounced e-stop)
    bool clear_cmd = clear_fault_cmd;
    clear_fault_cmd = false;
    ControlInputs cin = {0};
    cin.enable_cmd = enable_cmd;
    cin.disable_cmd = !enable_cmd;
    cin.clear_cmd = clear_cmd;
    cin.estop = estop_active;
    cin.fault_bits = fault_bits;
    ControlState_Update(&ctrl_state, &cin, now);
    // enabled flag will be used on next tick

    // Legacy UART telemetry disabled to avoid contention with micro-ROS on USART2
    uint32_t loop_elapsed_ms = HAL_GetTick() - loop_start_ms;
    control_loop_last_ms = loop_elapsed_ms;
    if (loop_elapsed_ms > control_loop_max_ms) {
      control_loop_max_ms = loop_elapsed_ms;
    }
  }
  /* USER CODE END StartControlTask */
}

/* USER CODE BEGIN Header_StartRosPubTask */
/**
* @brief Function implementing the ros_pub_task thread.
* @param argument: Not used
* @retval None
*/
/* USER CODE END Header_StartRosPubTask */
void StartRosPubTask(void *argument)
{
  /* USER CODE BEGIN StartRosPubTask */
  // micro-ROS init and publishers (single-threaded to avoid rcl concurrency)
  StatusLed_BootSignature();

  rmw_uros_set_custom_transport(
      true,
      (void *)&huart2,
      cubemx_transport_open,
      cubemx_transport_close,
      cubemx_transport_write,
      cubemx_transport_read);

  ros_allocator = rcl_get_default_allocator();
  ros_allocator.allocate = microros_allocate;
  ros_allocator.deallocate = microros_deallocate;
  ros_allocator.reallocate = microros_reallocate;
  ros_allocator.zero_allocate = microros_zero_allocate;
  (void)rcutils_set_default_allocator(&ros_allocator);

  Ros_ResetEntityHandles();

ros_reconnect:
  Ros_StopForReconnect();
  Ros_DestroyEntities();
  osDelay(ROS_RECONNECT_DELAY_MS);

  ros_init_fail_stage = 1;
  while (rmw_uros_ping_agent(ROS_AGENT_PING_TIMEOUT_MS, ROS_AGENT_PING_ATTEMPTS) != RMW_RET_OK) {
    ros_agent_ping_failures++;
    StatusLed_Blink(ROS_INIT_FAIL_BLINK_ON_MS, ROS_AGENT_PING_RETRY_MS);
    osDelay(ROS_AGENT_PING_RETRY_MS);
  }

  if (rclc_support_init(&ros_support, 0, NULL, &ros_allocator) != RCL_RET_OK) {
    ros_init_fail_stage = 1;
    goto ros_init_fail;
  }

  if (rclc_node_init_default(&ros_node, "amr_firmware", "", &ros_support) != RCL_RET_OK) {
    ros_init_fail_stage = 2;
    goto ros_init_fail;
  }

  if (rclc_publisher_init_best_effort(
          &pub_fault_mask,
          &ros_node,
          ROSIDL_GET_MSG_TYPE_SUPPORT(std_msgs, msg, Int32),
          "/amr_stm/fault_mask") != RCL_RET_OK) {
    ros_init_fail_stage = 5;
    goto ros_init_fail;
  }

  if (rclc_publisher_init_best_effort(
          &pub_current_left,
          &ros_node,
          ROSIDL_GET_MSG_TYPE_SUPPORT(std_msgs, msg, Int32),
          "/amr_stm/current_left_ma") != RCL_RET_OK) {
    ros_init_fail_stage = 6;
    goto ros_init_fail;
  }

  if (rclc_publisher_init_best_effort(
          &pub_current_right,
          &ros_node,
          ROSIDL_GET_MSG_TYPE_SUPPORT(std_msgs, msg, Int32),
          "/amr_stm/current_right_ma") != RCL_RET_OK) {
    ros_init_fail_stage = 7;
    goto ros_init_fail;
  }

  if (rclc_publisher_init_best_effort(
          &pub_current_left_adc,
          &ros_node,
          ROSIDL_GET_MSG_TYPE_SUPPORT(std_msgs, msg, UInt32),
          "/amr_stm/current_left_adc") != RCL_RET_OK) {
    ros_init_fail_stage = 8;
    goto ros_init_fail;
  }

  if (rclc_publisher_init_best_effort(
          &pub_current_right_adc,
          &ros_node,
          ROSIDL_GET_MSG_TYPE_SUPPORT(std_msgs, msg, UInt32),
          "/amr_stm/current_right_adc") != RCL_RET_OK) {
    ros_init_fail_stage = 9;
    goto ros_init_fail;
  }

  if (rclc_publisher_init_best_effort(
          &pub_current_left_zero,
          &ros_node,
          ROSIDL_GET_MSG_TYPE_SUPPORT(std_msgs, msg, UInt32),
          "/amr_stm/current_left_zero") != RCL_RET_OK) {
    ros_init_fail_stage = 10;
    goto ros_init_fail;
  }

  if (rclc_publisher_init_best_effort(
          &pub_current_right_zero,
          &ros_node,
          ROSIDL_GET_MSG_TYPE_SUPPORT(std_msgs, msg, UInt32),
          "/amr_stm/current_right_zero") != RCL_RET_OK) {
    ros_init_fail_stage = 11;
    goto ros_init_fail;
  }

  if (rclc_publisher_init_best_effort(
          &pub_duty_left,
          &ros_node,
          ROSIDL_GET_MSG_TYPE_SUPPORT(std_msgs, msg, Float32),
          "/amr_stm/duty_cmd_left") != RCL_RET_OK) {
    ros_init_fail_stage = 12;
    goto ros_init_fail;
  }

  if (rclc_publisher_init_best_effort(
          &pub_duty_right,
          &ros_node,
          ROSIDL_GET_MSG_TYPE_SUPPORT(std_msgs, msg, Float32),
          "/amr_stm/duty_cmd_right") != RCL_RET_OK) {
    ros_init_fail_stage = 13;
    goto ros_init_fail;
  }

  if (rclc_publisher_init_best_effort(
          &pub_wheel_state,
          &ros_node,
          ROSIDL_GET_MSG_TYPE_SUPPORT(sensor_msgs, msg, JointState),
          "/amr_stm/wheel_state") != RCL_RET_OK) {
    ros_init_fail_stage = 14;
    goto ros_init_fail;
  }

  if (rclc_publisher_init_best_effort(
          &pub_safety_state,
          &ros_node,
          ROSIDL_GET_MSG_TYPE_SUPPORT(std_msgs, msg, UInt32),
          "/amr_stm/safety_state") != RCL_RET_OK) {
    ros_init_fail_stage = 15;
    goto ros_init_fail;
  }

  if (rclc_publisher_init_best_effort(
          &pub_ros_diag,
          &ros_node,
          ROSIDL_GET_MSG_TYPE_SUPPORT(std_msgs, msg, UInt32MultiArray),
          "/amr_stm/ros_diag") != RCL_RET_OK) {
    ros_init_fail_stage = 16;
    goto ros_init_fail;
  }

  if (!ros_wheel_state_msg_initialized) {
    if (!sensor_msgs__msg__JointState__init(&msg_wheel_state)) {
      ros_init_fail_stage = 17;
      goto ros_init_fail;
    }

    if (!rosidl_runtime_c__String__Sequence__init(&msg_wheel_state.name, 2)) {
      ros_init_fail_stage = 18;
      goto ros_init_fail;
    }

    if (!rosidl_runtime_c__double__Sequence__init(&msg_wheel_state.position, 2)) {
      ros_init_fail_stage = 19;
      goto ros_init_fail;
    }

    if (!rosidl_runtime_c__double__Sequence__init(&msg_wheel_state.velocity, 2)) {
      ros_init_fail_stage = 20;
      goto ros_init_fail;
    }

    if (!rosidl_runtime_c__String__assign(&msg_wheel_state.name.data[0], "left_wheel_joint") ||
        !rosidl_runtime_c__String__assign(&msg_wheel_state.name.data[1], "right_wheel_joint")) {
      ros_init_fail_stage = 21;
      goto ros_init_fail;
    }

    ros_wheel_state_msg_initialized = true;
  }

  if (!ros_diag_msg_initialized) {
    if (!std_msgs__msg__UInt32MultiArray__init(&msg_ros_diag)) {
      ros_init_fail_stage = 22;
      goto ros_init_fail;
    }
    msg_ros_diag.data.data = ros_diag_data;
    msg_ros_diag.data.size = sizeof(ros_diag_data) / sizeof(ros_diag_data[0]);
    msg_ros_diag.data.capacity = sizeof(ros_diag_data) / sizeof(ros_diag_data[0]);
    msg_ros_diag.layout.dim.data = NULL;
    msg_ros_diag.layout.dim.size = 0U;
    msg_ros_diag.layout.dim.capacity = 0U;
    msg_ros_diag.layout.data_offset = 0U;
    ros_diag_msg_initialized = true;
  }

  if (rclc_subscription_init_best_effort(
          &sub_wheel_cmd_left,
          &ros_node,
          ROSIDL_GET_MSG_TYPE_SUPPORT(std_msgs, msg, Float32),
          "/amr_stm/wheel_cmd_left") != RCL_RET_OK) {
    ros_init_fail_stage = 23;
    goto ros_init_fail;
  }

  if (rclc_subscription_init_best_effort(
          &sub_wheel_cmd_right,
          &ros_node,
          ROSIDL_GET_MSG_TYPE_SUPPORT(std_msgs, msg, Float32),
          "/amr_stm/wheel_cmd_right") != RCL_RET_OK) {
    ros_init_fail_stage = 24;
    goto ros_init_fail;
  }

  if (rclc_subscription_init_default(
          &sub_enable,
          &ros_node,
          ROSIDL_GET_MSG_TYPE_SUPPORT(std_msgs, msg, Bool),
          "/amr_stm/enable") != RCL_RET_OK) {
    ros_init_fail_stage = 25;
    goto ros_init_fail;
  }

  if (rclc_subscription_init_default(
          &sub_estop,
          &ros_node,
          ROSIDL_GET_MSG_TYPE_SUPPORT(std_msgs, msg, Bool),
          "/amr_stm/estop") != RCL_RET_OK) {
    ros_init_fail_stage = 26;
    goto ros_init_fail;
  }

  if (rclc_subscription_init_default(
          &sub_clear_fault,
          &ros_node,
          ROSIDL_GET_MSG_TYPE_SUPPORT(std_msgs, msg, Empty),
          "/amr_stm/clear_fault") != RCL_RET_OK) {
    ros_init_fail_stage = 27;
    goto ros_init_fail;
  }

  if (rclc_executor_init(&ros_executor, &ros_support.context, 5, &ros_allocator) != RCL_RET_OK) {
    ros_init_fail_stage = 28;
    goto ros_init_fail;
  }

  if (rclc_executor_add_subscription(&ros_executor, &sub_wheel_cmd_left, &msg_wheel_cmd_left, WheelCmdLeftCallback, ON_NEW_DATA) != RCL_RET_OK) {
    ros_init_fail_stage = 29;
    goto ros_init_fail;
  }

  if (rclc_executor_add_subscription(&ros_executor, &sub_wheel_cmd_right, &msg_wheel_cmd_right, WheelCmdRightCallback, ON_NEW_DATA) != RCL_RET_OK) {
    ros_init_fail_stage = 30;
    goto ros_init_fail;
  }

  if (rclc_executor_add_subscription(&ros_executor, &sub_enable, &msg_enable, EnableCallback, ON_NEW_DATA) != RCL_RET_OK) {
    ros_init_fail_stage = 31;
    goto ros_init_fail;
  }

  if (rclc_executor_add_subscription(&ros_executor, &sub_estop, &msg_estop, EstopCallback, ON_NEW_DATA) != RCL_RET_OK) {
    ros_init_fail_stage = 32;
    goto ros_init_fail;
  }

  if (rclc_executor_add_subscription(&ros_executor, &sub_clear_fault, &msg_clear_fault, ClearFaultCallback, ON_NEW_DATA) != RCL_RET_OK) {
    ros_init_fail_stage = 33;
    goto ros_init_fail;
  }

  ros_entities_created = true;
  ros_ready = true;

  /* Infinite loop */
  bool led_state = false;
  uint32_t last_critical_pub_ms = 0U;
  uint32_t last_diag_pub_ms = 0U;
  uint32_t consecutive_pub_failures = 0U;
  uint32_t pub_failure_total = 0U;
  uint32_t spin_failure_total = 0U;
  uint32_t critical_pub_failure_total = 0U;
  uint32_t diag_pub_failure_total = 0U;
  uint32_t ros_loop_last_ms = HAL_GetTick();
  uint32_t ros_loop_period_max_ms = 0U;
  uint32_t critical_pub_elapsed_max_ms = 0U;
  uint32_t diag_pub_elapsed_max_ms = 0U;
#if ROS_AGENT_RUNTIME_PING_ENABLE
  uint32_t runtime_ping_failures = 0U;
#endif
  uint32_t last_runtime_ping_ms = HAL_GetTick();
#if ROS_TRANSPORT_COUNTER_RECONNECT_ENABLE
  uint32_t last_write_failures = microros_transport_write_failures;
  uint32_t last_write_timeouts = microros_transport_write_timeouts;
#endif
  for(;;)
  {
    uint32_t loop_now = HAL_GetTick();
    uint32_t loop_period_ms = loop_now - ros_loop_last_ms;
    ros_loop_last_ms = loop_now;
    if (loop_period_ms > ros_loop_period_max_ms) {
      ros_loop_period_max_ms = loop_period_ms;
    }

    // Pump executor to receive command topics
    rcl_ret_t spin_rc = rclc_executor_spin_some(&ros_executor, 1000000ULL); // 1 ms
    if (spin_rc != RCL_RET_OK) {
      consecutive_pub_failures++;
      spin_failure_total++;
    }

    uint32_t now = HAL_GetTick();
    if ((now - last_runtime_ping_ms) >= ROS_AGENT_RUNTIME_PING_PERIOD_MS) {
      last_runtime_ping_ms = now;
#if ROS_TRANSPORT_COUNTER_RECONNECT_ENABLE
      if ((microros_transport_write_failures != last_write_failures) ||
          (microros_transport_write_timeouts != last_write_timeouts)) {
        goto ros_reconnect;
      }
      last_write_failures = microros_transport_write_failures;
      last_write_timeouts = microros_transport_write_timeouts;
#endif
#if ROS_AGENT_RUNTIME_PING_ENABLE
      if (rmw_uros_ping_agent(ROS_AGENT_PING_TIMEOUT_MS, ROS_AGENT_PING_ATTEMPTS) == RMW_RET_OK) {
        runtime_ping_failures = 0U;
      } else {
        runtime_ping_failures++;
        if (runtime_ping_failures >= ROS_AGENT_RUNTIME_PING_FAIL_LIMIT) {
          goto ros_reconnect;
        }
      }
#endif
    }

    if ((last_critical_pub_ms == 0U) || ((now - last_critical_pub_ms) >= ROS_CRITICAL_PUB_PERIOD_MS)) {
      last_critical_pub_ms = now;
      uint32_t pub_start_ms = HAL_GetTick();
      // Publish control-critical state separately from slower diagnostics so odom is responsive.
      uint32_t fault_mask = ControlState_GetFaultMask(&ctrl_state);
      // safety_state: upper 16 bits = ControlState, lower 16 bits = fault mask.
      uint32_t safety_state = ((uint32_t)ControlState_GetState(&ctrl_state) << 16) | (fault_mask & 0xFFFFu);
      const double two_pi = 6.28318530717958647692;
      const double rpm_to_rad_s = two_pi / 60.0;
      const double counts_to_rad = two_pi / (double)ENCODER_COUNTS_PER_REV;
      msg_fault_mask.data = (int32_t)fault_mask;
      msg_safety_state.data = safety_state;
      msg_duty_left.data = duty_cmd_l_pub;
      msg_duty_right.data = duty_cmd_r_pub;
      msg_wheel_state.header.stamp.sec = (int32_t)(now / 1000U);
      msg_wheel_state.header.stamp.nanosec = (uint32_t)((now % 1000U) * 1000000U);
      // Use signed encoder position (includes polarity) for wheel_state
      msg_wheel_state.position.data[0] = (double)Encoder_GetPosition(&enc_left) * counts_to_rad;
      msg_wheel_state.position.data[1] = (double)Encoder_GetPosition(&enc_right) * counts_to_rad;
      msg_wheel_state.velocity.data[0] = (double)sense.rpm_l * rpm_to_rad_s;
      msg_wheel_state.velocity.data[1] = (double)sense.rpm_r * rpm_to_rad_s;

      rcl_ret_t rc1 = rcl_publish(&pub_fault_mask, &msg_fault_mask, NULL);
      rcl_ret_t rc2 = rcl_publish(&pub_duty_left, &msg_duty_left, NULL);
      rcl_ret_t rc3 = rcl_publish(&pub_duty_right, &msg_duty_right, NULL);
      rcl_ret_t rc4 = rcl_publish(&pub_wheel_state, &msg_wheel_state, NULL);
      rcl_ret_t rc5 = rcl_publish(&pub_safety_state, &msg_safety_state, NULL);

      // Blink LED when publish succeeds; hold solid ON if any publish fails
      bool pub_ok = (rc1 == RCL_RET_OK) && (rc2 == RCL_RET_OK) &&
                    (rc3 == RCL_RET_OK) && (rc4 == RCL_RET_OK) &&
                    (rc5 == RCL_RET_OK);
      uint32_t pub_elapsed_ms = HAL_GetTick() - pub_start_ms;
      if (pub_elapsed_ms > critical_pub_elapsed_max_ms) {
        critical_pub_elapsed_max_ms = pub_elapsed_ms;
      }
      if (pub_ok) {
        consecutive_pub_failures = 0U;
        led_state = !led_state;
        StatusLed_Set(led_state ? GPIO_PIN_SET : GPIO_PIN_RESET);
      } else {
        consecutive_pub_failures++;
        pub_failure_total++;
        critical_pub_failure_total++;
        StatusLed_Set(GPIO_PIN_SET);
        if (consecutive_pub_failures >= ROS_PUBLISH_FAIL_RESET_COUNT) {
          osDelay(ROS_PUBLISH_FAIL_RESET_DELAY_MS);
          goto ros_reconnect;
        }
      }
    }

    if ((last_diag_pub_ms == 0U) || ((now - last_diag_pub_ms) >= ROS_DIAG_PUB_PERIOD_MS)) {
      last_diag_pub_ms = now;
      uint32_t pub_start_ms = HAL_GetTick();
      msg_current_left.data = sense.curr_l_mA;
      msg_current_right.data = sense.curr_r_mA;
      msg_current_left_adc.data = (uint32_t)sense.adc_l_counts;
      msg_current_right_adc.data = (uint32_t)sense.adc_r_counts;
      msg_current_left_zero.data = (uint32_t)sense.zero_l_counts;
      msg_current_right_zero.data = (uint32_t)sense.zero_r_counts;

      rcl_ret_t rc1 = rcl_publish(&pub_current_left, &msg_current_left, NULL);
      rcl_ret_t rc2 = rcl_publish(&pub_current_right, &msg_current_right, NULL);
      rcl_ret_t rc3 = rcl_publish(&pub_current_left_adc, &msg_current_left_adc, NULL);
      rcl_ret_t rc4 = rcl_publish(&pub_current_right_adc, &msg_current_right_adc, NULL);
      rcl_ret_t rc5 = rcl_publish(&pub_current_left_zero, &msg_current_left_zero, NULL);
      rcl_ret_t rc6 = rcl_publish(&pub_current_right_zero, &msg_current_right_zero, NULL);

      bool pub_ok = (rc1 == RCL_RET_OK) && (rc2 == RCL_RET_OK) &&
                    (rc3 == RCL_RET_OK) && (rc4 == RCL_RET_OK) &&
                    (rc5 == RCL_RET_OK) && (rc6 == RCL_RET_OK);
      uint32_t pub_elapsed_ms = HAL_GetTick() - pub_start_ms;
      if (pub_elapsed_ms > diag_pub_elapsed_max_ms) {
        diag_pub_elapsed_max_ms = pub_elapsed_ms;
      }
      if (pub_ok) {
        consecutive_pub_failures = 0U;
        led_state = !led_state;
        StatusLed_Set(led_state ? GPIO_PIN_SET : GPIO_PIN_RESET);
      } else {
        consecutive_pub_failures++;
        pub_failure_total++;
        diag_pub_failure_total++;
        StatusLed_Set(GPIO_PIN_SET);
        if (consecutive_pub_failures >= ROS_PUBLISH_FAIL_RESET_COUNT) {
          osDelay(ROS_PUBLISH_FAIL_RESET_DELAY_MS);
          goto ros_reconnect;
        }
      }

      ros_diag_data[0] = now;
      ros_diag_data[1] = ros_loop_period_max_ms;
      ros_diag_data[2] = critical_pub_elapsed_max_ms;
      ros_diag_data[3] = diag_pub_elapsed_max_ms;
      ros_diag_data[4] = spin_failure_total;
      ros_diag_data[5] = pub_failure_total;
      ros_diag_data[6] = critical_pub_failure_total;
      ros_diag_data[7] = diag_pub_failure_total;
      ros_diag_data[8] = microros_transport_write_calls;
      ros_diag_data[9] = microros_transport_write_failures;
      ros_diag_data[10] = microros_transport_write_timeouts;
      ros_diag_data[11] = microros_transport_last_write_status;
      ros_diag_data[12] = microros_transport_read_calls;
      ros_diag_data[13] = microros_transport_read_nonzero_calls;
      ros_diag_data[14] = microros_transport_read_success_bytes;
      ros_diag_data[15] = control_loop_max_ms;
      ros_diag_data[16] = control_tick_lag_max;
      ros_diag_data[17] = consecutive_pub_failures;
      ros_diag_data[18] = boot_reset_cause;
      ros_diag_data[19] = boot_reset_csr;
      (void)rcl_publish(&pub_ros_diag, &msg_ros_diag, NULL);
      ros_loop_period_max_ms = 0U;
      critical_pub_elapsed_max_ms = 0U;
      diag_pub_elapsed_max_ms = 0U;
    }

    osDelay(ROS_EXEC_DELAY_MS);
  }

ros_init_fail:
  ros_ready = false;
  StatusLed_BlinkCount(
      (uint32_t)ros_init_fail_stage,
      ROS_INIT_FAIL_BLINK_ON_MS,
      ROS_INIT_FAIL_BLINK_OFF_MS,
      ROS_INIT_FAIL_GAP_MS);

  if (ros_init_fail_stage == 1) {
    uint32_t transport_diag = 4U;
    if (microros_transport_open_failures > 0U ||
        microros_transport_last_open_status != (uint32_t)HAL_OK) {
      transport_diag = 1U;
    } else if (microros_transport_write_timeouts > 0U ||
               microros_transport_write_failures > 0U ||
               microros_transport_last_write_status != (uint32_t)HAL_OK) {
      transport_diag = 2U;
    } else if (microros_transport_read_success_bytes == 0U) {
      transport_diag = 3U;
    }

    StatusLed_BlinkCount(
        transport_diag,
        ROS_INIT_FAIL_BLINK_ON_MS,
        ROS_INIT_FAIL_BLINK_OFF_MS,
        ROS_INIT_FAIL_GAP_MS);
  }

  Ros_DestroyEntities();
  goto ros_reconnect;
  /* USER CODE END StartRosPubTask */
}

#if SERIAL_TELEMETRY_ENABLE
/* USER CODE BEGIN Header_StartTelemetryTask */
/**
* @brief Function implementing the telemetry_task thread.
* @param argument: Not used
* @retval None
*/
/* USER CODE END Header_StartTelemetryTask */
void StartTelemetryTask(void *argument)
{
  /* USER CODE BEGIN StartTelemetryTask */
  Telemetry_SendHeader(&huart2);
  uint32_t last_header_ms = HAL_GetTick();
  for(;;)
  {
    uint32_t now = HAL_GetTick();
    if ((now - last_header_ms) >= SERIAL_TELEMETRY_HEADER_PERIOD_MS) {
      Telemetry_SendHeader(&huart2);
      last_header_ms = now;
    }

    TelemetryFrame f = {0};
    f.t_ms = now;
    f.cnt_l = sense.cnt_l;
    f.cnt_r = sense.cnt_r;
    f.rpm_l_x10 = (int32_t)(sense.rpm_l * 10.0f);
    f.rpm_r_x10 = (int32_t)(sense.rpm_r * 10.0f);
    f.rpm_l_tgt_x10 = (int32_t)(dbg_rpm_target_l * 10.0f);
    f.rpm_r_tgt_x10 = (int32_t)(dbg_rpm_target_r * 10.0f);
    f.duty_l_pct = (int32_t)(duty_cmd_l_pub * 100.0f);
    f.duty_r_pct = (int32_t)(duty_cmd_r_pub * 100.0f);
    f.pid_p_l_pct = (int32_t)(dbg_pid_p_l * 100.0f);
    f.pid_p_r_pct = (int32_t)(dbg_pid_p_r * 100.0f);
    f.pid_i_l_pct = (int32_t)(dbg_pid_i_l * 100.0f);
    f.pid_i_r_pct = (int32_t)(dbg_pid_i_r * 100.0f);
    f.pid_d_l_pct = (int32_t)(dbg_pid_d_l * 100.0f);
    f.pid_d_r_pct = (int32_t)(dbg_pid_d_r * 100.0f);
    f.pid_err_l_x10 = (int32_t)(dbg_pid_err_l * 10.0f);
    f.pid_err_r_x10 = (int32_t)(dbg_pid_err_r * 10.0f);
    f.adc_l_counts = sense.adc_l_counts;
    f.adc_r_counts = sense.adc_r_counts;
    f.zero_l_counts = sense.zero_l_counts;
    f.zero_r_counts = sense.zero_r_counts;
    f.curr_l_mA = sense.curr_l_mA;
    f.curr_r_mA = sense.curr_r_mA;
    f.state = (uint32_t)ControlState_GetState(&ctrl_state);
    f.fault_mask = ControlState_GetFaultMask(&ctrl_state);
    Telemetry_SendFrame(&huart2, &f);

    osDelay(SERIAL_TELEMETRY_PERIOD_MS);
  }
  /* USER CODE END StartTelemetryTask */
}
#endif

/**
  * @brief  This function is executed in case of error occurrence.
  * @retval None
  */
void Error_Handler(void)
{
  /* USER CODE BEGIN Error_Handler_Debug */
  /* User can add his own implementation to report the HAL error return state */
  __disable_irq();
  while (1)
  {
  }
  /* USER CODE END Error_Handler_Debug */
}
#ifdef USE_FULL_ASSERT
/**
  * @brief  Reports the name of the source file and the source line number
  *         where the assert_param error has occurred.
  * @param  file: pointer to the source file name
  * @param  line: assert_param error line source number
  * @retval None
  */
void assert_failed(uint8_t *file, uint32_t line)
{
  /* USER CODE BEGIN 6 */
  /* User can add his own implementation to report the file name and line number,
     ex: printf("Wrong parameters value: file %s on line %d\r\n", file, line) */
  /* USER CODE END 6 */
}
#endif /* USE_FULL_ASSERT */
