KartikMehta-1/AMR-development/STM/STM_Firmware_AMR_v2/Core/Inc/main.h

#define B1_Pin GPIO_PIN_13
#define B1_GPIO_Port GPIOC
#define CURR_R_SENSE_Pin GPIO_PIN_1
#define CURR_R_SENSE_GPIO_Port GPIOC
#define ENC_R_A_Pin GPIO_PIN_0
#define ENC_R_A_GPIO_Port GPIOA
#define ENC_R_B_Pin GPIO_PIN_1
#define ENC_R_B_GPIO_Port GPIOA
#define USART_TX_Pin GPIO_PIN_2
#define USART_TX_GPIO_Port GPIOA
#define USART_RX_Pin GPIO_PIN_3
#define USART_RX_GPIO_Port GPIOA
#define LED_STATUS_Pin GPIO_PIN_5
#define LED_STATUS_GPIO_Port GPIOA
#define ENC_L_A_Pin GPIO_PIN_6
#define ENC_L_A_GPIO_Port GPIOA
#define ENC_L_B_Pin GPIO_PIN_7
#define ENC_L_B_GPIO_Port GPIOA
#define CURR_L_SENSE_Pin GPIO_PIN_0
#define CURR_L_SENSE_GPIO_Port GPIOB
#define PWM_LEFT_Pin GPIO_PIN_8
#define PWM_LEFT_GPIO_Port GPIOA
#define PWM_RIGHT_Pin GPIO_PIN_9
#define PWM_RIGHT_GPIO_Port GPIOA
#define TMS_Pin GPIO_PIN_13
#define TMS_GPIO_Port GPIOA
#define TCK_Pin GPIO_PIN_14
#define TCK_GPIO_Port GPIOA
#define SWO_Pin GPIO_PIN_3
#define SWO_GPIO_Port GPIOB
#define DIR_LEFT_Pin GPIO_PIN_4
#define DIR_LEFT_GPIO_Port GPIOB
#define DIR_RIGHT_Pin GPIO_PIN_5
#define DIR_RIGHT_GPIO_Port GPIOB
#define ESTOP_Pin GPIO_PIN_10
#define ESTOP_GPIO_Port GPIOB
