KartikMehta-1/AMR-development/ros_ws/src/amr_so101_moveit_config/config/joint_limits.yaml

joint_limits:
  so101_shoulder_pan:
    has_position_limits: true
    min_position: -1.91986
    max_position: 1.91986
    has_velocity_limits: true
    max_velocity: 1.0
    has_acceleration_limits: true
    max_acceleration: 2.0
  so101_shoulder_lift:
    has_position_limits: true
    min_position: -1.74533
    max_position: 1.74533
    has_velocity_limits: true
    max_velocity: 1.0
    has_acceleration_limits: true
    max_acceleration: 2.0
  so101_elbow_flex:
    has_position_limits: true
    min_position: -1.69
    max_position: 1.69
    has_velocity_limits: true
    max_velocity: 1.0
    has_acceleration_limits: true
    max_acceleration: 2.0
  so101_wrist_flex:
    has_position_limits: true
    min_position: -1.65806
    max_position: 1.65806
    has_velocity_limits: true
    max_velocity: 1.0
    has_acceleration_limits: true
    max_acceleration: 2.0
  so101_wrist_roll:
    has_position_limits: true
    min_position: -2.74385
    max_position: 2.84121
    has_velocity_limits: true
    max_velocity: 1.0
    has_acceleration_limits: true
    max_acceleration: 2.0
  so101_gripper:
    has_position_limits: true
    min_position: -0.174533
    max_position: 1.74533
    has_velocity_limits: true
    max_velocity: 1.0
    has_acceleration_limits: true
    max_acceleration: 2.0
