KartikMehta-1/AMR-development/STM/STM_Firmware_AMR_v2/Core/Inc/control_loop.h

// Speed PI + ramp helper with test setpoint toggle
#ifndef CONTROL_LOOP_H
#define CONTROL_LOOP_H

#include <stdint.h>
#include <stdbool.h>
#include "ramp.h"
#include "pid.h"

typedef struct {
  Ramp ramp_l;
  Ramp ramp_r;
  Ramp ramp_v;
  Ramp ramp_w;
  PID  pid_l;
  PID  pid_r;
  float rpm_target_l;
  float rpm_target_r;
  float cmd_v_mps;
  float cmd_w_rps;
  float v_l_mps;
  float v_r_mps;
} ControlLoop;

void ControlLoop_Init(ControlLoop *cl);
void ControlLoop_Update(ControlLoop *cl,
                        float rpm_l, float rpm_r,
                        bool enabled,
                        float v_cmd_mps,
                        float w_cmd_rps,
                        float dt_s,
                        uint32_t now_ms,
                        float *duty_cmd_l,
                        float *duty_cmd_r,
                        float *rpm_target_l_out,
                        float *rpm_target_r_out);

#endif // CONTROL_LOOP_H
