KartikMehta-1/AMR-development/(commit log)

2025-10-18 Updated STM firmware to drive a DC motor, read encoder and use UART to calculate and send RPM & encoder position
2025-10-22 Updated STM code with error on 64bit encoder reading. Added a python plot to visualize rpm, position.
    [main.c, rpm_position_display.py]
2025-10-23 Updated to a modular code structure with PID control for the motor.
2025-10-25 Added tests to help to fine tune the PID control of motor
2025-10-28 docs: add wiring schematic + pin map; update tracker (skip ADC, prioritize E-stop, drivetrain migration); confirm post-gearbox encoder (2400 cpr)
    [pin_map.yaml]
2025-10-28 plan: extend weeks 14–24; add proximity sensors, micro-ROS, ROS2 architecture, URDF/Gazebo, Docker; update task board and status
2025-10-30 Created a new project for firmware v2 with new motor, encoder and driver, and added current sensors.
2025-10-30 Updated ADC periferal declaration
2025-11-01 New motor drive (constant duty)
2025-11-03 Updated tasks for a cascaded PID based control.
2025-11-03 Updated specifications of few components (Lidar, intel depth sense, jetson nano)
2025-11-03 Ran the left motor with 10% duty cycle
2025-11-03 Ran both left and right motors with 10% duty cycle
2025-11-04 Implemented encoder for the motor.
2025-11-16 Updated collaterals with batterypack and charger
2025-11-16 Updated schematics
2025-11-16 Updated direction of motor
2025-11-16 Working both encoders and motors with UART messages
2025-11-17 Updated schematic with current sensor wiring and tracker
2025-11-17 Updated firmware with current sensor reading and UART display
2025-11-17 Updating current sensor read failure
    [main.c, pin_map.yaml]
2025-11-23 Cleared redundant CAD
    [AMR.0007.iam, AMR.iam, AMR_Base.0002.ipt, AMR_Base.ipt, Arduino_Nano.SLDPRT, Arduino_Nano.STEP, Assembly H brug.stp, BOM.xlsx]
2025-11-23 Uploaded the mechanical design on git.
    [050375033 v3.ipt, 1653192640.iam, 1653192640_1.iam, 1653192640_2.iam, 1653192640_3.iam, 1653192640_4.iam, 1653192640_5.iam, 1653192640_6.iam]
2025-11-25 Updated the firmware to read and plot current values.
    [AMR_assembly.0003.iam, AMR_assembly.iam]
2025-11-30 Added depthcam and Buck convertor in CAD
    [AMR_assembly.0006.iam, AMR_assembly.iam, Assem1.SLDASM, Assem1.ipt, Battery.ipt, Blocco D455.SLDPRT, Cover Telecamera.SLDPRT, INTEL REALSENSE DEPTH CAMERA D.ipt]
2025-12-02 Updated CAD and created a PCB project file.
    [AMR_assembly.0006.iam, AMR_assembly.0007.iam, AMR_assembly.iam, AMR_pcb.kicad_pcb, AMR_pcb.kicad_sch, Blocco D455.3mf, Blocco D455.ipt, Blocco D455.stp]
2025-12-02 updated docs with volt meter display
    [AMR_pcb.kicad_sch]
2025-12-04 Implemented current sensing using adc
    [AMR_assembly.0007.iam, AMR_assembly.0008.iam, AMR_assembly.iam, LM2596 DC-DC StepDown Converter v1.ipt, LM2596 DC-DC StepDown Converter v1.step]
2025-12-07 Added a basic PID and ramp function
2025-12-08 removed errors during build
    [main.c]
2025-12-08 Moved to fixed-rate control tick (instead of HAL_GetTick
    [app_config.h, main.c]
2025-12-09 Updated differential drive with ramp and saturation coordination of both motors
2025-12-11 added a shutdown switch in component list
2025-12-11 Updated CAD model with enclosure
    [5mm DPDT Mini Toggle Switch.FCStd, 5mm DPDT Mini Toggle Switch.step, 6mm DPDT Mini Toggle Switch.FCStd, 6mm DPDT Mini Toggle Switch.step, 6mm SPDT Mini Toggle Switch.FCStd, 6mm SPDT Mini Toggle Switch.ipt, 6mm SPDT Mini Toggle Switch.step, AB6-V.SLDPRT]
2025-12-19 CAD updates
    [AB6-V.ipt, AMR_assembly.0021.iam, AMR_assembly.0024.iam, AMR_assembly.iam, Emergency stop switch.ipt, Emergency stop switch.stp, Enclosure_1.0003.ipt, Enclosure_1.0006.ipt]
2025-12-21 CAD minor changes
    [Enclosure_1.0006.ipt, Enclosure_1.0008.ipt, Enclosure_1.ipt, Enclosure_6.0009.ipt, Enclosure_6.0012.ipt, Enclosure_6.ipt, PCB enclosure_v2.0019.iam, PCB enclosure_v2.0021.iam]
2025-12-21 micro-ros settings into ST board
2025-12-27 Motor run check basic firmware
2025-12-28 Made many updates to firmware for PID control using ROS
2025-12-29 Working motor control using microROS
2026-01-01 Added E-stop & reset button functionality
2026-01-04 Created dockerfile FOXY and got micro-ros and lidar working with the image.
2026-01-06 Added IMU to the project
2026-01-13 Dockerfile for jetson nano with successful build on jetson
2026-01-18 Updated tracker and dockerfile for a working Jetson nano based AMR with teleop and lidar
2026-01-24 Basic functional urdf file
    [amr.urdf.xacro]
2026-01-24 Updated STM firmware to accept wheel commands instead of cmd_vel command.
2026-01-26 Updated to basic gazebo simulation which responds to teleop
    [amr.urdf.xacro, base.xacro, casters.xacro, params.xacro, ros2_control.xacro, ros2_control.yaml, sensors.xacro, wheels.xacro]
2026-01-26 Tuning PI of AMR, and updated gazebo model
    [base.xacro, casters.xacro, params.xacro, ros2_control.yaml, wheels.xacro]
2026-01-29 Updated URDF + Gazebo model. Added ros2 control and updated dockerfile
    [amr.urdf.xacro, base.xacro, camera.xacro, lidar.xacro, params.xacro, ros2_control.xacro, ros2_control.yaml, wheels.xacro]
2026-01-31 SUccessfully built docker for jetson with ros2 control
    [ros2_control.yaml]
2026-02-08 Updated the slam toolbox. motor control will require more finetuning.
    [lidar.xacro, params.xacro, ros2_control.yaml]
2026-04-11 updated PCB enclosure
    [AMR_assembly.0027.iam, AMR_assembly.0031.iam, AMR_assembly.iam, Enclosure cover.0004.ipt, Enclosure cover.ipt, Enclosure cover.stp, Enclosure_Plate.0024.ipt, Enclosure_Plate.dwg]
2026-04-22 updated current sensing into the firmware.
2026-04-22 Motor control tuning.
2026-04-23 Updated monitor and created a one shot SLAM launcher. (rviz, slam toolbox, teleop)
    [ros2_control.yaml]
2026-04-28 Resolving STM jetson handshake issue
    [dma_transport.c, main.c]
2026-05-02 Fix STM micro-ROS transport reconnect
    [custom_memory_manager.c, dma_transport.c, main.c]
2026-05-02 Stabilize STM hardware teleop fallback
    [ros2_control.xacro]
2026-05-03 Add STM link diagnostics and reset cause reporting
    [main.c]
2026-05-03 Guard hardware commands on stale STM wheel state
    [ros2_control.xacro]
2026-05-03 Add AMR safety baseline probe
2026-05-03 Document real motor power safety fault
2026-05-09 Add agentic robotics framework
2026-05-09 Add AMR agent harness baseline
    [runtime_environment_no_hardware_start.yaml]
2026-05-09 Document Docker-first ROS runtime policy
    Document Foxy Docker as the authoritative current AMR runtime validation path and reserve Humble for explicit Orin migration profiles.
2026-05-10 Add agent-owned architecture map
    Add numbered architecture entry points owned by AMR agents while preserving existing detailed diagrams as source material.
2026-05-10 Document STM sensor and battery monitor wiring
2026-05-10 Add guarded AMR mission MCP bringup flow
2026-05-30 Track ROS map artifacts
2026-06-02 Add SO-101 AMR RViz description
    [amr.urdf.xacro, base_motor_holder_so101_v1.stl, base_so101_v2.stl, casters.xacro, motor_holder_so101_base_v1.stl, motor_holder_so101_wrist_v1.stl, moving_jaw_so101_v1.stl, params.xacro]
2026-06-04 Add Orin SO-101 MoveIt and wrist camera bringup
    [joint_limits.yaml]
2026-07-06 Record Orin SO-101 bringup checkpoint
    [camera.xacro, params.xacro]
