KartikMehta-1/AMR-development/(notices)

Notices in the files:
STM/STM_Firmware_AMR_v2/Core/Inc/main.h:
Copyright (c) 2025 STMicroelectronics.
All rights reserved.
This software is licensed under terms that can be found in the LICENSE file
